2AMLogic/gf180-sram/README.md

# gf180-sram

An SRAM macro on the [gf180mcu](https://github.com/google/gf180mcu-pdk) open
PDK, built and verified by AI agents driving
[klayout-tools](https://github.com/2AMLogic/klayout-tools).

**Bronze (T1, simulation-validated) granted 2026-10-02** (operator ruling,
issue #126; record: [`spec/t1-grant-2026-10-02.md`](spec/t1-grant-2026-10-02.md)).
Basis: the 2026-08-22 10/10 hand read with every hole it disclosed since
closed (#103, #108, #109, #110), plus the passing item-11 power-delivery ERC
(#124). **Disclosed exception:** item 7's read/hold-SNM post-layout (PEX)
gap (`sim/pex/README.md`). The machine grader now reads 11/11, tier T1 (`signoff/`; issue #159
closed the item-11 tooling gap with `ties[]` and a compound ERC + LVS
citation under the released klt 0.6.0; items 1, 9 and 10 cite artifact-anchored
generic wrappers since the 0.8.0 re-grade, issue #277). Item 2 remains a
placeholder citation.

**Status: spec ratified; bitcell and 256 x 32 array are DRC-clean and
LVS-clean (`status: match` for both — see `layout/README.md`'s "Status
(2026-08-16)" section), and 27-corner PVT signoff has passed (read SNM +
hold SNM + write margin, all 27 corner points — see
`sim/signoff-summary.md`'s Overall signoff line). A generated LEF abstract
of the array core now exists (`views/sram_256x32_array.lef`, `klt
socket-check` clean on outline + all 322 pins) — see `views/README.md` for
its coverage and the two tool/design gaps it surfaced. Liberty timing views
have not been generated yet. The block's T1 checklist state is graded
mechanically — the `klt signoff` block manifest at
[`signoff/block-manifest.json`](signoff/block-manifest.json) is the verdict
of record, re-graded on every PR (see
[`signoff/README.md`](signoff/README.md)); the 2026-08-22 hand-read in
`spec/` is retained as a dated audit snapshot only.**

**Built agent-native.** Every specification, decision record, testbench, and
line of documentation here is produced by AI agents working from a ratified
spec and an append-only evidence trail — not human-authored work that agents
merely assisted with. Verification is the product: every claim traces to a
recorded result. Where the agents hit friction with the open-source tooling —
most often [klayout-tools](https://github.com/2AMLogic/klayout-tools) — that
friction is filed as a public issue against the tool itself, so the fix
benefits everyone using gf180mcu, not just this repo.

## Why this block, stated honestly

This is the first **memory macro** in the program. Every sibling canary is a
flat analog or digital block, so array generation, macro-level LVS, abstract
and Liberty view generation, and the bitcell-to-array hierarchy are all tool
surface that has never been exercised here.

That is the reason it exists, and it is worth being plain that this block is
**not** selected for demand. [OpenRAM](https://openram.org) already generates
free SRAM macros for sky130, and gf180mcu itself ships a free, foundry-
hardened SRAM macro (`gf180mcu_fd_ip_sram`) outside of OpenRAM — see
[`spec/bitcell-decision.md`](spec/bitcell-decision.md) for the evidence.
OpenRAM does not currently generate gf180mcu SRAM macros (its gf180mcu
support is experimental ROM generation only). This repo is not trying to
out-compete either of those; it is trying to find out what breaks when the
tools are pointed at a memory array, and to fix it.

Where OpenRAM's output is a useful reference or a useful comparison, use it
and say so. Do not reimplement it.

## Target specification

The target spec is ratified: [`spec/sram.md`](spec/sram.md). It fixes
organization (1 kB, 256 × 32, single instance — a parameterized generator is
a stretch goal), ports (1RW target, 1RW1R stretch), deliverables (GDS, LEF
abstract, Liberty timing — all generated by this repo's own flow), and what
"functional across PVT" means for this macro (read/write/hold margins,
recorded per corner, over a 27-corner process × temperature × voltage set).
The bitcell question behind it is resolved separately in
[`spec/bitcell-decision.md`](spec/bitcell-decision.md): gf180mcu's 6T
bitcell (`018SRAM_cell1`) exists only embedded inside four fixed-depth
foundry-hardened `gf180mcu_fd_ip_sram` macros, not as a standalone, tileable
primitive, so this repo draws a custom bitcell and array rather than
integrating that hardened macro.

Maturity ladder: bitcell question answered → spec ratified → bitcell
characterized → array assembled → DRC/LVS-clean → abstract and Liberty views
generated and checked → shuttle seat → measured silicon. **Current position:
spec ratified; bitcell characterized (27-corner PVT testbenches recorded
read SNM / hold SNM / write margin / access-time results across all 27
corners, with the per-corner pass/fail synthesis against `spec/sram.md`'s
positive-margin signoff requirement complete — overall verdict PASS, see
`sim/signoff-summary.md`); array assembled and DRC/LVS-clean (256 x 32
array, `status: match` LVS, see `layout/README.md`'s "Status (2026-08-16)"
section); LEF abstract generated for the array core (`views/README.md`'s
"Status (2026-09-09)" section — `klt socket-check` clean, a real `.lef`
committed, and two tool/design gaps filed from pointing `klt lef-abstract`
at a real block for the first time). Liberty timing views have not been
generated yet; shuttle seat and measured silicon remain future steps.**

## Macro ceiling, and where this block sits relative to it

gf180mcu's open PDK ships exactly **four** hardened SRAM macros
(`gf180mcu_fd_ip_sram`, see `spec/bitcell-decision.md`), all fixed-depth,
×8-bit only: `64×8`, `128×8`, `256×8`, and `512×8`. The largest single
instance is **`512×8` = 4,096 bits = 512 bytes = 0.5 KB** — that is the PDK's
own macro ceiling, measured directly from its shipped `LEF` (`SIZE` field),
not estimated.

**This repo is not a wrapper or tiler over those four macros, and it is not
a KB-scale replacement for them.** Per `spec/bitcell-decision.md` this repo
draws a **new, custom 6T bitcell and array** from scratch, and its ratified
target (`spec/sram.md`) is a single fixed 256 × 32 (1 kB) instance — built to
exercise array generation, macro-level LVS, and abstract/Liberty
*generation* tooling, not to serve as a general-purpose KB-scale IP product.
A parameterized generator that could grow past 1 kB is only a stretch goal,
not built yet.

An integrator who needs more than ~1 kB (an 8–32 KB MCU-class want, say) has
no path from this repo today. [`spec/kb-scale-integration.md`](spec/kb-scale-integration.md)
records the options that do exist in the wider gf180mcu ecosystem — tiling
the foundry `512×8` macros, DFFRAM (standard-cell RAM, gf180mcu target
configured but not yet signoff-clean), and OpenRAM (no gf180mcu SRAM support
at all) — with measured/derived area and timing figures, evidence tiers
labelled, and the bank-select/mux cost flagged as not yet modeled. It also
notes, in one sentence, that the open kit has no dense NVM macro (an
`efuse_cell` primitive only) — code storage for an MCU-class chip on this
kit is an architecture decision, not a part the PDK provides.

## Spec at a glance

The ratified source is [`spec/sram.md`](spec/sram.md); this table only
summarizes it.

| Item | Target |
|---|---|
| Organization | 1 kB, 256 words × 32 bits, single fixed instance (a parameterized generator is a stretch goal) |
| Ports | 1RW synchronous single port (1RW1R is a stretch goal); pin interface in `spec/macro-interface-decision.md` |
| Deliverables | GDS, LEF abstract, Liberty timing |
| Corner set | 27 corners: process `ff`/`tt`/`ss` × temperature -40/25/125 °C × supply 2.97/3.30/3.63 V |
| Measured per corner | read SNM, hold SNM, write margin, read/write access time |
| Signoff | DRC and LVS clean on the full array, and a recorded, strictly positive read SNM, hold SNM and write margin at all 27 corners |

## Reproducing every result

Each result class has one documented entry point. Prerequisites (ngspice, the
pinned PDK revision, a released `klt`) are stated in the linked section.

| Result | How to reproduce | Documented in |
|---|---|---|
| Schematics and netlists | `design/generate_array.py`, then `xschem` batch netlisting | [`design/README.md`](design/README.md) § "Regenerating the netlists" |
| PVT corner simulations | `sim/lib/run_corner_sweep.sh` per testbench | [`sim/README.md`](sim/README.md) § "Cold-start invocation" |
| Monte Carlo / yield | `sim/lib/run_mc_campaign.py` | [`sim/README.md`](sim/README.md) § "Running a campaign" |
| Layout, DRC, LVS, extraction | `./layout/verify.sh` (`--quick` for a subset) | [`layout/README.md`](layout/README.md) § "Reproducing and re-checking" |
| LEF abstract | `./views/verify.sh` | [`views/README.md`](views/README.md) § "Reproducing and re-checking" |
| Characterization report | `python3 measurements/generate_report.py > measurements/characterization-report.md` | [`measurements/README.md`](measurements/README.md) |
| Signoff tier verdict | `./signoff/regenerate.sh` | [`signoff/README.md`](signoff/README.md) |

## Repo layout

```
spec/          ratified spec + decision records
design/        bitcell and periphery schematics
sim/           testbenches + PVT corner results (ngspice)
layout/        GDS + DRC/LVS reports (klayout-tools driven)
views/         generated LEF / Liberty abstracts
measurements/  aggregated characterization report (schematic-level today;
               silicon measurements supersede it after tape-out)
signoff/       block manifest + committed `klt signoff` tier report — the
               graded gap-to-T1 verdict of record, with the vendored
               checklist definition and its pinning/regeneration docs
```

## License

Apache License 2.0 — see [LICENSE](LICENSE).
