2AMLogic/gf180-sram/sim/signoff-summary.md

# PVT signoff summary (derived, per-corner pass/fail)

Auto-generated by `sim/lib/render_signoff_table.py` -- do not hand-edit. Regenerate with:

```bash
python3 sim/lib/render_signoff_table.py > sim/signoff-summary.md
```

This document derives an explicit **per-corner, per-metric PASS/FAIL verdict** from the five append-only evidence records already committed under `sim/*/records/` (see `sim/README.md` for the record format and the append-only convention). It does not run any simulation and does not modify those records -- it is a read-only rollup, closing the one gap the 2026-08-17 curation pass on issue #25 identified: the source records report raw measured values plus a single aggregate `Overall: recorded` line, not a per-corner verdict against `spec/sram.md`'s Signoff definition.

## Source records

- Read SNM: `sim/read-snm/records/20260817-011523-4448966.md`
- Hold SNM: `sim/hold-snm/records/20260817-011558-4448966.md`
- Write margin: `sim/write-margin/records/20260817-105029-ce56f59.md` (margin is `write_trip_voltage_v` (WTV) directly -- the minimum write-driver drive that still flips the cell)
- Read access time: `sim/access-time/records/20260817-011948-4448966.md`
- Write access time: `sim/access-time/records/20260817-012005-4448966.md`

## Verdict rule (`spec/sram.md`, "### Signoff definition")

- Read SNM, hold SNM, write margin: **PASS** iff the recorded value is strictly `> 0` V; **FAIL** otherwise; **OPEN** if the source record has no valid measurement for that corner (see `sim/README.md` "Append-only rule").
- Read/write access time: `spec/sram.md` only requires these be **recorded**, not compared against a numeric threshold, so a corner with a valid measured value is marked **RECORDED**, not PASS/FAIL.

**Note on corner count**: the table below has 27 rows, one per distinct `process x temperature x voltage` combination actually swept by `sim/lib/run_corner_sweep.sh` (`3 x 3 x 3 = 27`), matching every one of the five source records above (each has exactly this many `- **<corner-id>**:` rows) and `spec/sram.md`'s "Corner set" section. That section computed the same product as "9 corners" until #53 corrected the arithmetic (3 x 3 x 3 = 27, not 9) -- see `spec/corner-count-correction.md`; the corner set, the Signoff definition, and every verdict below are unchanged by that correction. Records written before it still say "9 corner points" in their own generated prose while listing all 27 rows, because records are never edited after the fact (`sim/README.md`, "Append-only rule").

## Per-corner results

| Corner | Read SNM (V) | Verdict | Hold SNM (V) | Verdict | Write margin (V) | Verdict | Read access time (s) | Verdict | Write access time (s) | Verdict | Row overall (SNM + margin) |
|---|---|---|---|---|---|---|---|---|---|---|---|
| ff_-40c_2.97v | 0.346745 | PASS | 0.999014 | PASS | 1.695460 | PASS | 1.4094e-10 | RECORDED | 4.7116e-11 | RECORDED | PASS |
| ff_-40c_3.30v | 0.348079 | PASS | 1.075028 | PASS | 1.891500 | PASS | 1.1791e-10 | RECORDED | 4.4605e-11 | RECORDED | PASS |
| ff_-40c_3.63v | 0.378868 | PASS | 1.150509 | PASS | 2.087960 | PASS | 1.0357e-10 | RECORDED | 4.2459e-11 | RECORDED | PASS |
| ff_25c_2.97v | 0.279259 | PASS | 0.972353 | PASS | 1.672980 | PASS | 1.4785e-10 | RECORDED | 5.0519e-11 | RECORDED | PASS |
| ff_25c_3.30v | 0.291040 | PASS | 1.048587 | PASS | 1.870750 | PASS | 1.2610e-10 | RECORDED | 4.7849e-11 | RECORDED | PASS |
| ff_25c_3.63v | 0.322552 | PASS | 1.124406 | PASS | 2.068910 | PASS | 1.1195e-10 | RECORDED | 4.5613e-11 | RECORDED | PASS |
| ff_125c_2.97v | 0.214599 | PASS | 0.930461 | PASS | 1.640530 | PASS | 1.5703e-10 | RECORDED | 5.7246e-11 | RECORDED | PASS |
| ff_125c_3.30v | 0.237829 | PASS | 1.008552 | PASS | 1.838120 | PASS | 1.3761e-10 | RECORDED | 5.3928e-11 | RECORDED | PASS |
| ff_125c_3.63v | 0.265005 | PASS | 1.087062 | PASS | 2.036110 | PASS | 1.2389e-10 | RECORDED | 5.1521e-11 | RECORDED | PASS |
| tt_-40c_2.97v | 0.443117 | PASS | 1.055088 | PASS | 1.738240 | PASS | 2.0899e-10 | RECORDED | 5.5771e-11 | RECORDED | PASS |
| tt_-40c_3.30v | 0.450044 | PASS | 1.134683 | PASS | 1.935810 | PASS | 1.6117e-10 | RECORDED | 5.2198e-11 | RECORDED | PASS |
| tt_-40c_3.63v | 0.458020 | PASS | 1.213568 | PASS | 2.132710 | PASS | 1.3429e-10 | RECORDED | 4.9423e-11 | RECORDED | PASS |
| tt_25c_2.97v | 0.377941 | PASS | 1.031028 | PASS | 1.711050 | PASS | 2.1229e-10 | RECORDED | 6.0738e-11 | RECORDED | PASS |
| tt_25c_3.30v | 0.381267 | PASS | 1.110807 | PASS | 1.910030 | PASS | 1.7014e-10 | RECORDED | 5.6764e-11 | RECORDED | PASS |
| tt_25c_3.63v | 0.385058 | PASS | 1.189934 | PASS | 2.109230 | PASS | 1.4485e-10 | RECORDED | 5.3568e-11 | RECORDED | PASS |
| tt_125c_2.97v | 0.295443 | PASS | 0.993408 | PASS | 1.677510 | PASS | 2.1819e-10 | RECORDED | 6.9354e-11 | RECORDED | PASS |
| tt_125c_3.30v | 0.296711 | PASS | 1.074566 | PASS | 1.877400 | PASS | 1.8293e-10 | RECORDED | 6.4782e-11 | RECORDED | PASS |
| tt_125c_3.63v | 0.318427 | PASS | 1.155746 | PASS | 2.077770 | PASS | 1.5948e-10 | RECORDED | 6.1280e-11 | RECORDED | PASS |
| ss_-40c_2.97v | 0.540536 | PASS | 1.105024 | PASS | 1.769780 | PASS | 3.5718e-10 | RECORDED | 6.7146e-11 | RECORDED | PASS |
| ss_-40c_3.30v | 0.550840 | PASS | 1.187215 | PASS | 1.972470 | PASS | 2.4039e-10 | RECORDED | 6.2505e-11 | RECORDED | PASS |
| ss_-40c_3.63v | 0.563750 | PASS | 1.268808 | PASS | 2.172590 | PASS | 1.8532e-10 | RECORDED | 5.8880e-11 | RECORDED | PASS |
| ss_25c_2.97v | 0.475538 | PASS | 1.082379 | PASS | 1.742410 | PASS | 3.3581e-10 | RECORDED | 7.3637e-11 | RECORDED | PASS |
| ss_25c_3.30v | 0.483481 | PASS | 1.165266 | PASS | 1.943660 | PASS | 2.4585e-10 | RECORDED | 6.8305e-11 | RECORDED | PASS |
| ss_25c_3.63v | 0.493503 | PASS | 1.247287 | PASS | 2.144230 | PASS | 1.9717e-10 | RECORDED | 6.4215e-11 | RECORDED | PASS |
| ss_125c_2.97v | 0.394239 | PASS | 1.048438 | PASS | 1.706340 | PASS | 3.2326e-10 | RECORDED | 8.4931e-11 | RECORDED | PASS |
| ss_125c_3.30v | 0.400760 | PASS | 1.132542 | PASS | 1.908220 | PASS | 2.5525e-10 | RECORDED | 7.8579e-11 | RECORDED | PASS |
| ss_125c_3.63v | 0.408620 | PASS | 1.216449 | PASS | 2.109670 | PASS | 2.1346e-10 | RECORDED | 7.3752e-11 | RECORDED | PASS |

## Aggregate

- Read SNM: 27/27 PASS (min 0.214599 V)
- Hold SNM: 27/27 PASS (min 0.930461 V)
- Write margin: 27/27 PASS (min 1.640530 V)
- Read access time: 27/27 RECORDED
- Write access time: 27/27 RECORDED

**Overall signoff (read SNM + hold SNM + write margin, all 27 corner points, per `spec/sram.md`'s Signoff definition): PASS.**

Footnote on write-margin resolution: issue #47 (WTV recorded at the first *failing* sweep step rather than the last *succeeding* one) was fixed in #54 and closed; the write-margin record cited above is a post-fix re-run, so that off-by-one does not apply to any number in this table. What remains is the search's inherent resolution: `tb_write_margin.spice` sweeps the trip voltage on a `VDD/40` grid (~0.074 V at 2.97 V, ~0.091 V at 3.63 V), so the true trip point lies within one step above each recorded WTV and every write margin above is optimistic by at most one step. That bound is ~17x smaller than the smallest margin in the table, so no corner's PASS verdict turns on it.
