2AMLogic/gf180-sram/sim/bitcell-leakage/records/20261106-181600-e891f1c.md

# Record 20261106-181600-e891f1c

- **Record ID**: 20261106-181600-e891f1c
- **Claim**: standby (hold-state, WL=0, BL=BLB=VDD, Q=1) VDD-rail leakage of one `bitcell_6t` is finite and positive at every corner of the ratified 27-point set (issue #310). This fills the recorded-but-unmeasured "Power (leakage)" row of `spec/sram.md` with a first measurement. **No threshold or target is proposed**; no spec row, Signoff definition or decision record is changed.
- **Netlist provenance**: schematic (`sim/bitcell-leakage/testbench/tb_bitcell_leakage.klt.spice` via `sim/bitcell-leakage/requests/bitcell_leakage.json`; DUT `design/netlist/bitcell_6t.spice` at `e891f1c`, `.include`d flat)
- **Corner matrix run**:
  - Process: ff tt ss
  - Temperature: -40 25 125 C
  - Supply: 2.97 3.30 3.63 V
  - (27 corner points total; `klt sim` status `pass`, 27 passed / 0 failed / 0 errored; DC `.op`, `analysis.kind: "op"` with `measurements[].expr`)
- **Statistical convention**: N/A (nominal devices, no Monte Carlo; mismatch is out of scope, see `spec/statistical-treatment-decision.md`)
- **Result**: measurement `i_leak_vdd = -I(VVDD)`, per cell, with the arithmetic array-core lower bound x8192 bits. **The x8192 figure is array-core only: no periphery, no wordline drivers, no sense/write circuitry, and it is NOT the macro's leakage.**
  - **ff_-40c_2.97v**: 8.94 pA per cell; x8192 core-only = 73.276 nA (Q=2.970 V)
  - **ff_25c_2.97v**: 15.67 pA per cell; x8192 core-only = 128.401 nA (Q=2.970 V)
  - **ff_125c_2.97v**: 984.66 pA per cell; x8192 core-only = 8066.318 nA (Q=2.970 V)
  - **ff_-40c_3.30v**: 9.97 pA per cell; x8192 core-only = 81.645 nA (Q=3.300 V)
  - **ff_25c_3.30v**: 19.18 pA per cell; x8192 core-only = 157.118 nA (Q=3.300 V)
  - **ff_125c_3.30v**: 1251.27 pA per cell; x8192 core-only = 10250.379 nA (Q=3.300 V)
  - **ff_-40c_3.63v**: 11.02 pA per cell; x8192 core-only = 90.311 nA (Q=3.630 V)
  - **ff_25c_3.63v**: 23.82 pA per cell; x8192 core-only = 195.120 nA (Q=3.630 V)
  - **ff_125c_3.63v**: 1620.64 pA per cell; x8192 core-only = 13276.316 nA (Q=3.630 V)
  - **tt_-40c_2.97v**: 8.91 pA per cell; x8192 core-only = 73.030 nA (Q=2.970 V)
  - **tt_25c_2.97v**: 9.25 pA per cell; x8192 core-only = 75.767 nA (Q=2.970 V)
  - **tt_125c_2.97v**: 105.47 pA per cell; x8192 core-only = 864.007 nA (Q=2.970 V)
  - **tt_-40c_3.30v**: 9.91 pA per cell; x8192 core-only = 81.222 nA (Q=3.300 V)
  - **tt_25c_3.30v**: 10.36 pA per cell; x8192 core-only = 84.860 nA (Q=3.300 V)
  - **tt_125c_3.30v**: 130.62 pA per cell; x8192 core-only = 1070.038 nA (Q=3.300 V)
  - **tt_-40c_3.63v**: 10.93 pA per cell; x8192 core-only = 89.559 nA (Q=3.630 V)
  - **tt_25c_3.63v**: 11.53 pA per cell; x8192 core-only = 94.453 nA (Q=3.630 V)
  - **tt_125c_3.63v**: 162.82 pA per cell; x8192 core-only = 1333.853 nA (Q=3.630 V)
  - **ss_-40c_2.97v**: 8.91 pA per cell; x8192 core-only = 73.006 nA (Q=2.970 V)
  - **ss_25c_2.97v**: 8.93 pA per cell; x8192 core-only = 73.162 nA (Q=2.970 V)
  - **ss_125c_2.97v**: 19.34 pA per cell; x8192 core-only = 158.464 nA (Q=2.970 V)
  - **ss_-40c_3.30v**: 9.91 pA per cell; x8192 core-only = 81.161 nA (Q=3.300 V)
  - **ss_25c_3.30v**: 9.93 pA per cell; x8192 core-only = 81.362 nA (Q=3.300 V)
  - **ss_125c_3.30v**: 22.67 pA per cell; x8192 core-only = 185.741 nA (Q=3.300 V)
  - **ss_-40c_3.63v**: 10.91 pA per cell; x8192 core-only = 89.405 nA (Q=3.630 V)
  - **ss_25c_3.63v**: 10.95 pA per cell; x8192 core-only = 89.665 nA (Q=3.630 V)
  - **ss_125c_3.63v**: 26.62 pA per cell; x8192 core-only = 218.054 nA (Q=3.630 V)
  - **Spread**: smallest ss_-40c_2.97v (8.91 pA), largest ff_125c_3.63v (1.62 nA). The expected ordering holds (ff/125 C/3.63 V largest, ss/-40 C/2.97 V smallest); no value is zero or negative.
  - **Why one stored state suffices**: `bitcell_6t.spice` sizes MPL=MPR, MNL=MNR, MAL=MAR identically, so the cell is symmetric by design and Q=0 is the mirror of Q=1. Not run; mismatch is a separate treatment.
- **Limits (what this does NOT show)**:
  - **Cold-corner values are at or near the simulator's numerical floor.** At every -40 C corner, and at ss/tt 25 C, the value is ~8.9-11.5 pA and scales ~linearly with VDD (8.9 pA at 2.97 V, 9.9 pA at 3.30 V, 10.9 pA at 3.63 V). That is the signature of ngspice's `gmin` (default 1e-12 S) shunts, not of device leakage. Treat these as **upper-bounded by the floor, not as measured leakage**. The hot corners (ff 125 C, tt 125 C, ss 125 C) and ff 25 C are clearly above the floor. The `gmin`-independent confirmation (a `.options gmin=1e-15` rerun) is not done here and is the natural follow-up.
  - Only the cell's VDD rail current is measured. The bit lines and WL are driven by separate ideal sources, so access-transistor (bit-line) leakage into the cell and bit-line sources is **not** in this figure.
  - Single cell, nominal devices, no layout parasitics, no periphery; schematic-level, DC `.op`; state selected by `.nodeset` (checked via `v_q`: Q settled at VDD at every corner).
  - **PDK pin not verified on the worker.** The request names the pinned lib (`sim/lib/pdk_pin.txt` = `f6eeac7`, `gf180mcuD`), but the batch report says `pdk root or variant unknown on worker` (`pdk_stamp_comparison: not_comparable`, worker `/opt/pdk`). Whether the worker ran the pinned model revision is therefore not established by this record.
  - The batch run did not return per-corner `.log` files for this job, so only the structured `klt-sim-report.json` is committed.
- **Links**:
  - Request: `sim/bitcell-leakage/requests/bitcell_leakage.json`
  - Testbench body: `sim/bitcell-leakage/testbench/tb_bitcell_leakage.klt.spice`
  - Netlist snapshot: `sim/bitcell-leakage/netlist-snapshots/20261106-181600-e891f1c.spice`
  - Full `klt sim` report: `sim/bitcell-leakage/corners/20261106-181600-e891f1c/klt-sim-report.json`
  - Batch job (`environment.remote`): klt-sim-b00b415064eb (one job, 27 corners, ~9 s on a spot c7i.8xlarge)
  - Re-run: `PDK_ROOT=<pdk root> klt sim sim/bitcell-leakage/requests/bitcell_leakage.json -o <dir> --format json`
  - An earlier submit (klt-sim-74519d991f43) failed on all 27 corners with `unknown subckt` (the flat netlist has no `.subckt`); fixed in the testbench and rerun. Its output is not committed.
- **Timestamp / author**: 2026-11-06T18:17:37Z, agent-builder
- **Supersedes**: (none)
