2AMLogic/gf180-sram/sim/access-time/records/20260817-011948-4448966.md

# Record 20260817-011948-4448966

- **Record ID**: 20260817-011948-4448966
- **Claim**: spec/sram.md Characterization -- read access time (bit-line differential proxy)
- **Netlist provenance**: schematic (`sim/access-time/testbench/tb_read_access_time.spice`, DUT per `design/netlist/bitcell_6t.spice` at `4448966`)
- **Corner matrix run**:
  - Process: ff tt ss
  - Temperature: -40 25 125 C
  - Supply: 2.97 3.30 3.63 V
  - (9 corner points total -- full process x temp x supply matrix, per spec/sram.md's ratified corner set)
- **Statistical convention**: N/A (corner-matrix claim, not a distribution claim)
- **Result**:
  - **ff_-40c_2.97v**: RESULT: read_access_time_s = 1.40945E-10;
  - **ff_-40c_3.30v**: RESULT: read_access_time_s = 1.17907E-10;
  - **ff_-40c_3.63v**: RESULT: read_access_time_s = 1.03569E-10;
  - **ff_25c_2.97v**: RESULT: read_access_time_s = 1.47853E-10;
  - **ff_25c_3.30v**: RESULT: read_access_time_s = 1.26101E-10;
  - **ff_25c_3.63v**: RESULT: read_access_time_s = 1.11953E-10;
  - **ff_125c_2.97v**: RESULT: read_access_time_s = 1.5703E-10;
  - **ff_125c_3.30v**: RESULT: read_access_time_s = 1.37607E-10;
  - **ff_125c_3.63v**: RESULT: read_access_time_s = 1.23889E-10;
  - **tt_-40c_2.97v**: RESULT: read_access_time_s = 2.08985E-10;
  - **tt_-40c_3.30v**: RESULT: read_access_time_s = 1.61165E-10;
  - **tt_-40c_3.63v**: RESULT: read_access_time_s = 1.34291E-10;
  - **tt_25c_2.97v**: RESULT: read_access_time_s = 2.12295E-10;
  - **tt_25c_3.30v**: RESULT: read_access_time_s = 1.70142E-10;
  - **tt_25c_3.63v**: RESULT: read_access_time_s = 1.44853E-10;
  - **tt_125c_2.97v**: RESULT: read_access_time_s = 2.18195E-10;
  - **tt_125c_3.30v**: RESULT: read_access_time_s = 1.82935E-10;
  - **tt_125c_3.63v**: RESULT: read_access_time_s = 1.59475E-10;
  - **ss_-40c_2.97v**: RESULT: read_access_time_s = 3.57176E-10;
  - **ss_-40c_3.30v**: RESULT: read_access_time_s = 2.40389E-10;
  - **ss_-40c_3.63v**: RESULT: read_access_time_s = 1.85324E-10;
  - **ss_25c_2.97v**: RESULT: read_access_time_s = 3.35812E-10;
  - **ss_25c_3.30v**: RESULT: read_access_time_s = 2.45853E-10;
  - **ss_25c_3.63v**: RESULT: read_access_time_s = 1.97169E-10;
  - **ss_125c_2.97v**: RESULT: read_access_time_s = 3.2326E-10;
  - **ss_125c_3.30v**: RESULT: read_access_time_s = 2.55254E-10;
  - **ss_125c_3.63v**: RESULT: read_access_time_s = 2.13463E-10;
  - **Overall: recorded** -- all 9 corners produced a measured result; see sim/README.md for how to interpret sign-off against spec/sram.md's positive-margin requirement.
- **Links**:
  - Testbench: `sim/access-time/testbench/tb_read_access_time.spice`
  - Netlist snapshot: `sim/access-time/netlist-snapshots/20260817-011948-4448966.spice`
  - Raw logs: `sim/access-time/corners/20260817-011948-4448966/`
- **Timestamp / author**: 2026-08-17T01:20:00Z, agent-builder
- **Supersedes**: (none -- first record for this claim)
