2AMLogic/gf180-sram/sim/access-time/records/20260817-012005-4448966.md

# Record 20260817-012005-4448966

- **Record ID**: 20260817-012005-4448966
- **Claim**: spec/sram.md Characterization -- write access time
- **Netlist provenance**: schematic (`sim/access-time/testbench/tb_write_access_time.spice`, DUT per `design/netlist/bitcell_6t.spice` at `4448966`)
- **Corner matrix run**:
  - Process: ff tt ss
  - Temperature: -40 25 125 C
  - Supply: 2.97 3.30 3.63 V
  - (9 corner points total -- full process x temp x supply matrix, per spec/sram.md's ratified corner set)
- **Statistical convention**: N/A (corner-matrix claim, not a distribution claim)
- **Result**:
  - **ff_-40c_2.97v**: RESULT: write_access_time_s = 4.7116E-11;
  - **ff_-40c_3.30v**: RESULT: write_access_time_s = 4.46049E-11;
  - **ff_-40c_3.63v**: RESULT: write_access_time_s = 4.24594E-11;
  - **ff_25c_2.97v**: RESULT: write_access_time_s = 5.05193E-11;
  - **ff_25c_3.30v**: RESULT: write_access_time_s = 4.78495E-11;
  - **ff_25c_3.63v**: RESULT: write_access_time_s = 4.56126E-11;
  - **ff_125c_2.97v**: RESULT: write_access_time_s = 5.72457E-11;
  - **ff_125c_3.30v**: RESULT: write_access_time_s = 5.39284E-11;
  - **ff_125c_3.63v**: RESULT: write_access_time_s = 5.15212E-11;
  - **tt_-40c_2.97v**: RESULT: write_access_time_s = 5.57706E-11;
  - **tt_-40c_3.30v**: RESULT: write_access_time_s = 5.21982E-11;
  - **tt_-40c_3.63v**: RESULT: write_access_time_s = 4.94228E-11;
  - **tt_25c_2.97v**: RESULT: write_access_time_s = 6.07379E-11;
  - **tt_25c_3.30v**: RESULT: write_access_time_s = 5.67636E-11;
  - **tt_25c_3.63v**: RESULT: write_access_time_s = 5.35678E-11;
  - **tt_125c_2.97v**: RESULT: write_access_time_s = 6.93536E-11;
  - **tt_125c_3.30v**: RESULT: write_access_time_s = 6.47822E-11;
  - **tt_125c_3.63v**: RESULT: write_access_time_s = 6.12799E-11;
  - **ss_-40c_2.97v**: RESULT: write_access_time_s = 6.71457E-11;
  - **ss_-40c_3.30v**: RESULT: write_access_time_s = 6.25045E-11;
  - **ss_-40c_3.63v**: RESULT: write_access_time_s = 5.88804E-11;
  - **ss_25c_2.97v**: RESULT: write_access_time_s = 7.36367E-11;
  - **ss_25c_3.30v**: RESULT: write_access_time_s = 6.83046E-11;
  - **ss_25c_3.63v**: RESULT: write_access_time_s = 6.42155E-11;
  - **ss_125c_2.97v**: RESULT: write_access_time_s = 8.49307E-11;
  - **ss_125c_3.30v**: RESULT: write_access_time_s = 7.8579E-11;
  - **ss_125c_3.63v**: RESULT: write_access_time_s = 7.37515E-11;
  - **Overall: recorded** -- all 9 corners produced a measured result; see sim/README.md for how to interpret sign-off against spec/sram.md's positive-margin requirement.
- **Links**:
  - Testbench: `sim/access-time/testbench/tb_write_access_time.spice`
  - Netlist snapshot: `sim/access-time/netlist-snapshots/20260817-012005-4448966.spice`
  - Raw logs: `sim/access-time/corners/20260817-012005-4448966/`
- **Timestamp / author**: 2026-08-17T01:20:17Z, agent-builder
- **Supersedes**: (none -- first record for this claim)
