2AMLogic/gf180-sram/sim/hold-snm/records/20260817-011558-4448966.md

# Record 20260817-011558-4448966

- **Record ID**: 20260817-011558-4448966
- **Claim**: spec/sram.md Characterization -- hold SNM
- **Netlist provenance**: schematic (`sim/hold-snm/testbench/tb_hold_snm.spice`, DUT per `design/netlist/bitcell_6t.spice` at `4448966`)
- **Corner matrix run**:
  - Process: ff tt ss
  - Temperature: -40 25 125 C
  - Supply: 2.97 3.30 3.63 V
  - (9 corner points total -- full process x temp x supply matrix, per spec/sram.md's ratified corner set)
- **Statistical convention**: N/A (corner-matrix claim, not a distribution claim)
- **Result**:
  - **ff_-40c_2.97v**: RESULT: hold_snm_lobe_low_v = 1.835613;RESULT: hold_snm_lobe_high_v = 0.999014;RESULT: hold_snm_v = 0.999014;
  - **ff_-40c_3.30v**: RESULT: hold_snm_lobe_low_v = 2.047586;RESULT: hold_snm_lobe_high_v = 1.075028;RESULT: hold_snm_v = 1.075028;
  - **ff_-40c_3.63v**: RESULT: hold_snm_lobe_low_v = 2.253773;RESULT: hold_snm_lobe_high_v = 1.150509;RESULT: hold_snm_v = 1.150509;
  - **ff_25c_2.97v**: RESULT: hold_snm_lobe_low_v = 1.828985;RESULT: hold_snm_lobe_high_v = 0.972353;RESULT: hold_snm_v = 0.972353;
  - **ff_25c_3.30v**: RESULT: hold_snm_lobe_low_v = 2.031634;RESULT: hold_snm_lobe_high_v = 1.048587;RESULT: hold_snm_v = 1.048587;
  - **ff_25c_3.63v**: RESULT: hold_snm_lobe_low_v = 2.227106;RESULT: hold_snm_lobe_high_v = 1.124406;RESULT: hold_snm_v = 1.124406;
  - **ff_125c_2.97v**: RESULT: hold_snm_lobe_low_v = 1.792025;RESULT: hold_snm_lobe_high_v = 0.930461;RESULT: hold_snm_v = 0.930461;
  - **ff_125c_3.30v**: RESULT: hold_snm_lobe_low_v = 1.977898;RESULT: hold_snm_lobe_high_v = 1.008552;RESULT: hold_snm_v = 1.008552;
  - **ff_125c_3.63v**: RESULT: hold_snm_lobe_low_v = 2.157022;RESULT: hold_snm_lobe_high_v = 1.087062;RESULT: hold_snm_v = 1.087062;
  - **tt_-40c_2.97v**: RESULT: hold_snm_lobe_low_v = 1.818979;RESULT: hold_snm_lobe_high_v = 1.055088;RESULT: hold_snm_v = 1.055088;
  - **tt_-40c_3.30v**: RESULT: hold_snm_lobe_low_v = 2.037615;RESULT: hold_snm_lobe_high_v = 1.134683;RESULT: hold_snm_v = 1.134683;
  - **tt_-40c_3.63v**: RESULT: hold_snm_lobe_low_v = 2.252356;RESULT: hold_snm_lobe_high_v = 1.213568;RESULT: hold_snm_v = 1.213568;
  - **tt_25c_2.97v**: RESULT: hold_snm_lobe_low_v = 1.822534;RESULT: hold_snm_lobe_high_v = 1.031028;RESULT: hold_snm_v = 1.031028;
  - **tt_25c_3.30v**: RESULT: hold_snm_lobe_low_v = 2.035532;RESULT: hold_snm_lobe_high_v = 1.110807;RESULT: hold_snm_v = 1.110807;
  - **tt_25c_3.63v**: RESULT: hold_snm_lobe_low_v = 2.243110;RESULT: hold_snm_lobe_high_v = 1.189934;RESULT: hold_snm_v = 1.189934;
  - **tt_125c_2.97v**: RESULT: hold_snm_lobe_low_v = 1.811042;RESULT: hold_snm_lobe_high_v = 0.993408;RESULT: hold_snm_v = 0.993408;
  - **tt_125c_3.30v**: RESULT: hold_snm_lobe_low_v = 2.009862;RESULT: hold_snm_lobe_high_v = 1.074566;RESULT: hold_snm_v = 1.074566;
  - **tt_125c_3.63v**: RESULT: hold_snm_lobe_low_v = 2.201823;RESULT: hold_snm_lobe_high_v = 1.155746;RESULT: hold_snm_v = 1.155746;
  - **ss_-40c_2.97v**: RESULT: hold_snm_lobe_low_v = 1.796057;RESULT: hold_snm_lobe_high_v = 1.105024;RESULT: hold_snm_v = 1.105024;
  - **ss_-40c_3.30v**: RESULT: hold_snm_lobe_low_v = 2.018994;RESULT: hold_snm_lobe_high_v = 1.187215;RESULT: hold_snm_v = 1.187215;
  - **ss_-40c_3.63v**: RESULT: hold_snm_lobe_low_v = 2.238914;RESULT: hold_snm_lobe_high_v = 1.268808;RESULT: hold_snm_v = 1.268808;
  - **ss_25c_2.97v**: RESULT: hold_snm_lobe_low_v = 1.804454;RESULT: hold_snm_lobe_high_v = 1.082379;RESULT: hold_snm_v = 1.082379;
  - **ss_25c_3.30v**: RESULT: hold_snm_lobe_low_v = 2.023401;RESULT: hold_snm_lobe_high_v = 1.165266;RESULT: hold_snm_v = 1.165266;
  - **ss_25c_3.63v**: RESULT: hold_snm_lobe_low_v = 2.238957;RESULT: hold_snm_lobe_high_v = 1.247287;RESULT: hold_snm_v = 1.247287;
  - **ss_125c_2.97v**: RESULT: hold_snm_lobe_low_v = 1.807864;RESULT: hold_snm_lobe_high_v = 1.048438;RESULT: hold_snm_v = 1.048438;
  - **ss_125c_3.30v**: RESULT: hold_snm_lobe_low_v = 2.017041;RESULT: hold_snm_lobe_high_v = 1.132542;RESULT: hold_snm_v = 1.132542;
  - **ss_125c_3.63v**: RESULT: hold_snm_lobe_low_v = 2.220851;RESULT: hold_snm_lobe_high_v = 1.216449;RESULT: hold_snm_v = 1.216449;
  - **Overall: recorded** -- all 9 corners produced a measured result; see sim/README.md for how to interpret sign-off against spec/sram.md's positive-margin requirement.
- **Links**:
  - Testbench: `sim/hold-snm/testbench/tb_hold_snm.spice`
  - Netlist snapshot: `sim/hold-snm/netlist-snapshots/20260817-011558-4448966.spice`
  - Raw logs: `sim/hold-snm/corners/20260817-011558-4448966/`
- **Timestamp / author**: 2026-08-17T01:16:20Z, agent-builder
- **Supersedes**: (none -- first record for this claim)
