2AMLogic/gf180-sram/sim/read-snm/records/20260817-011523-4448966.md

# Record 20260817-011523-4448966

- **Record ID**: 20260817-011523-4448966
- **Claim**: spec/sram.md Characterization -- read SNM
- **Netlist provenance**: schematic (`sim/read-snm/testbench/tb_read_snm.spice`, DUT per `design/netlist/bitcell_6t.spice` at `4448966`)
- **Corner matrix run**:
  - Process: ff tt ss
  - Temperature: -40 25 125 C
  - Supply: 2.97 3.30 3.63 V
  - (9 corner points total -- full process x temp x supply matrix, per spec/sram.md's ratified corner set)
- **Statistical convention**: N/A (corner-matrix claim, not a distribution claim)
- **Result**:
  - **ff_-40c_2.97v**: RESULT: read_snm_lobe_low_v = 0.781993;RESULT: read_snm_lobe_high_v = 0.346745;RESULT: read_snm_v = 0.346745;
  - **ff_-40c_3.30v**: RESULT: read_snm_lobe_low_v = 0.787550;RESULT: read_snm_lobe_high_v = 0.348079;RESULT: read_snm_v = 0.348079;
  - **ff_-40c_3.63v**: RESULT: read_snm_lobe_low_v = 0.784559;RESULT: read_snm_lobe_high_v = 0.378868;RESULT: read_snm_v = 0.378868;
  - **ff_25c_2.97v**: RESULT: read_snm_lobe_low_v = 0.660028;RESULT: read_snm_lobe_high_v = 0.279259;RESULT: read_snm_v = 0.279259;
  - **ff_25c_3.30v**: RESULT: read_snm_lobe_low_v = 0.652703;RESULT: read_snm_lobe_high_v = 0.291040;RESULT: read_snm_v = 0.291040;
  - **ff_25c_3.63v**: RESULT: read_snm_lobe_low_v = 0.640587;RESULT: read_snm_lobe_high_v = 0.322552;RESULT: read_snm_v = 0.322552;
  - **ff_125c_2.97v**: RESULT: read_snm_lobe_low_v = 0.472848;RESULT: read_snm_lobe_high_v = 0.214599;RESULT: read_snm_v = 0.214599;
  - **ff_125c_3.30v**: RESULT: read_snm_lobe_low_v = 0.455824;RESULT: read_snm_lobe_high_v = 0.237829;RESULT: read_snm_v = 0.237829;
  - **ff_125c_3.63v**: RESULT: read_snm_lobe_low_v = 0.440354;RESULT: read_snm_lobe_high_v = 0.265005;RESULT: read_snm_v = 0.265005;
  - **tt_-40c_2.97v**: RESULT: read_snm_lobe_low_v = 0.934968;RESULT: read_snm_lobe_high_v = 0.443117;RESULT: read_snm_v = 0.443117;
  - **tt_-40c_3.30v**: RESULT: read_snm_lobe_low_v = 0.965074;RESULT: read_snm_lobe_high_v = 0.450044;RESULT: read_snm_v = 0.450044;
  - **tt_-40c_3.63v**: RESULT: read_snm_lobe_low_v = 0.984568;RESULT: read_snm_lobe_high_v = 0.458020;RESULT: read_snm_v = 0.458020;
  - **tt_25c_2.97v**: RESULT: read_snm_lobe_low_v = 0.842689;RESULT: read_snm_lobe_high_v = 0.377941;RESULT: read_snm_v = 0.377941;
  - **tt_25c_3.30v**: RESULT: read_snm_lobe_low_v = 0.857685;RESULT: read_snm_lobe_high_v = 0.381267;RESULT: read_snm_v = 0.381267;
  - **tt_25c_3.63v**: RESULT: read_snm_lobe_low_v = 0.865131;RESULT: read_snm_lobe_high_v = 0.385058;RESULT: read_snm_v = 0.385058;
  - **tt_125c_2.97v**: RESULT: read_snm_lobe_low_v = 0.692016;RESULT: read_snm_lobe_high_v = 0.295443;RESULT: read_snm_v = 0.295443;
  - **tt_125c_3.30v**: RESULT: read_snm_lobe_low_v = 0.692196;RESULT: read_snm_lobe_high_v = 0.296711;RESULT: read_snm_v = 0.296711;
  - **tt_125c_3.63v**: RESULT: read_snm_lobe_low_v = 0.690133;RESULT: read_snm_lobe_high_v = 0.318427;RESULT: read_snm_v = 0.318427;
  - **ss_-40c_2.97v**: RESULT: read_snm_lobe_low_v = 1.052778;RESULT: read_snm_lobe_high_v = 0.540536;RESULT: read_snm_v = 0.540536;
  - **ss_-40c_3.30v**: RESULT: read_snm_lobe_low_v = 1.103049;RESULT: read_snm_lobe_high_v = 0.550840;RESULT: read_snm_v = 0.550840;
  - **ss_-40c_3.63v**: RESULT: read_snm_lobe_low_v = 1.144814;RESULT: read_snm_lobe_high_v = 0.563750;RESULT: read_snm_v = 0.563750;
  - **ss_25c_2.97v**: RESULT: read_snm_lobe_low_v = 0.984053;RESULT: read_snm_lobe_high_v = 0.475538;RESULT: read_snm_v = 0.475538;
  - **ss_25c_3.30v**: RESULT: read_snm_lobe_low_v = 1.021938;RESULT: read_snm_lobe_high_v = 0.483481;RESULT: read_snm_v = 0.483481;
  - **ss_25c_3.63v**: RESULT: read_snm_lobe_low_v = 1.051086;RESULT: read_snm_lobe_high_v = 0.493503;RESULT: read_snm_v = 0.493503;
  - **ss_125c_2.97v**: RESULT: read_snm_lobe_low_v = 0.870873;RESULT: read_snm_lobe_high_v = 0.394239;RESULT: read_snm_v = 0.394239;
  - **ss_125c_3.30v**: RESULT: read_snm_lobe_low_v = 0.891352;RESULT: read_snm_lobe_high_v = 0.400760;RESULT: read_snm_v = 0.400760;
  - **ss_125c_3.63v**: RESULT: read_snm_lobe_low_v = 0.906729;RESULT: read_snm_lobe_high_v = 0.408620;RESULT: read_snm_v = 0.408620;
  - **Overall: recorded** -- all 9 corners produced a measured result; see sim/README.md for how to interpret sign-off against spec/sram.md's positive-margin requirement.
- **Links**:
  - Testbench: `sim/read-snm/testbench/tb_read_snm.spice`
  - Netlist snapshot: `sim/read-snm/netlist-snapshots/20260817-011523-4448966.spice`
  - Raw logs: `sim/read-snm/corners/20260817-011523-4448966/`
- **Timestamp / author**: 2026-08-17T01:15:53Z, agent-builder
- **Supersedes**: (none -- first record for this claim)
