2AMLogic/gf180-sram/sim/write-margin/records/20260817-011733-4448966.md

# Record 20260817-011733-4448966

- **Record ID**: 20260817-011733-4448966
- **Claim**: spec/sram.md Characterization -- write margin (write trip voltage)
- **Netlist provenance**: schematic (`sim/write-margin/testbench/tb_write_margin.spice`, DUT per `design/netlist/bitcell_6t.spice` at `4448966`)
- **Corner matrix run**:
  - Process: ff tt ss
  - Temperature: -40 25 125 C
  - Supply: 2.97 3.30 3.63 V
  - (9 corner points total -- full process x temp x supply matrix, per spec/sram.md's ratified corner set)
- **Statistical convention**: N/A (corner-matrix claim, not a distribution claim)
- **Result**:
  - **ff_-40c_2.97v**: RESULT: write_trip_voltage_v = 1.70775;RESULT: write_vdd_v = 2.97;
  - **ff_-40c_3.30v**: RESULT: write_trip_voltage_v = 1.8975;RESULT: write_vdd_v = 3.3;
  - **ff_-40c_3.63v**: RESULT: write_trip_voltage_v = 2.178;RESULT: write_vdd_v = 3.63;
  - **ff_25c_2.97v**: RESULT: write_trip_voltage_v = 1.70775;RESULT: write_vdd_v = 2.97;
  - **ff_25c_3.30v**: RESULT: write_trip_voltage_v = 1.8975;RESULT: write_vdd_v = 3.3;
  - **ff_25c_3.63v**: RESULT: write_trip_voltage_v = 2.08725;RESULT: write_vdd_v = 3.63;
  - **ff_125c_2.97v**: RESULT: write_trip_voltage_v = 1.70775;RESULT: write_vdd_v = 2.97;
  - **ff_125c_3.30v**: RESULT: write_trip_voltage_v = 1.8975;RESULT: write_vdd_v = 3.3;
  - **ff_125c_3.63v**: RESULT: write_trip_voltage_v = 2.08725;RESULT: write_vdd_v = 3.63;
  - **tt_-40c_2.97v**: RESULT: write_trip_voltage_v = 1.782;RESULT: write_vdd_v = 2.97;
  - **tt_-40c_3.30v**: RESULT: write_trip_voltage_v = 1.98;RESULT: write_vdd_v = 3.3;
  - **tt_-40c_3.63v**: RESULT: write_trip_voltage_v = 2.178;RESULT: write_vdd_v = 3.63;
  - **tt_25c_2.97v**: RESULT: write_trip_voltage_v = 1.782;RESULT: write_vdd_v = 2.97;
  - **tt_25c_3.30v**: RESULT: write_trip_voltage_v = 1.98;RESULT: write_vdd_v = 3.3;
  - **tt_25c_3.63v**: RESULT: write_trip_voltage_v = 2.178;RESULT: write_vdd_v = 3.63;
  - **tt_125c_2.97v**: RESULT: write_trip_voltage_v = 1.70775;RESULT: write_vdd_v = 2.97;
  - **tt_125c_3.30v**: RESULT: write_trip_voltage_v = 1.8975;RESULT: write_vdd_v = 3.3;
  - **tt_125c_3.63v**: RESULT: write_trip_voltage_v = 2.08725;RESULT: write_vdd_v = 3.63;
  - **ss_-40c_2.97v**: RESULT: write_trip_voltage_v = 1.782;RESULT: write_vdd_v = 2.97;
  - **ss_-40c_3.30v**: RESULT: write_trip_voltage_v = 1.98;RESULT: write_vdd_v = 3.3;
  - **ss_-40c_3.63v**: RESULT: write_trip_voltage_v = 2.178;RESULT: write_vdd_v = 3.63;
  - **ss_25c_2.97v**: RESULT: write_trip_voltage_v = 1.782;RESULT: write_vdd_v = 2.97;
  - **ss_25c_3.30v**: RESULT: write_trip_voltage_v = 1.98;RESULT: write_vdd_v = 3.3;
  - **ss_25c_3.63v**: RESULT: write_trip_voltage_v = 2.178;RESULT: write_vdd_v = 3.63;
  - **ss_125c_2.97v**: RESULT: write_trip_voltage_v = 1.70775;RESULT: write_vdd_v = 2.97;
  - **ss_125c_3.30v**: RESULT: write_trip_voltage_v = 1.98;RESULT: write_vdd_v = 3.3;
  - **ss_125c_3.63v**: RESULT: write_trip_voltage_v = 2.178;RESULT: write_vdd_v = 3.63;
  - **Overall: recorded** -- all 9 corners produced a measured result; see sim/README.md for how to interpret sign-off against spec/sram.md's positive-margin requirement.
- **Links**:
  - Testbench: `sim/write-margin/testbench/tb_write_margin.spice`
  - Netlist snapshot: `sim/write-margin/netlist-snapshots/20260817-011733-4448966.spice`
  - Raw logs: `sim/write-margin/corners/20260817-011733-4448966/`
- **Timestamp / author**: 2026-08-17T01:18:19Z, agent-builder
- **Supersedes**: (none -- first record for this claim)
