2AMLogic/gf180-sram/sim/hold-snm/mc/records/20260921-124534-cf5e975.md

# MC/yield record `20260921-124534-cf5e975`

- **Record ID**: `20260921-124534-cf5e975`
- **Kind**: Monte Carlo mismatch campaign + `klt yield` report (statistical evidence, klayout-tools `docs/design-evidence-tiers.md` item 6)
- **Claim**: spec/sram.md Characterization -- hold SNM (Monte Carlo device mismatch, combined with the ratified 9-corner PVT matrix)
- **Testbench**: `sim/hold-snm/testbench/tb_hold_snm.spice`
- **Netlist provenance**: schematic (this repo has not yet produced an extracted netlist; a post-layout re-run would record `extracted` here and reference this record via **Supersedes**)
- **Corner matrix run**: 9 corner points from `spec/sram.md`'s ratified process x temperature x voltage set (`ff_-40c_2.97v`, `ff_25c_3.30v`, `ff_125c_2.97v`, `tt_-40c_3.63v`, `tt_25c_3.30v`, `tt_125c_2.97v`, `ss_-40c_3.63v`, `ss_25c_2.97v`, `ss_125c_3.63v`) -- a deliberate Monte Carlo subset, chosen per `sim/README.md` "Which corners, and why not all of them". MC results **combine with**, and never replace, the deterministic corner records under `sim/hold-snm/records/`, which sweep that set exhaustively.
- **Statistical convention**: Monte Carlo, per-instance device mismatch only (`sw_stat_mismatch=1`; `delvto='mis_vth*sw_stat_mismatch' / mulu0='1-mis_k*sw_stat_mismatch' per nfet_03v3/pfet_03v3 instance`). Global/process variation is carried by the corner axis, not resampled -- so each corner is its own population and no estimate is pooled across corners.
- **Seed**: `20260817` (base). Per-sample seed = sha256(base_seed:corner_id:kind:sample_index), truncated to a positive 31-bit integer; delivered to ngspice as `.options seed=<derived>, one independent ngspice invocation per sample`.
- **Sample count**: 200 mismatch samples per corner, 4 determinism-control samples per corner, 100 negative-control samples per corner.
- **Spec limits**: `min = 0.0` V -- spec/sram.md 'Characterization' -- read SNM / hold SNM / write margin must be strictly positive at every corner. No `target_yield` is declared: `spec/sram.md` ratifies no yield target for these rows (that is exactly the open operator decision tracked as issue #20), and this harness does not invent one. The estimates below are therefore *reported* against the spec's own `> 0` limit, with Cpk / sigma-to-spec as the quantitative margin statement.
- **PDK**: `gf180mcuD`, open_pdks `c6d73a35f524070e85faff4a6a9eef49553ebc2b` -- **`klt`**: `klt 0.5.0+gfe6fe526388f.dirty` -- **git**: `cf5e975`
- **`klt yield` overall status**: `reported` (exit code 0)
- **Timestamp / author**: 2026-09-21T12:47:16Z / agent-builder
- **Supersedes**: (none)

## Per-corner result (verbatim from the `klt yield` JSON report)

| Corner | N | errored | mean (V) | stddev (V) | empirical yield, 95% lower bound | Cpk | sigma-to-spec | sample-size verdict | negative control |
|---|---|---|---|---|---|---|---|---|---|
| `ff_-40c_2.97v` | 200 | 0 | 1.00011 | 0.0173984 | 0.981725 | 19.161 | 57.4829 | sufficient | detected |
| `ff_25c_3.30v` | 200 | 0 | 1.05079 | 0.0196891 | 0.981725 | 17.7897 | 53.3692 | sufficient | detected |
| `ff_125c_2.97v` | 200 | 0 | 0.92988 | 0.0189327 | 0.981725 | 16.3717 | 49.1151 | sufficient | detected |
| `tt_-40c_3.63v` | 200 | 0 | 1.2129 | 0.017096 | 0.981725 | 23.6489 | 70.9466 | sufficient | detected |
| `tt_25c_3.30v` | 200 | 0 | 1.11069 | 0.0190448 | 0.981725 | 19.4399 | 58.3196 | sufficient | detected |
| `tt_125c_2.97v` | 200 | 0 | 0.993329 | 0.0166241 | 0.981725 | 19.9175 | 59.7524 | sufficient | detected |
| `ss_-40c_3.63v` | 200 | 0 | 1.26824 | 0.0168795 | 0.981725 | 25.0449 | 75.1348 | sufficient | detected |
| `ss_25c_2.97v` | 200 | 0 | 1.08155 | 0.0173882 | 0.981725 | 20.7335 | 62.2005 | sufficient | detected |
| `ss_125c_3.63v` | 200 | 0 | 1.215 | 0.0179754 | 0.981725 | 22.5308 | 67.5924 | sufficient | detected |

`errored` counts draws that produced no usable measurement (for the SNM fixtures: a draw whose butterfly was not bistable, so no square exists to measure). `klt yield` excludes them from every statistic, so a record with a non-zero `errored` column states a yield estimate *conditioned on a measurable draw* -- read the errored count alongside it, never the yield alone.

## Determinism control (mismatch off)

With `sw_stat_mismatch=0` the campaign must reproduce, exactly and identically for every draw, the number the deterministic corner sweep already recorded for the same corner. This is what ties the MC evidence to the ratified 27-corner evidence rather than leaving it a parallel, unanchored claim.

| Corner | N | errored | distinct value(s) (V) | verdict |
|---|---|---|---|---|
| `ff_-40c_2.97v` | 4 | 0 | 0.999016 | PINNED |
| `ff_25c_3.30v` | 4 | 0 | 1.04859 | PINNED |
| `ff_125c_2.97v` | 4 | 0 | 0.930461 | PINNED |
| `tt_-40c_3.63v` | 4 | 0 | 1.21357 | PINNED |
| `tt_25c_3.30v` | 4 | 0 | 1.11081 | PINNED |
| `tt_125c_2.97v` | 4 | 0 | 0.99341 | PINNED |
| `ss_-40c_3.63v` | 4 | 0 | 1.26881 | PINNED |
| `ss_25c_2.97v` | 4 | 0 | 1.08238 | PINNED |
| `ss_125c_3.63v` | 4 | 0 | 1.21645 | PINNED |

## Negative control

Deliberate defect: **known-bad variant: sw_stat_mismatch=12 (12x the PDK's per-instance Vt/current-factor mismatch sigma), VDD=0.50 V (below spec/sram.md's ratified 2.97 V minimum)**, drawn with its own independent, reproducibly-derived seeds and analysed by `klt yield` against the *same* spec limits as the nominal measurement. A `detected` verdict means the control's empirical yield is lower **and** its exact (Clopper-Pearson) confidence interval does not overlap the nominal's -- i.e. these statistics demonstrably do detect a degraded design, rather than being assumed to.

## `klt yield` run-level warnings

- no measurement declared a target_yield, so no yield claim was checked -- the estimates below are reported, never failed

## Links

- Sample-set document: [`sim/hold-snm/mc/samples/20260921-124534-cf5e975.json`](../samples/20260921-124534-cf5e975.json)
- `klt yield` JSON report: [`sim/hold-snm/mc/yield-reports/20260921-124534-cf5e975.json`](../yield-reports/20260921-124534-cf5e975.json)
- `klt yield` text report: [`sim/hold-snm/mc/yield-reports/20260921-124534-cf5e975.txt`](../yield-reports/20260921-124534-cf5e975.txt)
- Per-sample raw logs: [`sim/hold-snm/mc/raw-logs/20260921-124534-cf5e975`](../raw-logs/20260921-124534-cf5e975)
- Deterministic 27-corner records for the same claim: `sim/hold-snm/records/`

## Reproduce

```bash
sim/lib/run_mc_campaign.py \
  --experiment hold-snm \
  --testbench sim/hold-snm/testbench/tb_hold_snm.spice \
  --mode 'snm-pair:hold_snm_sweep.txt:hold_snm' --key hold_snm_v \
  --corner ff:-40:2.97 \
  --corner ff:25:3.30 \
  --corner ff:125:2.97 \
  --corner tt:-40:3.63 \
  --corner tt:25:3.30 \
  --corner tt:125:2.97 \
  --corner ss:-40:3.63 \
  --corner ss:25:2.97 \
  --corner ss:125:3.63 \
  --n 200 --n-control 4 --n-nc 100 \
  --nc-mismatch-scale 12 --nc-vdd 0.50 \
  --seed 20260817 \
  --claim "spec/sram.md Characterization -- hold SNM (Monte Carlo device mismatch, combined with the ratified 9-corner PVT matrix)"
```

## `klt yield` text report (verbatim)

```
samples: sim/hold-snm/mc/samples/20260921-124534-cf5e975.json
source: sample-set  samples_analyzed: 1800
confidence: 0.95  target_ci_halfwidth: 0.01
status: reported  measurements: 9

hold_snm_v@ff_-40c_2.97v [V]  status: reported  N: 200
  limits: min(>=)=0 max(<=)=- target_yield=-
  fit (normal): mean=1.00011 stddev=0.0173984 normality=consistent
  yield (empirical, clopper-pearson): 1.000000 [0.981725, 1.000000] at 95%, N=200
  yield (normal, normal-delta): 1.000000 [1.000000, 1.000000] at 95%, N=200
  capability: cp=- cpk=19.1610 [17.2779, 21.0440] sigma_to_spec=57.4829 limiting=lower
  sample size: sufficient (N=200, required>=183, observed +/-0.009138 vs target +/-0.01)
  negative control (known-bad variant: sw_stat_mismatch=12 (12x the PDK's per-instance Vt/current-factor mismatch sigma), VDD=0.50 V (below spec/sram.md's ratified 2.97 V minimum)): detected -- yield 0.400000 [0.303295, 0.502791] vs nominal 1.000000, N=100
  warning: measurement 'hold_snm_v@ff_-40c_2.97v': no sample fell outside the limits, so the empirical yield is bounded only from below -- "at least 98.1725% at 95% confidence, N = 200" is the honest statement, not "100% yield"

hold_snm_v@ff_25c_3.30v [V]  status: reported  N: 200
  limits: min(>=)=0 max(<=)=- target_yield=-
  fit (normal): mean=1.05079 stddev=0.0196891 normality=consistent
  yield (empirical, clopper-pearson): 1.000000 [0.981725, 1.000000] at 95%, N=200
  yield (normal, normal-delta): 1.000000 [1.000000, 1.000000] at 95%, N=200
  capability: cp=- cpk=17.7897 [16.0414, 19.5381] sigma_to_spec=53.3692 limiting=lower
  sample size: sufficient (N=200, required>=183, observed +/-0.009138 vs target +/-0.01)
  negative control (known-bad variant: sw_stat_mismatch=12 (12x the PDK's per-instance Vt/current-factor mismatch sigma), VDD=0.50 V (below spec/sram.md's ratified 2.97 V minimum)): detected -- yield 0.565657 [0.462269, 0.665011] vs nominal 1.000000, N=99
  warning: measurement 'hold_snm_v@ff_25c_3.30v': no sample fell outside the limits, so the empirical yield is bounded only from below -- "at least 98.1725% at 95% confidence, N = 200" is the honest statement, not "100% yield"

hold_snm_v@ff_125c_2.97v [V]  status: reported  N: 200
  limits: min(>=)=0 max(<=)=- target_yield=-
  fit (normal): mean=0.92988 stddev=0.0189327 normality=consistent
  yield (empirical, clopper-pearson): 1.000000 [0.981725, 1.000000] at 95%, N=200
  yield (normal, normal-delta): 1.000000 [1.000000, 1.000000] at 95%, N=200
  capability: cp=- cpk=16.3717 [14.7626, 17.9808] sigma_to_spec=49.1151 limiting=lower
  sample size: sufficient (N=200, required>=183, observed +/-0.009138 vs target +/-0.01)
  negative control (known-bad variant: sw_stat_mismatch=12 (12x the PDK's per-instance Vt/current-factor mismatch sigma), VDD=0.50 V (below spec/sram.md's ratified 2.97 V minimum)): detected -- yield 0.650000 [0.548151, 0.742706] vs nominal 1.000000, N=100
  warning: measurement 'hold_snm_v@ff_125c_2.97v': no sample fell outside the limits, so the empirical yield is bounded only from below -- "at least 98.1725% at 95% confidence, N = 200" is the honest statement, not "100% yield"

hold_snm_v@tt_-40c_3.63v [V]  status: reported  N: 200
  limits: min(>=)=0 max(<=)=- target_yield=-
  fit (normal): mean=1.2129 stddev=0.017096 normality=rejected
  yield (empirical, clopper-pearson): 1.000000 [0.981725, 1.000000] at 95%, N=200
  yield (normal, normal-delta): 1.000000 [1.000000, 1.000000] at 95%, N=200
  capability: cp=- cpk=23.6489 [21.3250, 25.9727] sigma_to_spec=70.9466 limiting=lower
  sample size: sufficient (N=200, required>=183, observed +/-0.009138 vs target +/-0.01)
  negative control (known-bad variant: sw_stat_mismatch=12 (12x the PDK's per-instance Vt/current-factor mismatch sigma), VDD=0.50 V (below spec/sram.md's ratified 2.97 V minimum)): detected -- yield 0.323232 [0.232678, 0.424685] vs nominal 1.000000, N=99
  warning: measurement 'hold_snm_v@tt_-40c_3.63v': the sample set is not consistent with a normal distribution (Anderson-Darling A2* = 0.8451 > 0.787); treat the parametric yield estimate and Cpk as indicative only and prefer the empirical estimate
  warning: measurement 'hold_snm_v@tt_-40c_3.63v': no sample fell outside the limits, so the empirical yield is bounded only from below -- "at least 98.1725% at 95% confidence, N = 200" is the honest statement, not "100% yield"

hold_snm_v@tt_25c_3.30v [V]  status: reported  N: 200
  limits: min(>=)=0 max(<=)=- target_yield=-
  fit (normal): mean=1.11069 stddev=0.0190448 normality=consistent
  yield (empirical, clopper-pearson): 1.000000 [0.981725, 1.000000] at 95%, N=200
  yield (normal, normal-delta): 1.000000 [1.000000, 1.000000] at 95%, N=200
  capability: cp=- cpk=19.4399 [17.5295, 21.3503] sigma_to_spec=58.3196 limiting=lower
  sample size: sufficient (N=200, required>=183, observed +/-0.009138 vs target +/-0.01)
  negative control (known-bad variant: sw_stat_mismatch=12 (12x the PDK's per-instance Vt/current-factor mismatch sigma), VDD=0.50 V (below spec/sram.md's ratified 2.97 V minimum)): detected -- yield 0.450000 [0.350320, 0.552720] vs nominal 1.000000, N=100
  warning: measurement 'hold_snm_v@tt_25c_3.30v': no sample fell outside the limits, so the empirical yield is bounded only from below -- "at least 98.1725% at 95% confidence, N = 200" is the honest statement, not "100% yield"

hold_snm_v@tt_125c_2.97v [V]  status: reported  N: 200
  limits: min(>=)=0 max(<=)=- target_yield=-
  fit (normal): mean=0.993329 stddev=0.0166241 normality=consistent
  yield (empirical, clopper-pearson): 1.000000 [0.981725, 1.000000] at 95%, N=200
  yield (normal, normal-delta): 1.000000 [1.000000, 1.000000] at 95%, N=200
  capability: cp=- cpk=19.9175 [17.9601, 21.8748] sigma_to_spec=59.7524 limiting=lower
  sample size: sufficient (N=200, required>=183, observed +/-0.009138 vs target +/-0.01)
  negative control (known-bad variant: sw_stat_mismatch=12 (12x the PDK's per-instance Vt/current-factor mismatch sigma), VDD=0.50 V (below spec/sram.md's ratified 2.97 V minimum)): detected -- yield 0.610000 [0.507314, 0.705990] vs nominal 1.000000, N=100
  warning: measurement 'hold_snm_v@tt_125c_2.97v': no sample fell outside the limits, so the empirical yield is bounded only from below -- "at least 98.1725% at 95% confidence, N = 200" is the honest statement, not "100% yield"

hold_snm_v@ss_-40c_3.63v [V]  status: reported  N: 200
  limits: min(>=)=0 max(<=)=- target_yield=-
  fit (normal): mean=1.26824 stddev=0.0168795 normality=consistent
  yield (empirical, clopper-pearson): 1.000000 [0.981725, 1.000000] at 95%, N=200
  yield (normal, normal-delta): 1.000000 [1.000000, 1.000000] at 95%, N=200
  capability: cp=- cpk=25.0449 [22.5840, 27.5059] sigma_to_spec=75.1348 limiting=lower
  sample size: sufficient (N=200, required>=183, observed +/-0.009138 vs target +/-0.01)
  negative control (known-bad variant: sw_stat_mismatch=12 (12x the PDK's per-instance Vt/current-factor mismatch sigma), VDD=0.50 V (below spec/sram.md's ratified 2.97 V minimum)): detected -- yield 0.230000 [0.151732, 0.324859] vs nominal 1.000000, N=100
  warning: measurement 'hold_snm_v@ss_-40c_3.63v': no sample fell outside the limits, so the empirical yield is bounded only from below -- "at least 98.1725% at 95% confidence, N = 200" is the honest statement, not "100% yield"

hold_snm_v@ss_25c_2.97v [V]  status: reported  N: 200
  limits: min(>=)=0 max(<=)=- target_yield=-
  fit (normal): mean=1.08155 stddev=0.0173882 normality=consistent
  yield (empirical, clopper-pearson): 1.000000 [0.981725, 1.000000] at 95%, N=200
  yield (normal, normal-delta): 1.000000 [1.000000, 1.000000] at 95%, N=200
  capability: cp=- cpk=20.7335 [18.6960, 22.7710] sigma_to_spec=62.2005 limiting=lower
  sample size: sufficient (N=200, required>=183, observed +/-0.009138 vs target +/-0.01)
  negative control (known-bad variant: sw_stat_mismatch=12 (12x the PDK's per-instance Vt/current-factor mismatch sigma), VDD=0.50 V (below spec/sram.md's ratified 2.97 V minimum)): detected -- yield 0.360000 [0.266408, 0.462122] vs nominal 1.000000, N=100
  warning: measurement 'hold_snm_v@ss_25c_2.97v': no sample fell outside the limits, so the empirical yield is bounded only from below -- "at least 98.1725% at 95% confidence, N = 200" is the honest statement, not "100% yield"

hold_snm_v@ss_125c_3.63v [V]  status: reported  N: 200
  limits: min(>=)=0 max(<=)=- target_yield=-
  fit (normal): mean=1.215 stddev=0.0179754 normality=consistent
  yield (empirical, clopper-pearson): 1.000000 [0.981725, 1.000000] at 95%, N=200
  yield (normal, normal-delta): 1.000000 [1.000000, 1.000000] at 95%, N=200
  capability: cp=- cpk=22.5308 [20.3168, 24.7448] sigma_to_spec=67.5924 limiting=lower
  sample size: sufficient (N=200, required>=183, observed +/-0.009138 vs target +/-0.01)
  negative control (known-bad variant: sw_stat_mismatch=12 (12x the PDK's per-instance Vt/current-factor mismatch sigma), VDD=0.50 V (below spec/sram.md's ratified 2.97 V minimum)): detected -- yield 0.560000 [0.457187, 0.659164] vs nominal 1.000000, N=100
  warning: measurement 'hold_snm_v@ss_125c_3.63v': no sample fell outside the limits, so the empirical yield is bounded only from below -- "at least 98.1725% at 95% confidence, N = 200" is the honest statement, not "100% yield"

warnings:
  no measurement declared a target_yield, so no yield claim was checked -- the estimates below are reported, never failed
```
