2AMLogic/gf180-sram/sim/read-snm/mc/records/20260921-124232-cf5e975.md

# MC/yield record `20260921-124232-cf5e975`

- **Record ID**: `20260921-124232-cf5e975`
- **Kind**: Monte Carlo mismatch campaign + `klt yield` report (statistical evidence, klayout-tools `docs/design-evidence-tiers.md` item 6)
- **Claim**: spec/sram.md Characterization -- read SNM (Monte Carlo device mismatch, combined with the ratified 9-corner PVT matrix)
- **Testbench**: `sim/read-snm/testbench/tb_read_snm.spice`
- **Netlist provenance**: schematic (this repo has not yet produced an extracted netlist; a post-layout re-run would record `extracted` here and reference this record via **Supersedes**)
- **Corner matrix run**: 9 corner points from `spec/sram.md`'s ratified process x temperature x voltage set (`ff_-40c_2.97v`, `ff_25c_3.30v`, `ff_125c_2.97v`, `tt_-40c_3.63v`, `tt_25c_3.30v`, `tt_125c_2.97v`, `ss_-40c_3.63v`, `ss_25c_2.97v`, `ss_125c_3.63v`) -- a deliberate Monte Carlo subset, chosen per `sim/README.md` "Which corners, and why not all of them". MC results **combine with**, and never replace, the deterministic corner records under `sim/read-snm/records/`, which sweep that set exhaustively.
- **Statistical convention**: Monte Carlo, per-instance device mismatch only (`sw_stat_mismatch=1`; `delvto='mis_vth*sw_stat_mismatch' / mulu0='1-mis_k*sw_stat_mismatch' per nfet_03v3/pfet_03v3 instance`). Global/process variation is carried by the corner axis, not resampled -- so each corner is its own population and no estimate is pooled across corners.
- **Seed**: `20260817` (base). Per-sample seed = sha256(base_seed:corner_id:kind:sample_index), truncated to a positive 31-bit integer; delivered to ngspice as `.options seed=<derived>, one independent ngspice invocation per sample`.
- **Sample count**: 200 mismatch samples per corner, 4 determinism-control samples per corner, 100 negative-control samples per corner.
- **Spec limits**: `min = 0.0` V -- spec/sram.md 'Characterization' -- read SNM / hold SNM / write margin must be strictly positive at every corner. No `target_yield` is declared: `spec/sram.md` ratifies no yield target for these rows (that is exactly the open operator decision tracked as issue #20), and this harness does not invent one. The estimates below are therefore *reported* against the spec's own `> 0` limit, with Cpk / sigma-to-spec as the quantitative margin statement.
- **PDK**: `gf180mcuD`, open_pdks `c6d73a35f524070e85faff4a6a9eef49553ebc2b` -- **`klt`**: `klt 0.5.0+gfe6fe526388f.dirty` -- **git**: `cf5e975`
- **`klt yield` overall status**: `reported` (exit code 0)
- **Timestamp / author**: 2026-09-21T12:44:29Z / agent-builder
- **Supersedes**: (none)

## Per-corner result (verbatim from the `klt yield` JSON report)

| Corner | N | errored | mean (V) | stddev (V) | empirical yield, 95% lower bound | Cpk | sigma-to-spec | sample-size verdict | negative control |
|---|---|---|---|---|---|---|---|---|---|
| `ff_-40c_2.97v` | 200 | 0 | 0.347325 | 0.0226316 | 0.981725 | 5.11564 | 15.3469 | sufficient | detected |
| `ff_25c_3.30v` | 200 | 0 | 0.293314 | 0.030682 | 0.981725 | 3.18661 | 9.55983 | sufficient | detected |
| `ff_125c_2.97v` | 200 | 0 | 0.214422 | 0.0279419 | 0.981725 | 2.55795 | 7.67386 | sufficient | detected |
| `tt_-40c_3.63v` | 200 | 0 | 0.457688 | 0.0212328 | 0.981725 | 7.18525 | 21.5557 | sufficient | detected |
| `tt_25c_3.30v` | 200 | 0 | 0.382673 | 0.0235576 | 0.981725 | 5.41472 | 16.2442 | sufficient | detected |
| `tt_125c_2.97v` | 200 | 0 | 0.293317 | 0.0230081 | 0.981725 | 4.24947 | 12.7484 | sufficient | detected |
| `ss_-40c_3.63v` | 200 | 0 | 0.562762 | 0.0212834 | 0.981725 | 8.81381 | 26.4414 | sufficient | detected |
| `ss_25c_2.97v` | 200 | 0 | 0.47458 | 0.0224131 | 0.981725 | 7.05806 | 21.1742 | sufficient | detected |
| `ss_125c_3.63v` | 200 | 0 | 0.406407 | 0.0240491 | 0.981725 | 5.63303 | 16.8991 | sufficient | detected |

`errored` counts draws that produced no usable measurement (for the SNM fixtures: a draw whose butterfly was not bistable, so no square exists to measure). `klt yield` excludes them from every statistic, so a record with a non-zero `errored` column states a yield estimate *conditioned on a measurable draw* -- read the errored count alongside it, never the yield alone.

## Determinism control (mismatch off)

With `sw_stat_mismatch=0` the campaign must reproduce, exactly and identically for every draw, the number the deterministic corner sweep already recorded for the same corner. This is what ties the MC evidence to the ratified 27-corner evidence rather than leaving it a parallel, unanchored claim.

| Corner | N | errored | distinct value(s) (V) | verdict |
|---|---|---|---|---|
| `ff_-40c_2.97v` | 4 | 0 | 0.346745 | PINNED |
| `ff_25c_3.30v` | 4 | 0 | 0.29104 | PINNED |
| `ff_125c_2.97v` | 4 | 0 | 0.214599 | PINNED |
| `tt_-40c_3.63v` | 4 | 0 | 0.45802 | PINNED |
| `tt_25c_3.30v` | 4 | 0 | 0.381267 | PINNED |
| `tt_125c_2.97v` | 4 | 0 | 0.295443 | PINNED |
| `ss_-40c_3.63v` | 4 | 0 | 0.56375 | PINNED |
| `ss_25c_2.97v` | 4 | 0 | 0.475538 | PINNED |
| `ss_125c_3.63v` | 4 | 0 | 0.40862 | PINNED |

## Negative control

Deliberate defect: **known-bad variant: sw_stat_mismatch=20 (20x the PDK's per-instance Vt/current-factor mismatch sigma)**, drawn with its own independent, reproducibly-derived seeds and analysed by `klt yield` against the *same* spec limits as the nominal measurement. A `detected` verdict means the control's empirical yield is lower **and** its exact (Clopper-Pearson) confidence interval does not overlap the nominal's -- i.e. these statistics demonstrably do detect a degraded design, rather than being assumed to.

## `klt yield` run-level warnings

- no measurement declared a target_yield, so no yield claim was checked -- the estimates below are reported, never failed

## Links

- Sample-set document: [`sim/read-snm/mc/samples/20260921-124232-cf5e975.json`](../samples/20260921-124232-cf5e975.json)
- `klt yield` JSON report: [`sim/read-snm/mc/yield-reports/20260921-124232-cf5e975.json`](../yield-reports/20260921-124232-cf5e975.json)
- `klt yield` text report: [`sim/read-snm/mc/yield-reports/20260921-124232-cf5e975.txt`](../yield-reports/20260921-124232-cf5e975.txt)
- Per-sample raw logs: [`sim/read-snm/mc/raw-logs/20260921-124232-cf5e975`](../raw-logs/20260921-124232-cf5e975)
- Deterministic 27-corner records for the same claim: `sim/read-snm/records/`

## Reproduce

```bash
sim/lib/run_mc_campaign.py \
  --experiment read-snm \
  --testbench sim/read-snm/testbench/tb_read_snm.spice \
  --mode 'snm-pair:read_snm_sweep.txt:read_snm' --key read_snm_v \
  --corner ff:-40:2.97 \
  --corner ff:25:3.30 \
  --corner ff:125:2.97 \
  --corner tt:-40:3.63 \
  --corner tt:25:3.30 \
  --corner tt:125:2.97 \
  --corner ss:-40:3.63 \
  --corner ss:25:2.97 \
  --corner ss:125:3.63 \
  --n 200 --n-control 4 --n-nc 100 \
  --nc-mismatch-scale 20 \
  --seed 20260817 \
  --claim "spec/sram.md Characterization -- read SNM (Monte Carlo device mismatch, combined with the ratified 9-corner PVT matrix)"
```

## `klt yield` text report (verbatim)

```
samples: sim/read-snm/mc/samples/20260921-124232-cf5e975.json
source: sample-set  samples_analyzed: 1800
confidence: 0.95  target_ci_halfwidth: 0.01
status: reported  measurements: 9

read_snm_v@ff_-40c_2.97v [V]  status: reported  N: 200
  limits: min(>=)=0 max(<=)=- target_yield=-
  fit (normal): mean=0.347325 stddev=0.0226316 normality=consistent
  yield (empirical, clopper-pearson): 1.000000 [0.981725, 1.000000] at 95%, N=200
  yield (normal, normal-delta): 1.000000 [1.000000, 1.000000] at 95%, N=200
  capability: cp=- cpk=5.1156 [4.6109, 5.6203] sigma_to_spec=15.3469 limiting=lower
  sample size: sufficient (N=200, required>=183, observed +/-0.009138 vs target +/-0.01)
  negative control (known-bad variant: sw_stat_mismatch=20 (20x the PDK's per-instance Vt/current-factor mismatch sigma)): detected -- yield 0.574468 [0.468209, 0.675904] vs nominal 1.000000, N=94
  warning: measurement 'read_snm_v@ff_-40c_2.97v': no sample fell outside the limits, so the empirical yield is bounded only from below -- "at least 98.1725% at 95% confidence, N = 200" is the honest statement, not "100% yield"

read_snm_v@ff_25c_3.30v [V]  status: reported  N: 200
  limits: min(>=)=0 max(<=)=- target_yield=-
  fit (normal): mean=0.293314 stddev=0.030682 normality=consistent
  yield (empirical, clopper-pearson): 1.000000 [0.981725, 1.000000] at 95%, N=200
  yield (normal, normal-delta): 1.000000 [1.000000, 1.000000] at 95%, N=200
  capability: cp=- cpk=3.1866 [2.8702, 3.5031] sigma_to_spec=9.5598 limiting=lower
  sample size: sufficient (N=200, required>=183, observed +/-0.009138 vs target +/-0.01)
  negative control (known-bad variant: sw_stat_mismatch=20 (20x the PDK's per-instance Vt/current-factor mismatch sigma)): detected -- yield 0.560440 [0.452452, 0.664383] vs nominal 1.000000, N=91
  warning: measurement 'read_snm_v@ff_25c_3.30v': no sample fell outside the limits, so the empirical yield is bounded only from below -- "at least 98.1725% at 95% confidence, N = 200" is the honest statement, not "100% yield"

read_snm_v@ff_125c_2.97v [V]  status: reported  N: 200
  limits: min(>=)=0 max(<=)=- target_yield=-
  fit (normal): mean=0.214422 stddev=0.0279419 normality=consistent
  yield (empirical, clopper-pearson): 1.000000 [0.981725, 1.000000] at 95%, N=200
  yield (normal, normal-delta): 1.000000 [1.000000, 1.000000] at 95%, N=200
  capability: cp=- cpk=2.5580 [2.3024, 2.8135] sigma_to_spec=7.6739 limiting=lower
  sample size: sufficient (N=200, required>=183, observed +/-0.009138 vs target +/-0.01)
  negative control (known-bad variant: sw_stat_mismatch=20 (20x the PDK's per-instance Vt/current-factor mismatch sigma)): detected -- yield 0.447917 [0.346275, 0.552859] vs nominal 1.000000, N=96
  warning: measurement 'read_snm_v@ff_125c_2.97v': no sample fell outside the limits, so the empirical yield is bounded only from below -- "at least 98.1725% at 95% confidence, N = 200" is the honest statement, not "100% yield"

read_snm_v@tt_-40c_3.63v [V]  status: reported  N: 200
  limits: min(>=)=0 max(<=)=- target_yield=-
  fit (normal): mean=0.457688 stddev=0.0212328 normality=consistent
  yield (empirical, clopper-pearson): 1.000000 [0.981725, 1.000000] at 95%, N=200
  yield (normal, normal-delta): 1.000000 [1.000000, 1.000000] at 95%, N=200
  capability: cp=- cpk=7.1852 [6.4778, 7.8927] sigma_to_spec=21.5557 limiting=lower
  sample size: sufficient (N=200, required>=183, observed +/-0.009138 vs target +/-0.01)
  negative control (known-bad variant: sw_stat_mismatch=20 (20x the PDK's per-instance Vt/current-factor mismatch sigma)): detected -- yield 0.673913 [0.568239, 0.768036] vs nominal 1.000000, N=92
  warning: measurement 'read_snm_v@tt_-40c_3.63v': no sample fell outside the limits, so the empirical yield is bounded only from below -- "at least 98.1725% at 95% confidence, N = 200" is the honest statement, not "100% yield"

read_snm_v@tt_25c_3.30v [V]  status: reported  N: 200
  limits: min(>=)=0 max(<=)=- target_yield=-
  fit (normal): mean=0.382673 stddev=0.0235576 normality=consistent
  yield (empirical, clopper-pearson): 1.000000 [0.981725, 1.000000] at 95%, N=200
  yield (normal, normal-delta): 1.000000 [1.000000, 1.000000] at 95%, N=200
  capability: cp=- cpk=5.4147 [4.8808, 5.9487] sigma_to_spec=16.2442 limiting=lower
  sample size: sufficient (N=200, required>=183, observed +/-0.009138 vs target +/-0.01)
  negative control (known-bad variant: sw_stat_mismatch=20 (20x the PDK's per-instance Vt/current-factor mismatch sigma)): detected -- yield 0.535354 [0.432306, 0.636230] vs nominal 1.000000, N=99
  warning: measurement 'read_snm_v@tt_25c_3.30v': no sample fell outside the limits, so the empirical yield is bounded only from below -- "at least 98.1725% at 95% confidence, N = 200" is the honest statement, not "100% yield"

read_snm_v@tt_125c_2.97v [V]  status: reported  N: 200
  limits: min(>=)=0 max(<=)=- target_yield=-
  fit (normal): mean=0.293317 stddev=0.0230081 normality=consistent
  yield (empirical, clopper-pearson): 1.000000 [0.981725, 1.000000] at 95%, N=200
  yield (normal, normal-delta): 1.000000 [1.000000, 1.000000] at 95%, N=200
  capability: cp=- cpk=4.2495 [3.8294, 4.6695] sigma_to_spec=12.7484 limiting=lower
  sample size: sufficient (N=200, required>=183, observed +/-0.009138 vs target +/-0.01)
  negative control (known-bad variant: sw_stat_mismatch=20 (20x the PDK's per-instance Vt/current-factor mismatch sigma)): detected -- yield 0.552083 [0.447141, 0.653725] vs nominal 1.000000, N=96
  warning: measurement 'read_snm_v@tt_125c_2.97v': no sample fell outside the limits, so the empirical yield is bounded only from below -- "at least 98.1725% at 95% confidence, N = 200" is the honest statement, not "100% yield"

read_snm_v@ss_-40c_3.63v [V]  status: reported  N: 200
  limits: min(>=)=0 max(<=)=- target_yield=-
  fit (normal): mean=0.562762 stddev=0.0212834 normality=consistent
  yield (empirical, clopper-pearson): 1.000000 [0.981725, 1.000000] at 95%, N=200
  yield (normal, normal-delta): 1.000000 [1.000000, 1.000000] at 95%, N=200
  capability: cp=- cpk=8.8138 [7.9467, 9.6809] sigma_to_spec=26.4414 limiting=lower
  sample size: sufficient (N=200, required>=183, observed +/-0.009138 vs target +/-0.01)
  negative control (known-bad variant: sw_stat_mismatch=20 (20x the PDK's per-instance Vt/current-factor mismatch sigma)): detected -- yield 0.793814 [0.699684, 0.869271] vs nominal 1.000000, N=97
  warning: measurement 'read_snm_v@ss_-40c_3.63v': no sample fell outside the limits, so the empirical yield is bounded only from below -- "at least 98.1725% at 95% confidence, N = 200" is the honest statement, not "100% yield"

read_snm_v@ss_25c_2.97v [V]  status: reported  N: 200
  limits: min(>=)=0 max(<=)=- target_yield=-
  fit (normal): mean=0.47458 stddev=0.0224131 normality=consistent
  yield (empirical, clopper-pearson): 1.000000 [0.981725, 1.000000] at 95%, N=200
  yield (normal, normal-delta): 1.000000 [1.000000, 1.000000] at 95%, N=200
  capability: cp=- cpk=7.0581 [6.3631, 7.7530] sigma_to_spec=21.1742 limiting=lower
  sample size: sufficient (N=200, required>=183, observed +/-0.009138 vs target +/-0.01)
  negative control (known-bad variant: sw_stat_mismatch=20 (20x the PDK's per-instance Vt/current-factor mismatch sigma)): detected -- yield 0.677419 [0.572505, 0.770677] vs nominal 1.000000, N=93
  warning: measurement 'read_snm_v@ss_25c_2.97v': no sample fell outside the limits, so the empirical yield is bounded only from below -- "at least 98.1725% at 95% confidence, N = 200" is the honest statement, not "100% yield"

read_snm_v@ss_125c_3.63v [V]  status: reported  N: 200
  limits: min(>=)=0 max(<=)=- target_yield=-
  fit (normal): mean=0.406407 stddev=0.0240491 normality=consistent
  yield (empirical, clopper-pearson): 1.000000 [0.981725, 1.000000] at 95%, N=200
  yield (normal, normal-delta): 1.000000 [1.000000, 1.000000] at 95%, N=200
  capability: cp=- cpk=5.6330 [5.0777, 6.1884] sigma_to_spec=16.8991 limiting=lower
  sample size: sufficient (N=200, required>=183, observed +/-0.009138 vs target +/-0.01)
  negative control (known-bad variant: sw_stat_mismatch=20 (20x the PDK's per-instance Vt/current-factor mismatch sigma)): detected -- yield 0.621053 [0.515704, 0.718636] vs nominal 1.000000, N=95
  warning: measurement 'read_snm_v@ss_125c_3.63v': no sample fell outside the limits, so the empirical yield is bounded only from below -- "at least 98.1725% at 95% confidence, N = 200" is the honest statement, not "100% yield"

warnings:
  no measurement declared a target_yield, so no yield claim was checked -- the estimates below are reported, never failed
```
