2AMLogic/gf180-sram/sim/write-margin/mc/records/20260921-124804-cf5e975.md

# MC/yield record `20260921-124804-cf5e975`

- **Record ID**: `20260921-124804-cf5e975`
- **Kind**: Monte Carlo mismatch campaign + `klt yield` report (statistical evidence, klayout-tools `docs/design-evidence-tiers.md` item 6)
- **Claim**: spec/sram.md Characterization -- write margin, as write trip voltage (Monte Carlo device mismatch, combined with the ratified 9-corner PVT matrix)
- **Testbench**: `sim/write-margin/testbench/tb_write_margin.spice`
- **Netlist provenance**: schematic (this repo has not yet produced an extracted netlist; a post-layout re-run would record `extracted` here and reference this record via **Supersedes**)
- **Corner matrix run**: 9 corner points from `spec/sram.md`'s ratified process x temperature x voltage set (`ff_-40c_2.97v`, `ff_25c_3.30v`, `ff_125c_2.97v`, `tt_-40c_3.63v`, `tt_25c_3.30v`, `tt_125c_2.97v`, `ss_-40c_3.63v`, `ss_25c_2.97v`, `ss_125c_3.63v`) -- a deliberate Monte Carlo subset, chosen per `sim/README.md` "Which corners, and why not all of them". MC results **combine with**, and never replace, the deterministic corner records under `sim/write-margin/records/`, which sweep that set exhaustively.
- **Statistical convention**: Monte Carlo, per-instance device mismatch only (`sw_stat_mismatch=1`; `delvto='mis_vth*sw_stat_mismatch' / mulu0='1-mis_k*sw_stat_mismatch' per nfet_03v3/pfet_03v3 instance`). Global/process variation is carried by the corner axis, not resampled -- so each corner is its own population and no estimate is pooled across corners.
- **Seed**: `20260817` (base). Per-sample seed = sha256(base_seed:corner_id:kind:sample_index), truncated to a positive 31-bit integer; delivered to ngspice as `.options seed=<derived>, one independent ngspice invocation per sample`.
- **Sample count**: 200 mismatch samples per corner, 4 determinism-control samples per corner, 100 negative-control samples per corner.
- **Spec limits**: `min = 0.0` V -- spec/sram.md 'Characterization' -- read SNM / hold SNM / write margin must be strictly positive at every corner. No `target_yield` is declared: `spec/sram.md` ratifies no yield target for these rows (that is exactly the open operator decision tracked as issue #20), and this harness does not invent one. The estimates below are therefore *reported* against the spec's own `> 0` limit, with Cpk / sigma-to-spec as the quantitative margin statement.
- **PDK**: `gf180mcuD`, open_pdks `c6d73a35f524070e85faff4a6a9eef49553ebc2b` -- **`klt`**: `klt 0.5.0+gfe6fe526388f.dirty` -- **git**: `cf5e975`
- **`klt yield` overall status**: `reported` (exit code 0)
- **Timestamp / author**: 2026-09-21T12:51:14Z / agent-builder
- **Supersedes**: (none)

## Per-corner result (verbatim from the `klt yield` JSON report)

| Corner | N | errored | mean (V) | stddev (V) | empirical yield, 95% lower bound | Cpk | sigma-to-spec | sample-size verdict | negative control |
|---|---|---|---|---|---|---|---|---|---|
| `ff_-40c_2.97v` | 200 | 0 | 1.69603 | 0.00725803 | 0.981725 | 77.892 | 233.676 | sufficient | detected |
| `ff_25c_3.30v` | 200 | 0 | 1.87109 | 0.00640147 | 0.981725 | 97.4301 | 292.29 | sufficient | detected |
| `ff_125c_2.97v` | 200 | 0 | 1.63959 | 0.0063209 | 0.981725 | 86.4642 | 259.393 | sufficient | detected |
| `tt_-40c_3.63v` | 200 | 0 | 2.13283 | 0.0076442 | 0.981725 | 93.0041 | 279.012 | sufficient | detected |
| `tt_25c_3.30v` | 200 | 0 | 1.91095 | 0.00636431 | 0.981725 | 100.087 | 300.26 | sufficient | detected |
| `tt_125c_2.97v` | 200 | 0 | 1.67766 | 0.00489921 | 0.981725 | 114.145 | 342.435 | sufficient | detected |
| `ss_-40c_3.63v` | 200 | 0 | 2.17257 | 0.00697421 | 0.981725 | 103.838 | 311.515 | sufficient | detected |
| `ss_25c_2.97v` | 200 | 0 | 1.74226 | 0.00546601 | 0.981725 | 106.248 | 318.744 | sufficient | detected |
| `ss_125c_3.63v` | 200 | 0 | 2.10919 | 0.00524258 | 0.981725 | 134.106 | 402.319 | sufficient | detected |

`errored` counts draws that produced no usable measurement (for the SNM fixtures: a draw whose butterfly was not bistable, so no square exists to measure). `klt yield` excludes them from every statistic, so a record with a non-zero `errored` column states a yield estimate *conditioned on a measurable draw* -- read the errored count alongside it, never the yield alone.

## Determinism control (mismatch off)

With `sw_stat_mismatch=0` the campaign must reproduce, exactly and identically for every draw, the number the deterministic corner sweep already recorded for the same corner. This is what ties the MC evidence to the ratified 27-corner evidence rather than leaving it a parallel, unanchored claim.

| Corner | N | errored | distinct value(s) (V) | verdict |
|---|---|---|---|---|
| `ff_-40c_2.97v` | 4 | 0 | 1.69546 | PINNED |
| `ff_25c_3.30v` | 4 | 0 | 1.87075 | PINNED |
| `ff_125c_2.97v` | 4 | 0 | 1.64053 | PINNED |
| `tt_-40c_3.63v` | 4 | 0 | 2.13271 | PINNED |
| `tt_25c_3.30v` | 4 | 0 | 1.91003 | PINNED |
| `tt_125c_2.97v` | 4 | 0 | 1.67751 | PINNED |
| `ss_-40c_3.63v` | 4 | 0 | 2.17259 | PINNED |
| `ss_25c_2.97v` | 4 | 0 | 1.74241 | PINNED |
| `ss_125c_3.63v` | 4 | 0 | 2.10967 | PINNED |

## Negative control

Deliberate defect: **known-bad variant: sw_stat_mismatch=6 (6x the PDK's per-instance Vt/current-factor mismatch sigma), VDD=0.60 V (below spec/sram.md's ratified 2.97 V minimum)**, drawn with its own independent, reproducibly-derived seeds and analysed by `klt yield` against the *same* spec limits as the nominal measurement. A `detected` verdict means the control's empirical yield is lower **and** its exact (Clopper-Pearson) confidence interval does not overlap the nominal's -- i.e. these statistics demonstrably do detect a degraded design, rather than being assumed to.

## `klt yield` run-level warnings

- no measurement declared a target_yield, so no yield claim was checked -- the estimates below are reported, never failed

## Links

- Sample-set document: [`sim/write-margin/mc/samples/20260921-124804-cf5e975.json`](../samples/20260921-124804-cf5e975.json)
- `klt yield` JSON report: [`sim/write-margin/mc/yield-reports/20260921-124804-cf5e975.json`](../yield-reports/20260921-124804-cf5e975.json)
- `klt yield` text report: [`sim/write-margin/mc/yield-reports/20260921-124804-cf5e975.txt`](../yield-reports/20260921-124804-cf5e975.txt)
- Per-sample raw logs: [`sim/write-margin/mc/raw-logs/20260921-124804-cf5e975`](../raw-logs/20260921-124804-cf5e975)
- Deterministic 27-corner records for the same claim: `sim/write-margin/records/`

## Reproduce

```bash
sim/lib/run_mc_campaign.py \
  --experiment write-margin \
  --testbench sim/write-margin/testbench/tb_write_margin.spice \
  --mode 'direct' --key write_trip_voltage_v \
  --corner ff:-40:2.97 \
  --corner ff:25:3.30 \
  --corner ff:125:2.97 \
  --corner tt:-40:3.63 \
  --corner tt:25:3.30 \
  --corner tt:125:2.97 \
  --corner ss:-40:3.63 \
  --corner ss:25:2.97 \
  --corner ss:125:3.63 \
  --n 200 --n-control 4 --n-nc 100 \
  --nc-mismatch-scale 6 --nc-vdd 0.60 \
  --seed 20260817 \
  --claim "spec/sram.md Characterization -- write margin, as write trip voltage (Monte Carlo device mismatch, combined with the ratified 9-corner PVT matrix)"
```

## `klt yield` text report (verbatim)

```
samples: sim/write-margin/mc/samples/20260921-124804-cf5e975.json
source: sample-set  samples_analyzed: 1800
confidence: 0.95  target_ci_halfwidth: 0.01
status: reported  measurements: 9

write_trip_voltage_v@ff_-40c_2.97v [V]  status: reported  N: 200
  limits: min(>=)=0 max(<=)=- target_yield=-
  fit (normal): mean=1.69603 stddev=0.00725803 normality=consistent
  yield (empirical, clopper-pearson): 1.000000 [0.981725, 1.000000] at 95%, N=200
  yield (normal, normal-delta): 1.000000 [1.000000, 1.000000] at 95%, N=200
  capability: cp=- cpk=77.8920 [70.2394, 85.5445] sigma_to_spec=233.6759 limiting=lower
  sample size: sufficient (N=200, required>=183, observed +/-0.009138 vs target +/-0.01)
  negative control (known-bad variant: sw_stat_mismatch=6 (6x the PDK's per-instance Vt/current-factor mismatch sigma), VDD=0.60 V (below spec/sram.md's ratified 2.97 V minimum)): detected -- yield 0.790000 [0.697085, 0.865056] vs nominal 1.000000, N=100
  warning: measurement 'write_trip_voltage_v@ff_-40c_2.97v': no sample fell outside the limits, so the empirical yield is bounded only from below -- "at least 98.1725% at 95% confidence, N = 200" is the honest statement, not "100% yield"

write_trip_voltage_v@ff_25c_3.30v [V]  status: reported  N: 200
  limits: min(>=)=0 max(<=)=- target_yield=-
  fit (normal): mean=1.87109 stddev=0.00640147 normality=consistent
  yield (empirical, clopper-pearson): 1.000000 [0.981725, 1.000000] at 95%, N=200
  yield (normal, normal-delta): 1.000000 [1.000000, 1.000000] at 95%, N=200
  capability: cp=- cpk=97.4301 [87.8581, 107.0022] sigma_to_spec=292.2904 limiting=lower
  sample size: sufficient (N=200, required>=183, observed +/-0.009138 vs target +/-0.01)
  negative control (known-bad variant: sw_stat_mismatch=6 (6x the PDK's per-instance Vt/current-factor mismatch sigma), VDD=0.60 V (below spec/sram.md's ratified 2.97 V minimum)): detected -- yield 0.828283 [0.739361, 0.896667] vs nominal 1.000000, N=99
  warning: measurement 'write_trip_voltage_v@ff_25c_3.30v': no sample fell outside the limits, so the empirical yield is bounded only from below -- "at least 98.1725% at 95% confidence, N = 200" is the honest statement, not "100% yield"

write_trip_voltage_v@ff_125c_2.97v [V]  status: reported  N: 200
  limits: min(>=)=0 max(<=)=- target_yield=-
  fit (normal): mean=1.63959 stddev=0.0063209 normality=rejected
  yield (empirical, clopper-pearson): 1.000000 [0.981725, 1.000000] at 95%, N=200
  yield (normal, normal-delta): 1.000000 [1.000000, 1.000000] at 95%, N=200
  capability: cp=- cpk=86.4642 [77.9694, 94.9589] sigma_to_spec=259.3925 limiting=lower
  sample size: sufficient (N=200, required>=183, observed +/-0.009138 vs target +/-0.01)
  negative control (known-bad variant: sw_stat_mismatch=6 (6x the PDK's per-instance Vt/current-factor mismatch sigma), VDD=0.60 V (below spec/sram.md's ratified 2.97 V minimum)): detected -- yield 0.867347 [0.783846, 0.927436] vs nominal 1.000000, N=98
  warning: measurement 'write_trip_voltage_v@ff_125c_2.97v': the sample set is not consistent with a normal distribution (Anderson-Darling A2* = 0.8543 > 0.787); treat the parametric yield estimate and Cpk as indicative only and prefer the empirical estimate
  warning: measurement 'write_trip_voltage_v@ff_125c_2.97v': no sample fell outside the limits, so the empirical yield is bounded only from below -- "at least 98.1725% at 95% confidence, N = 200" is the honest statement, not "100% yield"

write_trip_voltage_v@tt_-40c_3.63v [V]  status: reported  N: 200
  limits: min(>=)=0 max(<=)=- target_yield=-
  fit (normal): mean=2.13283 stddev=0.0076442 normality=consistent
  yield (empirical, clopper-pearson): 1.000000 [0.981725, 1.000000] at 95%, N=200
  yield (normal, normal-delta): 1.000000 [1.000000, 1.000000] at 95%, N=200
  capability: cp=- cpk=93.0041 [83.8669, 102.1413] sigma_to_spec=279.0122 limiting=lower
  sample size: sufficient (N=200, required>=183, observed +/-0.009138 vs target +/-0.01)
  negative control (known-bad variant: sw_stat_mismatch=6 (6x the PDK's per-instance Vt/current-factor mismatch sigma), VDD=0.60 V (below spec/sram.md's ratified 2.97 V minimum)): detected -- yield 0.700000 [0.600185, 0.787594] vs nominal 1.000000, N=100
  warning: measurement 'write_trip_voltage_v@tt_-40c_3.63v': no sample fell outside the limits, so the empirical yield is bounded only from below -- "at least 98.1725% at 95% confidence, N = 200" is the honest statement, not "100% yield"

write_trip_voltage_v@tt_25c_3.30v [V]  status: reported  N: 200
  limits: min(>=)=0 max(<=)=- target_yield=-
  fit (normal): mean=1.91095 stddev=0.00636431 normality=consistent
  yield (empirical, clopper-pearson): 1.000000 [0.981725, 1.000000] at 95%, N=200
  yield (normal, normal-delta): 1.000000 [1.000000, 1.000000] at 95%, N=200
  capability: cp=- cpk=100.0868 [90.2537, 109.9198] sigma_to_spec=300.2603 limiting=lower
  sample size: sufficient (N=200, required>=183, observed +/-0.009138 vs target +/-0.01)
  negative control (known-bad variant: sw_stat_mismatch=6 (6x the PDK's per-instance Vt/current-factor mismatch sigma), VDD=0.60 V (below spec/sram.md's ratified 2.97 V minimum)): detected -- yield 0.670213 [0.565615, 0.763752] vs nominal 1.000000, N=94
  warning: measurement 'write_trip_voltage_v@tt_25c_3.30v': no sample fell outside the limits, so the empirical yield is bounded only from below -- "at least 98.1725% at 95% confidence, N = 200" is the honest statement, not "100% yield"

write_trip_voltage_v@tt_125c_2.97v [V]  status: reported  N: 200
  limits: min(>=)=0 max(<=)=- target_yield=-
  fit (normal): mean=1.67766 stddev=0.00489921 normality=consistent
  yield (empirical, clopper-pearson): 1.000000 [0.981725, 1.000000] at 95%, N=200
  yield (normal, normal-delta): 1.000000 [1.000000, 1.000000] at 95%, N=200
  capability: cp=- cpk=114.1449 [102.9308, 125.3591] sigma_to_spec=342.4348 limiting=lower
  sample size: sufficient (N=200, required>=183, observed +/-0.009138 vs target +/-0.01)
  negative control (known-bad variant: sw_stat_mismatch=6 (6x the PDK's per-instance Vt/current-factor mismatch sigma), VDD=0.60 V (below spec/sram.md's ratified 2.97 V minimum)): detected -- yield 0.731959 [0.632416, 0.816849] vs nominal 1.000000, N=97
  warning: measurement 'write_trip_voltage_v@tt_125c_2.97v': no sample fell outside the limits, so the empirical yield is bounded only from below -- "at least 98.1725% at 95% confidence, N = 200" is the honest statement, not "100% yield"

write_trip_voltage_v@ss_-40c_3.63v [V]  status: reported  N: 200
  limits: min(>=)=0 max(<=)=- target_yield=-
  fit (normal): mean=2.17257 stddev=0.00697421 normality=consistent
  yield (empirical, clopper-pearson): 1.000000 [0.981725, 1.000000] at 95%, N=200
  yield (normal, normal-delta): 1.000000 [1.000000, 1.000000] at 95%, N=200
  capability: cp=- cpk=103.8384 [93.6368, 114.0400] sigma_to_spec=311.5152 limiting=lower
  sample size: sufficient (N=200, required>=183, observed +/-0.009138 vs target +/-0.01)
  negative control (known-bad variant: sw_stat_mismatch=6 (6x the PDK's per-instance Vt/current-factor mismatch sigma), VDD=0.60 V (below spec/sram.md's ratified 2.97 V minimum)): detected -- yield 0.480000 [0.379005, 0.582210] vs nominal 1.000000, N=100
  warning: measurement 'write_trip_voltage_v@ss_-40c_3.63v': no sample fell outside the limits, so the empirical yield is bounded only from below -- "at least 98.1725% at 95% confidence, N = 200" is the honest statement, not "100% yield"

write_trip_voltage_v@ss_25c_2.97v [V]  status: reported  N: 200
  limits: min(>=)=0 max(<=)=- target_yield=-
  fit (normal): mean=1.74226 stddev=0.00546601 normality=consistent
  yield (empirical, clopper-pearson): 1.000000 [0.981725, 1.000000] at 95%, N=200
  yield (normal, normal-delta): 1.000000 [1.000000, 1.000000] at 95%, N=200
  capability: cp=- cpk=106.2479 [95.8096, 116.6862] sigma_to_spec=318.7437 limiting=lower
  sample size: sufficient (N=200, required>=183, observed +/-0.009138 vs target +/-0.01)
  negative control (known-bad variant: sw_stat_mismatch=6 (6x the PDK's per-instance Vt/current-factor mismatch sigma), VDD=0.60 V (below spec/sram.md's ratified 2.97 V minimum)): detected -- yield 0.500000 [0.396178, 0.603822] vs nominal 1.000000, N=96
  warning: measurement 'write_trip_voltage_v@ss_25c_2.97v': no sample fell outside the limits, so the empirical yield is bounded only from below -- "at least 98.1725% at 95% confidence, N = 200" is the honest statement, not "100% yield"

write_trip_voltage_v@ss_125c_3.63v [V]  status: reported  N: 200
  limits: min(>=)=0 max(<=)=- target_yield=-
  fit (normal): mean=2.10919 stddev=0.00524258 normality=consistent
  yield (empirical, clopper-pearson): 1.000000 [0.981725, 1.000000] at 95%, N=200
  yield (normal, normal-delta): 1.000000 [1.000000, 1.000000] at 95%, N=200
  capability: cp=- cpk=134.1062 [120.9310, 147.2814] sigma_to_spec=402.3186 limiting=lower
  sample size: sufficient (N=200, required>=183, observed +/-0.009138 vs target +/-0.01)
  negative control (known-bad variant: sw_stat_mismatch=6 (6x the PDK's per-instance Vt/current-factor mismatch sigma), VDD=0.60 V (below spec/sram.md's ratified 2.97 V minimum)): detected -- yield 0.753086 [0.644740, 0.842191] vs nominal 1.000000, N=81
  warning: measurement 'write_trip_voltage_v@ss_125c_3.63v': no sample fell outside the limits, so the empirical yield is bounded only from below -- "at least 98.1725% at 95% confidence, N = 200" is the honest statement, not "100% yield"

warnings:
  no measurement declared a target_yield, so no yield claim was checked -- the estimates below are reported, never failed
```
