2AMLogic/gf180-sram/sim/pex/write-margin/delta/20260822-093425-fc6ce30_vs_20260822-093435-fc6ce30.md

# Write-margin by-hand PEX delta: 20260822-093425-fc6ce30 (schematic) vs 20260822-093435-fc6ce30 (extracted)

Issue #95 -- by-hand replication of `klt pex`'s schematic-vs-extracted
delta report shape (docs/cli/pex.md `delta[]`), since `klt pex` cannot run
write-margin's bisection-search testbench itself (see ../README.md).

| corner_id | schematic write_trip_voltage_v | extracted write_trip_voltage_v | delta_pct | status |
| --- | --- | --- | --- | --- |
| ff_-40c_2.97v | 1.69564 | 1.67733 | -1.080 | pass |
| ff_-40c_3.30v | 1.89150 | 1.86632 | -1.331 | pass |
| ff_-40c_3.63v | 2.08796 | 2.05517 | -1.570 | pass |
| ff_25c_2.97v | 1.67298 | 1.66102 | -0.715 | pass |
| ff_25c_3.30v | 1.87075 | 1.85081 | -1.066 | pass |
| ff_25c_3.63v | 2.06891 | 2.04032 | -1.382 | pass |
| ff_125c_2.97v | 1.64053 | 1.63655 | -0.243 | pass |
| ff_125c_3.30v | 1.83812 | 1.82584 | -0.668 | pass |
| ff_125c_3.63v | 2.03611 | 2.01484 | -1.045 | pass |
| tt_-40c_2.97v | 1.73824 | 1.70507 | -1.908 | pass |
| tt_-40c_3.30v | 1.93581 | 1.89573 | -2.070 | pass |
| tt_-40c_3.63v | 2.13271 | 2.08619 | -2.181 | pass |
| tt_25c_2.97v | 1.71105 | 1.68585 | -1.473 | pass |
| tt_25c_3.30v | 1.91003 | 1.87780 | -1.687 | pass |
| tt_25c_3.63v | 2.10923 | 2.06957 | -1.880 | pass |
| tt_125c_2.97v | 1.67751 | 1.66084 | -0.994 | pass |
| tt_125c_3.30v | 1.87740 | 1.85363 | -1.266 | pass |
| tt_125c_3.63v | 2.07777 | 2.04564 | -1.546 | pass |
| ss_-40c_2.97v | 1.76978 | 1.71903 | -2.868 | pass |
| ss_-40c_3.30v | 1.97267 | 1.91970 | -2.685 | pass |
| ss_-40c_3.63v | 2.17259 | 2.11255 | -2.764 | pass |
| ss_25c_2.97v | 1.74241 | 1.69909 | -2.486 | pass |
| ss_25c_3.30v | 1.94387 | 1.89875 | -2.321 | pass |
| ss_25c_3.63v | 2.14423 | 2.09261 | -2.407 | pass |
| ss_125c_2.97v | 1.70634 | 1.67171 | -2.029 | pass |
| ss_125c_3.30v | 1.90822 | 1.87156 | -1.921 | pass |
| ss_125c_3.63v | 2.10967 | 2.06713 | -2.016 | pass |

All 27 corners produced a paired schematic/extracted value -- non-vacuous, per-corner delta.

- Schematic record: `sim/pex/write-margin/records/20260822-093425-fc6ce30.md`
- Extracted record: `sim/pex/write-margin/records/20260822-093435-fc6ce30.md`
