2AMLogic/gf180-sram/sim/pex/write-margin/records/20260822-093425-fc6ce30.md

# Record 20260822-093425-fc6ce30

- **Record ID**: 20260822-093425-fc6ce30
- **Claim**: spec/sram.md Characterization -- write margin (write trip voltage), post-layout PEX by-hand workflow (issue #95), SCHEMATIC leg
- **Netlist provenance**: schematic (`sim/pex/write-margin/testbench/tb_write_margin_schematic.spice`, DUT per `design/netlist/bitcell_6t.spice` at `fc6ce30`)
- **Corner matrix run**:
  - Process: ff tt ss
  - Temperature: -40 25 125 C
  - Supply: 2.97 3.30 3.63 V
  - (27 corner points total -- full process x temp x supply matrix, per spec/sram.md's ratified corner set)
- **Statistical convention**: N/A (corner-matrix claim, not a distribution claim)
- **Result**:
  - **ff_-40c_2.97v**: RESULT: write_trip_voltage_v = 1.69564;RESULT: write_vdd_v = 2.97;
  - **ff_-40c_3.30v**: RESULT: write_trip_voltage_v = 1.8915;RESULT: write_vdd_v = 3.3;
  - **ff_-40c_3.63v**: RESULT: write_trip_voltage_v = 2.08796;RESULT: write_vdd_v = 3.63;
  - **ff_25c_2.97v**: RESULT: write_trip_voltage_v = 1.67298;RESULT: write_vdd_v = 2.97;
  - **ff_25c_3.30v**: RESULT: write_trip_voltage_v = 1.87075;RESULT: write_vdd_v = 3.3;
  - **ff_25c_3.63v**: RESULT: write_trip_voltage_v = 2.06891;RESULT: write_vdd_v = 3.63;
  - **ff_125c_2.97v**: RESULT: write_trip_voltage_v = 1.64053;RESULT: write_vdd_v = 2.97;
  - **ff_125c_3.30v**: RESULT: write_trip_voltage_v = 1.83812;RESULT: write_vdd_v = 3.3;
  - **ff_125c_3.63v**: RESULT: write_trip_voltage_v = 2.03611;RESULT: write_vdd_v = 3.63;
  - **tt_-40c_2.97v**: RESULT: write_trip_voltage_v = 1.73824;RESULT: write_vdd_v = 2.97;
  - **tt_-40c_3.30v**: RESULT: write_trip_voltage_v = 1.93581;RESULT: write_vdd_v = 3.3;
  - **tt_-40c_3.63v**: RESULT: write_trip_voltage_v = 2.13271;RESULT: write_vdd_v = 3.63;
  - **tt_25c_2.97v**: RESULT: write_trip_voltage_v = 1.71105;RESULT: write_vdd_v = 2.97;
  - **tt_25c_3.30v**: RESULT: write_trip_voltage_v = 1.91003;RESULT: write_vdd_v = 3.3;
  - **tt_25c_3.63v**: RESULT: write_trip_voltage_v = 2.10923;RESULT: write_vdd_v = 3.63;
  - **tt_125c_2.97v**: RESULT: write_trip_voltage_v = 1.67751;RESULT: write_vdd_v = 2.97;
  - **tt_125c_3.30v**: RESULT: write_trip_voltage_v = 1.8774;RESULT: write_vdd_v = 3.3;
  - **tt_125c_3.63v**: RESULT: write_trip_voltage_v = 2.07777;RESULT: write_vdd_v = 3.63;
  - **ss_-40c_2.97v**: RESULT: write_trip_voltage_v = 1.76978;RESULT: write_vdd_v = 2.97;
  - **ss_-40c_3.30v**: RESULT: write_trip_voltage_v = 1.97267;RESULT: write_vdd_v = 3.3;
  - **ss_-40c_3.63v**: RESULT: write_trip_voltage_v = 2.17259;RESULT: write_vdd_v = 3.63;
  - **ss_25c_2.97v**: RESULT: write_trip_voltage_v = 1.74241;RESULT: write_vdd_v = 2.97;
  - **ss_25c_3.30v**: RESULT: write_trip_voltage_v = 1.94387;RESULT: write_vdd_v = 3.3;
  - **ss_25c_3.63v**: RESULT: write_trip_voltage_v = 2.14423;RESULT: write_vdd_v = 3.63;
  - **ss_125c_2.97v**: RESULT: write_trip_voltage_v = 1.70634;RESULT: write_vdd_v = 2.97;
  - **ss_125c_3.30v**: RESULT: write_trip_voltage_v = 1.90822;RESULT: write_vdd_v = 3.3;
  - **ss_125c_3.63v**: RESULT: write_trip_voltage_v = 2.10967;RESULT: write_vdd_v = 3.63;
  - **Overall: recorded** -- all 27 corners produced a measured result; see sim/README.md for how to interpret sign-off against spec/sram.md's positive-margin requirement.
- **Links**:
  - Testbench: `sim/pex/write-margin/testbench/tb_write_margin_schematic.spice`
  - Netlist snapshot: `sim/pex/write-margin/netlist-snapshots/20260822-093425-fc6ce30.spice`
  - Raw logs: `sim/pex/write-margin/corners/20260822-093425-fc6ce30/`
- **Timestamp / author**: 2026-08-22T09:34:35Z, agent-builder
- **Supersedes**: (none -- first record for this claim)
