2AMLogic/gf180-sram/sim/pex/write-margin/records/20260822-093435-fc6ce30.md

# Record 20260822-093435-fc6ce30

- **Record ID**: 20260822-093435-fc6ce30
- **Claim**: spec/sram.md Characterization -- write margin (write trip voltage), post-layout PEX by-hand workflow (issue #95), EXTRACTED leg
- **Netlist provenance**: schematic (`sim/pex/write-margin/testbench/tb_write_margin_extracted.spice`, DUT per `design/netlist/bitcell_6t.spice` at `fc6ce30`)
- **Corner matrix run**:
  - Process: ff tt ss
  - Temperature: -40 25 125 C
  - Supply: 2.97 3.30 3.63 V
  - (27 corner points total -- full process x temp x supply matrix, per spec/sram.md's ratified corner set)
- **Statistical convention**: N/A (corner-matrix claim, not a distribution claim)
- **Result**:
  - **ff_-40c_2.97v**: RESULT: write_trip_voltage_v = 1.67733;RESULT: write_vdd_v = 2.97;
  - **ff_-40c_3.30v**: RESULT: write_trip_voltage_v = 1.86632;RESULT: write_vdd_v = 3.3;
  - **ff_-40c_3.63v**: RESULT: write_trip_voltage_v = 2.05517;RESULT: write_vdd_v = 3.63;
  - **ff_25c_2.97v**: RESULT: write_trip_voltage_v = 1.66102;RESULT: write_vdd_v = 2.97;
  - **ff_25c_3.30v**: RESULT: write_trip_voltage_v = 1.85081;RESULT: write_vdd_v = 3.3;
  - **ff_25c_3.63v**: RESULT: write_trip_voltage_v = 2.04032;RESULT: write_vdd_v = 3.63;
  - **ff_125c_2.97v**: RESULT: write_trip_voltage_v = 1.63655;RESULT: write_vdd_v = 2.97;
  - **ff_125c_3.30v**: RESULT: write_trip_voltage_v = 1.82584;RESULT: write_vdd_v = 3.3;
  - **ff_125c_3.63v**: RESULT: write_trip_voltage_v = 2.01484;RESULT: write_vdd_v = 3.63;
  - **tt_-40c_2.97v**: RESULT: write_trip_voltage_v = 1.70507;RESULT: write_vdd_v = 2.97;
  - **tt_-40c_3.30v**: RESULT: write_trip_voltage_v = 1.89573;RESULT: write_vdd_v = 3.3;
  - **tt_-40c_3.63v**: RESULT: write_trip_voltage_v = 2.08619;RESULT: write_vdd_v = 3.63;
  - **tt_25c_2.97v**: RESULT: write_trip_voltage_v = 1.68585;RESULT: write_vdd_v = 2.97;
  - **tt_25c_3.30v**: RESULT: write_trip_voltage_v = 1.8778;RESULT: write_vdd_v = 3.3;
  - **tt_25c_3.63v**: RESULT: write_trip_voltage_v = 2.06957;RESULT: write_vdd_v = 3.63;
  - **tt_125c_2.97v**: RESULT: write_trip_voltage_v = 1.66084;RESULT: write_vdd_v = 2.97;
  - **tt_125c_3.30v**: RESULT: write_trip_voltage_v = 1.85363;RESULT: write_vdd_v = 3.3;
  - **tt_125c_3.63v**: RESULT: write_trip_voltage_v = 2.04564;RESULT: write_vdd_v = 3.63;
  - **ss_-40c_2.97v**: RESULT: write_trip_voltage_v = 1.71903;RESULT: write_vdd_v = 2.97;
  - **ss_-40c_3.30v**: RESULT: write_trip_voltage_v = 1.9197;RESULT: write_vdd_v = 3.3;
  - **ss_-40c_3.63v**: RESULT: write_trip_voltage_v = 2.11255;RESULT: write_vdd_v = 3.63;
  - **ss_25c_2.97v**: RESULT: write_trip_voltage_v = 1.69909;RESULT: write_vdd_v = 2.97;
  - **ss_25c_3.30v**: RESULT: write_trip_voltage_v = 1.89875;RESULT: write_vdd_v = 3.3;
  - **ss_25c_3.63v**: RESULT: write_trip_voltage_v = 2.09261;RESULT: write_vdd_v = 3.63;
  - **ss_125c_2.97v**: RESULT: write_trip_voltage_v = 1.67171;RESULT: write_vdd_v = 2.97;
  - **ss_125c_3.30v**: RESULT: write_trip_voltage_v = 1.87156;RESULT: write_vdd_v = 3.3;
  - **ss_125c_3.63v**: RESULT: write_trip_voltage_v = 2.06713;RESULT: write_vdd_v = 3.63;
  - **Overall: recorded** -- all 27 corners produced a measured result; see sim/README.md for how to interpret sign-off against spec/sram.md's positive-margin requirement.
- **Links**:
  - Testbench: `sim/pex/write-margin/testbench/tb_write_margin_extracted.spice`
  - Netlist snapshot: `sim/pex/write-margin/netlist-snapshots/20260822-093435-fc6ce30.spice`
  - Raw logs: `sim/pex/write-margin/corners/20260822-093435-fc6ce30/`
- **Timestamp / author**: 2026-08-22T09:34:45Z, agent-builder
- **Supersedes**: (none -- first record for this claim)
