2AMLogic/gf180-sram/sim/pex/write-margin/delta/20260821-085734-b56cc29_vs_20260821-085745-b56cc29.md

# Write-margin by-hand PEX delta: 20260821-085734-b56cc29 (schematic) vs 20260821-085745-b56cc29 (extracted)

Issue #95 -- by-hand replication of `klt pex`'s schematic-vs-extracted
delta report shape (docs/cli/pex.md `delta[]`), since `klt pex` cannot run
write-margin's bisection-search testbench itself (see ../README.md).

| corner_id | schematic write_trip_voltage_v | extracted write_trip_voltage_v | delta_pct | status |
| --- | --- | --- | --- | --- |
| ff_-40c_2.97v | 1.69564 | 1.67788 | -1.047 | pass |
| ff_-40c_3.30v | 1.89150 | 1.86693 | -1.299 | pass |
| ff_-40c_3.63v | 2.08796 | 2.05605 | -1.528 | pass |
| ff_25c_2.97v | 1.67298 | 1.66138 | -0.693 | pass |
| ff_25c_3.30v | 1.87075 | 1.85121 | -1.045 | pass |
| ff_25c_3.63v | 2.06891 | 2.04099 | -1.350 | pass |
| ff_125c_2.97v | 1.64053 | 1.63655 | -0.243 | pass |
| ff_125c_3.30v | 1.83812 | 1.82604 | -0.657 | pass |
| ff_125c_3.63v | 2.03611 | 2.01507 | -1.033 | pass |
| tt_-40c_2.97v | 1.73824 | 1.70579 | -1.867 | pass |
| tt_-40c_3.30v | 1.93581 | 1.89673 | -2.019 | pass |
| tt_-40c_3.63v | 2.13271 | 2.08707 | -2.140 | pass |
| tt_25c_2.97v | 1.71105 | 1.68621 | -1.452 | pass |
| tt_25c_3.30v | 1.91003 | 1.87841 | -1.655 | pass |
| tt_25c_3.63v | 2.10923 | 2.07046 | -1.838 | pass |
| tt_125c_2.97v | 1.67751 | 1.66120 | -0.972 | pass |
| tt_125c_3.30v | 1.87740 | 1.85403 | -1.245 | pass |
| tt_125c_3.63v | 2.07777 | 2.04608 | -1.525 | pass |
| ss_-40c_2.97v | 1.76978 | 1.72011 | -2.807 | pass |
| ss_-40c_3.30v | 1.97267 | 1.92070 | -2.635 | pass |
| ss_-40c_3.63v | 2.17259 | 2.11366 | -2.712 | pass |
| ss_25c_2.97v | 1.74241 | 1.70017 | -2.424 | pass |
| ss_25c_3.30v | 1.94387 | 1.89955 | -2.280 | pass |
| ss_25c_3.63v | 2.14423 | 2.09350 | -2.366 | pass |
| ss_125c_2.97v | 1.70634 | 1.67244 | -1.987 | pass |
| ss_125c_3.30v | 1.90822 | 1.87236 | -1.879 | pass |
| ss_125c_3.63v | 2.10967 | 2.06780 | -1.985 | pass |

All 27 corners produced a paired schematic/extracted value -- non-vacuous, per-corner delta.

- Schematic record: `sim/pex/write-margin/records/20260821-085734-b56cc29.md`
- Extracted record: `sim/pex/write-margin/records/20260821-085745-b56cc29.md`
