2AMLogic/gf180-sram/sim/hold-snm/mc/records/20260817-103316-ce56f59.md

# MC/yield record `20260817-103316-ce56f59`

- **Record ID**: `20260817-103316-ce56f59`
- **Kind**: Monte Carlo mismatch campaign + `klt yield` report (statistical evidence, klayout-tools `docs/design-evidence-tiers.md` item 6)
- **Claim**: spec/sram.md Characterization -- hold SNM (Monte Carlo device mismatch, combined with the ratified 9-corner PVT matrix)
- **Testbench**: `sim/hold-snm/testbench/tb_hold_snm.spice`
- **Netlist provenance**: schematic (this repo has not yet produced an extracted netlist; a post-layout re-run would record `extracted` here and reference this record via **Supersedes**)
- **Corner matrix run**: 9 corner points from `spec/sram.md`'s ratified process x temperature x voltage set (`ff_-40c_2.97v`, `ff_25c_3.30v`, `ff_125c_2.97v`, `tt_-40c_3.63v`, `tt_25c_3.30v`, `tt_125c_2.97v`, `ss_-40c_3.63v`, `ss_25c_2.97v`, `ss_125c_3.63v`) -- a deliberate Monte Carlo subset, chosen per `sim/README.md` "Which corners, and why not all of them". MC results **combine with**, and never replace, the deterministic corner records under `sim/hold-snm/records/`, which sweep that set exhaustively.
- **Statistical convention**: Monte Carlo, per-instance device mismatch only (`sw_stat_mismatch=1`; `delvto='mis_vth*sw_stat_mismatch' / mulu0='1-mis_k*sw_stat_mismatch' per nfet_03v3/pfet_03v3 instance`). Global/process variation is carried by the corner axis, not resampled -- so each corner is its own population and no estimate is pooled across corners.
- **Seed**: `20260817` (base). Per-sample seed = sha256(base_seed:corner_id:kind:sample_index), truncated to a positive 31-bit integer; delivered to ngspice as `.options seed=<derived>, one independent ngspice invocation per sample`.
- **Sample count**: 200 mismatch samples per corner, 4 determinism-control samples per corner, 100 negative-control samples per corner.
- **Spec limits**: `min = 0.0` V -- spec/sram.md 'Characterization' -- read SNM / hold SNM / write margin must be strictly positive at every corner. No `target_yield` is declared: `spec/sram.md` ratifies no yield target for these rows (that is exactly the open operator decision tracked as issue #20), and this harness does not invent one. The estimates below are therefore *reported* against the spec's own `> 0` limit, with Cpk / sigma-to-spec as the quantitative margin statement.
- **PDK**: `/Users/rwalters/.volare/gf180mcuC` -- **`klt`**: `klt 0.2.0` -- **git**: `ce56f59`
- **`klt yield` overall status**: `reported` (exit code 0)
- **Timestamp / author**: 2026-08-17T10:41:15Z / agent-builder
- **Supersedes**: (none)

## Per-corner result (verbatim from the `klt yield` JSON report)

| Corner | N | errored | mean (V) | stddev (V) | empirical yield, 95% lower bound | Cpk | sigma-to-spec | sample-size verdict | negative control |
|---|---|---|---|---|---|---|---|---|---|
| `ff_-40c_2.97v` | 200 | 0 | 0.998997 | 0.0178261 | 0.981725 | 18.6804 | 56.0413 | sufficient | detected |
| `ff_25c_3.30v` | 200 | 0 | 1.04812 | 0.0177677 | 0.981725 | 19.6634 | 58.9902 | sufficient | detected |
| `ff_125c_2.97v` | 200 | 0 | 0.93145 | 0.0169802 | 0.981725 | 18.285 | 54.855 | sufficient | detected |
| `tt_-40c_3.63v` | 200 | 0 | 1.21205 | 0.0191129 | 0.981725 | 21.1385 | 63.4154 | sufficient | detected |
| `tt_25c_3.30v` | 200 | 0 | 1.10934 | 0.0190101 | 0.981725 | 19.4517 | 58.3551 | sufficient | detected |
| `tt_125c_2.97v` | 200 | 0 | 0.994414 | 0.0177065 | 0.981725 | 18.7203 | 56.1609 | sufficient | detected |
| `ss_-40c_3.63v` | 200 | 0 | 1.26779 | 0.0184793 | 0.981725 | 22.8687 | 68.6061 | sufficient | detected |
| `ss_25c_2.97v` | 200 | 0 | 1.08133 | 0.0159573 | 0.981725 | 22.588 | 67.7639 | sufficient | detected |
| `ss_125c_3.63v` | 200 | 0 | 1.21561 | 0.0182949 | 0.981725 | 22.1484 | 66.4452 | sufficient | detected |

`errored` counts draws that produced no usable measurement (for the SNM fixtures: a draw whose butterfly was not bistable, so no square exists to measure). `klt yield` excludes them from every statistic, so a record with a non-zero `errored` column states a yield estimate *conditioned on a measurable draw* -- read the errored count alongside it, never the yield alone.

## Determinism control (mismatch off)

With `sw_stat_mismatch=0` the campaign must reproduce, exactly and identically for every draw, the number the deterministic corner sweep already recorded for the same corner. This is what ties the MC evidence to the ratified 9-corner evidence rather than leaving it a parallel, unanchored claim.

| Corner | N | errored | distinct value(s) (V) | verdict |
|---|---|---|---|---|
| `ff_-40c_2.97v` | 4 | 0 | 0.999014 | PINNED |
| `ff_25c_3.30v` | 4 | 0 | 1.04859 | PINNED |
| `ff_125c_2.97v` | 4 | 0 | 0.930461 | PINNED |
| `tt_-40c_3.63v` | 4 | 0 | 1.21357 | PINNED |
| `tt_25c_3.30v` | 4 | 0 | 1.11081 | PINNED |
| `tt_125c_2.97v` | 4 | 0 | 0.993408 | PINNED |
| `ss_-40c_3.63v` | 4 | 0 | 1.26881 | PINNED |
| `ss_25c_2.97v` | 4 | 0 | 1.08238 | PINNED |
| `ss_125c_3.63v` | 4 | 0 | 1.21645 | PINNED |

## Negative control

Deliberate defect: **known-bad variant: supply collapsed to 0.50 V, far below spec/sram.md's ratified 2.97 V minimum and below this cell's data-retention voltage (the physical hold-stability failure mechanism), with per-instance mismatch drawn at 12x the PDK's own sigma**, drawn with its own independent, reproducibly-derived seeds and analysed by `klt yield` against the *same* spec limits as the nominal measurement. A `detected` verdict means the control's empirical yield is lower **and** its exact (Clopper-Pearson) confidence interval does not overlap the nominal's -- i.e. these statistics demonstrably do detect a degraded design, rather than being assumed to.

## `klt yield` run-level warnings

- no measurement declared a target_yield, so no yield claim was checked -- the estimates below are reported, never failed

## Links

- Sample-set document: [`sim/hold-snm/mc/samples/20260817-103316-ce56f59.json`](../samples/20260817-103316-ce56f59.json)
- `klt yield` JSON report: [`sim/hold-snm/mc/yield-reports/20260817-103316-ce56f59.json`](../yield-reports/20260817-103316-ce56f59.json)
- `klt yield` text report: [`sim/hold-snm/mc/yield-reports/20260817-103316-ce56f59.txt`](../yield-reports/20260817-103316-ce56f59.txt)
- Per-sample raw logs: [`sim/hold-snm/mc/raw-logs/20260817-103316-ce56f59`](../raw-logs/20260817-103316-ce56f59)
- Deterministic 9-corner records for the same claim: `sim/hold-snm/records/`

## Reproduce

```bash
sim/lib/run_mc_campaign.py \
  --experiment hold-snm \
  --testbench sim/hold-snm/testbench/tb_hold_snm.spice \
  --mode 'snm-pair:hold_snm_sweep.txt:hold_snm' --key hold_snm_v \
  --corner ff:-40:2.97 \
  --corner ff:25:3.30 \
  --corner ff:125:2.97 \
  --corner tt:-40:3.63 \
  --corner tt:25:3.30 \
  --corner tt:125:2.97 \
  --corner ss:-40:3.63 \
  --corner ss:25:2.97 \
  --corner ss:125:3.63 \
  --n 200 --n-control 4 --n-nc 100 \
  --nc-mismatch-scale 12 --nc-vdd 0.50 \
  --seed 20260817 \
  --claim "spec/sram.md Characterization -- hold SNM (Monte Carlo device mismatch, combined with the ratified 9-corner PVT matrix)"
```

## `klt yield` text report (verbatim)

```
samples: /Users/rwalters/GitHub/gf180-sram/.loom/worktrees/issue-26/sim/hold-snm/mc/samples/20260817-103316-ce56f59.json
source: sample-set  samples_analyzed: 1800
confidence: 0.95  target_ci_halfwidth: 0.01
status: reported  measurements: 9

hold_snm_v@ff_-40c_2.97v [V]  status: reported  N: 200
  limits: min=0 max=- target_yield=-
  fit (normal): mean=0.998997 stddev=0.0178261 normality=consistent
  yield (empirical, clopper-pearson): 1.000000 [0.981725, 1.000000] at 95%, N=200
  yield (normal, normal-delta): 1.000000 [1.000000, 1.000000] at 95%, N=200
  capability: cp=- cpk=18.6804 [16.8446, 20.5163] sigma_to_spec=56.0413 limiting=lower
  sample size: sufficient (N=200, required>=183, observed +/-0.009138 vs target +/-0.01)
  negative control (known-bad variant: supply collapsed to 0.50 V, far below spec/sram.md's ratified 2.97 V minimum and below this cell's data-retention voltage (the physical hold-stability failure mechanism), with per-instance mismatch drawn at 12x the PDK's own sigma): detected -- yield 0.540000 [0.437412, 0.640157] vs nominal 1.000000, N=100
  warning: measurement 'hold_snm_v@ff_-40c_2.97v': no sample fell outside the limits, so the empirical yield is bounded only from below -- "at least 98.1725% at 95% confidence, N = 200" is the honest statement, not "100% yield"

hold_snm_v@ff_25c_3.30v [V]  status: reported  N: 200
  limits: min=0 max=- target_yield=-
  fit (normal): mean=1.04812 stddev=0.0177677 normality=consistent
  yield (empirical, clopper-pearson): 1.000000 [0.981725, 1.000000] at 95%, N=200
  yield (normal, normal-delta): 1.000000 [1.000000, 1.000000] at 95%, N=200
  capability: cp=- cpk=19.6634 [17.7310, 21.5958] sigma_to_spec=58.9902 limiting=lower
  sample size: sufficient (N=200, required>=183, observed +/-0.009138 vs target +/-0.01)
  negative control (known-bad variant: supply collapsed to 0.50 V, far below spec/sram.md's ratified 2.97 V minimum and below this cell's data-retention voltage (the physical hold-stability failure mechanism), with per-instance mismatch drawn at 12x the PDK's own sigma): detected -- yield 0.520000 [0.417790, 0.620995] vs nominal 1.000000, N=100
  warning: measurement 'hold_snm_v@ff_25c_3.30v': no sample fell outside the limits, so the empirical yield is bounded only from below -- "at least 98.1725% at 95% confidence, N = 200" is the honest statement, not "100% yield"

hold_snm_v@ff_125c_2.97v [V]  status: reported  N: 200
  limits: min=0 max=- target_yield=-
  fit (normal): mean=0.93145 stddev=0.0169802 normality=consistent
  yield (empirical, clopper-pearson): 1.000000 [0.981725, 1.000000] at 95%, N=200
  yield (normal, normal-delta): 1.000000 [1.000000, 1.000000] at 95%, N=200
  capability: cp=- cpk=18.2850 [16.4880, 20.0820] sigma_to_spec=54.8550 limiting=lower
  sample size: sufficient (N=200, required>=183, observed +/-0.009138 vs target +/-0.01)
  negative control (known-bad variant: supply collapsed to 0.50 V, far below spec/sram.md's ratified 2.97 V minimum and below this cell's data-retention voltage (the physical hold-stability failure mechanism), with per-instance mismatch drawn at 12x the PDK's own sigma): detected -- yield 0.580000 [0.477119, 0.678014] vs nominal 1.000000, N=100
  warning: measurement 'hold_snm_v@ff_125c_2.97v': no sample fell outside the limits, so the empirical yield is bounded only from below -- "at least 98.1725% at 95% confidence, N = 200" is the honest statement, not "100% yield"

hold_snm_v@tt_-40c_3.63v [V]  status: reported  N: 200
  limits: min=0 max=- target_yield=-
  fit (normal): mean=1.21205 stddev=0.0191129 normality=consistent
  yield (empirical, clopper-pearson): 1.000000 [0.981725, 1.000000] at 95%, N=200
  yield (normal, normal-delta): 1.000000 [1.000000, 1.000000] at 95%, N=200
  capability: cp=- cpk=21.1385 [19.0612, 23.2157] sigma_to_spec=63.4154 limiting=lower
  sample size: sufficient (N=200, required>=183, observed +/-0.009138 vs target +/-0.01)
  negative control (known-bad variant: supply collapsed to 0.50 V, far below spec/sram.md's ratified 2.97 V minimum and below this cell's data-retention voltage (the physical hold-stability failure mechanism), with per-instance mismatch drawn at 12x the PDK's own sigma): detected -- yield 0.380000 [0.284767, 0.482539] vs nominal 1.000000, N=100
  warning: measurement 'hold_snm_v@tt_-40c_3.63v': no sample fell outside the limits, so the empirical yield is bounded only from below -- "at least 98.1725% at 95% confidence, N = 200" is the honest statement, not "100% yield"

hold_snm_v@tt_25c_3.30v [V]  status: reported  N: 200
  limits: min=0 max=- target_yield=-
  fit (normal): mean=1.10934 stddev=0.0190101 normality=consistent
  yield (empirical, clopper-pearson): 1.000000 [0.981725, 1.000000] at 95%, N=200
  yield (normal, normal-delta): 1.000000 [1.000000, 1.000000] at 95%, N=200
  capability: cp=- cpk=19.4517 [17.5401, 21.3633] sigma_to_spec=58.3551 limiting=lower
  sample size: sufficient (N=200, required>=183, observed +/-0.009138 vs target +/-0.01)
  negative control (known-bad variant: supply collapsed to 0.50 V, far below spec/sram.md's ratified 2.97 V minimum and below this cell's data-retention voltage (the physical hold-stability failure mechanism), with per-instance mismatch drawn at 12x the PDK's own sigma): detected -- yield 0.440000 [0.340836, 0.542813] vs nominal 1.000000, N=100
  warning: measurement 'hold_snm_v@tt_25c_3.30v': no sample fell outside the limits, so the empirical yield is bounded only from below -- "at least 98.1725% at 95% confidence, N = 200" is the honest statement, not "100% yield"

hold_snm_v@tt_125c_2.97v [V]  status: reported  N: 200
  limits: min=0 max=- target_yield=-
  fit (normal): mean=0.994414 stddev=0.0177065 normality=consistent
  yield (empirical, clopper-pearson): 1.000000 [0.981725, 1.000000] at 95%, N=200
  yield (normal, normal-delta): 1.000000 [1.000000, 1.000000] at 95%, N=200
  capability: cp=- cpk=18.7203 [16.8806, 20.5601] sigma_to_spec=56.1609 limiting=lower
  sample size: sufficient (N=200, required>=183, observed +/-0.009138 vs target +/-0.01)
  negative control (known-bad variant: supply collapsed to 0.50 V, far below spec/sram.md's ratified 2.97 V minimum and below this cell's data-retention voltage (the physical hold-stability failure mechanism), with per-instance mismatch drawn at 12x the PDK's own sigma): detected -- yield 0.470000 [0.369405, 0.572419] vs nominal 1.000000, N=100
  warning: measurement 'hold_snm_v@tt_125c_2.97v': no sample fell outside the limits, so the empirical yield is bounded only from below -- "at least 98.1725% at 95% confidence, N = 200" is the honest statement, not "100% yield"

hold_snm_v@ss_-40c_3.63v [V]  status: reported  N: 200
  limits: min=0 max=- target_yield=-
  fit (normal): mean=1.26779 stddev=0.0184793 normality=consistent
  yield (empirical, clopper-pearson): 1.000000 [0.981725, 1.000000] at 95%, N=200
  yield (normal, normal-delta): 1.000000 [1.000000, 1.000000] at 95%, N=200
  capability: cp=- cpk=22.8687 [20.6215, 25.1159] sigma_to_spec=68.6061 limiting=lower
  sample size: sufficient (N=200, required>=183, observed +/-0.009138 vs target +/-0.01)
  negative control (known-bad variant: supply collapsed to 0.50 V, far below spec/sram.md's ratified 2.97 V minimum and below this cell's data-retention voltage (the physical hold-stability failure mechanism), with per-instance mismatch drawn at 12x the PDK's own sigma): detected -- yield 0.200000 [0.126656, 0.291843] vs nominal 1.000000, N=100
  warning: measurement 'hold_snm_v@ss_-40c_3.63v': no sample fell outside the limits, so the empirical yield is bounded only from below -- "at least 98.1725% at 95% confidence, N = 200" is the honest statement, not "100% yield"

hold_snm_v@ss_25c_2.97v [V]  status: reported  N: 200
  limits: min=0 max=- target_yield=-
  fit (normal): mean=1.08133 stddev=0.0159573 normality=consistent
  yield (empirical, clopper-pearson): 1.000000 [0.981725, 1.000000] at 95%, N=200
  yield (normal, normal-delta): 1.000000 [1.000000, 1.000000] at 95%, N=200
  capability: cp=- cpk=22.5880 [20.3683, 24.8076] sigma_to_spec=67.7639 limiting=lower
  sample size: sufficient (N=200, required>=183, observed +/-0.009138 vs target +/-0.01)
  negative control (known-bad variant: supply collapsed to 0.50 V, far below spec/sram.md's ratified 2.97 V minimum and below this cell's data-retention voltage (the physical hold-stability failure mechanism), with per-instance mismatch drawn at 12x the PDK's own sigma): detected -- yield 0.440000 [0.340836, 0.542813] vs nominal 1.000000, N=100
  warning: measurement 'hold_snm_v@ss_25c_2.97v': no sample fell outside the limits, so the empirical yield is bounded only from below -- "at least 98.1725% at 95% confidence, N = 200" is the honest statement, not "100% yield"

hold_snm_v@ss_125c_3.63v [V]  status: reported  N: 200
  limits: min=0 max=- target_yield=-
  fit (normal): mean=1.21561 stddev=0.0182949 normality=consistent
  yield (empirical, clopper-pearson): 1.000000 [0.981725, 1.000000] at 95%, N=200
  yield (normal, normal-delta): 1.000000 [1.000000, 1.000000] at 95%, N=200
  capability: cp=- cpk=22.1484 [19.9720, 24.3248] sigma_to_spec=66.4452 limiting=lower
  sample size: sufficient (N=200, required>=183, observed +/-0.009138 vs target +/-0.01)
  negative control (known-bad variant: supply collapsed to 0.50 V, far below spec/sram.md's ratified 2.97 V minimum and below this cell's data-retention voltage (the physical hold-stability failure mechanism), with per-instance mismatch drawn at 12x the PDK's own sigma): detected -- yield 0.520000 [0.417790, 0.620995] vs nominal 1.000000, N=100
  warning: measurement 'hold_snm_v@ss_125c_3.63v': no sample fell outside the limits, so the empirical yield is bounded only from below -- "at least 98.1725% at 95% confidence, N = 200" is the honest statement, not "100% yield"

warnings:
  no measurement declared a target_yield, so no yield claim was checked -- the estimates below are reported, never failed
```
