2AMLogic/gf180-sram/sim/read-snm/mc/records/20260817-102455-ce56f59.md

# MC/yield record `20260817-102455-ce56f59`

- **Record ID**: `20260817-102455-ce56f59`
- **Kind**: Monte Carlo mismatch campaign + `klt yield` report (statistical evidence, klayout-tools `docs/design-evidence-tiers.md` item 6)
- **Claim**: spec/sram.md Characterization -- read SNM (Monte Carlo device mismatch, combined with the ratified 9-corner PVT matrix)
- **Testbench**: `sim/read-snm/testbench/tb_read_snm.spice`
- **Netlist provenance**: schematic (this repo has not yet produced an extracted netlist; a post-layout re-run would record `extracted` here and reference this record via **Supersedes**)
- **Corner matrix run**: 9 corner points from `spec/sram.md`'s ratified process x temperature x voltage set (`ff_-40c_2.97v`, `ff_25c_3.30v`, `ff_125c_2.97v`, `tt_-40c_3.63v`, `tt_25c_3.30v`, `tt_125c_2.97v`, `ss_-40c_3.63v`, `ss_25c_2.97v`, `ss_125c_3.63v`) -- a deliberate Monte Carlo subset, chosen per `sim/README.md` "Which corners, and why not all of them". MC results **combine with**, and never replace, the deterministic corner records under `sim/read-snm/records/`, which sweep that set exhaustively.
- **Statistical convention**: Monte Carlo, per-instance device mismatch only (`sw_stat_mismatch=1`; `delvto='mis_vth*sw_stat_mismatch' / mulu0='1-mis_k*sw_stat_mismatch' per nfet_03v3/pfet_03v3 instance`). Global/process variation is carried by the corner axis, not resampled -- so each corner is its own population and no estimate is pooled across corners.
- **Seed**: `20260817` (base). Per-sample seed = sha256(base_seed:corner_id:kind:sample_index), truncated to a positive 31-bit integer; delivered to ngspice as `.options seed=<derived>, one independent ngspice invocation per sample`.
- **Sample count**: 200 mismatch samples per corner, 4 determinism-control samples per corner, 100 negative-control samples per corner.
- **Spec limits**: `min = 0.0` V -- spec/sram.md 'Characterization' -- read SNM / hold SNM / write margin must be strictly positive at every corner. No `target_yield` is declared: `spec/sram.md` ratifies no yield target for these rows (that is exactly the open operator decision tracked as issue #20), and this harness does not invent one. The estimates below are therefore *reported* against the spec's own `> 0` limit, with Cpk / sigma-to-spec as the quantitative margin statement.
- **PDK**: `/Users/rwalters/.volare/gf180mcuC` -- **`klt`**: `klt 0.2.0` -- **git**: `ce56f59`
- **`klt yield` overall status**: `reported` (exit code 0)
- **Timestamp / author**: 2026-08-17T10:33:16Z / agent-builder
- **Supersedes**: (none)

## Per-corner result (verbatim from the `klt yield` JSON report)

| Corner | N | errored | mean (V) | stddev (V) | empirical yield, 95% lower bound | Cpk | sigma-to-spec | sample-size verdict | negative control |
|---|---|---|---|---|---|---|---|---|---|
| `ff_-40c_2.97v` | 200 | 0 | 0.345674 | 0.0209368 | 0.981725 | 5.50345 | 16.5103 | sufficient | detected |
| `ff_25c_3.30v` | 200 | 0 | 0.291693 | 0.0277681 | 0.981725 | 3.50153 | 10.5046 | sufficient | detected |
| `ff_125c_2.97v` | 200 | 0 | 0.215995 | 0.0282232 | 0.981725 | 2.55104 | 7.65311 | sufficient | detected |
| `tt_-40c_3.63v` | 200 | 0 | 0.454546 | 0.0236962 | 0.981725 | 6.39407 | 19.1822 | sufficient | detected |
| `tt_25c_3.30v` | 200 | 0 | 0.37892 | 0.0238625 | 0.981725 | 5.29311 | 15.8793 | sufficient | detected |
| `tt_125c_2.97v` | 200 | 0 | 0.297539 | 0.0233139 | 0.981725 | 4.25411 | 12.7623 | sufficient | detected |
| `ss_-40c_3.63v` | 200 | 0 | 0.561536 | 0.0228921 | 0.981725 | 8.17655 | 24.5296 | sufficient | detected |
| `ss_25c_2.97v` | 200 | 0 | 0.472551 | 0.0202394 | 0.981725 | 7.7827 | 23.3481 | sufficient | detected |
| `ss_125c_3.63v` | 200 | 0 | 0.408474 | 0.0268861 | 0.981725 | 5.06426 | 15.1928 | sufficient | detected |

`errored` counts draws that produced no usable measurement (for the SNM fixtures: a draw whose butterfly was not bistable, so no square exists to measure). `klt yield` excludes them from every statistic, so a record with a non-zero `errored` column states a yield estimate *conditioned on a measurable draw* -- read the errored count alongside it, never the yield alone.

## Determinism control (mismatch off)

With `sw_stat_mismatch=0` the campaign must reproduce, exactly and identically for every draw, the number the deterministic corner sweep already recorded for the same corner. This is what ties the MC evidence to the ratified 9-corner evidence rather than leaving it a parallel, unanchored claim.

| Corner | N | errored | distinct value(s) (V) | verdict |
|---|---|---|---|---|
| `ff_-40c_2.97v` | 4 | 0 | 0.346745 | PINNED |
| `ff_25c_3.30v` | 4 | 0 | 0.29104 | PINNED |
| `ff_125c_2.97v` | 4 | 0 | 0.214599 | PINNED |
| `tt_-40c_3.63v` | 4 | 0 | 0.45802 | PINNED |
| `tt_25c_3.30v` | 4 | 0 | 0.381267 | PINNED |
| `tt_125c_2.97v` | 4 | 0 | 0.295443 | PINNED |
| `ss_-40c_3.63v` | 4 | 0 | 0.56375 | PINNED |
| `ss_25c_2.97v` | 4 | 0 | 0.475538 | PINNED |
| `ss_125c_3.63v` | 4 | 0 | 0.40862 | PINNED |

## Negative control

Deliberate defect: **known-bad variant: sw_stat_mismatch=20, i.e. per-instance Vt/current-factor mismatch drawn at 20x the PDK's own sigma (docs/cli/yield.md's 'a mismatch seed pushed past spec')**, drawn with its own independent, reproducibly-derived seeds and analysed by `klt yield` against the *same* spec limits as the nominal measurement. A `detected` verdict means the control's empirical yield is lower **and** its exact (Clopper-Pearson) confidence interval does not overlap the nominal's -- i.e. these statistics demonstrably do detect a degraded design, rather than being assumed to.

## `klt yield` run-level warnings

- no measurement declared a target_yield, so no yield claim was checked -- the estimates below are reported, never failed

## Links

- Sample-set document: [`sim/read-snm/mc/samples/20260817-102455-ce56f59.json`](../samples/20260817-102455-ce56f59.json)
- `klt yield` JSON report: [`sim/read-snm/mc/yield-reports/20260817-102455-ce56f59.json`](../yield-reports/20260817-102455-ce56f59.json)
- `klt yield` text report: [`sim/read-snm/mc/yield-reports/20260817-102455-ce56f59.txt`](../yield-reports/20260817-102455-ce56f59.txt)
- Per-sample raw logs: [`sim/read-snm/mc/raw-logs/20260817-102455-ce56f59`](../raw-logs/20260817-102455-ce56f59)
- Deterministic 9-corner records for the same claim: `sim/read-snm/records/`

## Reproduce

```bash
sim/lib/run_mc_campaign.py \
  --experiment read-snm \
  --testbench sim/read-snm/testbench/tb_read_snm.spice \
  --mode 'snm-pair:read_snm_sweep.txt:read_snm' --key read_snm_v \
  --corner ff:-40:2.97 \
  --corner ff:25:3.30 \
  --corner ff:125:2.97 \
  --corner tt:-40:3.63 \
  --corner tt:25:3.30 \
  --corner tt:125:2.97 \
  --corner ss:-40:3.63 \
  --corner ss:25:2.97 \
  --corner ss:125:3.63 \
  --n 200 --n-control 4 --n-nc 100 \
  --nc-mismatch-scale 20 \
  --seed 20260817 \
  --claim "spec/sram.md Characterization -- read SNM (Monte Carlo device mismatch, combined with the ratified 9-corner PVT matrix)"
```

## `klt yield` text report (verbatim)

```
samples: /Users/rwalters/GitHub/gf180-sram/.loom/worktrees/issue-26/sim/read-snm/mc/samples/20260817-102455-ce56f59.json
source: sample-set  samples_analyzed: 1800
confidence: 0.95  target_ci_halfwidth: 0.01
status: reported  measurements: 9

read_snm_v@ff_-40c_2.97v [V]  status: reported  N: 200
  limits: min=0 max=- target_yield=-
  fit (normal): mean=0.345674 stddev=0.0209368 normality=consistent
  yield (empirical, clopper-pearson): 1.000000 [0.981725, 1.000000] at 95%, N=200
  yield (normal, normal-delta): 1.000000 [1.000000, 1.000000] at 95%, N=200
  capability: cp=- cpk=5.5034 [4.9608, 6.0461] sigma_to_spec=16.5103 limiting=lower
  sample size: sufficient (N=200, required>=183, observed +/-0.009138 vs target +/-0.01)
  negative control (known-bad variant: sw_stat_mismatch=20, i.e. per-instance Vt/current-factor mismatch drawn at 20x the PDK's own sigma (docs/cli/yield.md's 'a mismatch seed pushed past spec')): detected -- yield 0.494737 [0.390532, 0.599279] vs nominal 1.000000, N=95
  warning: measurement 'read_snm_v@ff_-40c_2.97v': no sample fell outside the limits, so the empirical yield is bounded only from below -- "at least 98.1725% at 95% confidence, N = 200" is the honest statement, not "100% yield"

read_snm_v@ff_25c_3.30v [V]  status: reported  N: 200
  limits: min=0 max=- target_yield=-
  fit (normal): mean=0.291693 stddev=0.0277681 normality=consistent
  yield (empirical, clopper-pearson): 1.000000 [0.981725, 1.000000] at 95%, N=200
  yield (normal, normal-delta): 1.000000 [1.000000, 1.000000] at 95%, N=200
  capability: cp=- cpk=3.5015 [3.1544, 3.8486] sigma_to_spec=10.5046 limiting=lower
  sample size: sufficient (N=200, required>=183, observed +/-0.009138 vs target +/-0.01)
  negative control (known-bad variant: sw_stat_mismatch=20, i.e. per-instance Vt/current-factor mismatch drawn at 20x the PDK's own sigma (docs/cli/yield.md's 'a mismatch seed pushed past spec')): detected -- yield 0.505263 [0.400721, 0.609468] vs nominal 1.000000, N=95
  warning: measurement 'read_snm_v@ff_25c_3.30v': no sample fell outside the limits, so the empirical yield is bounded only from below -- "at least 98.1725% at 95% confidence, N = 200" is the honest statement, not "100% yield"

read_snm_v@ff_125c_2.97v [V]  status: reported  N: 200
  limits: min=0 max=- target_yield=-
  fit (normal): mean=0.215995 stddev=0.0282232 normality=consistent
  yield (empirical, clopper-pearson): 1.000000 [0.981725, 1.000000] at 95%, N=200
  yield (normal, normal-delta): 1.000000 [1.000000, 1.000000] at 95%, N=200
  capability: cp=- cpk=2.5510 [2.2962, 2.8059] sigma_to_spec=7.6531 limiting=lower
  sample size: sufficient (N=200, required>=183, observed +/-0.009138 vs target +/-0.01)
  negative control (known-bad variant: sw_stat_mismatch=20, i.e. per-instance Vt/current-factor mismatch drawn at 20x the PDK's own sigma (docs/cli/yield.md's 'a mismatch seed pushed past spec')): detected -- yield 0.360825 [0.265755, 0.464640] vs nominal 1.000000, N=97
  warning: measurement 'read_snm_v@ff_125c_2.97v': no sample fell outside the limits, so the empirical yield is bounded only from below -- "at least 98.1725% at 95% confidence, N = 200" is the honest statement, not "100% yield"

read_snm_v@tt_-40c_3.63v [V]  status: reported  N: 200
  limits: min=0 max=- target_yield=-
  fit (normal): mean=0.454546 stddev=0.0236962 normality=consistent
  yield (empirical, clopper-pearson): 1.000000 [0.981725, 1.000000] at 95%, N=200
  yield (normal, normal-delta): 1.000000 [1.000000, 1.000000] at 95%, N=200
  capability: cp=- cpk=6.3941 [5.7642, 7.0239] sigma_to_spec=19.1822 limiting=lower
  sample size: sufficient (N=200, required>=183, observed +/-0.009138 vs target +/-0.01)
  negative control (known-bad variant: sw_stat_mismatch=20, i.e. per-instance Vt/current-factor mismatch drawn at 20x the PDK's own sigma (docs/cli/yield.md's 'a mismatch seed pushed past spec')): detected -- yield 0.712766 [0.610242, 0.801433] vs nominal 1.000000, N=94
  warning: measurement 'read_snm_v@tt_-40c_3.63v': no sample fell outside the limits, so the empirical yield is bounded only from below -- "at least 98.1725% at 95% confidence, N = 200" is the honest statement, not "100% yield"

read_snm_v@tt_25c_3.30v [V]  status: reported  N: 200
  limits: min=0 max=- target_yield=-
  fit (normal): mean=0.37892 stddev=0.0238625 normality=consistent
  yield (empirical, clopper-pearson): 1.000000 [0.981725, 1.000000] at 95%, N=200
  yield (normal, normal-delta): 1.000000 [1.000000, 1.000000] at 95%, N=200
  capability: cp=- cpk=5.2931 [4.7710, 5.8152] sigma_to_spec=15.8793 limiting=lower
  sample size: sufficient (N=200, required>=183, observed +/-0.009138 vs target +/-0.01)
  negative control (known-bad variant: sw_stat_mismatch=20, i.e. per-instance Vt/current-factor mismatch drawn at 20x the PDK's own sigma (docs/cli/yield.md's 'a mismatch seed pushed past spec')): detected -- yield 0.619565 [0.512384, 0.718823] vs nominal 1.000000, N=92
  warning: measurement 'read_snm_v@tt_25c_3.30v': no sample fell outside the limits, so the empirical yield is bounded only from below -- "at least 98.1725% at 95% confidence, N = 200" is the honest statement, not "100% yield"

read_snm_v@tt_125c_2.97v [V]  status: reported  N: 200
  limits: min=0 max=- target_yield=-
  fit (normal): mean=0.297539 stddev=0.0233139 normality=consistent
  yield (empirical, clopper-pearson): 1.000000 [0.981725, 1.000000] at 95%, N=200
  yield (normal, normal-delta): 1.000000 [1.000000, 1.000000] at 95%, N=200
  capability: cp=- cpk=4.2541 [3.8336, 4.6746] sigma_to_spec=12.7623 limiting=lower
  sample size: sufficient (N=200, required>=183, observed +/-0.009138 vs target +/-0.01)
  negative control (known-bad variant: sw_stat_mismatch=20, i.e. per-instance Vt/current-factor mismatch drawn at 20x the PDK's own sigma (docs/cli/yield.md's 'a mismatch seed pushed past spec')): detected -- yield 0.505495 [0.398619, 0.612003] vs nominal 1.000000, N=91
  warning: measurement 'read_snm_v@tt_125c_2.97v': no sample fell outside the limits, so the empirical yield is bounded only from below -- "at least 98.1725% at 95% confidence, N = 200" is the honest statement, not "100% yield"

read_snm_v@ss_-40c_3.63v [V]  status: reported  N: 200
  limits: min=0 max=- target_yield=-
  fit (normal): mean=0.561536 stddev=0.0228921 normality=consistent
  yield (empirical, clopper-pearson): 1.000000 [0.981725, 1.000000] at 95%, N=200
  yield (normal, normal-delta): 1.000000 [1.000000, 1.000000] at 95%, N=200
  capability: cp=- cpk=8.1765 [7.3719, 8.9812] sigma_to_spec=24.5296 limiting=lower
  sample size: sufficient (N=200, required>=183, observed +/-0.009138 vs target +/-0.01)
  negative control (known-bad variant: sw_stat_mismatch=20, i.e. per-instance Vt/current-factor mismatch drawn at 20x the PDK's own sigma (docs/cli/yield.md's 'a mismatch seed pushed past spec')): detected -- yield 0.768421 [0.670644, 0.848823] vs nominal 1.000000, N=95
  warning: measurement 'read_snm_v@ss_-40c_3.63v': no sample fell outside the limits, so the empirical yield is bounded only from below -- "at least 98.1725% at 95% confidence, N = 200" is the honest statement, not "100% yield"

read_snm_v@ss_25c_2.97v [V]  status: reported  N: 200
  limits: min=0 max=- target_yield=-
  fit (normal): mean=0.472551 stddev=0.0202394 normality=consistent
  yield (empirical, clopper-pearson): 1.000000 [0.981725, 1.000000] at 95%, N=200
  yield (normal, normal-delta): 1.000000 [1.000000, 1.000000] at 95%, N=200
  capability: cp=- cpk=7.7827 [7.0167, 8.5487] sigma_to_spec=23.3481 limiting=lower
  sample size: sufficient (N=200, required>=183, observed +/-0.009138 vs target +/-0.01)
  negative control (known-bad variant: sw_stat_mismatch=20, i.e. per-instance Vt/current-factor mismatch drawn at 20x the PDK's own sigma (docs/cli/yield.md's 'a mismatch seed pushed past spec')): detected -- yield 0.755319 [0.655816, 0.838137] vs nominal 1.000000, N=94
  warning: measurement 'read_snm_v@ss_25c_2.97v': no sample fell outside the limits, so the empirical yield is bounded only from below -- "at least 98.1725% at 95% confidence, N = 200" is the honest statement, not "100% yield"

read_snm_v@ss_125c_3.63v [V]  status: reported  N: 200
  limits: min=0 max=- target_yield=-
  fit (normal): mean=0.408474 stddev=0.0268861 normality=consistent
  yield (empirical, clopper-pearson): 1.000000 [0.981725, 1.000000] at 95%, N=200
  yield (normal, normal-delta): 1.000000 [1.000000, 1.000000] at 95%, N=200
  capability: cp=- cpk=5.0643 [4.5646, 5.5639] sigma_to_spec=15.1928 limiting=lower
  sample size: sufficient (N=200, required>=183, observed +/-0.009138 vs target +/-0.01)
  negative control (known-bad variant: sw_stat_mismatch=20, i.e. per-instance Vt/current-factor mismatch drawn at 20x the PDK's own sigma (docs/cli/yield.md's 'a mismatch seed pushed past spec')): detected -- yield 0.618557 [0.514325, 0.715343] vs nominal 1.000000, N=97
  warning: measurement 'read_snm_v@ss_125c_3.63v': no sample fell outside the limits, so the empirical yield is bounded only from below -- "at least 98.1725% at 95% confidence, N = 200" is the honest statement, not "100% yield"

warnings:
  no measurement declared a target_yield, so no yield claim was checked -- the estimates below are reported, never failed
```
