2AMLogic/gf180-sram/sim/write-margin/mc/records/20260817-104116-ce56f59.md

# MC/yield record `20260817-104116-ce56f59`

- **Record ID**: `20260817-104116-ce56f59`
- **Kind**: Monte Carlo mismatch campaign + `klt yield` report (statistical evidence, klayout-tools `docs/design-evidence-tiers.md` item 6)
- **Claim**: spec/sram.md Characterization -- write margin, as write trip voltage (Monte Carlo device mismatch, combined with the ratified 9-corner PVT matrix)
- **Testbench**: `sim/write-margin/testbench/tb_write_margin.spice`
- **Netlist provenance**: schematic (this repo has not yet produced an extracted netlist; a post-layout re-run would record `extracted` here and reference this record via **Supersedes**)
- **Corner matrix run**: 9 corner points from `spec/sram.md`'s ratified process x temperature x voltage set (`ff_-40c_2.97v`, `ff_25c_3.30v`, `ff_125c_2.97v`, `tt_-40c_3.63v`, `tt_25c_3.30v`, `tt_125c_2.97v`, `ss_-40c_3.63v`, `ss_25c_2.97v`, `ss_125c_3.63v`) -- a deliberate Monte Carlo subset, chosen per `sim/README.md` "Which corners, and why not all of them". MC results **combine with**, and never replace, the deterministic corner records under `sim/write-margin/records/`, which sweep that set exhaustively.
- **Statistical convention**: Monte Carlo, per-instance device mismatch only (`sw_stat_mismatch=1`; `delvto='mis_vth*sw_stat_mismatch' / mulu0='1-mis_k*sw_stat_mismatch' per nfet_03v3/pfet_03v3 instance`). Global/process variation is carried by the corner axis, not resampled -- so each corner is its own population and no estimate is pooled across corners.
- **Seed**: `20260817` (base). Per-sample seed = sha256(base_seed:corner_id:kind:sample_index), truncated to a positive 31-bit integer; delivered to ngspice as `.options seed=<derived>, one independent ngspice invocation per sample`.
- **Sample count**: 200 mismatch samples per corner, 4 determinism-control samples per corner, 100 negative-control samples per corner.
- **Spec limits**: `min = 0.0` V -- spec/sram.md 'Characterization' -- read SNM / hold SNM / write margin must be strictly positive at every corner. No `target_yield` is declared: `spec/sram.md` ratifies no yield target for these rows (that is exactly the open operator decision tracked as issue #20), and this harness does not invent one. The estimates below are therefore *reported* against the spec's own `> 0` limit, with Cpk / sigma-to-spec as the quantitative margin statement.
- **PDK**: `/Users/rwalters/.volare/gf180mcuC` -- **`klt`**: `klt 0.2.0` -- **git**: `ce56f59`
- **`klt yield` overall status**: `reported` (exit code 0)
- **Timestamp / author**: 2026-08-17T10:48:52Z / agent-builder
- **Supersedes**: (none)

## Per-corner result (verbatim from the `klt yield` JSON report)

| Corner | N | errored | mean (V) | stddev (V) | empirical yield, 95% lower bound | Cpk | sigma-to-spec | sample-size verdict | negative control |
|---|---|---|---|---|---|---|---|---|---|
| `ff_-40c_2.97v` | 200 | 0 | 1.69589 | 0.00761785 | 0.981725 | 74.2069 | 222.621 | sufficient | detected |
| `ff_25c_3.30v` | 200 | 0 | 1.87085 | 0.00669054 | 0.981725 | 93.2087 | 279.626 | sufficient | detected |
| `ff_125c_2.97v` | 200 | 0 | 1.64071 | 0.00641502 | 0.981725 | 85.2534 | 255.76 | sufficient | detected |
| `tt_-40c_3.63v` | 200 | 0 | 2.13313 | 0.0072495 | 0.981725 | 98.0816 | 294.245 | sufficient | detected |
| `tt_25c_3.30v` | 200 | 0 | 1.9105 | 0.00661808 | 0.981725 | 96.2263 | 288.679 | sufficient | detected |
| `tt_125c_2.97v` | 200 | 0 | 1.67745 | 0.00531525 | 0.981725 | 105.197 | 315.591 | sufficient | detected |
| `ss_-40c_3.63v` | 200 | 0 | 2.17203 | 0.00660311 | 0.981725 | 109.647 | 328.94 | sufficient | detected |
| `ss_25c_2.97v` | 200 | 0 | 1.74165 | 0.0049579 | 0.981725 | 117.096 | 351.287 | sufficient | detected |
| `ss_125c_3.63v` | 200 | 0 | 2.10961 | 0.0052796 | 0.981725 | 133.193 | 399.578 | sufficient | detected |

`errored` counts draws that produced no usable measurement (for the SNM fixtures: a draw whose butterfly was not bistable, so no square exists to measure). `klt yield` excludes them from every statistic, so a record with a non-zero `errored` column states a yield estimate *conditioned on a measurable draw* -- read the errored count alongside it, never the yield alone.

## Determinism control (mismatch off)

With `sw_stat_mismatch=0` the campaign must reproduce, exactly and identically for every draw, the number the deterministic corner sweep already recorded for the same corner. This is what ties the MC evidence to the ratified 9-corner evidence rather than leaving it a parallel, unanchored claim.

| Corner | N | errored | distinct value(s) (V) | verdict |
|---|---|---|---|---|
| `ff_-40c_2.97v` | 4 | 0 | 1.69546 | PINNED |
| `ff_25c_3.30v` | 4 | 0 | 1.87075 | PINNED |
| `ff_125c_2.97v` | 4 | 0 | 1.64053 | PINNED |
| `tt_-40c_3.63v` | 4 | 0 | 2.13271 | PINNED |
| `tt_25c_3.30v` | 4 | 0 | 1.91003 | PINNED |
| `tt_125c_2.97v` | 4 | 0 | 1.67751 | PINNED |
| `ss_-40c_3.63v` | 4 | 0 | 2.17259 | PINNED |
| `ss_25c_2.97v` | 4 | 0 | 1.74241 | PINNED |
| `ss_125c_3.63v` | 4 | 0 | 2.10967 | PINNED |

## Negative control

Deliberate defect: **known-bad variant: supply collapsed to 0.60 V, far below spec/sram.md's ratified 2.97 V minimum, with per-instance mismatch drawn at 6x the PDK's own sigma -- a write that no longer completes inside the fixed 1.8 ns write pulse**, drawn with its own independent, reproducibly-derived seeds and analysed by `klt yield` against the *same* spec limits as the nominal measurement. A `detected` verdict means the control's empirical yield is lower **and** its exact (Clopper-Pearson) confidence interval does not overlap the nominal's -- i.e. these statistics demonstrably do detect a degraded design, rather than being assumed to.

## `klt yield` run-level warnings

- no measurement declared a target_yield, so no yield claim was checked -- the estimates below are reported, never failed

## Links

- Sample-set document: [`sim/write-margin/mc/samples/20260817-104116-ce56f59.json`](../samples/20260817-104116-ce56f59.json)
- `klt yield` JSON report: [`sim/write-margin/mc/yield-reports/20260817-104116-ce56f59.json`](../yield-reports/20260817-104116-ce56f59.json)
- `klt yield` text report: [`sim/write-margin/mc/yield-reports/20260817-104116-ce56f59.txt`](../yield-reports/20260817-104116-ce56f59.txt)
- Per-sample raw logs: [`sim/write-margin/mc/raw-logs/20260817-104116-ce56f59`](../raw-logs/20260817-104116-ce56f59)
- Deterministic 9-corner records for the same claim: `sim/write-margin/records/`

## Reproduce

```bash
sim/lib/run_mc_campaign.py \
  --experiment write-margin \
  --testbench sim/write-margin/testbench/tb_write_margin.spice \
  --mode 'direct' --key write_trip_voltage_v \
  --corner ff:-40:2.97 \
  --corner ff:25:3.30 \
  --corner ff:125:2.97 \
  --corner tt:-40:3.63 \
  --corner tt:25:3.30 \
  --corner tt:125:2.97 \
  --corner ss:-40:3.63 \
  --corner ss:25:2.97 \
  --corner ss:125:3.63 \
  --n 200 --n-control 4 --n-nc 100 \
  --nc-mismatch-scale 6 --nc-vdd 0.60 \
  --seed 20260817 \
  --claim "spec/sram.md Characterization -- write margin, as write trip voltage (Monte Carlo device mismatch, combined with the ratified 9-corner PVT matrix)"
```

## `klt yield` text report (verbatim)

```
samples: /Users/rwalters/GitHub/gf180-sram/.loom/worktrees/issue-26/sim/write-margin/mc/samples/20260817-104116-ce56f59.json
source: sample-set  samples_analyzed: 1800
confidence: 0.95  target_ci_halfwidth: 0.01
status: reported  measurements: 9

write_trip_voltage_v@ff_-40c_2.97v [V]  status: reported  N: 200
  limits: min=0 max=- target_yield=-
  fit (normal): mean=1.69589 stddev=0.00761785 normality=consistent
  yield (empirical, clopper-pearson): 1.000000 [0.981725, 1.000000] at 95%, N=200
  yield (normal, normal-delta): 1.000000 [1.000000, 1.000000] at 95%, N=200
  capability: cp=- cpk=74.2069 [66.9164, 81.4975] sigma_to_spec=222.6208 limiting=lower
  sample size: sufficient (N=200, required>=183, observed +/-0.009138 vs target +/-0.01)
  negative control (known-bad variant: supply collapsed to 0.60 V, far below spec/sram.md's ratified 2.97 V minimum, with per-instance mismatch drawn at 6x the PDK's own sigma -- a write that no longer completes inside the fixed 1.8 ns write pulse): detected -- yield 0.710000 [0.610734, 0.796426] vs nominal 1.000000, N=100
  warning: measurement 'write_trip_voltage_v@ff_-40c_2.97v': no sample fell outside the limits, so the empirical yield is bounded only from below -- "at least 98.1725% at 95% confidence, N = 200" is the honest statement, not "100% yield"

write_trip_voltage_v@ff_25c_3.30v [V]  status: reported  N: 200
  limits: min=0 max=- target_yield=-
  fit (normal): mean=1.87085 stddev=0.00669054 normality=consistent
  yield (empirical, clopper-pearson): 1.000000 [0.981725, 1.000000] at 95%, N=200
  yield (normal, normal-delta): 1.000000 [1.000000, 1.000000] at 95%, N=200
  capability: cp=- cpk=93.2087 [84.0514, 102.3661] sigma_to_spec=279.6262 limiting=lower
  sample size: sufficient (N=200, required>=183, observed +/-0.009138 vs target +/-0.01)
  negative control (known-bad variant: supply collapsed to 0.60 V, far below spec/sram.md's ratified 2.97 V minimum, with per-instance mismatch drawn at 6x the PDK's own sigma -- a write that no longer completes inside the fixed 1.8 ns write pulse): detected -- yield 0.880000 [0.799764, 0.936431] vs nominal 1.000000, N=100
  warning: measurement 'write_trip_voltage_v@ff_25c_3.30v': no sample fell outside the limits, so the empirical yield is bounded only from below -- "at least 98.1725% at 95% confidence, N = 200" is the honest statement, not "100% yield"

write_trip_voltage_v@ff_125c_2.97v [V]  status: reported  N: 200
  limits: min=0 max=- target_yield=-
  fit (normal): mean=1.64071 stddev=0.00641502 normality=consistent
  yield (empirical, clopper-pearson): 1.000000 [0.981725, 1.000000] at 95%, N=200
  yield (normal, normal-delta): 1.000000 [1.000000, 1.000000] at 95%, N=200
  capability: cp=- cpk=85.2534 [76.8777, 93.6292] sigma_to_spec=255.7603 limiting=lower
  sample size: sufficient (N=200, required>=183, observed +/-0.009138 vs target +/-0.01)
  negative control (known-bad variant: supply collapsed to 0.60 V, far below spec/sram.md's ratified 2.97 V minimum, with per-instance mismatch drawn at 6x the PDK's own sigma -- a write that no longer completes inside the fixed 1.8 ns write pulse): detected -- yield 0.808081 [0.716632, 0.880316] vs nominal 1.000000, N=99
  warning: measurement 'write_trip_voltage_v@ff_125c_2.97v': no sample fell outside the limits, so the empirical yield is bounded only from below -- "at least 98.1725% at 95% confidence, N = 200" is the honest statement, not "100% yield"

write_trip_voltage_v@tt_-40c_3.63v [V]  status: reported  N: 200
  limits: min=0 max=- target_yield=-
  fit (normal): mean=2.13313 stddev=0.0072495 normality=consistent
  yield (empirical, clopper-pearson): 1.000000 [0.981725, 1.000000] at 95%, N=200
  yield (normal, normal-delta): 1.000000 [1.000000, 1.000000] at 95%, N=200
  capability: cp=- cpk=98.0816 [88.4456, 107.7177] sigma_to_spec=294.2448 limiting=lower
  sample size: sufficient (N=200, required>=183, observed +/-0.009138 vs target +/-0.01)
  negative control (known-bad variant: supply collapsed to 0.60 V, far below spec/sram.md's ratified 2.97 V minimum, with per-instance mismatch drawn at 6x the PDK's own sigma -- a write that no longer completes inside the fixed 1.8 ns write pulse): detected -- yield 0.700000 [0.600185, 0.787594] vs nominal 1.000000, N=100
  warning: measurement 'write_trip_voltage_v@tt_-40c_3.63v': no sample fell outside the limits, so the empirical yield is bounded only from below -- "at least 98.1725% at 95% confidence, N = 200" is the honest statement, not "100% yield"

write_trip_voltage_v@tt_25c_3.30v [V]  status: reported  N: 200
  limits: min=0 max=- target_yield=-
  fit (normal): mean=1.9105 stddev=0.00661808 normality=consistent
  yield (empirical, clopper-pearson): 1.000000 [0.981725, 1.000000] at 95%, N=200
  yield (normal, normal-delta): 1.000000 [1.000000, 1.000000] at 95%, N=200
  capability: cp=- cpk=96.2263 [86.7725, 105.6801] sigma_to_spec=288.6789 limiting=lower
  sample size: sufficient (N=200, required>=183, observed +/-0.009138 vs target +/-0.01)
  negative control (known-bad variant: supply collapsed to 0.60 V, far below spec/sram.md's ratified 2.97 V minimum, with per-instance mismatch drawn at 6x the PDK's own sigma -- a write that no longer completes inside the fixed 1.8 ns write pulse): detected -- yield 0.652174 [0.545737, 0.748514] vs nominal 1.000000, N=92
  warning: measurement 'write_trip_voltage_v@tt_25c_3.30v': no sample fell outside the limits, so the empirical yield is bounded only from below -- "at least 98.1725% at 95% confidence, N = 200" is the honest statement, not "100% yield"

write_trip_voltage_v@tt_125c_2.97v [V]  status: reported  N: 200
  limits: min=0 max=- target_yield=-
  fit (normal): mean=1.67745 stddev=0.00531525 normality=consistent
  yield (empirical, clopper-pearson): 1.000000 [0.981725, 1.000000] at 95%, N=200
  yield (normal, normal-delta): 1.000000 [1.000000, 1.000000] at 95%, N=200
  capability: cp=- cpk=105.1971 [94.8620, 115.5322] sigma_to_spec=315.5912 limiting=lower
  sample size: sufficient (N=200, required>=183, observed +/-0.009138 vs target +/-0.01)
  negative control (known-bad variant: supply collapsed to 0.60 V, far below spec/sram.md's ratified 2.97 V minimum, with per-instance mismatch drawn at 6x the PDK's own sigma -- a write that no longer completes inside the fixed 1.8 ns write pulse): detected -- yield 0.663158 [0.558896, 0.756937] vs nominal 1.000000, N=95
  warning: measurement 'write_trip_voltage_v@tt_125c_2.97v': no sample fell outside the limits, so the empirical yield is bounded only from below -- "at least 98.1725% at 95% confidence, N = 200" is the honest statement, not "100% yield"

write_trip_voltage_v@ss_-40c_3.63v [V]  status: reported  N: 200
  limits: min=0 max=- target_yield=-
  fit (normal): mean=2.17203 stddev=0.00660311 normality=consistent
  yield (empirical, clopper-pearson): 1.000000 [0.981725, 1.000000] at 95%, N=200
  yield (normal, normal-delta): 1.000000 [1.000000, 1.000000] at 95%, N=200
  capability: cp=- cpk=109.6468 [98.8745, 120.4190] sigma_to_spec=328.9403 limiting=lower
  sample size: sufficient (N=200, required>=183, observed +/-0.009138 vs target +/-0.01)
  negative control (known-bad variant: supply collapsed to 0.60 V, far below spec/sram.md's ratified 2.97 V minimum, with per-instance mismatch drawn at 6x the PDK's own sigma -- a write that no longer completes inside the fixed 1.8 ns write pulse): detected -- yield 0.450000 [0.350320, 0.552720] vs nominal 1.000000, N=100
  warning: measurement 'write_trip_voltage_v@ss_-40c_3.63v': no sample fell outside the limits, so the empirical yield is bounded only from below -- "at least 98.1725% at 95% confidence, N = 200" is the honest statement, not "100% yield"

write_trip_voltage_v@ss_25c_2.97v [V]  status: reported  N: 200
  limits: min=0 max=- target_yield=-
  fit (normal): mean=1.74165 stddev=0.0049579 normality=consistent
  yield (empirical, clopper-pearson): 1.000000 [0.981725, 1.000000] at 95%, N=200
  yield (normal, normal-delta): 1.000000 [1.000000, 1.000000] at 95%, N=200
  capability: cp=- cpk=117.0956 [105.5916, 128.5997] sigma_to_spec=351.2868 limiting=lower
  sample size: sufficient (N=200, required>=183, observed +/-0.009138 vs target +/-0.01)
  negative control (known-bad variant: supply collapsed to 0.60 V, far below spec/sram.md's ratified 2.97 V minimum, with per-instance mismatch drawn at 6x the PDK's own sigma -- a write that no longer completes inside the fixed 1.8 ns write pulse): detected -- yield 0.550000 [0.447280, 0.649680] vs nominal 1.000000, N=100
  warning: measurement 'write_trip_voltage_v@ss_25c_2.97v': no sample fell outside the limits, so the empirical yield is bounded only from below -- "at least 98.1725% at 95% confidence, N = 200" is the honest statement, not "100% yield"

write_trip_voltage_v@ss_125c_3.63v [V]  status: reported  N: 200
  limits: min=0 max=- target_yield=-
  fit (normal): mean=2.10961 stddev=0.0052796 normality=consistent
  yield (empirical, clopper-pearson): 1.000000 [0.981725, 1.000000] at 95%, N=200
  yield (normal, normal-delta): 1.000000 [1.000000, 1.000000] at 95%, N=200
  capability: cp=- cpk=133.1926 [120.1071, 146.2780] sigma_to_spec=399.5777 limiting=lower
  sample size: sufficient (N=200, required>=183, observed +/-0.009138 vs target +/-0.01)
  negative control (known-bad variant: supply collapsed to 0.60 V, far below spec/sram.md's ratified 2.97 V minimum, with per-instance mismatch drawn at 6x the PDK's own sigma -- a write that no longer completes inside the fixed 1.8 ns write pulse): detected -- yield 0.647727 [0.538592, 0.746610] vs nominal 1.000000, N=88
  warning: measurement 'write_trip_voltage_v@ss_125c_3.63v': no sample fell outside the limits, so the empirical yield is bounded only from below -- "at least 98.1725% at 95% confidence, N = 200" is the honest statement, not "100% yield"

warnings:
  no measurement declared a target_yield, so no yield claim was checked -- the estimates below are reported, never failed
```
