2AMLogic/gf180-sram/spec/README.md

# spec

Ratified spec and decision records for this block.

- [`bitcell-decision.md`](bitcell-decision.md) — resolves #1: gf180mcu ships
  a foundry 6T bitcell (`018SRAM_cell1`), but only embedded in four
  fixed-depth `gf180mcu_fd_ip_sram` hardened macros, not as a standalone
  primitive. Decides this repo draws a custom bitcell/array rather than
  integrating the hardened macro, with rationale.
- [`sram.md`](sram.md) — resolves #2: ratifies the target macro spec
  (organization, ports, deliverables, characterization) that was left as a
  DRAFT table in `README.md`, building on the bitcell decision above.
- [`corner-count-correction.md`](corner-count-correction.md) — resolves #53:
  corrects `sram.md`'s "Corner set" arithmetic (`3 × 3 × 3` is 27, not 9).
  A label-only correction — the ratified corner set, the Signoff definition,
  and every committed record are unchanged.
- [`kb-scale-integration.md`](kb-scale-integration.md) — resolves #73:
  informational (not a change to the ratified spec). States the PDK's
  fixed-macro ceiling (`512×8` = 0.5 KB, measured from the shipped LEF),
  what this repo's own custom macro does and does not offer above it, and a
  KB-scale integrator's path (tiled foundry macros vs. DFFRAM vs. OpenRAM,
  with area/timing evidence tiers labelled and the mux/bank-select cost
  flagged as unmeasured). Also notes the open kit's lack of dense NVM.
- [`block-kind-decision.md`](block-kind-decision.md) — resolves #19:
  ratifies this block's T1 evidence-tier kind (per
  `klayout-tools/docs/design-evidence-tiers.md`'s "Block kind" requirement)
  as `analog`, scoped to everything currently ratified (the custom
  bitcell/array and the xschem + ngspice PVT characterization approach); does
  not pre-commit any future periphery to a kind. `sram.md` gains a pointer
  to this record; no existing ratified value changes.
- [`statistical-treatment-decision.md`](statistical-treatment-decision.md) —
  resolves #20: ratifies read SNM, hold SNM, and write margin as statistical
  (mismatch-driven) spec rows requiring Monte Carlo evidence per
  klayout-tools' `docs/design-evidence-tiers.md` item 6, combined with —
  never replacing — the ratified 27-corner deterministic matrix. Additive
  only to `sram.md`'s Characterization section. Cites the three Monte Carlo
  / `klt yield` records PR #58 already committed (`sim/read-snm/mc/`,
  `sim/hold-snm/mc/`, `sim/write-margin/mc/`) as satisfying evidence, and
  explicitly defers ratifying a numeric `target_yield` bar as a named
  follow-up.
- [`pdk-variant-decision.md`](pdk-variant-decision.md) — resolves #86: pins
  `gf180mcuD` (not `gf180mcuC`) as the PDK variant this repo cites and
  builds against, per the fleet-wide `gf180-tmds-tx#9` DR-0006 ruling.
  Citation-only correction — with direct evidence (byte-identical SPICE
  models, no Metal4/Metal5 use in this repo's layout, a variant-agnostic
  `klt` curated DRC/LVS deck) that none of this repo's read/write margin,
  access-time, or Monte Carlo yield figures are sensitive to the C-vs-D
  metal-stack delta, so no `sim/` or `layout/` evidence is re-run.
- [`target-yield-decision.md`](target-yield-decision.md) — resolves #90:
  ratifies **no** numeric `target_yield` bar for read SNM, hold SNM, and
  write margin — the sub-question `statistical-treatment-decision.md`
  explicitly deferred. Cpk / sigma-to-spec / the exact Clopper-Pearson
  empirical-yield lower bound (each with its own confidence interval) remain
  the standing requirement instead of a pass/fail number, because the
  existing 200-sample-per-corner campaigns cannot resolve an 8192-bit
  array's per-bit yield to the confidence a numeric bar would imply, and no
  citable external precedent exists to ground one. Additive only to
  `sram.md`'s Characterization section; no `sim/` evidence is re-run.
- [`write-pulse-width-decision.md`](write-pulse-width-decision.md) —
  resolves #7: ratifies that write margin is measured against a fixed,
  stated **2 ns** write-pulse width, with **no** independent macro timing
  target — this repo ratifies no clock period/cycle-time/frequency target
  anywhere else for that phrase to reference. The existing testbench
  (`sim/write-margin/testbench/tb_write_margin.spice`) already trials over
  exactly that 2 ns window, ~23x the worst measured write access time
  (85 ps at `ss_125c_2.97v`), so no re-run of any committed write-margin
  evidence is required. Amends only the write-margin bullet in `sram.md`'s
  Characterization section.
- [`t1-checklist-reread-2026-08-22.md`](t1-checklist-reread-2026-08-22.md) —
  resolves #100: the second T1/bronze checklist re-read (after #13), all ten
  items PASS (three with a disclosed, tracked hole; one with a fully
  investigated structural limitation) — a large swing from #13's 0/10 now
  that design, layout, and sim evidence all exist. Live-re-verifies item 4
  (array-level LVS) against an upstream `klt lvs` fix that landed after this
  repo's evidence was last recorded, and decomposes the still-open holes
  into issues #108–#110 (item 3's hole was already tracked as #103).
  Superseded as the verdict of record by the mechanical `klt signoff`
  manifest in `signoff/` (this hand-read predates the checklist's eleventh
  item and is retained as the dated audit snapshot only) — see
  [`signoff/README.md`](../signoff/README.md).
  Informational only — no ratified spec value changes.
- [`periphery-architecture.md`](periphery-architecture.md) — resolves #202:
  fixes the periphery architecture (4:1 column mux, 64 x 128 physical array,
  predecode + pitch-matched wordline drivers, per-I/O sense amp and write
  driver, self-timed access pulse), the macro floorplan, and the pin
  placement for the #198-ratified 1RW pins, each row cited against the
  foundry `gf180mcu_fd_ip_sram` macro and OpenRAM (which has no gf180mcu SRAM
  periphery). 4:1 is held conditional on an unmeasured far-end wordline RC
  gate, with fallbacks named. No ratified item changes; no timing ratified.
