2AMLogic/gf180-sram/spec/t1-grant-2026-10-02.md

# Bronze (T1, simulation-validated) grant — 2026-10-02

**Status**: Decided (operator ruling, 2026-10-02, in-session queue review).
**Resolves**: #126. **Not a change to the ratified spec.**

## Grant

**Bronze (T1, simulation-validated) is GRANTED to gf180-sram on gf180mcu,
2026-10-02.** This is the repo-side tier record; the fleet's authoritative
grants table (`product/everyblock/grants.md` and `block-matrix.md`, in
`2AMLogic/product`) is outside this repo and is updated there, not here.

## Basis

- The 10/10 hand read of 2026-08-22,
  [`t1-checklist-reread-2026-08-22.md`](t1-checklist-reread-2026-08-22.md),
  with every hole it disclosed since closed: #103 (native DRC deck), #108
  (array LVS `match`), #109 (absolute paths in MC/yield scripts), #110
  (stale README status).
- The passing item-11 (power delivery, structural) ERC, issue #124 / PR #132:
  `layout/sram_256x32/erc-supply-spec.json` and
  `layout/reports/erc-array-supply.json` (`erc_finding_count: 0`; reading in
  `layout/reports/README.md` § "Item 11").
- Repo state since the read is Loom resyncs and evidence/tooling commits only;
  no design or ratified-spec change.

## Disclosed exceptions and caveats

1. **Item 7 — read/hold SNM post-layout (PEX) gap.** No PEX-compatible path
   exists for read SNM or hold SNM (Seevinck's method needs to break the
   cross-coupled loop; no drawn boundary isolates one storage inverter).
   Write access time, read access time and write margin are closed
   post-layout, 27/27 corners. Closing the gap needs a new isolated-inverter
   layout. Full investigation: [`../sim/pex/README.md`](../sim/pex/README.md).
   This is a missing measurement, not a measured miss; the operator accepted
   it as a bronze-compatible exception.
2. **Machine grader reads 10/11, not 11/11, and that is a tooling gap, not a
   substance gap.** The pinned `klayout-tools` 0.5.0 predates item-11 grading
   rules, so the item-11 envelope renders `unrecognized_envelope`; and the
   release's own item-11 requirement of a checked `ties[]` supply spec is
   pending (see `signoff/README.md`, item 11 row).
3. **Items 1, 2, 9, 10 are cited for the grader, not proven by it.** These
   items have no `klt` verb. `klt signoff` 0.5.0 accepts any passing native
   envelope and rejects `kind: generic` for them, so they are cited (issue
   #126) with adjacent native envelopes; the substance remains the human audit
   in the 2026-08-22 re-read. See `signoff/README.md` for each row.

## What bronze does not claim

As in the re-read: not commercial signoff (T2), not a routed/integrated macro
(core array only; no periphery, Liberty absent), not silicon (T3).
