2AMLogic/gf180-sram/.loom/docs/daemon-reference.md

# Loom Daemon Reference

> **Status: ACTIVE (v0.10.0).** This page describes the Rust `loom-daemon`
> binary and its MCP-facing surface — the dispatch + pub/sub + monitoring
> tools delivered by epic #3449 (Phases A through C). The legacy Python
> `loom-daemon` brain (`loom_tools/daemon_v2/`) and the `/shepherd`
> orchestrator were deleted in the v0.10.0 deprecation epic (#3372). The
> shell-level `./.loom/scripts/daemon.sh` tmux session launcher was removed
> in #3432; use `./.loom/scripts/cli/loom-daemon-start.sh` / `loom-daemon-stop.sh`.

<!-- toc:begin generated by scripts/check-doc-tocs.sh --fix; do not edit by hand -->
**Contents**

- [What the daemon is](#what-the-daemon-is)
- [The `LOOM_ROLE` env-var contract (#6507)](#the-loom_role-env-var-contract-6507)
- [Architecture (Phases A-C)](#architecture-phases-a-c)
- [IPC surface (Request/Response variants)](#ipc-surface-requestresponse-variants)
- [Event taxonomy (frozen for v0.10.0)](#event-taxonomy-frozen-for-v0100)
- [MCP tool reference](#mcp-tool-reference)
- [In-memory registry layout](#in-memory-registry-layout)
- [Per-workspace registry pool (`WorkspacePool`, #3928/#3929)](#per-workspace-registry-pool-workspacepool-39283929)
- [Delegated daemon administration (`daemon.delegatedTo`, #5345)](#delegated-daemon-administration-daemondelegatedto-5345)
- [Fleet — operator-triggered multi-host worker fanout (`fleet`, #4340)](#fleet--operator-triggered-multi-host-worker-fanout-fleet-4340)
- [Fleet store — `fleet-config` (`fleet.repo`)](#fleet-store--fleet-config-fleetrepo)
- [Fleet model A/B — `sweep-experiment plan` (#8055 phase 1)](#fleet-model-ab--sweep-experiment-plan-8055-phase-1)
- [Token pool provisioning for managed repos (#3938)](#token-pool-provisioning-for-managed-repos-3938)
- [Per-repo status breakdown + per-repo main-health gate (#3930 — phase d)](#per-repo-status-breakdown--per-repo-main-health-gate-3930--phase-d)
- [Gate verdicts: VERIFIED_RED vs UNEVALUATED (#3974)](#gate-verdicts-verified_red-vs-unevaluated-3974)
- [Per-workspace priority tiers (#3946)](#per-workspace-priority-tiers-3946)
- [Forge-side pipeline snapshot (`status --pipeline`, #3977)](#forge-side-pipeline-snapshot-status---pipeline-3977)
- [Section-scoped status (`status --json --section`, #10787)](#section-scoped-status-status---json---section-10787)
- [One-shot fleet vitals (`loom-daemon health`, #4761)](#one-shot-fleet-vitals-loom-daemon-health-4761)
- [`.loom/state/` tracking contract (#9592)](#loomstate-tracking-contract-9592)
- [Reaper task](#reaper-task)
- [Stale-claim reconciliation & the sweep journal (#3953, fixed #3975, extended to PR-side claims #4367)](#stale-claim-reconciliation--the-sweep-journal-3953-fixed-3975-extended-to-pr-side-claims-4367)
- [Stacked-PR dependency — #3729 (v1), #3747 (v2 item 1)](#stacked-pr-dependency--3729-v1-3747-v2-item-1)
- [Epic supervisor (#3842)](#epic-supervisor-3842)
- [Curator intake reconcile (#10041)](#curator-intake-reconcile-10041)
- [Autonomous work finder (#3810)](#autonomous-work-finder-3810)
- [Operability — config, start/stop, E2E (Phase D, #3813)](#operability--config-startstop-e2e-phase-d-3813)
- [Reader withdrawal kill switch (`LOOM_READ_ROUTING`)](#reader-withdrawal-kill-switch-loom_read_routing)
- [Read-pool routing (`forge.readPool.routing`)](#read-pool-routing-forgereadpoolrouting)
- [Observability exporter (`observability`, #4705, epic #4702 Phase 1)](#observability-exporter-observability-4705-epic-4702-phase-1)
- [Fleet dashboard (`loom-daemon serve`)](#fleet-dashboard-loom-daemon-serve)
- [Locks and lifecycle](#locks-and-lifecycle)
- [What this page does NOT describe](#what-this-page-does-not-describe)
- [Related resources](#related-resources)
<!-- toc:end -->

## What the daemon is

`loom-daemon` is a Rust process that exposes a Unix-socket IPC surface
(framed JSON, line-delimited) and a paired `mcp-loom` MCP server which
maps each IPC request 1:1 to an MCP tool. The daemon is **the
coordination point** for:

- **Dispatching** `/loom:sweep` children with multi-account OAuth token
  rotation (via `defaults/scripts/spawn-claude.sh`).
- **Tracking** running sweeps in an in-memory registry (no on-disk state
  file — the forge is the source of truth for queue state).
- **Publishing** sweep-lifecycle events on an in-memory pub/sub bus, and
  **subscribing** external monitors to topic-filtered streams.
- **Cancelling** in-flight sweeps with SIGTERM → grace → SIGKILL.
- **Reaping** dead PIDs (every 30s) to maintain registry liveness and
  emit `sweep.issue.*.exited` / `sweep.issue.*.crashed` events.

**By default it is not a work generator.** With no autonomous config it
does not poll the forge for ready issues, it does not maintain a
`shepherd-N` pool, and it does not run support roles on cron — those
responsibilities live in `mcp__loom__dispatch_sweep` (operator-driven
enqueue) and the GitHub Actions cron workflows
(`.github/workflows/loom-*.yml`). Two **opt-in, default-off** surfaces
(epics #3809 and #3842) let the daemon generate and dispatch its own work
when explicitly enabled: the [autonomous work
finder](#autonomous-work-finder-3810) polls open `loom:issue` items and
auto-dispatches sweeps, and the [epic supervisor](#epic-supervisor-3842)
drives `loom:epic` fork-joins. See [Operability](#operability--config-startstop-e2e-phase-d-3813)
for enabling and tuning them.

## The `LOOM_ROLE` env-var contract (#6507)

`LOOM_ROLE` is a **public, stable session-identity contract**: repo-level
hooks/scripts (SessionStart hooks, guard hooks, any tooling that needs to
tell an operator's interactive session apart from a session Loom itself
spawned) **may branch on `LOOM_ROLE` being set** to detect "this is a
Loom-spawned agent session." Two shipped repo-level consumers already do
exactly this — `.loom/hooks/guard-destructive-generic.sh` (the
`dist/`-write-confinement role allowlist, #6021) and
`.loom/hooks/methodology-inject.sh` (role-context injection keyed off
`LOOM_ROLE` matching a `roles/<role>.md` filename) — see
[`guard-hooks.md`](guard-hooks.md) for the former.

**Semantics:**

- **Present** ⇒ this session was spawned by Loom (a dispatched sweep child,
  a role-runner tick, or a tmux/MOM agent launch), and its value names the
  role (or, for a whole `/loom:sweep` launch, the sentinel role
  `sweep-lifecycle`).
- **Absent** ⇒ not spawned by Loom — e.g. an interactive operator session
  (see the one residual gap below).

**What sets it** — every production code path that spawns an agent session
sets `LOOM_ROLE`, unconditionally once past its own admission/validation
step (traced against `origin/main` @ `7d169a06`, 2026-08-18; re-verify
against current `main` before relying on a specific line number, since a
new spawn call site could be added later):

1. `loom-daemon/src/sweep_registry/dispatch.rs` (~line 2089, inside
   `spawn_child`) — sets `LOOM_ROLE` to the already-admitted
   `admission.role` (always `"sweep-lifecycle"` for a full `/loom:sweep`
   launch) alongside `LOOM_RUNTIME`. Gated by `if let Some(admission) =
   runtime_admission`, but `runtime_admission` is only ever `None` when
   `self.config.skip_label_flip` is true — a test-only fixture flag
   (hermetic unit tests skip installing runtime manifests); every real
   dispatch either admits successfully or returns `Err` before the spawn
   is ever reached (Issue #4768).
2. `loom-daemon/src/role_runner.rs` (~line 1212, inside
   `run_role_with_timeout`) — same shape, for a periodic support-role tick
   (Champion/Curator/Judge/Doctor/Auditor/Guide/Hermit/Architect). Gated by
   `if let Some(admission) = admission`, where `admission` is only ever
   `None` when `self.spawn_bin.is_some()` — again a test-only condition (a
   fake spawn script substituted in tests); the production path
   (`spawn_bin` unset) always resolves a real admission or bails out before
   spawning (Issue #4768).
3. `loom-daemon/src/agent_session/spawn.rs` (~line 647, inside the
   tmux/MOM `run()` path used by `agent-spawn.sh` / interactive terminal
   launch) — sets `LOOM_ROLE` to `opts.role` **unconditionally**, no `if
   let Some` gate at all. `opts.role.is_empty()` is already rejected
   earlier in the same function (returns exit `1` before any tmux session
   is created), so by the time this line runs `opts.role` is guaranteed
   non-empty.

**Known residual gap**: an operator manually typing `/loom:<role>` (e.g.
`/loom:doctor`) inside an *already-running* interactive session produces a
role agent with **no `LOOM_ROLE` in its environment** — the session itself
was never spawned by any of the three paths above, so there is nothing for
a spawner to set. This case is structurally outside what an env-var
contract can cover (there is no spawn event to hook), and is handled
instead on the consumer side via a prompt-conditional directive. Do not
treat an unset `LOOM_ROLE` as proof no Loom role is active in the current
prompt — only as proof the *session* was not Loom-spawned.

A regression test pins this invariant against silent regression on the
`dispatch.rs` and `role_runner.rs` admission-success paths (the two call
sites gated by an `if let Some`) — see
`dispatch_sets_loom_role_from_admitted_role` (Issue #4768, pre-existing) and
`invoke_sets_loom_role_env_on_admitted_spawn` (Issue #6507) in
`loom-daemon/src/sweep_registry/dispatch.rs` and
`loom-daemon/src/role_runner.rs` respectively, plus
`test_run_sets_loom_role_session_env` in
`loom-daemon/src/agent_session/spawn.rs` for the unconditional tmux path.

`LOOM_RUNTIME`'s own contract is documented separately in
[`runtime-adapters.md`](runtime-adapters.md) — not covered here.

## Architecture (Phases A-C)

```
┌────────────────────────────────────────────────────────────────┐
│                      MCP clients (Claude Code)                 │
│  - dispatch_sweep, list_sweeps                          (A)    │
│  - publish_event, subscribe_to_events                   (B)    │
│  - get_sweep_status, tail_sweep_log, cancel_sweep       (C)    │
│  - tail_event_bus                                       (C)    │
└────────────────────────────────────────────────────────────────┘
                              │ stdio JSON-RPC
                              ▼
┌────────────────────────────────────────────────────────────────┐
│                    mcp-loom (TypeScript)                       │
│  - Validates args, normalizes payloads, formats output         │
│  - One MCP tool per IPC Request variant                        │
└────────────────────────────────────────────────────────────────┘
                              │ Unix socket, line-delimited JSON
                              ▼
┌────────────────────────────────────────────────────────────────┐
│                    loom-daemon (Rust)                          │
│  ┌──────────────────┐  ┌──────────────────┐  ┌──────────────┐  │
│  │ SweepRegistry    │  │ EventBus         │  │ ReaperTask   │  │
│  │ (BTreeMap)       │  │ (broadcast chan) │  │ (30s tick)   │  │
│  └──────────────────┘  └──────────────────┘  └──────────────┘  │
│                              │                                  │
│                              ▼                                  │
│                    fork+exec /loom:sweep N                      │
│                    via spawn-claude.sh                          │
└────────────────────────────────────────────────────────────────┘
                              │ detached child
                              ▼
                       /loom:sweep <issue>
                       (Claude Code session)
```

## IPC surface (Request/Response variants)

The wire protocol is line-delimited JSON. Each `Request` is one line; the
daemon responds with one line per request — except `SubscribeEvents`,
which holds the connection open and streams one `EventStream` frame per
event. Connection framing matches the existing terminal-management IPC
surface; no new transport is introduced.

Source of truth: [`loom-daemon/src/types.rs`](https://github.com/rjwalters/loom/blob/main/loom-daemon/src/types.rs)
(upstream Loom repo — not shipped to consumer installs).

| Request | MCP tool | Response | Phase |
|---|---|---|---|
| `DispatchSweep` | `dispatch_sweep` | `SweepDispatched` | A (#3452) |
| `ListSweeps` | `list_sweeps` | `SweepList` | A (#3452) |
| `PublishEvent` | `publish_event` | `EventPublished` | B (#3453) |
| `SubscribeEvents` | `subscribe_to_events`, `tail_event_bus` | `EventStream` (stream) | B (#3453) |
| `GetSweepStatus` | `get_sweep_status` | `SweepStatus` | C (#3455) |
| `TailSweepLog` | `tail_sweep_log` | `SweepLogTail` | C (#3455) |
| `CancelSweep` | `cancel_sweep` | `SweepCancelled` | C (#3455) |

## Event taxonomy (frozen for v0.10.0)

The bus accepts arbitrary topic strings, but the documented taxonomy is
the contract subscribers should rely on. **New topics require a follow-up
issue** — the v0.10.0 set is intentionally frozen.

| Topic | Publisher | Payload |
|---|---|---|
| `sweep.issue.{N}.phase` | Sweep child via `publish_event` | `{phase, pr_number?, repo?}` |
| `sweep.issue.{N}.blocker` | Sweep child | `{reason, label_added, repo?}` |
| `sweep.issue.{N}.exited`  | Daemon reaper (or `cancel_sweep`) | `{exit_code, duration_sec, no_progress, repo?}` |
| `sweep.issue.{N}.crashed` | Daemon reaper | `{checkpoint_phase, repo?}` |
| `sweep.issue.{N}.resume_dispatched` | Daemon reaper (#4256) | `{pr, checkpoint_phase?, dispatched, repo?}` |
| `sweep.global.dispatch` | Daemon | `{sweep_id, kind}` |
| `sweep.global.completed`  | Daemon | `{sweep_id, outcome}` |
| `epic.issue.{N}.decompose` | Epic supervisor (#3842) | `{epic, action, state}` |
| `epic.issue.{N}.expand` | Epic supervisor (#3842) | `{epic, action, state}` |
| `epic.issue.{N}.join` | Epic supervisor (#3842) | `{epic, action, state}` |
| `epic.issue.{N}.close` | Epic supervisor (#3842) | `{epic, action, state}` |
| `daemon.capacity.advisory` | Work finder (#3902) | `{pressured, queued, healthy_accounts, exhausted_accounts, total_accounts, estimated_drain_minutes?, message}` |
| `daemon.drain.started` | Drain supervisor (#4090) | `{in_flight, timeout_secs, force_after_timeout, deadline}` |
| `daemon.drain.completed` | Drain supervisor (#4090) | `{in_flight}` (always `0`) |
| `daemon.drain.aborted` | Daemon IPC (#4090) | `{was_draining}` |
| `daemon.drain.timeout` | Drain supervisor (#4090) | `{in_flight, forced, cancelled?, then_exit?, origin?, paused?, stragglers?}` |
| `daemon.drain.superseded`  | Auto-update loop (#8514) | `{from, to}` (artifact identities) |
| `daemon.roll.pause_started` | Pause-and-roll (#10831) | `{target_source, from_version, to_version, pause_budget_secs, verify_probation_secs, resume_budget_secs, min_resumable_age_secs}` |
| `daemon.roll.item` | Pause-and-roll (#10831) | `{manifest_id, item_id, kind, runtime, disposition, status, reason, agent_age_secs, issue, role, from_version, to_version, target_source, pause_budget_secs, verify_probation_secs, resume_budget_secs, min_resumable_age_secs, safe_point_wait_ms, teardown_ms, forge}` (one per agent; `forge` is `none`, `done` or `deferred`) |
| `daemon.roll.paused` | Pause-and-roll (#10831) | `{manifest_id, items, then_exit, from_version, to_version, target_source, pause_budget_secs, settle_secs, stop_secs, total_secs}` |
| `daemon.roll.pause_failed` | Pause-and-roll (#10831) | `{manifest_id, error, items?}` (the manifest could not be written, the pause task failed, or the H4 deadline passed, each before anything was stopped; dispatch resumed) |
| `daemon.roll.forced` | Pause-and-roll (#10831) | `{manifest_id, reason, forced_items, h4_deadline_secs}` (a pause that had already stopped an agent could not finish; the rest were killed by process group and the daemon restarts) |
| `daemon.roll.refused` | Pause-and-roll (#10831) | `{state, reason, target_source, to_version}` (`state`: `unsupervised`, `pause-failed`, `resume-pending`, `roll-attempt-backoff`; a standing refusal is published once, then at most every 5 minutes) |
| `daemon.roll.stood_down` | Pause-and-roll (#10831) | `{manifest_id, promoted, items}` (aborted, superseded or promoted before anything was stopped) |
| `daemon.roll.config_rejected` | Pause-and-roll (#10831) | `{reason}` (invalid `pauseRoll` budgets; defaults used) |
| `daemon.roll.item` (`stage: "resume"`) | Pause-and-roll resume (#10832) | `{stage, manifest_id, item_id, new_item_id, kind, runtime, disposition, status, reason, agent_age_secs, issue, role, from_version, to_version, running_version, resumed_on, verify_probation_secs, resume_budget_secs, forge}` (one per agent H5 resumed, requeued, completed or handed to restart recovery) |
| `daemon.roll.item.residue_reaped` | Pause-and-roll resume (#10832) | `{manifest_id, item_id, pids, survivors, scope_stopped}` (processes of a paused agent still alive at H5) |
| `daemon.roll.manifest.unreadable` | Pause-and-roll resume (#10832) | `{path, outcome, detail, running_version}` (`outcome`: `corrupt`, `unknown-version`; nothing is resumed, restart recovery takes every item) |
| `daemon.roll.health_failed` | Pause-and-roll resume (#10832) | `{manifest_id, reason, running_version, to_version, failures}` (health did not hold during probation; nothing is resumed until it does) |
| `daemon.roll.paused.resumed` | Pause-and-roll resume (#10832) | `{manifest_id, phase, from_version, to_version, running_version, resumed_on, items, resumed, completed, requeued_by_reason, recovered, residue_reaped, health_failures, verify_probation_secs, resume_budget_secs, probation_secs, resume_secs, pause_to_resume_secs, max_age_secs}` (`resumed_on`: `target` or `rollback`) |
| `forge.event` | `forge_events.rs` feed consumer (#8765) | `{source: "forge-event-feed", host_id, count, first_seq, last_seq, types}` |
| `operator_priority.escalation` | Star-liveness pass (#9321) | `{slug, issue, key, kind, stage, text, url, host, inherited_from?, resolved}` |

The four `epic.issue.{N}.*` topics were authorized by **#3873** (epic #3842
Phase 4) and are documented in full under [Epic supervisor](#epic-supervisor-3842)
below. The `daemon.capacity.advisory` topic was authorized by **#3902** (epic
#3809): the autonomous work finder publishes it on a token-capacity **pressure
state change** (entered/left the token-bound state), never every tick, so the
operator gets one add-capacity advisory on the way in and one recovery on the way
out. See [Token-capacity backpressure](#token-capacity-backpressure-3902-token-axis-retired-from-the-cap-by-5270) below.
Four of the `daemon.drain.*` topics were authorized by **#4090** for the scheduled
drain-and-restart primitive — `started` when a drain is accepted, `completed`
when the last in-flight sweep finishes (right before the supervised relaunch),
`aborted` when an operator cancels a drain, and `timeout` when the deadline is
reached (`forced` distinguishes an operator drain held paused from a
force-cancel restart). **#8514** adds `superseded`: the auto-update loop discarded
an armed roll that had not stopped any agent yet because a newer release artifact
had overtaken the one it was armed for, and re-armed for that newer artifact
instead. **#10831** removed `daemon.drain.roll_pending` (no roll is retained
across a deadline any more) and added the `daemon.roll.*` topics: every automatic
roll now pauses its agents and restarts, and narrates that here. See
[Supervised restart primitive](#supervised-restart-primitive-4054) below.
They ride the same in-memory bus as the sweep topics and are tailable via
`subscribe_to_events` / `tail_event_bus`.

The `forge.event` topic was authorized by **#8767** (epic #8764) for the forge
event-plane feed consumer. Publisher: `loom-daemon/src/forge_events.rs`
(#8765) — one `Event::Generic` per non-empty verified feed page. Payload:
`{source: "forge-event-feed", host_id: string, count: u64, first_seq: u64,
last_seq: u64, types: string[]}`, `types` being the page's event-type names
sorted and deduplicated. The payload is a **routing hint only, never decision
input** — it carries counts, sequence bounds and event-type names but no forge
state, so a consumer that wants state re-reads the forge through its normal
rate-limited clients and must be idempotent under the per-page dedup contract
(a prompt may arrive with the events themselves absent from the bus — the
on-disk journal is the copy, the prompt is a "check now"). Invariant source:
`docs/adr/0021-forge-event-plane.md` (ADR-0021); implementation:
`loom-daemon/src/forge_events.rs`.

The `operator_priority.escalation` topic was authorized by **#9321** (the
delivery half of #9244/#9301). Publisher: the star-liveness pass
(`loom-daemon/src/star_liveness/`); consumer: the Safehouse narration sink,
which renders it as a `handoff` envelope into the signal room so a starred
issue's operator ask reaches the human rather than sitting in a forge comment
nobody reads in time (#9268: four agents commented for seven hours). It is
emitted on a **state change** like the `*.advisory` topics, but keyed rather
than boolean: exactly once per `(repo, issue, <kind>:<specifics>)`, and **only
on the pass that actually posts that key's forge escalation comment**. That
coupling is what makes it once-per-cause *fleet-wide* rather than per-host — the
forge marker is the shared lock, so a peer host that finds the comment already
posted publishes nothing, and neither does a restarted daemon. A second event
with `resolved: true` fires once when the ask clears, from the host that
announced it. Room routing, the `safehouse.operatorMention` ping and the
rendered line are documented in
[`safehouse.md` → Operator-priority escalations](safehouse.md#operator-priority-escalations-9321).

**`Generic`-topic rule.** A `Generic` topic is allowed only while it (a) is
listed in this inventory, (b) carries a `source` field naming its producing
subsystem on every payload, and (c) never triggers a write to external state
without a forge-verified re-read in the consumer. `forge.event` satisfies all
three; every future prompt topic must too.

The four `sweep.issue.{N}.*` payloads gained an additive **`repo`** field in
**#3929** (`(repo, issue)`-aware sweep visibility, phase c of #3926). The bus is
shared across every managed repo, and the topic string is issue-scoped only —
two managed repos can each dispatch a sweep for issue #42 onto the *identical*
`sweep.issue.42.phase` topic. `repo` carries the owning registry's
`workspace_root`, so a multi-repo-aware subscriber can disambiguate them after
matching the topic. **The topic strings are unchanged** — `repo` lives in the
payload only, so existing single-repo subscribers that filter on `sweep.issue`
or `sweep.issue.{N}` route byte-for-byte identically and simply ignore the new
field. The daemon stamps `repo` centrally when it emits each event; a sweep
child that already knows its repo (via `publish_event`) may supply it and will
not be overwritten. `sweep.global.*` events are unchanged — they already carry a
unique `sweep_id`.

`sweep.issue.{N}.exited` gained an additive **`no_progress`** boolean field in
**#4366**. It classifies a checkpoint-less clean exit (`exit_code == Some(0)`)
as a genuine no-lifecycle-progress death (`true`) vs. an ordinary/benign exit
(`false`) — `true` requires ALL of: clean exit, no open PR linked to the issue,
and the issue still open. The reaper counts a `true` verdict toward the
insta-crash quarantine tally (via the same `record_terminal_outcome` path the
#3939 insta-crash arm uses) instead of resetting it, closing the gap where a
headless sweep that ends its turn parked on a monitored background task (e.g.
"cache download is running in the background... I'll pick this back up") exits
0 with zero checkpoint/PR progress and previously reset the tally forever,
letting the dispatch queue churn on it indefinitely. `#[serde(default)]` keeps
pre-#4366 wire data compatible (deserializes to `false`, matching prior
behavior). Gated on `!skip_label_flip` like the reaper's other real-forge
probes — under `skip_label_flip` the field is always `false` and no `gh` call
is made.

In addition, the bus internally emits:

- `sweep.system.topic_lag` — synthetic event when a subscription falls
  behind the publisher past the bus capacity. Mirrors tokio's `Lagged`
  semantics; carries `{skipped: usize}`.

Topic matching is **segment-aligned prefix** (`sweep.issue` matches
`sweep.issue.123.phase` but not `sweep.issuetype.foo`). See
[`event_bus::topic_matches`](https://github.com/rjwalters/loom/blob/main/loom-daemon/src/event_bus.rs)
(upstream Loom repo — not shipped to consumer installs) for the
authoritative routing rule.

## MCP tool reference

All tools live in `mcp-loom/src/tools/sweeps.ts`. Each tool name maps
1:1 to an IPC `Request` variant.

### `dispatch_sweep`

Spawn a `/loom:sweep` child via the daemon's registry. The daemon shells
out to `defaults/scripts/spawn-claude.sh` for token rotation and detaches
the child. Returns the `sweep_id`, child PID, token-account name, and
per-sweep log path.

Inputs:
- `kind` (required) — `{"Issue": <N>}` (spawns `/loom:sweep <N> --claim-owned
  <N>`, the full Curator/Builder/Judge/Doctor/Merge lifecycle for one issue)
  or `{"PrSet": [<n1>, <n2>, ...]}` (Mode C, issue #5342 — spawns
  `/loom:sweep --prs <n1> <n2> ...`, driving Judge/Doctor -> Judge/Merge for
  an existing PR set without re-running Curator/Builder). `PrSet` claims no
  issue and no `loom:building` label; each PR is claimed with its own
  `.loom/locks/pr-<N>/` lock, distinct from `Issue` dispatch's
  `.loom/locks/issue-<N>/`.
- `idempotency_key` (optional) — dedup key. Running sweeps with the same
  key return the existing `sweep_id` without spawning a new child.
- `model` (optional, issue #3477 Phase 1) — Claude model for the spawned
  child, as an alias (`sonnet`, `opus`, `haiku`) or a pinned ID
  (`claude-sonnet-4-6`). Forwarded as `--model <value>` on the
  `spawn-claude.sh` argv. When omitted (or empty), NO `--model` flag is
  emitted and the child inherits the session/CLI default. The field is
  `#[serde(default)]` on the wire, so pre-#3477 clients remain compatible.
- `depends_on` (optional, issue #3729 stacked-PR v1) — a **single** parent
  issue number this sweep is stacked on. Forwarded to the child as
  `--depends-on <N>` (mirroring the `--model`/`--effort` append-only,
  empty-means-unset contract), instructing `/loom:sweep` to branch the child
  worktree/PR off `feature/issue-<N>` instead of the default branch. When
  omitted, NO `--depends-on` flag is emitted (byte-for-byte unchanged). A
  single optional parent (not a list) makes diamonds / multi-parent stacks
  structurally unrepresentable — see "Stacked-PR dependency (v1)" below. The
  field is `#[serde(default)]` on the wire, so pre-#3729 clients remain
  compatible.
- `workspace_root` (optional, issue #3929) — target managed-workspace root.
  When set to a registered repo root, the daemon resolves that repo's sweep
  registry via the `WorkspacePool` and dispatches into its working tree — the
  way to dispatch into a managed repo other than the default when two repos
  share issue numbers. `#[serde(default)]` on the wire.

  **When omitted (issue #4299):** the daemon no longer blindly targets its own
  seeded default (cwd at startup / `LOOM_WORKSPACE`) — it consults the
  on-disk `~/.loom/workspaces.json` registry (`WorkspaceRegistry::resolve_dispatch_root`,
  `workspace_registry.rs`) in this order:
  1. **Registry empty** -> the seeded default (byte-for-byte pre-#4299 / pre-registry
     behavior).
  2. **Seeded default is itself registered** -> the seeded default. This is the
     back-compat floor: every existing multi-workspace host runs the daemon
     from a registered repo, so a bare dispatch with no `workspace_root` keeps
     working with no new flags.
  3. **Seeded default is NOT registered, exactly one workspace is registered**
     -> that workspace. This is the case a single-repo worker host (daemon cwd
     = the machine checkout, one product repo registered) needs: the sole
     registration is the only sane target.
  4. **Seeded default is NOT registered, multiple workspaces are registered**
     -> a structured `CONFIG_WORKSPACE_AMBIGUOUS` error naming every
     registered root. Issue numbers are per-repo, so guessing which repo
     "owns" issue N by probing the forge is ill-defined — an explicit
     `workspace_root`/`--workspace` is required instead. Never a silent cwd
     fallback.

  This resolution applies to the **dispatch path only**. `list_sweeps`,
  `get_sweep_status`, and quarantine requests keep their unconditional
  default-registry fallback for an absent `workspace_root` — read-path default
  behavior is unchanged (a deliberate scope limit; see the #4299 issue for the
  follow-up if that also needs to change).
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
