2AMLogic/gf180-sram/.loom/docs/observability.md

# Fleet Observability: end-to-end reference

> Epic [#4702](https://github.com/rjwalters/loom/issues/4702), Phase 4
> (#4860). This is the single entry point tying the whole pipeline together —
> **daemon config → wire schema → exporter → Cloudflare backend → dashboard
> views** — matching the map-plus-links pattern `daemon-reference.md` and
> `token-pool.md` already use. It is an operating summary, not a duplicate:
> every claim below has a canonical detail doc linked next to it, and this
> page should stay a map even as those detail docs grow.

<!-- toc:begin generated by scripts/check-doc-tocs.sh --fix; do not edit by hand -->
**Contents**
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
