2AMLogic/gf180-sram/measurements/characterization-report.md

# SRAM macro characterization report

Auto-generated by `measurements/generate_report.py` -- do not hand-edit. Regenerate with:

```bash
python3 measurements/generate_report.py > measurements/characterization-report.md
```

This is the single, current, aggregated artifact `spec/sram.md`'s Characterization section and klayout-tools `docs/design-evidence-tiers.md` item 8 ask for: per-spec-row performance (read SNM, hold SNM, write margin, read/write access time) across every one of the ratified 27-corner process x temperature x voltage PVT points (`spec/sram.md`, "Corner set"), plus the Monte Carlo / mismatch yield evidence (issue #26) over a deliberate 9-corner subset of that matrix (`sim/README.md`, "Which corners, and why not all of them"). Every number below is a read-only derivation from the append-only records already committed under `sim/` -- this script runs no simulation and edits no record.

**Netlist provenance**: schematic-level for every record cited here -- this repo has not yet produced a DRC/LVS-clean, extracted netlist (`layout/` is in progress). A post-layout re-run of any measurement would supersede its record and this report would be regenerated to reflect it. **Bitcell sizing status**: `design/README.md` records the current `bitcell_6t` sizing as "an independent first cut," not yet deliberately optimized for SNM or write margin -- the margins below are real evidence for this sizing, not yet informed by any such optimization pass.

**PDK-variant correction (2026-08-19, `spec/pdk-variant-decision.md` -- resolves #86)**: every source record embedded below was run against, and its own `PDK:` field cites, `gf180mcuC` -- those per-record citations are historical and unchanged, per this repo's append-only evidence convention (`sim/README.md`, "Append-only rule"). This repo's ratified PDK-variant pin is now `gf180mcuD` (`spec/pdk-variant-decision.md`), not `gf180mcuC`. That record shows directly -- not asserted -- that this correction changes no number on this page: the SPICE device model files every corner sweep and Monte Carlo campaign below actually sources (`sm141064.ngspice`, `sm141064_mim.ngspice`, `design.ngspice`, `smbb000149.ngspice`) are byte-identical between `gf180mcuC` and `gf180mcuD`; the two variants differ only in Metal5-scoped DRC/parasitic rules this repo's device-level testbenches never exercise. A `gf180mcuD` re-run would reproduce every value below unchanged.

## Provenance (staleness check)

Every number in this report traces to exactly one of the source records below -- the report is a derivation, not a restatement. If a newer record now exists under `sim/*/records/` or `sim/*/mc/records/` for any of these claims (i.e. the IDs below no longer match what `sim/lib/render_signoff_table.py`'s own `latest_record_for_claim` selects), this report is stale -- regenerate it with the command above. `scripts/ci/check_evidence_format.py` enforces this automatically on every PR, the same way it already enforces `sim/signoff-summary.md`'s freshness.

| Row | Kind | Source record | Record ID | Git sha | Timestamp |
|---|---|---|---|---|---|
| Read SNM | 27-corner PVT | `sim/read-snm/records/20260817-011523-4448966.md` | `20260817-011523-4448966` | `4448966` | 2026-08-17T01:15:53Z |
| Hold SNM | 27-corner PVT | `sim/hold-snm/records/20260817-011558-4448966.md` | `20260817-011558-4448966` | `4448966` | 2026-08-17T01:16:20Z |
| Write margin (WTV) | 27-corner PVT | `sim/write-margin/records/20260817-105029-ce56f59.md` | `20260817-105029-ce56f59` | `ce56f59` | 2026-08-17T10:50:50Z |
| Read access time (slowest) | 27-corner PVT | `sim/access-time/records/20260817-011948-4448966.md` | `20260817-011948-4448966` | `4448966` | 2026-08-17T01:20:00Z |
| Write access time (slowest) | 27-corner PVT | `sim/access-time/records/20260817-012005-4448966.md` | `20260817-012005-4448966` | `4448966` | 2026-08-17T01:20:17Z |
| Read SNM | Monte Carlo / yield (9-corner subset) | `sim/read-snm/mc/records/20260921-124232-cf5e975.md` | `20260921-124232-cf5e975` | `cf5e975` | 2026-09-21T12:44:29Z |
| Hold SNM | Monte Carlo / yield (9-corner subset) | `sim/hold-snm/mc/records/20260921-124534-cf5e975.md` | `20260921-124534-cf5e975` | `cf5e975` | 2026-09-21T12:47:16Z |
| Write margin | Monte Carlo / yield (9-corner subset) | `sim/write-margin/mc/records/20260921-124804-cf5e975.md` | `20260921-124804-cf5e975` | `cf5e975` | 2026-09-21T12:51:14Z |

## Per-spec-row summary (worst case across all 27 corners)

The extreme value across the full 27-corner matrix for each spec-row measurement -- the number a signoff review checks first. Full per-corner detail is in "Full 27-corner PVT results" below.

| Measurement | Extreme value | Corner | Verdict | Source record |
|---|---|---|---|---|
| Read SNM | 0.214599 V | `ff_125c_2.97v` | PASS | `sim/read-snm/records/20260817-011523-4448966.md` |
| Hold SNM | 0.930461 V | `ff_125c_2.97v` | PASS | `sim/hold-snm/records/20260817-011558-4448966.md` |
| Write margin (WTV) | 1.640530 V | `ff_125c_2.97v` | PASS | `sim/write-margin/records/20260817-105029-ce56f59.md` |
| Read access time (slowest) | 3.5718e-10 s | `ss_-40c_2.97v` | RECORDED | `sim/access-time/records/20260817-011948-4448966.md` |
| Write access time (slowest) | 8.4931e-11 s | `ss_125c_2.97v` | RECORDED | `sim/access-time/records/20260817-012005-4448966.md` |

## Monte Carlo / yield summary (9-corner subset)

Device-mismatch statistical evidence (issue #26), combined with -- not instead of -- the deterministic corner evidence above, per klayout-tools `docs/design-evidence-tiers.md` item 6. Each campaign draws 200 mismatch samples, 4 determinism-control samples (must reproduce the deterministic corner record exactly), and 100 negative-control samples (a deliberately degraded variant, which must show a detectably lower yield) per corner. No `target_yield` is declared -- `spec/sram.md` ratifies no yield target for these rows (open decision, issue #20) -- so these numbers are *reported* against the `> 0` spec limit via Cpk / sigma-to-spec, never graded pass/fail.

| Measurement | Corners sampled | Min Cpk | Min sigma-to-spec | Negative control | Source record |
|---|---|---|---|---|---|
| Read SNM | 9 | 2.5579 | 7.6739 | 9/9 detected | `sim/read-snm/mc/records/20260921-124232-cf5e975.md` |
| Hold SNM | 9 | 16.3717 | 49.1151 | 9/9 detected | `sim/hold-snm/mc/records/20260921-124534-cf5e975.md` |
| Write margin | 9 | 77.8920 | 233.6760 | 9/9 detected | `sim/write-margin/mc/records/20260921-124804-cf5e975.md` |

### Read SNM -- Monte Carlo / yield detail

Source: `sim/read-snm/mc/records/20260921-124232-cf5e975.md` (full record; raw per-sample logs, sample-set JSON, and the verbatim `klt yield` text report are linked from that file, not reproduced here).

- **Record ID**: `20260921-124232-cf5e975`
- **Kind**: Monte Carlo mismatch campaign + `klt yield` report (statistical evidence, klayout-tools `docs/design-evidence-tiers.md` item 6)
- **Claim**: spec/sram.md Characterization -- read SNM (Monte Carlo device mismatch, combined with the ratified 9-corner PVT matrix)
- **Testbench**: `sim/read-snm/testbench/tb_read_snm.spice`
- **Netlist provenance**: schematic (this repo has not yet produced an extracted netlist; a post-layout re-run would record `extracted` here and reference this record via **Supersedes**)
- **Corner matrix run**: 9 corner points from `spec/sram.md`'s ratified process x temperature x voltage set (`ff_-40c_2.97v`, `ff_25c_3.30v`, `ff_125c_2.97v`, `tt_-40c_3.63v`, `tt_25c_3.30v`, `tt_125c_2.97v`, `ss_-40c_3.63v`, `ss_25c_2.97v`, `ss_125c_3.63v`) -- a deliberate Monte Carlo subset, chosen per `sim/README.md` "Which corners, and why not all of them". MC results **combine with**, and never replace, the deterministic corner records under `sim/read-snm/records/`, which sweep that set exhaustively.
- **Statistical convention**: Monte Carlo, per-instance device mismatch only (`sw_stat_mismatch=1`; `delvto='mis_vth*sw_stat_mismatch' / mulu0='1-mis_k*sw_stat_mismatch' per nfet_03v3/pfet_03v3 instance`). Global/process variation is carried by the corner axis, not resampled -- so each corner is its own population and no estimate is pooled across corners.
- **Seed**: `20260817` (base). Per-sample seed = sha256(base_seed:corner_id:kind:sample_index), truncated to a positive 31-bit integer; delivered to ngspice as `.options seed=<derived>, one independent ngspice invocation per sample`.
- **Sample count**: 200 mismatch samples per corner, 4 determinism-control samples per corner, 100 negative-control samples per corner.
- **Spec limits**: `min = 0.0` V -- spec/sram.md 'Characterization' -- read SNM / hold SNM / write margin must be strictly positive at every corner. No `target_yield` is declared: `spec/sram.md` ratifies no yield target for these rows (that is exactly the open operator decision tracked as issue #20), and this harness does not invent one. The estimates below are therefore *reported* against the spec's own `> 0` limit, with Cpk / sigma-to-spec as the quantitative margin statement.
- **PDK**: `gf180mcuD`, open_pdks `c6d73a35f524070e85faff4a6a9eef49553ebc2b` -- **`klt`**: `klt 0.5.0+gfe6fe526388f.dirty` -- **git**: `cf5e975`
- **`klt yield` overall status**: `reported` (exit code 0)
- **Timestamp / author**: 2026-09-21T12:44:29Z / agent-builder
- **Supersedes**: (none)

#### Per-corner result (verbatim from the `klt yield` JSON report)

| Corner | N | errored | mean (V) | stddev (V) | empirical yield, 95% lower bound | Cpk | sigma-to-spec | sample-size verdict | negative control |
|---|---|---|---|---|---|---|---|---|---|
| `ff_-40c_2.97v` | 200 | 0 | 0.347325 | 0.0226316 | 0.981725 | 5.11564 | 15.3469 | sufficient | detected |
| `ff_25c_3.30v` | 200 | 0 | 0.293314 | 0.030682 | 0.981725 | 3.18661 | 9.55983 | sufficient | detected |
| `ff_125c_2.97v` | 200 | 0 | 0.214422 | 0.0279419 | 0.981725 | 2.55795 | 7.67386 | sufficient | detected |
| `tt_-40c_3.63v` | 200 | 0 | 0.457688 | 0.0212328 | 0.981725 | 7.18525 | 21.5557 | sufficient | detected |
| `tt_25c_3.30v` | 200 | 0 | 0.382673 | 0.0235576 | 0.981725 | 5.41472 | 16.2442 | sufficient | detected |
| `tt_125c_2.97v` | 200 | 0 | 0.293317 | 0.0230081 | 0.981725 | 4.24947 | 12.7484 | sufficient | detected |
| `ss_-40c_3.63v` | 200 | 0 | 0.562762 | 0.0212834 | 0.981725 | 8.81381 | 26.4414 | sufficient | detected |
| `ss_25c_2.97v` | 200 | 0 | 0.47458 | 0.0224131 | 0.981725 | 7.05806 | 21.1742 | sufficient | detected |
| `ss_125c_3.63v` | 200 | 0 | 0.406407 | 0.0240491 | 0.981725 | 5.63303 | 16.8991 | sufficient | detected |

`errored` counts draws that produced no usable measurement (for the SNM fixtures: a draw whose butterfly was not bistable, so no square exists to measure). `klt yield` excludes them from every statistic, so a record with a non-zero `errored` column states a yield estimate *conditioned on a measurable draw* -- read the errored count alongside it, never the yield alone.

#### Determinism control (mismatch off)

With `sw_stat_mismatch=0` the campaign must reproduce, exactly and identically for every draw, the number the deterministic corner sweep already recorded for the same corner. This is what ties the MC evidence to the ratified 27-corner evidence rather than leaving it a parallel, unanchored claim.

| Corner | N | errored | distinct value(s) (V) | verdict |
|---|---|---|---|---|
| `ff_-40c_2.97v` | 4 | 0 | 0.346745 | PINNED |
| `ff_25c_3.30v` | 4 | 0 | 0.29104 | PINNED |
| `ff_125c_2.97v` | 4 | 0 | 0.214599 | PINNED |
| `tt_-40c_3.63v` | 4 | 0 | 0.45802 | PINNED |
| `tt_25c_3.30v` | 4 | 0 | 0.381267 | PINNED |
| `tt_125c_2.97v` | 4 | 0 | 0.295443 | PINNED |
| `ss_-40c_3.63v` | 4 | 0 | 0.56375 | PINNED |
| `ss_25c_2.97v` | 4 | 0 | 0.475538 | PINNED |
| `ss_125c_3.63v` | 4 | 0 | 0.40862 | PINNED |

#### Negative control

Deliberate defect: **known-bad variant: sw_stat_mismatch=20 (20x the PDK's per-instance Vt/current-factor mismatch sigma)**, drawn with its own independent, reproducibly-derived seeds and analysed by `klt yield` against the *same* spec limits as the nominal measurement. A `detected` verdict means the control's empirical yield is lower **and** its exact (Clopper-Pearson) confidence interval does not overlap the nominal's -- i.e. these statistics demonstrably do detect a degraded design, rather than being assumed to.

#### `klt yield` run-level warnings

- no measurement declared a target_yield, so no yield claim was checked -- the estimates below are reported, never failed

### Hold SNM -- Monte Carlo / yield detail

Source: `sim/hold-snm/mc/records/20260921-124534-cf5e975.md` (full record; raw per-sample logs, sample-set JSON, and the verbatim `klt yield` text report are linked from that file, not reproduced here).

- **Record ID**: `20260921-124534-cf5e975`
- **Kind**: Monte Carlo mismatch campaign + `klt yield` report (statistical evidence, klayout-tools `docs/design-evidence-tiers.md` item 6)
- **Claim**: spec/sram.md Characterization -- hold SNM (Monte Carlo device mismatch, combined with the ratified 9-corner PVT matrix)
- **Testbench**: `sim/hold-snm/testbench/tb_hold_snm.spice`
- **Netlist provenance**: schematic (this repo has not yet produced an extracted netlist; a post-layout re-run would record `extracted` here and reference this record via **Supersedes**)
- **Corner matrix run**: 9 corner points from `spec/sram.md`'s ratified process x temperature x voltage set (`ff_-40c_2.97v`, `ff_25c_3.30v`, `ff_125c_2.97v`, `tt_-40c_3.63v`, `tt_25c_3.30v`, `tt_125c_2.97v`, `ss_-40c_3.63v`, `ss_25c_2.97v`, `ss_125c_3.63v`) -- a deliberate Monte Carlo subset, chosen per `sim/README.md` "Which corners, and why not all of them". MC results **combine with**, and never replace, the deterministic corner records under `sim/hold-snm/records/`, which sweep that set exhaustively.
- **Statistical convention**: Monte Carlo, per-instance device mismatch only (`sw_stat_mismatch=1`; `delvto='mis_vth*sw_stat_mismatch' / mulu0='1-mis_k*sw_stat_mismatch' per nfet_03v3/pfet_03v3 instance`). Global/process variation is carried by the corner axis, not resampled -- so each corner is its own population and no estimate is pooled across corners.
- **Seed**: `20260817` (base). Per-sample seed = sha256(base_seed:corner_id:kind:sample_index), truncated to a positive 31-bit integer; delivered to ngspice as `.options seed=<derived>, one independent ngspice invocation per sample`.
- **Sample count**: 200 mismatch samples per corner, 4 determinism-control samples per corner, 100 negative-control samples per corner.
- **Spec limits**: `min = 0.0` V -- spec/sram.md 'Characterization' -- read SNM / hold SNM / write margin must be strictly positive at every corner. No `target_yield` is declared: `spec/sram.md` ratifies no yield target for these rows (that is exactly the open operator decision tracked as issue #20), and this harness does not invent one. The estimates below are therefore *reported* against the spec's own `> 0` limit, with Cpk / sigma-to-spec as the quantitative margin statement.
- **PDK**: `gf180mcuD`, open_pdks `c6d73a35f524070e85faff4a6a9eef49553ebc2b` -- **`klt`**: `klt 0.5.0+gfe6fe526388f.dirty` -- **git**: `cf5e975`
- **`klt yield` overall status**: `reported` (exit code 0)
- **Timestamp / author**: 2026-09-21T12:47:16Z / agent-builder
- **Supersedes**: (none)

#### Per-corner result (verbatim from the `klt yield` JSON report)

| Corner | N | errored | mean (V) | stddev (V) | empirical yield, 95% lower bound | Cpk | sigma-to-spec | sample-size verdict | negative control |
|---|---|---|---|---|---|---|---|---|---|
| `ff_-40c_2.97v` | 200 | 0 | 1.00011 | 0.0173984 | 0.981725 | 19.161 | 57.4829 | sufficient | detected |
| `ff_25c_3.30v` | 200 | 0 | 1.05079 | 0.0196891 | 0.981725 | 17.7897 | 53.3692 | sufficient | detected |
| `ff_125c_2.97v` | 200 | 0 | 0.92988 | 0.0189327 | 0.981725 | 16.3717 | 49.1151 | sufficient | detected |
| `tt_-40c_3.63v` | 200 | 0 | 1.2129 | 0.017096 | 0.981725 | 23.6489 | 70.9466 | sufficient | detected |
| `tt_25c_3.30v` | 200 | 0 | 1.11069 | 0.0190448 | 0.981725 | 19.4399 | 58.3196 | sufficient | detected |
| `tt_125c_2.97v` | 200 | 0 | 0.993329 | 0.0166241 | 0.981725 | 19.9175 | 59.7524 | sufficient | detected |
| `ss_-40c_3.63v` | 200 | 0 | 1.26824 | 0.0168795 | 0.981725 | 25.0449 | 75.1348 | sufficient | detected |
| `ss_25c_2.97v` | 200 | 0 | 1.08155 | 0.0173882 | 0.981725 | 20.7335 | 62.2005 | sufficient | detected |
| `ss_125c_3.63v` | 200 | 0 | 1.215 | 0.0179754 | 0.981725 | 22.5308 | 67.5924 | sufficient | detected |

`errored` counts draws that produced no usable measurement (for the SNM fixtures: a draw whose butterfly was not bistable, so no square exists to measure). `klt yield` excludes them from every statistic, so a record with a non-zero `errored` column states a yield estimate *conditioned on a measurable draw* -- read the errored count alongside it, never the yield alone.

#### Determinism control (mismatch off)

With `sw_stat_mismatch=0` the campaign must reproduce, exactly and identically for every draw, the number the deterministic corner sweep already recorded for the same corner. This is what ties the MC evidence to the ratified 27-corner evidence rather than leaving it a parallel, unanchored claim.

| Corner | N | errored | distinct value(s) (V) | verdict |
|---|---|---|---|---|
| `ff_-40c_2.97v` | 4 | 0 | 0.999016 | PINNED |
| `ff_25c_3.30v` | 4 | 0 | 1.04859 | PINNED |
| `ff_125c_2.97v` | 4 | 0 | 0.930461 | PINNED |
| `tt_-40c_3.63v` | 4 | 0 | 1.21357 | PINNED |
| `tt_25c_3.30v` | 4 | 0 | 1.11081 | PINNED |
| `tt_125c_2.97v` | 4 | 0 | 0.99341 | PINNED |
| `ss_-40c_3.63v` | 4 | 0 | 1.26881 | PINNED |
| `ss_25c_2.97v` | 4 | 0 | 1.08238 | PINNED |
| `ss_125c_3.63v` | 4 | 0 | 1.21645 | PINNED |

#### Negative control

Deliberate defect: **known-bad variant: sw_stat_mismatch=12 (12x the PDK's per-instance Vt/current-factor mismatch sigma), VDD=0.50 V (below spec/sram.md's ratified 2.97 V minimum)**, drawn with its own independent, reproducibly-derived seeds and analysed by `klt yield` against the *same* spec limits as the nominal measurement. A `detected` verdict means the control's empirical yield is lower **and** its exact (Clopper-Pearson) confidence interval does not overlap the nominal's -- i.e. these statistics demonstrably do detect a degraded design, rather than being assumed to.

#### `klt yield` run-level warnings

- no measurement declared a target_yield, so no yield claim was checked -- the estimates below are reported, never failed

### Write margin -- Monte Carlo / yield detail

Source: `sim/write-margin/mc/records/20260921-124804-cf5e975.md` (full record; raw per-sample logs, sample-set JSON, and the verbatim `klt yield` text report are linked from that file, not reproduced here).

- **Record ID**: `20260921-124804-cf5e975`
- **Kind**: Monte Carlo mismatch campaign + `klt yield` report (statistical evidence, klayout-tools `docs/design-evidence-tiers.md` item 6)
- **Claim**: spec/sram.md Characterization -- write margin, as write trip voltage (Monte Carlo device mismatch, combined with the ratified 9-corner PVT matrix)
- **Testbench**: `sim/write-margin/testbench/tb_write_margin.spice`
- **Netlist provenance**: schematic (this repo has not yet produced an extracted netlist; a post-layout re-run would record `extracted` here and reference this record via **Supersedes**)
- **Corner matrix run**: 9 corner points from `spec/sram.md`'s ratified process x temperature x voltage set (`ff_-40c_2.97v`, `ff_25c_3.30v`, `ff_125c_2.97v`, `tt_-40c_3.63v`, `tt_25c_3.30v`, `tt_125c_2.97v`, `ss_-40c_3.63v`, `ss_25c_2.97v`, `ss_125c_3.63v`) -- a deliberate Monte Carlo subset, chosen per `sim/README.md` "Which corners, and why not all of them". MC results **combine with**, and never replace, the deterministic corner records under `sim/write-margin/records/`, which sweep that set exhaustively.
- **Statistical convention**: Monte Carlo, per-instance device mismatch only (`sw_stat_mismatch=1`; `delvto='mis_vth*sw_stat_mismatch' / mulu0='1-mis_k*sw_stat_mismatch' per nfet_03v3/pfet_03v3 instance`). Global/process variation is carried by the corner axis, not resampled -- so each corner is its own population and no estimate is pooled across corners.
- **Seed**: `20260817` (base). Per-sample seed = sha256(base_seed:corner_id:kind:sample_index), truncated to a positive 31-bit integer; delivered to ngspice as `.options seed=<derived>, one independent ngspice invocation per sample`.
- **Sample count**: 200 mismatch samples per corner, 4 determinism-control samples per corner, 100 negative-control samples per corner.
- **Spec limits**: `min = 0.0` V -- spec/sram.md 'Characterization' -- read SNM / hold SNM / write margin must be strictly positive at every corner. No `target_yield` is declared: `spec/sram.md` ratifies no yield target for these rows (that is exactly the open operator decision tracked as issue #20), and this harness does not invent one. The estimates below are therefore *reported* against the spec's own `> 0` limit, with Cpk / sigma-to-spec as the quantitative margin statement.
- **PDK**: `gf180mcuD`, open_pdks `c6d73a35f524070e85faff4a6a9eef49553ebc2b` -- **`klt`**: `klt 0.5.0+gfe6fe526388f.dirty` -- **git**: `cf5e975`
- **`klt yield` overall status**: `reported` (exit code 0)
- **Timestamp / author**: 2026-09-21T12:51:14Z / agent-builder
- **Supersedes**: (none)

#### Per-corner result (verbatim from the `klt yield` JSON report)

| Corner | N | errored | mean (V) | stddev (V) | empirical yield, 95% lower bound | Cpk | sigma-to-spec | sample-size verdict | negative control |
|---|---|---|---|---|---|---|---|---|---|
| `ff_-40c_2.97v` | 200 | 0 | 1.69603 | 0.00725803 | 0.981725 | 77.892 | 233.676 | sufficient | detected |
| `ff_25c_3.30v` | 200 | 0 | 1.87109 | 0.00640147 | 0.981725 | 97.4301 | 292.29 | sufficient | detected |
| `ff_125c_2.97v` | 200 | 0 | 1.63959 | 0.0063209 | 0.981725 | 86.4642 | 259.393 | sufficient | detected |
| `tt_-40c_3.63v` | 200 | 0 | 2.13283 | 0.0076442 | 0.981725 | 93.0041 | 279.012 | sufficient | detected |
| `tt_25c_3.30v` | 200 | 0 | 1.91095 | 0.00636431 | 0.981725 | 100.087 | 300.26 | sufficient | detected |
| `tt_125c_2.97v` | 200 | 0 | 1.67766 | 0.00489921 | 0.981725 | 114.145 | 342.435 | sufficient | detected |
| `ss_-40c_3.63v` | 200 | 0 | 2.17257 | 0.00697421 | 0.981725 | 103.838 | 311.515 | sufficient | detected |
| `ss_25c_2.97v` | 200 | 0 | 1.74226 | 0.00546601 | 0.981725 | 106.248 | 318.744 | sufficient | detected |
| `ss_125c_3.63v` | 200 | 0 | 2.10919 | 0.00524258 | 0.981725 | 134.106 | 402.319 | sufficient | detected |

`errored` counts draws that produced no usable measurement (for the SNM fixtures: a draw whose butterfly was not bistable, so no square exists to measure). `klt yield` excludes them from every statistic, so a record with a non-zero `errored` column states a yield estimate *conditioned on a measurable draw* -- read the errored count alongside it, never the yield alone.

#### Determinism control (mismatch off)

With `sw_stat_mismatch=0` the campaign must reproduce, exactly and identically for every draw, the number the deterministic corner sweep already recorded for the same corner. This is what ties the MC evidence to the ratified 27-corner evidence rather than leaving it a parallel, unanchored claim.

| Corner | N | errored | distinct value(s) (V) | verdict |
|---|---|---|---|---|
| `ff_-40c_2.97v` | 4 | 0 | 1.69546 | PINNED |
| `ff_25c_3.30v` | 4 | 0 | 1.87075 | PINNED |
| `ff_125c_2.97v` | 4 | 0 | 1.64053 | PINNED |
| `tt_-40c_3.63v` | 4 | 0 | 2.13271 | PINNED |
| `tt_25c_3.30v` | 4 | 0 | 1.91003 | PINNED |
| `tt_125c_2.97v` | 4 | 0 | 1.67751 | PINNED |
| `ss_-40c_3.63v` | 4 | 0 | 2.17259 | PINNED |
| `ss_25c_2.97v` | 4 | 0 | 1.74241 | PINNED |
| `ss_125c_3.63v` | 4 | 0 | 2.10967 | PINNED |

#### Negative control

Deliberate defect: **known-bad variant: sw_stat_mismatch=6 (6x the PDK's per-instance Vt/current-factor mismatch sigma), VDD=0.60 V (below spec/sram.md's ratified 2.97 V minimum)**, drawn with its own independent, reproducibly-derived seeds and analysed by `klt yield` against the *same* spec limits as the nominal measurement. A `detected` verdict means the control's empirical yield is lower **and** its exact (Clopper-Pearson) confidence interval does not overlap the nominal's -- i.e. these statistics demonstrably do detect a degraded design, rather than being assumed to.

#### `klt yield` run-level warnings

- no measurement declared a target_yield, so no yield claim was checked -- the estimates below are reported, never failed

## Full 27-corner PVT results

Embedded verbatim from `sim/lib/render_signoff_table.py`'s own output -- the identical generator `sim/signoff-summary.md` is built from, re-run fresh for this report so the two documents can never silently disagree.

### PVT signoff summary (derived, per-corner pass/fail)

Auto-generated by `sim/lib/render_signoff_table.py` -- do not hand-edit. Regenerate with:

```bash
python3 sim/lib/render_signoff_table.py > sim/signoff-summary.md
```

This document derives an explicit **per-corner, per-metric PASS/FAIL verdict** from the five append-only evidence records already committed under `sim/*/records/` (see `sim/README.md` for the record format and the append-only convention). It does not run any simulation and does not modify those records -- it is a read-only rollup, closing the one gap the 2026-08-17 curation pass on issue #25 identified: the source records report raw measured values plus a single aggregate `Overall: recorded` line, not a per-corner verdict against `spec/sram.md`'s Signoff definition.

#### Source records

- Read SNM: `sim/read-snm/records/20260817-011523-4448966.md`
- Hold SNM: `sim/hold-snm/records/20260817-011558-4448966.md`
- Write margin: `sim/write-margin/records/20260817-105029-ce56f59.md` (margin is `write_trip_voltage_v` (WTV) directly -- the minimum write-driver drive that still flips the cell)
- Read access time: `sim/access-time/records/20260817-011948-4448966.md`
- Write access time: `sim/access-time/records/20260817-012005-4448966.md`

#### Verdict rule (`spec/sram.md`, "### Signoff definition")

- Read SNM, hold SNM, write margin: **PASS** iff the recorded value is strictly `> 0` V; **FAIL** otherwise; **OPEN** if the source record has no valid measurement for that corner (see `sim/README.md` "Append-only rule").
- Read/write access time: `spec/sram.md` only requires these be **recorded**, not compared against a numeric threshold, so a corner with a valid measured value is marked **RECORDED**, not PASS/FAIL.

**Note on corner count**: the table below has 27 rows, one per distinct `process x temperature x voltage` combination actually swept by `sim/lib/run_corner_sweep.sh` (`3 x 3 x 3 = 27`), matching every one of the five source records above (each has exactly this many `- **<corner-id>**:` rows) and `spec/sram.md`'s "Corner set" section. That section computed the same product as "9 corners" until #53 corrected the arithmetic (3 x 3 x 3 = 27, not 9) -- see `spec/corner-count-correction.md`; the corner set, the Signoff definition, and every verdict below are unchanged by that correction. Records written before it still say "9 corner points" in their own generated prose while listing all 27 rows, because records are never edited after the fact (`sim/README.md`, "Append-only rule").

#### Per-corner results

| Corner | Read SNM (V) | Verdict | Hold SNM (V) | Verdict | Write margin (V) | Verdict | Read access time (s) | Verdict | Write access time (s) | Verdict | Row overall (SNM + margin) |
|---|---|---|---|---|---|---|---|---|---|---|---|
| ff_-40c_2.97v | 0.346745 | PASS | 0.999014 | PASS | 1.695460 | PASS | 1.4094e-10 | RECORDED | 4.7116e-11 | RECORDED | PASS |
| ff_-40c_3.30v | 0.348079 | PASS | 1.075028 | PASS | 1.891500 | PASS | 1.1791e-10 | RECORDED | 4.4605e-11 | RECORDED | PASS |
| ff_-40c_3.63v | 0.378868 | PASS | 1.150509 | PASS | 2.087960 | PASS | 1.0357e-10 | RECORDED | 4.2459e-11 | RECORDED | PASS |
| ff_25c_2.97v | 0.279259 | PASS | 0.972353 | PASS | 1.672980 | PASS | 1.4785e-10 | RECORDED | 5.0519e-11 | RECORDED | PASS |
| ff_25c_3.30v | 0.291040 | PASS | 1.048587 | PASS | 1.870750 | PASS | 1.2610e-10 | RECORDED | 4.7849e-11 | RECORDED | PASS |
| ff_25c_3.63v | 0.322552 | PASS | 1.124406 | PASS | 2.068910 | PASS | 1.1195e-10 | RECORDED | 4.5613e-11 | RECORDED | PASS |
| ff_125c_2.97v | 0.214599 | PASS | 0.930461 | PASS | 1.640530 | PASS | 1.5703e-10 | RECORDED | 5.7246e-11 | RECORDED | PASS |
| ff_125c_3.30v | 0.237829 | PASS | 1.008552 | PASS | 1.838120 | PASS | 1.3761e-10 | RECORDED | 5.3928e-11 | RECORDED | PASS |
| ff_125c_3.63v | 0.265005 | PASS | 1.087062 | PASS | 2.036110 | PASS | 1.2389e-10 | RECORDED | 5.1521e-11 | RECORDED | PASS |
| tt_-40c_2.97v | 0.443117 | PASS | 1.055088 | PASS | 1.738240 | PASS | 2.0899e-10 | RECORDED | 5.5771e-11 | RECORDED | PASS |
| tt_-40c_3.30v | 0.450044 | PASS | 1.134683 | PASS | 1.935810 | PASS | 1.6117e-10 | RECORDED | 5.2198e-11 | RECORDED | PASS |
| tt_-40c_3.63v | 0.458020 | PASS | 1.213568 | PASS | 2.132710 | PASS | 1.3429e-10 | RECORDED | 4.9423e-11 | RECORDED | PASS |
| tt_25c_2.97v | 0.377941 | PASS | 1.031028 | PASS | 1.711050 | PASS | 2.1229e-10 | RECORDED | 6.0738e-11 | RECORDED | PASS |
| tt_25c_3.30v | 0.381267 | PASS | 1.110807 | PASS | 1.910030 | PASS | 1.7014e-10 | RECORDED | 5.6764e-11 | RECORDED | PASS |
| tt_25c_3.63v | 0.385058 | PASS | 1.189934 | PASS | 2.109230 | PASS | 1.4485e-10 | RECORDED | 5.3568e-11 | RECORDED | PASS |
| tt_125c_2.97v | 0.295443 | PASS | 0.993408 | PASS | 1.677510 | PASS | 2.1819e-10 | RECORDED | 6.9354e-11 | RECORDED | PASS |
| tt_125c_3.30v | 0.296711 | PASS | 1.074566 | PASS | 1.877400 | PASS | 1.8293e-10 | RECORDED | 6.4782e-11 | RECORDED | PASS |
| tt_125c_3.63v | 0.318427 | PASS | 1.155746 | PASS | 2.077770 | PASS | 1.5948e-10 | RECORDED | 6.1280e-11 | RECORDED | PASS |
| ss_-40c_2.97v | 0.540536 | PASS | 1.105024 | PASS | 1.769780 | PASS | 3.5718e-10 | RECORDED | 6.7146e-11 | RECORDED | PASS |
| ss_-40c_3.30v | 0.550840 | PASS | 1.187215 | PASS | 1.972470 | PASS | 2.4039e-10 | RECORDED | 6.2505e-11 | RECORDED | PASS |
| ss_-40c_3.63v | 0.563750 | PASS | 1.268808 | PASS | 2.172590 | PASS | 1.8532e-10 | RECORDED | 5.8880e-11 | RECORDED | PASS |
| ss_25c_2.97v | 0.475538 | PASS | 1.082379 | PASS | 1.742410 | PASS | 3.3581e-10 | RECORDED | 7.3637e-11 | RECORDED | PASS |
| ss_25c_3.30v | 0.483481 | PASS | 1.165266 | PASS | 1.943660 | PASS | 2.4585e-10 | RECORDED | 6.8305e-11 | RECORDED | PASS |
| ss_25c_3.63v | 0.493503 | PASS | 1.247287 | PASS | 2.144230 | PASS | 1.9717e-10 | RECORDED | 6.4215e-11 | RECORDED | PASS |
| ss_125c_2.97v | 0.394239 | PASS | 1.048438 | PASS | 1.706340 | PASS | 3.2326e-10 | RECORDED | 8.4931e-11 | RECORDED | PASS |
| ss_125c_3.30v | 0.400760 | PASS | 1.132542 | PASS | 1.908220 | PASS | 2.5525e-10 | RECORDED | 7.8579e-11 | RECORDED | PASS |
| ss_125c_3.63v | 0.408620 | PASS | 1.216449 | PASS | 2.109670 | PASS | 2.1346e-10 | RECORDED | 7.3752e-11 | RECORDED | PASS |

#### Aggregate

- Read SNM: 27/27 PASS (min 0.214599 V)
- Hold SNM: 27/27 PASS (min 0.930461 V)
- Write margin: 27/27 PASS (min 1.640530 V)
- Read access time: 27/27 RECORDED
- Write access time: 27/27 RECORDED

**Overall signoff (read SNM + hold SNM + write margin, all 27 corner points, per `spec/sram.md`'s Signoff definition): PASS.**

Footnote on write-margin resolution: issue #47 (WTV recorded at the first *failing* sweep step rather than the last *succeeding* one) was fixed in #54 and closed; the write-margin record cited above is a post-fix re-run, so that off-by-one does not apply to any number in this table. What remains is the search's inherent resolution: `tb_write_margin.spice` sweeps the trip voltage on a `VDD/40` grid (~0.074 V at 2.97 V, ~0.091 V at 3.63 V), so the true trip point lies within one step above each recorded WTV and every write margin above is optimistic by at most one step. That bound is ~17x smaller than the smallest margin in the table, so no corner's PASS verdict turns on it.
