2AMLogic/gf180-sram/design/netlist/dff.spice

** sch_path: /home/ubuntu/GitHub/gf180-sram/.loom/worktrees/issue-173/design/dff.sch
.subckt dff d clk q qb VDD VSS
*.PININFO d:I clk:I q:O qb:O VDD:B VSS:B
XXckb clk ckb VDD VSS inv
XXckp ckb ckp VDD VSS inv
XXtm d ckb ckp m VDD VSS tg_s
XXnm m nm VDD VSS inv
XXmf nm mf VDD VSS inv
XXtmf mf ckp ckb m VDD VSS tg_s
XXts nm ckp ckb s VDD VSS tg_s
XXns s q VDD VSS inv
XXsf q qb VDD VSS inv
XXtsf qb ckb ckp s VDD VSS tg_s
.ends

* expanding   symbol:  inv.sym # of pins=4
** sym_path: /home/ubuntu/GitHub/gf180-sram/.loom/worktrees/issue-173/design/inv.sym
** sch_path: /home/ubuntu/GitHub/gf180-sram/.loom/worktrees/issue-173/design/inv.sch
.subckt inv a y VDD VSS

*.PININFO a:I y:O VDD:B VSS:B
XMP y a VDD VDD pfet_03v3 L=0.28u W=1u nf=1 ad='int((nf+1)/2) * W/nf * 0.18u' as='int((nf+2)/2) * W/nf * 0.18u'
+ pd='2*int((nf+1)/2) * (W/nf + 0.18u)' ps='2*int((nf+2)/2) * (W/nf + 0.18u)' nrd='0.18u / W' nrs='0.18u / W'
+ sa=0 sb=0 sd=0 m=1
XMN y a VSS VSS nfet_03v3 L=0.28u W=0.5u nf=1 ad='int((nf+1)/2) * W/nf * 0.18u' as='int((nf+2)/2) * W/nf * 0.18u'
+ pd='2*int((nf+1)/2) * (W/nf + 0.18u)' ps='2*int((nf+2)/2) * (W/nf + 0.18u)' nrd='0.18u / W' nrs='0.18u / W'
+ sa=0 sb=0 sd=0 m=1
.ends


* expanding   symbol:  tg_s.sym # of pins=6
** sym_path: /home/ubuntu/GitHub/gf180-sram/.loom/worktrees/issue-173/design/tg_s.sym
** sch_path: /home/ubuntu/GitHub/gf180-sram/.loom/worktrees/issue-173/design/tg_s.sch
.subckt tg_s a en enb b VDD VSS

*.PININFO a:I en:I enb:I b:B VDD:B VSS:B
XMN a en b VSS nfet_03v3 L=0.28u W=0.5u nf=1 ad='int((nf+1)/2) * W/nf * 0.18u' as='int((nf+2)/2) * W/nf * 0.18u'
+ pd='2*int((nf+1)/2) * (W/nf + 0.18u)' ps='2*int((nf+2)/2) * (W/nf + 0.18u)' nrd='0.18u / W' nrs='0.18u / W'
+ sa=0 sb=0 sd=0 m=1
XMP a enb b VDD pfet_03v3 L=0.28u W=1u nf=1 ad='int((nf+1)/2) * W/nf * 0.18u' as='int((nf+2)/2) * W/nf * 0.18u'
+ pd='2*int((nf+1)/2) * (W/nf + 0.18u)' ps='2*int((nf+2)/2) * (W/nf + 0.18u)' nrd='0.18u / W' nrs='0.18u / W'
+ sa=0 sb=0 sd=0 m=1
.ends

.end
