2AMLogic/gf180-sram/design/netlist/io_slice.spice

** sch_path: /home/ubuntu/GitHub/gf180-sram/.loom/worktrees/issue-203/design/io_slice.sch
.subckt io_slice csel0 csel1 csel2 csel3 cseln0 cseln1 cseln2 cseln3 d_in wen_in clk q_clk s_en
+ wl_en_n wpn q_out bl0 bl1 bl2 bl3 blb0 blb1 blb2 blb3 VDD VSS
*.PININFO csel0:I csel1:I csel2:I csel3:I cseln0:I cseln1:I cseln2:I cseln3:I d_in:I wen_in:I clk:I
*+ q_clk:I s_en:I wl_en_n:I wpn:I q_out:O bl0:B bl1:B bl2:B bl3:B blb0:B blb1:B blb2:B blb3:B VDD:B VSS:B
XXmb0 bl0 csel0 cseln0 mbl VDD VSS tg_mux
XXmn0 blb0 csel0 cseln0 mblb VDD VSS tg_mux
XXmb1 bl1 csel1 cseln1 mbl VDD VSS tg_mux
XXmn1 blb1 csel1 cseln1 mblb VDD VSS tg_mux
XXmb2 bl2 csel2 cseln2 mbl VDD VSS tg_mux
XXmn2 blb2 csel2 cseln2 mblb VDD VSS tg_mux
XXmb3 bl3 csel3 cseln3 mbl VDD VSS tg_mux
XXmn3 blb3 csel3 cseln3 mblb VDD VSS tg_mux
XXfd d_in clk dq dqb VDD VSS dff
XXfw wen_in clk wq wqb VDD VSS dff
XXwd dq wq wpn mbl mblb VDD VSS wdrv
XXsa s_en wl_en_n mbl mblb VDD VSS sa_latch
XXfq mbl q_clk q_out qnc VDD VSS dff
.ends

* expanding   symbol:  tg_mux.sym # of pins=6
** sym_path: /home/ubuntu/GitHub/gf180-sram/.loom/worktrees/issue-203/design/tg_mux.sym
** sch_path: /home/ubuntu/GitHub/gf180-sram/.loom/worktrees/issue-203/design/tg_mux.sch
.subckt tg_mux a en enb b VDD VSS

*.PININFO a:I en:I enb:I b:B VDD:B VSS:B
XMN a en b VSS nfet_03v3 L=0.28u W=2u nf=1 ad='int((nf+1)/2) * W/nf * 0.18u' as='int((nf+2)/2) * W/nf * 0.18u'
+ pd='2*int((nf+1)/2) * (W/nf + 0.18u)' ps='2*int((nf+2)/2) * (W/nf + 0.18u)' nrd='0.18u / W' nrs='0.18u / W'
+ sa=0 sb=0 sd=0 m=1
XMP a enb b VDD pfet_03v3 L=0.28u W=3u nf=1 ad='int((nf+1)/2) * W/nf * 0.18u' as='int((nf+2)/2) * W/nf * 0.18u'
+ pd='2*int((nf+1)/2) * (W/nf + 0.18u)' ps='2*int((nf+2)/2) * (W/nf + 0.18u)' nrd='0.18u / W' nrs='0.18u / W'
+ sa=0 sb=0 sd=0 m=1
.ends


* expanding   symbol:  dff.sym # of pins=6
** sym_path: /home/ubuntu/GitHub/gf180-sram/.loom/worktrees/issue-203/design/dff.sym
** sch_path: /home/ubuntu/GitHub/gf180-sram/.loom/worktrees/issue-203/design/dff.sch
.subckt dff d clk q qb VDD VSS

*.PININFO d:I clk:I q:O qb:O VDD:B VSS:B
XXckb clk ckb VDD VSS inv
XXckp ckb ckp VDD VSS inv
XXtm d ckb ckp m VDD VSS tg_s
XXnm m nm VDD VSS inv
XXmf nm mf VDD VSS inv
XXtmf mf ckp ckb m VDD VSS tg_s
XXts nm ckp ckb s VDD VSS tg_s
XXns s q VDD VSS inv
XXsf q qb VDD VSS inv
XXtsf qb ckb ckp s VDD VSS tg_s
.ends


* expanding   symbol:  wdrv.sym # of pins=7
** sym_path: /home/ubuntu/GitHub/gf180-sram/.loom/worktrees/issue-203/design/wdrv.sym
** sch_path: /home/ubuntu/GitHub/gf180-sram/.loom/worktrees/issue-203/design/wdrv.sch
.subckt wdrv d wen wpn bl blb VDD VSS

*.PININFO d:I wen:I wpn:I bl:B blb:B VDD:B VSS:B
XMNWL bl pl VSS VSS nfet_03v3 L=0.28u W=1.5u nf=1 ad='int((nf+1)/2) * W/nf * 0.18u' as='int((nf+2)/2) * W/nf * 0.18u'
+ pd='2*int((nf+1)/2) * (W/nf + 0.18u)' ps='2*int((nf+2)/2) * (W/nf + 0.18u)' nrd='0.18u / W' nrs='0.18u / W'
+ sa=0 sb=0 sd=0 m=1
XMNWR blb pr VSS VSS nfet_03v3 L=0.28u W=1.5u nf=1 ad='int((nf+1)/2) * W/nf * 0.18u' as='int((nf+2)/2) * W/nf * 0.18u'
+ pd='2*int((nf+1)/2) * (W/nf + 0.18u)' ps='2*int((nf+2)/2) * (W/nf + 0.18u)' nrd='0.18u / W' nrs='0.18u / W'
+ sa=0 sb=0 sd=0 m=1
XXdn d dn VDD VSS inv
XXpl wen wpn d pl VDD VSS nor3
XXpr wen wpn dn pr VDD VSS nor3
.ends


* expanding   symbol:  sa_latch.sym # of pins=6
** sym_path: /home/ubuntu/GitHub/gf180-sram/.loom/worktrees/issue-203/design/sa_latch.sym
** sch_path: /home/ubuntu/GitHub/gf180-sram/.loom/worktrees/issue-203/design/sa_latch.sch
.subckt sa_latch s_en eqn bl blb VDD VSS

*.PININFO s_en:I eqn:I bl:B blb:B VDD:B VSS:B
XMPA bl blb VDD VDD pfet_03v3 L=0.28u W=1u nf=1 ad='int((nf+1)/2) * W/nf * 0.18u' as='int((nf+2)/2) * W/nf * 0.18u'
+ pd='2*int((nf+1)/2) * (W/nf + 0.18u)' ps='2*int((nf+2)/2) * (W/nf + 0.18u)' nrd='0.18u / W' nrs='0.18u / W'
+ sa=0 sb=0 sd=0 m=1
XMPB blb bl VDD VDD pfet_03v3 L=0.28u W=1u nf=1 ad='int((nf+1)/2) * W/nf * 0.18u' as='int((nf+2)/2) * W/nf * 0.18u'
+ pd='2*int((nf+1)/2) * (W/nf + 0.18u)' ps='2*int((nf+2)/2) * (W/nf + 0.18u)' nrd='0.18u / W' nrs='0.18u / W'
+ sa=0 sb=0 sd=0 m=1
XMNA bl blb tail VSS nfet_03v3 L=0.28u W=1u nf=1 ad='int((nf+1)/2) * W/nf * 0.18u' as='int((nf+2)/2) * W/nf * 0.18u'
+ pd='2*int((nf+1)/2) * (W/nf + 0.18u)' ps='2*int((nf+2)/2) * (W/nf + 0.18u)' nrd='0.18u / W' nrs='0.18u / W'
+ sa=0 sb=0 sd=0 m=1
XMNB blb bl tail VSS nfet_03v3 L=0.28u W=1u nf=1 ad='int((nf+1)/2) * W/nf * 0.18u' as='int((nf+2)/2) * W/nf * 0.18u'
+ pd='2*int((nf+1)/2) * (W/nf + 0.18u)' ps='2*int((nf+2)/2) * (W/nf + 0.18u)' nrd='0.18u / W' nrs='0.18u / W'
+ sa=0 sb=0 sd=0 m=1
XMNT tail s_en VSS VSS nfet_03v3 L=0.28u W=2u nf=1 ad='int((nf+1)/2) * W/nf * 0.18u' as='int((nf+2)/2) * W/nf * 0.18u'
+ pd='2*int((nf+1)/2) * (W/nf + 0.18u)' ps='2*int((nf+2)/2) * (W/nf + 0.18u)' nrd='0.18u / W' nrs='0.18u / W'
+ sa=0 sb=0 sd=0 m=1
XMPE1 bl eqn VDD VDD pfet_03v3 L=0.28u W=1u nf=1 ad='int((nf+1)/2) * W/nf * 0.18u' as='int((nf+2)/2) * W/nf * 0.18u'
+ pd='2*int((nf+1)/2) * (W/nf + 0.18u)' ps='2*int((nf+2)/2) * (W/nf + 0.18u)' nrd='0.18u / W' nrs='0.18u / W'
+ sa=0 sb=0 sd=0 m=1
XMPE2 blb eqn VDD VDD pfet_03v3 L=0.28u W=1u nf=1 ad='int((nf+1)/2) * W/nf * 0.18u' as='int((nf+2)/2) * W/nf * 0.18u'
+ pd='2*int((nf+1)/2) * (W/nf + 0.18u)' ps='2*int((nf+2)/2) * (W/nf + 0.18u)' nrd='0.18u / W' nrs='0.18u / W'
+ sa=0 sb=0 sd=0 m=1
.ends


* expanding   symbol:  inv.sym # of pins=4
** sym_path: /home/ubuntu/GitHub/gf180-sram/.loom/worktrees/issue-203/design/inv.sym
** sch_path: /home/ubuntu/GitHub/gf180-sram/.loom/worktrees/issue-203/design/inv.sch
.subckt inv a y VDD VSS

*.PININFO a:I y:O VDD:B VSS:B
XMP y a VDD VDD pfet_03v3 L=0.28u W=1u nf=1 ad='int((nf+1)/2) * W/nf * 0.18u' as='int((nf+2)/2) * W/nf * 0.18u'
+ pd='2*int((nf+1)/2) * (W/nf + 0.18u)' ps='2*int((nf+2)/2) * (W/nf + 0.18u)' nrd='0.18u / W' nrs='0.18u / W'
+ sa=0 sb=0 sd=0 m=1
XMN y a VSS VSS nfet_03v3 L=0.28u W=0.5u nf=1 ad='int((nf+1)/2) * W/nf * 0.18u' as='int((nf+2)/2) * W/nf * 0.18u'
+ pd='2*int((nf+1)/2) * (W/nf + 0.18u)' ps='2*int((nf+2)/2) * (W/nf + 0.18u)' nrd='0.18u / W' nrs='0.18u / W'
+ sa=0 sb=0 sd=0 m=1
.ends


* expanding   symbol:  tg_s.sym # of pins=6
** sym_path: /home/ubuntu/GitHub/gf180-sram/.loom/worktrees/issue-203/design/tg_s.sym
** sch_path: /home/ubuntu/GitHub/gf180-sram/.loom/worktrees/issue-203/design/tg_s.sch
.subckt tg_s a en enb b VDD VSS

*.PININFO a:I en:I enb:I b:B VDD:B VSS:B
XMN a en b VSS nfet_03v3 L=0.28u W=0.5u nf=1 ad='int((nf+1)/2) * W/nf * 0.18u' as='int((nf+2)/2) * W/nf * 0.18u'
+ pd='2*int((nf+1)/2) * (W/nf + 0.18u)' ps='2*int((nf+2)/2) * (W/nf + 0.18u)' nrd='0.18u / W' nrs='0.18u / W'
+ sa=0 sb=0 sd=0 m=1
XMP a enb b VDD pfet_03v3 L=0.28u W=1u nf=1 ad='int((nf+1)/2) * W/nf * 0.18u' as='int((nf+2)/2) * W/nf * 0.18u'
+ pd='2*int((nf+1)/2) * (W/nf + 0.18u)' ps='2*int((nf+2)/2) * (W/nf + 0.18u)' nrd='0.18u / W' nrs='0.18u / W'
+ sa=0 sb=0 sd=0 m=1
.ends


* expanding   symbol:  nor3.sym # of pins=6
** sym_path: /home/ubuntu/GitHub/gf180-sram/.loom/worktrees/issue-203/design/nor3.sym
** sch_path: /home/ubuntu/GitHub/gf180-sram/.loom/worktrees/issue-203/design/nor3.sch
.subckt nor3 a0 a1 a2 y VDD VSS

*.PININFO a0:I a1:I a2:I y:O VDD:B VSS:B
XMP0 t1 a0 VDD VDD pfet_03v3 L=0.28u W=2u nf=1 ad='int((nf+1)/2) * W/nf * 0.18u' as='int((nf+2)/2) * W/nf * 0.18u'
+ pd='2*int((nf+1)/2) * (W/nf + 0.18u)' ps='2*int((nf+2)/2) * (W/nf + 0.18u)' nrd='0.18u / W' nrs='0.18u / W'
+ sa=0 sb=0 sd=0 m=1
XMP1 t2 a1 t1 VDD pfet_03v3 L=0.28u W=2u nf=1 ad='int((nf+1)/2) * W/nf * 0.18u' as='int((nf+2)/2) * W/nf * 0.18u'
+ pd='2*int((nf+1)/2) * (W/nf + 0.18u)' ps='2*int((nf+2)/2) * (W/nf + 0.18u)' nrd='0.18u / W' nrs='0.18u / W'
+ sa=0 sb=0 sd=0 m=1
XMP2 y a2 t2 VDD pfet_03v3 L=0.28u W=2u nf=1 ad='int((nf+1)/2) * W/nf * 0.18u' as='int((nf+2)/2) * W/nf * 0.18u'
+ pd='2*int((nf+1)/2) * (W/nf + 0.18u)' ps='2*int((nf+2)/2) * (W/nf + 0.18u)' nrd='0.18u / W' nrs='0.18u / W'
+ sa=0 sb=0 sd=0 m=1
XMN0 y a0 VSS VSS nfet_03v3 L=0.28u W=0.5u nf=1 ad='int((nf+1)/2) * W/nf * 0.18u' as='int((nf+2)/2) * W/nf * 0.18u'
+ pd='2*int((nf+1)/2) * (W/nf + 0.18u)' ps='2*int((nf+2)/2) * (W/nf + 0.18u)' nrd='0.18u / W' nrs='0.18u / W'
+ sa=0 sb=0 sd=0 m=1
XMN1 y a1 VSS VSS nfet_03v3 L=0.28u W=0.5u nf=1 ad='int((nf+1)/2) * W/nf * 0.18u' as='int((nf+2)/2) * W/nf * 0.18u'
+ pd='2*int((nf+1)/2) * (W/nf + 0.18u)' ps='2*int((nf+2)/2) * (W/nf + 0.18u)' nrd='0.18u / W' nrs='0.18u / W'
+ sa=0 sb=0 sd=0 m=1
XMN2 y a2 VSS VSS nfet_03v3 L=0.28u W=0.5u nf=1 ad='int((nf+1)/2) * W/nf * 0.18u' as='int((nf+2)/2) * W/nf * 0.18u'
+ pd='2*int((nf+1)/2) * (W/nf + 0.18u)' ps='2*int((nf+2)/2) * (W/nf + 0.18u)' nrd='0.18u / W' nrs='0.18u / W'
+ sa=0 sb=0 sd=0 m=1
.ends

.end
