2AMLogic/gf180-sram/design/netlist/sram_256x32_array.spice

** sch_path: /Users/rwalters/GitHub/gf180-sram/.loom/worktrees/issue-21/design/sram_256x32_array.sch
**.subckt sram_256x32_array WL0 WL1 WL2 WL3 WL4 WL5 WL6 WL7 WL8 WL9 WL10 WL11 WL12 WL13 WL14 WL15 WL16 WL17 WL18 WL19 WL20 WL21
*+ WL22 WL23 WL24 WL25 WL26 WL27 WL28 WL29 WL30 WL31 WL32 WL33 WL34 WL35 WL36 WL37 WL38 WL39 WL40 WL41 WL42 WL43 WL44 WL45 WL46 WL47 WL48
*+ WL49 WL50 WL51 WL52 WL53 WL54 WL55 WL56 WL57 WL58 WL59 WL60 WL61 WL62 WL63 WL64 WL65 WL66 WL67 WL68 WL69 WL70 WL71 WL72 WL73 WL74 WL75
*+ WL76 WL77 WL78 WL79 WL80 WL81 WL82 WL83 WL84 WL85 WL86 WL87 WL88 WL89 WL90 WL91 WL92 WL93 WL94 WL95 WL96 WL97 WL98 WL99 WL100 WL101
*+ WL102 WL103 WL104 WL105 WL106 WL107 WL108 WL109 WL110 WL111 WL112 WL113 WL114 WL115 WL116 WL117 WL118 WL119 WL120 WL121 WL122 WL123
*+ WL124 WL125 WL126 WL127 WL128 WL129 WL130 WL131 WL132 WL133 WL134 WL135 WL136 WL137 WL138 WL139 WL140 WL141 WL142 WL143 WL144 WL145
*+ WL146 WL147 WL148 WL149 WL150 WL151 WL152 WL153 WL154 WL155 WL156 WL157 WL158 WL159 WL160 WL161 WL162 WL163 WL164 WL165 WL166 WL167
*+ WL168 WL169 WL170 WL171 WL172 WL173 WL174 WL175 WL176 WL177 WL178 WL179 WL180 WL181 WL182 WL183 WL184 WL185 WL186 WL187 WL188 WL189
*+ WL190 WL191 WL192 WL193 WL194 WL195 WL196 WL197 WL198 WL199 WL200 WL201 WL202 WL203 WL204 WL205 WL206 WL207 WL208 WL209 WL210 WL211
*+ WL212 WL213 WL214 WL215 WL216 WL217 WL218 WL219 WL220 WL221 WL222 WL223 WL224 WL225 WL226 WL227 WL228 WL229 WL230 WL231 WL232 WL233
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
XXr17c18 BL18 BLB18 WL17 VDD VSS bitcell_6t
XXr17c19 BL19 BLB19 WL17 VDD VSS bitcell_6t
XXr17c20 BL20 BLB20 WL17 VDD VSS bitcell_6t
XXr17c21 BL21 BLB21 WL17 VDD VSS bitcell_6t
XXr17c22 BL22 BLB22 WL17 VDD VSS bitcell_6t
XXr17c23 BL23 BLB23 WL17 VDD VSS bitcell_6t
XXr17c24 BL24 BLB24 WL17 VDD VSS bitcell_6t
XXr17c25 BL25 BLB25 WL17 VDD VSS bitcell_6t
XXr17c26 BL26 BLB26 WL17 VDD VSS bitcell_6t
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
