2AMLogic/gf180-sram/sim/macro-smoke/netlist-snapshots/20261018-082302-37ba562.spice

* Macro write/read smoke -- klt sim circuit BODY (issue #217).
* GENERATED by sim/macro-smoke/smoke.py gen-klt -- do not hand-edit.
*
* Same circuit, reduced array and stimulus as tb_macro_write_read.spice, as a
* body for requests/macro_write_read.json: process/temperature come from the
* request's corners, the supply from `corners.supply_v.vvdd` (alters VVDD),
* and the stimuli track V(VDD) through B-sources. The DUT include is
* sram_256x32.noarray.spice, a checked-in copy of design/netlist/sram_256x32.spice
* with the `.subckt sram_64x128_array` block removed (ngspice keeps the first of
* two same-named subckts, and a body has no run.sh to strip it). Functional
* only; same Limits as the local testbench.
.include './sram_256x32.noarray.spice'
* PDK default params normally supplied by design.ngspice (via corner.inc)
.param sw_stat_global=0
.param sw_stat_mismatch=0
.param mc_skew=3
.param res_mc_skew=3
.param cap_mc_skew=3
.param fnoicor=0
VVDD VDD 0 DC 3.3
VVSS VSS 0 DC 0
.subckt sram_64x128_array WL0 WL1 WL2 WL3 WL4 WL5 WL6 WL7 WL8 WL9 WL10 WL11 WL12 WL13 WL14 WL15 WL16 WL17 WL18 WL19 WL20 WL21 WL22 WL23 WL24 WL25 WL26 WL27 WL28 WL29 WL30 WL31 WL32 WL33 WL34 WL35 WL36 WL37 WL38 WL39 WL40 WL41 WL42 WL43 WL44 WL45 WL46 WL47 WL48 WL49 WL50 WL51 WL52 WL53 WL54 WL55 WL56 WL57 WL58 WL59 WL60 WL61 WL62 WL63 BL0 BLB0 BL1 BLB1 BL2 BLB2 BL3 BLB3 BL4 BLB4 BL5 BLB5 BL6 BLB6 BL7 BLB7 BL8 BLB8 BL9 BLB9 BL10 BLB10 BL11 BLB11 BL12 BLB12 BL13 BLB13 BL14 BLB14 BL15 BLB15 BL16 BLB16 BL17 BLB17 BL18 BLB18 BL19 BLB19 BL20 BLB20 BL21 BLB21 BL22 BLB22 BL23 BLB23 BL24 BLB24 BL25 BLB25 BL26 BLB26 BL27 BLB27 BL28 BLB28 BL29 BLB29 BL30 BLB30 BL31 BLB31 BL32 BLB32 BL33 BLB33 BL34 BLB34 BL35 BLB35 BL36 BLB36 BL37 BLB37 BL38 BLB38 BL39 BLB39 BL40 BLB40 BL41 BLB41 BL42 BLB42 BL43 BLB43 BL44 BLB44 BL45 BLB45 BL46 BLB46 BL47 BLB47 BL48 BLB48 BL49 BLB49 BL50 BLB50 BL51 BLB51 BL52 BLB52 BL53 BLB53 BL54 BLB54 BL55 BLB55 BL56 BLB56 BL57 BLB57 BL58 BLB58 BL59 BLB59 BL60 BLB60 BL61 BLB61 BL62 BLB62 BL63 BLB63 BL64 BLB64 BL65 BLB65 BL66 BLB66 BL67 BLB67 BL68 BLB68 BL69 BLB69 BL70 BLB70 BL71 BLB71 BL72 BLB72 BL73 BLB73 BL74 BLB74 BL75 BLB75 BL76 BLB76 BL77 BLB77 BL78 BLB78 BL79 BLB79 BL80 BLB80 BL81 BLB81 BL82 BLB82 BL83 BLB83 BL84 BLB84 BL85 BLB85 BL86 BLB86 BL87 BLB87 BL88 BLB88 BL89 BLB89 BL90 BLB90 BL91 BLB91 BL92 BLB92 BL93 BLB93 BL94 BLB94 BL95 BLB95 BL96 BLB96 BL97 BLB97 BL98 BLB98 BL99 BLB99 BL100 BLB100 BL101 BLB101 BL102 BLB102 BL103 BLB103 BL104 BLB104 BL105 BLB105 BL106 BLB106 BL107 BLB107 BL108 BLB108 BL109 BLB109 BL110 BLB110 BL111 BLB111 BL112 BLB112 BL113 BLB113 BL114 BLB114 BL115 BLB115 BL116 BLB116 BL117 BLB117 BL118 BLB118 BL119 BLB119 BL120 BLB120 BL121 BLB121 BL122 BLB122 BL123 BLB123 BL124 BLB124 BL125 BLB125 BL126 BLB126 BL127 BLB127 VDD VSS
Xr0c0 BL0 BLB0 WL0 VDD VSS bitcell_6t
Xr0c1 BL1 BLB1 WL0 VDD VSS bitcell_6t
Xr0c2 BL2 BLB2 WL0 VDD VSS bitcell_6t
Xr0c3 BL3 BLB3 WL0 VDD VSS bitcell_6t
Xr0c4 BL4 BLB4 WL0 VDD VSS bitcell_6t
Xr0c5 BL5 BLB5 WL0 VDD VSS bitcell_6t
Xr0c6 BL6 BLB6 WL0 VDD VSS bitcell_6t
Xr0c7 BL7 BLB7 WL0 VDD VSS bitcell_6t
Xr0c8 BL8 BLB8 WL0 VDD VSS bitcell_6t
Xr0c9 BL9 BLB9 WL0 VDD VSS bitcell_6t
Xr0c10 BL10 BLB10 WL0 VDD VSS bitcell_6t
Xr0c11 BL11 BLB11 WL0 VDD VSS bitcell_6t
Xr0c12 BL12 BLB12 WL0 VDD VSS bitcell_6t
Xr0c13 BL13 BLB13 WL0 VDD VSS bitcell_6t
Xr0c14 BL14 BLB14 WL0 VDD VSS bitcell_6t
Xr0c15 BL15 BLB15 WL0 VDD VSS bitcell_6t
Xr0c16 BL16 BLB16 WL0 VDD VSS bitcell_6t
Xr0c17 BL17 BLB17 WL0 VDD VSS bitcell_6t
Xr0c18 BL18 BLB18 WL0 VDD VSS bitcell_6t
Xr0c19 BL19 BLB19 WL0 VDD VSS bitcell_6t
Xr0c20 BL20 BLB20 WL0 VDD VSS bitcell_6t
Xr0c21 BL21 BLB21 WL0 VDD VSS bitcell_6t
Xr0c22 BL22 BLB22 WL0 VDD VSS bitcell_6t
Xr0c23 BL23 BLB23 WL0 VDD VSS bitcell_6t
Xr0c24 BL24 BLB24 WL0 VDD VSS bitcell_6t
Xr0c25 BL25 BLB25 WL0 VDD VSS bitcell_6t
Xr0c26 BL26 BLB26 WL0 VDD VSS bitcell_6t
Xr0c27 BL27 BLB27 WL0 VDD VSS bitcell_6t
Xr0c28 BL28 BLB28 WL0 VDD VSS bitcell_6t
Xr0c29 BL29 BLB29 WL0 VDD VSS bitcell_6t
Xr0c30 BL30 BLB30 WL0 VDD VSS bitcell_6t
Xr0c31 BL31 BLB31 WL0 VDD VSS bitcell_6t
Xr0c32 BL32 BLB32 WL0 VDD VSS bitcell_6t
Xr0c33 BL33 BLB33 WL0 VDD VSS bitcell_6t
Xr0c34 BL34 BLB34 WL0 VDD VSS bitcell_6t
Xr0c35 BL35 BLB35 WL0 VDD VSS bitcell_6t
Xr0c36 BL36 BLB36 WL0 VDD VSS bitcell_6t
Xr0c37 BL37 BLB37 WL0 VDD VSS bitcell_6t
Xr0c38 BL38 BLB38 WL0 VDD VSS bitcell_6t
Xr0c39 BL39 BLB39 WL0 VDD VSS bitcell_6t
Xr0c40 BL40 BLB40 WL0 VDD VSS bitcell_6t
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
Cbl108 BL108 VSS 20f
Cblb108 BLB108 VSS 20f
Cbl109 BL109 VSS 20f
Cblb109 BLB109 VSS 20f
Cbl110 BL110 VSS 20f
Cblb110 BLB110 VSS 20f
Cbl111 BL111 VSS 20f
Cblb111 BLB111 VSS 20f
Cbl112 BL112 VSS 20f
Cblb112 BLB112 VSS 20f
Cbl113 BL113 VSS 20f
Cblb113 BLB113 VSS 20f
Cbl114 BL114 VSS 20f
Cblb114 BLB114 VSS 20f
Cbl115 BL115 VSS 20f
Cblb115 BLB115 VSS 20f
Cbl116 BL116 VSS 20f
Cblb116 BLB116 VSS 20f
Cbl117 BL117 VSS 20f
Cblb117 BLB117 VSS 20f
Cbl118 BL118 VSS 20f
Cblb118 BLB118 VSS 20f
Cbl119 BL119 VSS 20f
Cblb119 BLB119 VSS 20f
Cbl120 BL120 VSS 20f
Cblb120 BLB120 VSS 20f
Cbl121 BL121 VSS 20f
Cblb121 BLB121 VSS 20f
Cbl122 BL122 VSS 20f
Cblb122 BLB122 VSS 20f
Cbl123 BL123 VSS 20f
Cblb123 BLB123 VSS 20f
Cbl124 BL124 VSS 20f
Cblb124 BLB124 VSS 20f
Cbl125 BL125 VSS 20f
Cblb125 BLB125 VSS 20f
Cbl126 BL126 VSS 20f
Cblb126 BLB126 VSS 20f
Cbl127 BL127 VSS 20f
Cblb127 BLB127 VSS 20f
.ends
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
