2AMLogic/gf180-sram/(commit log)

2026-08-05 docs: ratify target spec into spec/sram.md, replace README DRAFT table (#5)
    * docs: ratify target spec into spec/sram.md, replace README DRAFT table
    Resolves the four open decisions (organization, ports, deliverables,
    characterization) left from the DRAFT spec table in README.md: fixes
    a 256x32 (1 kB) single fixed instance as the target organization with
    a parameterized generator as stretch, carries forward the 1RW/1RW1R
    and GDS+LEF+Liberty conclusions already corroborated by
    spec/bitcell-decision.md, and defines what "functional across PVT"
    means for this macro (read/hold/write margins over a 9-corner
    process x temperature x voltage set) for the first time.
    README.md's spec table is repla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
2026-08-10 chore(repo-skills): install Repo Skills 0.10.0
    This repo had NO Repo Skills install at all — not a stale one. A third of the
    fleet was in that state, which reframes 2AMLogic/2am#56: that issue reads as
    "0.8.1 landed only in 2am", but nine repos had never had the tool, including
    canaries that carry the destructive-command guard the rest of the toolchain
    assumes is present.
    Committed straight to main rather than via a per-repo branch. The 0.8.1
    rollout used branch-per-repo and seven of those branches were abandoned
    mid-flight, leaving their repos parked off trunk and invisible —
    compute-drift.sh's axis 3 compares a checkout against its OWN branch, so a
    repo current with a stale branch rep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
2026-08-16 design: commit 6T bitcell + 256x32 array schematics and derived netlists (#21) (#37)
    Lands T1 checklist item 1: design/ previously held only a placeholder
    README. Adds a real, xschem-captured 6T bitcell (gf180mcu nfet_03v3/
    pfet_03v3, cross-coupled inverter pair + differential access transistors)
    and the spec/sram.md-ratified 256 x 32 bitcell-array core, tiled by a
    generator script since 8,192 hand-placed instances is not a GUI task.
    Both schematics netlist cleanly via xschem's batch netlister with zero
    errors/warnings; netlist regeneration was verified reproducible
    byte-for-byte across repeated runs (generator output and both .spice
    files), and the bitcell was sanity-checked in ngspice (ho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
    [bitcell_6t.sch, sram_256x32_array.sch]
2026-08-16 layout: add 256x32 array-tiling generator infra with placeholder bitcell (#36)
    klt has no bitcell/memory-array generator (klt gen's primitives are all
    generic matched-device families) and gen-compose has no grid/repeat
    placement strategy for a large regular tiling, so a bespoke klayout.db
    generator (the same pattern gf180-bandgap's layout/bandgap_top/generate.py
    establishes) is used instead. Filed the gen-compose gap generically at
    klayout-tools#1053.
    design/ (issue #21, T1 item 1) has not landed a schematic/netlist yet, so
    there is no device sizing to draw a real 6T bitcell from. This commits the
    array-tiling/hierarchy machinery only, proven end-to-end against an
    explicitly-labeled placeho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
2026-08-17 sim: add 9-corner PVT testbenches for read SNM, hold SNM, write margin, and access time (#46)
    Implements the ratified spec/sram.md Characterization measurements as
    runnable ngspice testbenches, each swept across the full 9-corner PVT
    matrix ({ff,tt,ss} x {-40,25,125}C x {2.97,3.30,3.63}V) against the
    committed bitcell_6t netlist, following gf180-bandgap's append-only
    evidence-record convention (record-id/corner-id, netlist snapshots,
    raw per-corner logs, summary records under records/).
    - sim/read-snm, sim/hold-snm: device-level half-cell replicas with a
    butterfly-curve SNM extraction (sim/lib/snm_extract.py), since the
    DUT's Q/QB nodes can't be decoupled without editing bitcell_6t.
    - s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
2026-08-17 docs: Guide document maintenance update (#48)
    * docs: update WORK_LOG, WORK_PLAN, and README
    Automated document maintenance by Guide triage agent.
    * docs: correct README maturity-ladder wording on write margin status
    Judge review on PR #48 found the README's new "Current position" line
    inaccurately singled out write margin as still in progress. All four
    sim/ record files from PR #46 (read SNM, hold SNM, write margin,
    access-time) show identical "Overall: recorded" status across all 9
    PVT corners -- what's actually outstanding is the formal per-corner
    pass/fail synthesis against spec/sram.md's signoff requirement, which
    applies equally to all four measurements.
    ---------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
2026-08-17 fix: record last-succeeding write trial in write-margin WTV sweep (#54)
    tb_write_margin.spice's dowhile loop recorded the first vw where the
    write FAILED as the write trip voltage, off by one sweep step
    (vddc_ctl/40, ~2.5% of VDD) from the last vw that still succeeded --
    which is what the testbench's own header comment and sim/README.md
    define WTV to be. Track the prior iteration's vw (vw_prev) and record
    that on first failure instead.
    Re-ran the 9-corner PVT sweep; write_trip_voltage_v shifted down by
    exactly one sweep step at every corner relative to the prior record,
    confirming the fix (new record: sim/write-margin/records/20260817-030501-7cdc2da.md).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
2026-08-17 layout: draw the device-level 6T bitcell and tile it into the 256x32 array (#55)
    Replaces the placeholder outline box (PR #36, drawn before design/ existed)
    with the real transistor-level layout of design/bitcell_6t.sch, and the
    placeholder array with a 256x32 tiling of it.
    The bitcell draws all six devices on gf180mcu layers, sized from the
    committed netlist (pull-up W=0.22, pull-down W=0.36, access W=0.24, all
    L=0.28 um) with each W drawn as the device's poly/COMP channel overlap, so
    extraction reads those numbers back. Four NMOS devices share one stepped COMP
    strip, the two pull-ups share a second inside Nwell, each inverter's n/p gate
    is a single poly stripe, and cross-coupling uses two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
2026-08-17 sim: add Monte Carlo mismatch campaigns and klt yield reports for the three stability margins (#58)
    * sim: add Monte Carlo mismatch campaigns and klt yield reports for the three stability margins
    Adds sim/lib/run_mc_campaign.py, a mismatch Monte Carlo driver that runs an
    existing testbench across a subset of spec/sram.md's ratified corner set and
    emits a klt yield sample-set document, JSON/text yield report, per-sample raw
    logs, and an append-only Markdown record. Committed records cover read SNM,
    hold SNM, and write margin at 9 corner points each, N=200 mismatch draws per
    corner, base seed 20260817.
    Each campaign carries two controls. The determinism control (mismatch off)
    must collapse o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
2026-08-17 fix: report write margin as WTV directly instead of VDD - WTV (#61)
    sim/lib/render_signoff_table.py derived the signoff table's write-margin
    column as write_vdd_v - write_trip_voltage_v, which gets larger as a
    cell gets harder to write and would score an unwritable cell (WTV <= 0)
    as the largest margin of any corner. spec/sram.md defines write margin
    as the minimum drive that flips the cell -- WTV itself, since a real
    write driver presents 0 V -- matching how tb_write_margin.spice and the
    Monte Carlo yield campaigns already treat it.
    Swap the three write-margin-formula call sites in
    render_signoff_table.py (docstring verdict rule, per-corner wm_v
    computation, Source records label) to use wr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
2026-08-17 feat: add aggregated per-corner + MC/yield characterization report (#62)
    Adds measurements/generate_report.py, which derives a single aggregated
    characterization document (measurements/characterization-report.md) from
    the append-only sim/ evidence records: worst-case read SNM, hold SNM,
    write margin, and read/write access time across the ratified 27-corner
    PVT matrix, plus Monte Carlo / yield evidence (issue #26) over its
    9-corner subset. Every number cites the sim/ record it rests on, and the
    report reuses sim/lib/render_signoff_table.py directly for the embedded
    27-corner detail so the two documents can never disagree.
    Extends scripts/ci/check_evidence_format.py with a freshness check
    (mi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
2026-08-17 fix: exclude >/>> redirection tokens and resolve cd's tracked var in write-confinement scan (#72)
    extract_write_targets() had no >/>> exclusion analogous to the existing
    stdin_redir (<) exclusion (#5369), so tee/sed -i/cp/mv misread a trailing
    redirection (cp a b/ 2>/dev/null, mv a b >log, tee f 2>/dev/null, sed -i ""
    "s/a/b/" f 2>/dev/null) as one of their own operands -- false-denying tee/sed
    and, worse, letting the redirection token displace cp/mv's real destination
    entirely (a genuine worktree-confinement bypass). Added a stdout_redir
    exclusion set mirroring stdin_redir and wired it into all three loops.
    The cd branch also never ran the same-command resolve_var() resolution
    already appl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
2026-08-17 docs: record the gf180mcu macro ceiling and a KB-scale integration path (#74)
    The open PDK's foundry SRAM IP tops out at one 512x8 (0.5 KB) macro; an
    integrator needing 8-32 KB has to tile it, reach for DFFRAM, or use
    OpenRAM, and none of that was documented. Add spec/kb-scale-integration.md
    with measured macro-area/timing data (PDK LEF/Liberty), a live-checked
    DFFRAM gf180mcu status, the still-current OpenRAM finding, evidence tiers
    on every figure, and a one-line note on the kit's lack of dense NVM. Link
    it from README.md and spec/README.md, and state plainly that this repo's
    own custom macro is neither a wrapper over the foundry macros nor a
    KB-scale replacement for them.
    Closes #73
    Co-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
2026-08-18 fix(layout): derive LVS reference bulk-net rewrite from actual extraction, not hardcoded names (#76)
    klt's gf180mcu extraction deck picked up an upstream fix
    (klayout-tools#1113) that derives well/substrate tap connectivity from the
    drawn Nplus/Pplus implants, so this cell's ties now fold straight into
    VDD/VSS instead of landing on synthesized vsubs/vnw nets. layout/verify.sh
    --quick's documented reproduction hardcoded those old net names in
    lvs_reference.py, so it kept rewriting the reference away from VDD/VSS and
    turned what should be a clean match into an 8-mismatch failure (#75).
    lvs_reference.py now takes --layout-netlist and derives each device type's
    actual bulk net from a real klt e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
2026-08-18 fix(guard): restore for-loop binding (#66) and symlinked-root physical resolution (#70) wiped by the Loom resync (#80)
    `npm run check:ci` has been red on main since 2f8fdd8 ("chore: resync
    installed Loom surfaces"), which replaced .loom/hooks/guard-destructive-generic.sh
    wholesale with the upstream Loom package copy (1282 insertions / 767
    deletions). That overwrite silently discarded local fixes that had landed in
    this repo but were never upstreamed. Two of them are gated by check:ci and are
    restored here.
    (a1-a5) `for NAME in <words>` loop-variable binding, originally #66/1f15f86.
    loopmap / loop_word_confined() / resolve_loop() / resolve_wtarget() were gone
    entirely, so an in-worktree `for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
2026-08-19 docs(spec): ratify this block's T1 evidence-tier kind as analog (#89)
    Adds spec/block-kind-decision.md, a decision record answering
    klayout-tools/docs/design-evidence-tiers.md's "Block kind" requirement
    against what is actually ratified today (spec/bitcell-decision.md's
    custom-bitcell/array decision and spec/sram.md's xschem+ngspice PVT
    characterization) — both full-custom, transistor-level work with no
    RTL/digital-synthesis flow in scope. spec/sram.md gains an additive
    "Block kind" pointer under Characterization; no existing ratified line
    changes. spec/README.md's index gains a matching bullet.
2026-08-19 fix(spec): pin gf180mcuD PDK variant, not gf180mcuC (#87)
    Adds spec/pdk-variant-decision.md ratifying gf180mcuD (fleet-wide
    gf180-tmds-tx#9 DR-0006 ruling: wafer.space's GF180MCU shuttle stack is D,
    not C) at the already-cited open_pdks commit, with direct evidence that no
    sim/ or layout/ result is sensitive to the C-vs-D Metal5 delta: this repo's
    SPICE model files, the foundry reference macro's GDS/SPICE/LEF, and klt's
    curated DRC/LVS deck are all byte-identical or variant-agnostic, and this
    repo's own layout never draws Metal4/Metal5.
    Re-cites design/README.md and layout/README.md's "Tool / PDK versions",
    corrects the default-variant fallback in design/xschemrc and
    sim/lib/pdk_env.sh (was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
2026-08-21 spec: ratify no numeric target_yield for read/hold SNM and write margin (#93)
    Resolves #90, the follow-up statistical-treatment-decision.md (#20)
    explicitly deferred. Adds spec/target-yield-decision.md ratifying
    Cpk/sigma-to-spec/empirical-yield-lower-bound as the standing
    requirement instead of a numeric pass/fail bar: the existing
    200-sample-per-corner campaigns can't resolve an 8192-bit array's
    per-bit yield to the confidence a numeric target would imply, and no
    citable external precedent exists to ground one. Additive-only amendment
    to spec/sram.md's Characterization section; no sim/ evidence changed.
2026-08-21 verify: run DRC, LVS, and post-layout parasitic extraction on the SRAM macro (#96)
    Commits fresh, provenance-carrying `klt drc`/`klt lvs`/`klt extract` JSON
    reports under layout/reports/ for the bitcell and 256x32 array: DRC clean
    (0 violations, both), bitcell LVS match (6/6 devices, 7/7 nets), and array
    LVS mismatch (expected -- klt extract is flat-only, a known tool gap,
    klayout-tools#1085).
    Post-layout PEX (T1 item 7) could not close for real: `klt pex` refuses or
    silently mishandles all five ratified T1-item-9 testbenches, for reasons
    reproduced directly against this repo's own layout (documented in
    sim/pex/README.md, with the exact klt/ngspice output for each case). The
    one honest arti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
2026-08-21 fix(guard): restore symlink-ancestor and for-loop-loopvar fixes after resync (#98)
    * fix(guard): restore symlink-ancestor and for-loop-loopvar write-confinement fixes, pin against future resyncs
    Ports forward PR #92's (a0b102d) symlink-ancestor-resolution and
    for-loop-loopvar-binding fixes to guard-destructive-generic.sh's write-
    confinement scan via a 3-way merge (base=f1fa04c, ours=HEAD, theirs=a0b102d)
    rather than a mechanical cherry-pick, since the file has diverged
    significantly since a0b102d (new upstream content: #6152 resolve_var
    extraction, #6326 numbered-fd exclusion, #6519/#6520/#6549 rm-scope mktemp
    resolution). Restores every local fix the resync pattern has repeatedly
    wiped: s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
2026-08-21 feat: add klt-pex-native and by-hand PEX evidence for SRAM access time and write margin (#99)
    Closes T1 item 7 (post-layout PEX) per-measurement, as new parallel
    artifacts alongside (never modifying) the ratified #24 testbenches:
    - sim/pex/access-time/: a .SUBCKT-wrapped DUT companion of
    bitcell_6t.spice plus two klt-sim-compatible testbench bodies, run
    through `klt pex` for real -- genuine 27-corner schematic-vs-extracted
    deltas for read and write access time (status: pass, non-empty delta,
    reference_netlist naming the real DUT).
    - sim/pex/write-margin/: `klt pex` can't run write-margin's bisection
    search, so this replicates its intent by hand via the existing
    sim/lib/run_corne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
2026-08-22 docs(layout): survey gf180mcu SramCore DRC allowances, DRC the foundry bitcell (#104)
    Adds layout/reports/sram-rule-survey.md: a DRM citation-backed table of
    every SramCore (108/5) marker-scoped rule relaxation gf180mcu's native
    KLayout DRC deck defines (contact/poly overlap, field-poly-to-COMP
    spacing, several Nwell/LVPWELL-to-COMP spacing rules under DNWELL, one
    Metal1-width rule), and states explicitly that implant, density, antenna
    and latch-up rules are not touched by the marker.
    Runs klt drc --deck gf180mcu against the foundry's own hardened
    gf180mcu_fd_ip_sram macro (committed as
    layout/reports/drc-foundry-bitcell.json): 2010 violations, all
    comp.enclosing.contact.1, all inside the i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
2026-08-22 docs: correct design/README.md's stale placeholder-bitcell prescription (#105)
    design/README.md's layout/README.md bullet still described the array-tiling
    generator (issue #22, PR #36) as built against a placeholder bitcell with a
    follow-up prescription to replace it. That follow-up landed in PR #55
    (ce56f59), which drew the real, device-level 6T bitcell layout and tiled it
    into the 256x32 array (see layout/README.md's "Status (2026-08-16)"
    section). Update the bullet to describe the current state and cite PR #55
    instead of prescribing already-completed work.
    Closes #101
2026-08-22 spec: T1/bronze checklist re-read against current evidence (2026-08-22) (#111)
    Re-reads klayout-tools' T1 "sim-validated" checklist row by row against
    evidence on main (the first re-read since #13, and the first performed
    since spec/block-kind-decision.md ratified this block's kind as analog).
    All ten items PASS -- seven cleanly, three with a disclosed hole, one with
    a fully investigated structural limitation.
    Live-re-verifies item 4 (array-level LVS): klayout-tools#1085's fix
    (options.flatten_reference on klt lvs) is already present in this host's
    installed klt 0.2.0, and re-running LVS against the committed array GDS
    and reference netlist with that option now reports status: match
    (49,152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
2026-08-22 fix: enable array-level LVS via klt lvs's flatten_reference option (#112)
    klayout-tools#1085 (closed 2026-08-17) added options.flatten_reference,
    which flattens the hierarchical reference netlist before comparing so
    it pairs against klt extract's always-flat layout-side netlist. Add
    that option to generate.sh's array LVS request and regenerate
    lvs-array.json: status: match, 49,152/49,152 devices, 16,706/16,706
    nets, 322/322 pins, with the one remaining mismatch entry being the
    expected topology.flattened disclosure (severity: warning). Update
    layout/README.md's Status table LVS row, "Array-level LVS" bullet, and
    Known tool gaps #2 to reflect that array-level LVS is achievable today
    via the c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
2026-08-22 docs: correct README.md's stale Status/maturity-ladder text against landed evidence (#113)
    Both the top-level Status line and the "Target specification" section's
    "Current position" sentence still described bitcell/array layout as
    "underway" and PVT signoff as "outstanding." Neither is true anymore:
    - layout/README.md's "Status (2026-08-16)" section: the 6T bitcell and
    256 x 32 array are DRC-clean (0 violations, both decks) and LVS-clean
    (`status: match` for both bitcell and array, the latter fixed via
    klayout-tools#1085 / issue #108 / PR #112).
    - sim/signoff-summary.md: 27-corner PVT signoff (read SNM + hold SNM +
    write margin) is complete with an explicit "Overall signoff ...: PAS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
2026-08-22 verify: re-run sim/pex parasitics and 27-corner PEX deltas against the issue #103 bitcell (#114)
    Re-runs every generate.sh under sim/pex/ against the post-issue-#103 bitcell
    GDS (content_hash now sha256:53d2b7aa..., matching the currently-committed
    layout/bitcell/sram_bitcell_6t.gds -- the pre-#103 extraction was still
    sha256:6b90b7d6...):
    - ./sim/pex/generate.sh -- re-extracted extract-report.json +
    extracted-netlist/sram_bitcell_6t.spice.
    - ./sim/pex/access-time/dut/generate.sh + ./sim/pex/access-time/generate.sh
    -- re-ran the klt-pex-native 27-corner read/write access-time deltas.
    27/27 pass both directions, same as pre-#103.
    - ./sim/pex/write-margin/generate.sh -- new schematic/ex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
2026-09-05 feat(champion): standing authorization for design-evidence auto-merge (#6850)
    Operator ruling 2026-09-05: Judge-approved, green-CI PRs whose entire
    changed-file set lives in design/, sim/, layout/, measurements/,
    verification/, or docs/ auto-merge without the four-axis human hold.
    Rationale: canary design evidence is fully revertible with no fleet-infra
    blast radius, and the held-PR pattern (sky130-sar-adc#123 sat mergeable for
    days as the sole blocker of a layout chain) costs more than it protects
    here. spec/ and every tool surface fall outside the patterns, so the
    exact-subset rule keeps them on the four-axis judgment automatically.
    C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
2026-09-09 views: generate the LEF abstract for the 256x32 array (klt lef-abstract) (#122)
    Adds the first views/ deliverable: a socket descriptor for the array's 322
    ports (generated from layout/sram_256x32/generate.py's own drawn label
    geometry, not hand-typed) and a real klt-generated LEF abstract.
    klt socket-check passes clean (outline + all 322 pins). klt lef-abstract
    itself crashes on this design's real OBS geometry -- an AttributeError bug
    in klayout_tools.lef_abstract._polygon_to_um_shape (SimplePolygon has no
    each_point_hull), filed upstream as 2AMLogic/klayout-tools#1613 with a
    minimal generic repro and a one-line fix. views/run_lef_abstract.py works
    around it with that exact one-line patch (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
2026-09-10 layout: add Metal1 landing pads for the 256 wordlines (issue #121) (#123)
    Each WL<row> wordline was labelled directly on Poly2, a non-routing layer
    in gf180mcu's tech LEF, so klt lef-abstract reported all 256 wordline pins
    as geometry_source: "none" in unroutable_pins[] (issue #120).
    layout/sram_256x32/generate.py now reserves a 0.43um strip of periphery at
    the array's left edge (where a row decoder would sit) and draws, per row,
    a Poly2 landing pad abutting that row's wordline stripe, a Poly2-to-Metal1
    contact, and a Metal1 pad flush with the macro's left boundary -- then
    labels WL<row> on the Metal1 pad instead of the Poly2 stripe. Every
    dimension derives from layout/bitcell/generate.py's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
2026-09-21 feat: grade this block's T1 checklist state via a klt signoff manifest (#129)
    Commit signoff/block-manifest.json (block gf180-sram, kind analog per
    spec/block-kind-decision.md) plus the klt signoff --manifest tier report
    it renders as the verdict of record, with a CI job that re-grades the
    manifest on every PR so a citation whose artifact drifted fails instead
    of rotting. Grading runs on the pinned released registry wheel with a
    vendored eleven-item copy of the checklist doc (no release grades item
    11 yet); the report honestly renders 3/11 met with a reason per unmet
    row. The 2026-08-22 hand-read re-review is superseded as the verdict of
    record and gains a pointer.
    Closes #125
    Co-authored-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
2026-09-21 fix(guard): exempt the klt layout cold-start idiom from unresolved-var denies (#127) (#131)
    Extend the #64/#65/#82 pdk_env.sh mktemp-scratch exemption's provenance
    with a layout-flow arm (#127): the SAME command invokes this repo's own
    committed layout tools -- layout/sram_256x32/generate.py named, or a
    klt drc|extract|lvs subcommand word -- instead of sourcing
    sim/lib/pdk_env.sh. The shape contract is unchanged: literal
    NAME=$(mktemp -d) allowlist, same-command whole-dir rm -rf self-clean,
    TMPDIR gates, and the PR #65 confinement re-validation all still apply,
    so every other unresolved-var shape keeps its fail-closed deny.
    Two pinning suites (rm-scope site + write-confinement site, in the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
2026-09-21 layout: add the klt erc supply spec and array supply report (T1 item 11) (#132)
    Commit the structural-power-delivery evidence klayout-tools' T1 item 11
    ("Power delivery (structural)", added 2026-09-17) grades for this block,
    per its analog column:
    - layout/sram_256x32/erc-supply-spec.json -- the supply spec, with an
    inline comment block justifying every stackup entry, via, label layer,
    and deliberate omission from three agreeing sources: this GDS's own
    measured layer/text inventory, the PDK's own gf180mcu.lyp at the
    pinned open_pdks revision, and klt's curated gf180mcu deck table.
    Supplies route Poly2-gate/Comp-active/Metal1/Metal2/Metal3 only;
    supply text lives on 42/10 (measur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
2026-09-21 docs(layout): update array-level LVS reporting to current match status (#134)
    layout/reports/README.md still described lvs-array.json as
    `status: mismatch` with an expected topology-matching failure, although
    PR #112 regenerated that report with klt lvs's flatten_reference option
    (klayout-tools#1085, closed upstream 2026-08-17) and the committed file
    now reads `status: match` with 49,152/49,152 devices, 16,706/16,706 nets,
    and 322/322 pins matched. Update the results-table row and the "Known
    gap: array-level LVS" section to the current result: the compare-side
    failure is resolved via the reference flatten (the sole mismatches[]
    entry is the expected topology.flattened warning disclosure), th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
2026-09-21 verify: re-mint LVS/corner/MC evidence so T1 items 4-6 grade met (#137)
    Re-mint the three T1 rows whose evidence existed but was mechanically
    unverifiable, each via its documented refresh mechanism (issue #128):
    - LVS (item 4): regenerate layout/reports/lvs-{array,bitcell}.json under
    a post-klayout-tools#1969 klt that records LVS provenance.input, keeping
    status: match (49,152/49,152 devices, 16,706/16,706 nets; bitcell 0
    mismatches); the extract pair refreshes in step with them, and the
    manifest's item-4 pin becomes the report's own input content hash.
    - Corner verification (item 5): mint sim/signoff-sim-envelope.json -- a
    klt-sim-shaped envelope transcribed verbatim from the fiv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
2026-09-21 docs(layout): reword the stale klt options-echo caveat as historical context (#138)
    The Known tool gaps #2 parenthetical asserted the committed
    lvs-array.json does not carry an options.flatten_reference: true
    field. That was true of the original klt 0.2.0 mint, but the
    currently committed report was re-minted with klt 0.5.0 (per its
    provenance block) and echoes the full options object, including
    flatten_reference: true. Reword the caveat as historical context
    about the earlier artifact so the claim's provenance is kept instead
    of silently deleting it.
    Closes #135
2026-09-29 Guard against issue-only claim labels landing on PRs (#141)
    PR #139 carried a stray loom:curating label for 2+ days because issue and
    PR numbers share one namespace, and `gh issue edit <N> --add-label` (and
    its REST equivalent) succeeds whether <N> is an issue or a PR -- and
    `gh issue view <N>` cannot distinguish the two to catch this before the
    fact. Adds a live-lookup guard to guard-loom-workflow.sh that denies a
    loom:curating claim-label add when <N> resolves to a PR (via
    `gh api repos/OWNER/REPO/issues/<N> --jq 'has("pull_request")'`), failing
    open on any lookup error per this file's existing contract. Also removes
    the stray label from PR #139 as the immediate unblock, and adds a matchin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
2026-09-29 refactor: drop unused repo_relative_path() from env_provenance
    Nothing in the repo ever called it (zero callers, zero tests); upstream
    klayout_tools.env_provenance (klt >= 0.6.0) now ships the identical
    helper, so the hand-rolled copy is retired. pdk_identity() stays -- it
    has no upstream equivalent -- with its docstring reworded to drop the
    dangling cross-reference, and the module docstring updated to record
    why the generic path-classification half is gone.
    Closes #145
    Loom-Story: 2AMLogic/gf180-sram#145
    Loom-Trace-Id: 85ec394bf532a94dad9aef9f73002a80
    Loom-Build: 0.19.500 53a29fd9e938f5bea55740940df709b32aac1008 clean
2026-09-29 refactor(measurements): remove duplicated latest_mc_record_for_claim
    latest_mc_record_for_claim() in measurements/generate_report.py was a
    byte-identical copy-paste duplicate of signoff.latest_record_for_claim()
    (sim/lib/render_signoff_table.py), which the module already imports.
    Retarget both call sites to the shared helper and delete the local copy.
    Verified measurements/characterization-report.md regenerates byte-
    identically and scripts/ci/check_evidence_format.py still passes.
    Closes #149
    Loom-Story: 2AMLogic/gf180-sram#149
    Loom-Trace-Id: 5216f72e046c56ba61e374acb7dbb551
    Loom-Build: 0.19.510 425ce84bcad84c5a0123cbc69fc8763a3d9c0e8b clean
2026-09-29 refactor: reuse render_signoff_table's CORNER_ORDER in compare_records.py
    Drops compare_records.py's second hand-copy of the ratified PVT
    corner-matrix constants (PROCESSES/TEMPS/VDDS) in favor of the
    path-injected import of sim/lib/render_signoff_table.py that
    measurements/generate_report.py already uses -- the two Python copies
    had already drifted (int vs string TEMPS) with nothing binding them.
    The delta tool now iterates the canonical CORNER_ORDER directly.
    The committed delta tables regenerate byte-identically (both records,
    27 corners each, 0 OPEN).
    Closes #153
    Loom-Story: 2AMLogic/gf180-sram#153
    Loom-Trace-Id: 784a9071de2678fd9ec0812986e3bd47
    Loom-Build: 0.19.511 8e24f6b8890ae1ea74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
2026-09-30 loom: pin the #141 claim-label guard and curator.md edits in resync-ignore
    This PR edits four Loom-managed files: the guard hook, its new test
    suite, and both installed copies of curator.md. With no
    .loom/resync-ignore entry and no upstream change, the next "chore:
    resync installed Loom surfaces" run would overwrite the three edited
    files with upstream content and orphan the test suite, which has no
    upstream counterpart. That would silently undo the fix (see the
    'Loom-managed files are transient' rule, loom#172/#190).
    Pins the four paths in the .loom/-relative report form, following
    sky130-modexp#159. Each block names this repo's tracking issue (#141),
    the upstream report rjwalters/loom#960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
2026-10-01 chore: resync installed Loom surfaces
    resynced_by: fleet-resync
    invocation: fleet-resync.sh --fleet-only --push
    <!-- loom:provenance v1 build=unknown 19f4e67fd0a0afbd3d8b6606ca91ceac911377a3 clean prompts=none sweep=none story=none trace=78a5dfbdfd8c530aecd1bb436fd096df host=loom-worker-2 base=fe224522d5e581527a3db25434e5fd46921c32c4 run=loom-run/v1:timer:loom-worker-2/fleet-resync:67c759f7ef3c43e38d3fa8d5f19a2dd1 installs=0.19.593 658650a4f0eff932ac66a8f690eaedf8123fc83b -->
    Loom-Story: none
    Loom-Trace-Id: 78a5dfbdfd8c530aecd1bb436fd096df
    Loom-Build: unknown 19f4e67fd0a0afbd3d8b6606ca91ceac911377a3 clean
2026-10-01 chore: resync installed Loom surfaces
    <!-- loom:provenance v1 build=unknown 56435bf476452911283e43940ecfd9a30f804af9 clean prompts=none sweep=none story=none trace=342405c5ebc99bdbf17afbd983c0c41c host=loom-worker-2 base=ae54a029a31f404f1f6af06432809871098e33f6 run=loom-run/v1:timer:loom-worker-2/fleet-resync:20c09f231d424cd5b57ca7991848dd8a installs=0.19.603 8c39bf7cde8a8c03d1aaee441f397c017b6a3a9e -->
    Loom-Trace-Id: 342405c5ebc99bdbf17afbd983c0c41c
    Loom-Build: unknown 56435bf476452911283e43940ecfd9a30f804af9 clean
    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
2026-10-01 chore: resync installed Loom surfaces
    <!-- loom:provenance v1 build=unknown f2868e6b4d60d11a8ab47d25cad9e248229d2f66 clean prompts=none sweep=none story=none trace=4e2766ed5160781df891476246a9be2e host=robb-studio base=296e2cc536a091d9d7b3ac8ed8477babb39a7a38 run=loom-run/v1:timer:robb-studio/fleet-resync:2d3851d5-1673-43ae-bcc6-e5c971b37f33 installs=0.19.603 74778a6aeea5d9e06b489400942b35f33c8bb766 -->
    Loom-Trace-Id: 4e2766ed5160781df891476246a9be2e
    Loom-Build: unknown f2868e6b4d60d11a8ab47d25cad9e248229d2f66 clean
    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
2026-10-01 chore: resync installed Loom surfaces
    <!-- loom:provenance v1 build=unknown d6714830391f7596338b8de40ee2d0f45dcd12f5 clean prompts=none sweep=none story=none trace=af273f717e759e690d07f372734e9278 host=robb-pro base=efcc571f1347ea73b300d1ba91ae30725969d76f run=loom-run/v1:timer:robb-pro/fleet-resync:92e2f9ba-d083-411b-833b-ae52d169ef04 installs=0.19.605 6eb2b65a4496b7becb84ef1f944493a541fd01cd -->
    Loom-Trace-Id: af273f717e759e690d07f372734e9278
    Loom-Build: unknown d6714830391f7596338b8de40ee2d0f45dcd12f5 clean
    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
2026-10-01 chore: resync installed Loom surfaces
    <!-- loom:provenance v1 build=unknown 617257919edc1b9b9ee27532c5ec1b8a64523388 clean prompts=none sweep=none story=none trace=cb047565635d880cd4ae328b5cfaaf68 host=loom-worker-1 base=e5b120232b8f83604f9a7b43bf762213a3dfa28d run=loom-run/v1:script:loom-worker-1/fleet-resync:9973280a-d0de-4196-8cdb-f221825edc41 installs=0.19.609 ff30576dacc8c2734b1c7434bedd29c47122caeb -->
    Loom-Trace-Id: cb047565635d880cd4ae328b5cfaaf68
    Loom-Build: unknown 617257919edc1b9b9ee27532c5ec1b8a64523388 clean
    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
2026-10-01 chore: resync installed Loom surfaces
    <!-- loom:provenance v1 build=unknown 617257919edc1b9b9ee27532c5ec1b8a64523388 clean prompts=none sweep=none story=none trace=dbafe4f8526617aa07c890721298a080 host=robb-studio base=d15cbd3da5f1f14460742e892623ee9826fb1417 run=loom-run/v1:timer:robb-studio/fleet-resync:1817df66-02cc-4b27-927d-a38485da550a installs=0.19.610 c94891dd526cf6db5ee02045424c6913be522048 -->
    Loom-Trace-Id: dbafe4f8526617aa07c890721298a080
    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
2026-10-01 chore: resync installed Loom surfaces
    <!-- loom:provenance v1 build=unknown a2a39ac2736eb2686e2c65412d939e67c0438a7d clean prompts=none sweep=none story=none trace=fc1a121767151aae5bd7427c683b7db6 host=robb-pro base=d9861ca7c897079404786807533a8718f82bb138 run=loom-run/v1:timer:robb-pro/fleet-resync:708eb7c8-469d-4783-80b7-bafe142df3c4 installs=0.19.612 d25614656adcf70162da95c5e1035e99a0639a1a -->
    Loom-Trace-Id: fc1a121767151aae5bd7427c683b7db6
    Loom-Build: unknown a2a39ac2736eb2686e2c65412d939e67c0438a7d clean
    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
2026-10-01 chore(tooling): update repo-skills to v0.19.5
    Fleet-wide Repo Skills rollout (2026-10-01). compute-drift's axis 6
    reported repo-skills at 11 different versions across the fleet's
    checkouts; this brings gf180-sram from v0.10.0 to v0.19.5 (rjwalters/repo
    @ ff282cd), staging only the installer's own surface.
    Loom-Trace-Id: 038dce5d677bceeeca3c111787ac5b68
    Loom-Build: unknown unknown unknown
    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
2026-10-01 chore: resync installed Loom surfaces
    <!-- loom:provenance v1 build=unknown 126c80914e42f913c4fc778d3ddce96daa2c7a77 clean prompts=none sweep=none story=none trace=15a20fbea7a00d0922b943088c80e19d host=loom-worker-1 base=9c01f2f2cd9f7d33e3362043226a1f42e520bdd2 run=loom-run/v1:script:loom-worker-1/fleet-resync:ecc423da-4625-49de-b25a-692fd669a029 installs=0.19.612 d47e0c57a6bea6f7b61ef9ce62632d70c39ef5d5 -->
    Loom-Trace-Id: 15a20fbea7a00d0922b943088c80e19d
    Loom-Build: unknown 126c80914e42f913c4fc778d3ddce96daa2c7a77 clean
    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
2026-10-01 chore: resync installed Loom surfaces
    <!-- loom:provenance v1 build=unknown 126c80914e42f913c4fc778d3ddce96daa2c7a77 clean prompts=none sweep=none story=none trace=a0a42bd10fcfa6d7cbcc9c021c406848 host=loom-worker-2 base=78844b8f2946ba63e94f1af15b58a851b22eeae8 run=loom-run/v1:timer:loom-worker-2/fleet-resync:9e174e6bb0fa41d786e4a86e45632b6f installs=0.19.612 6f0871dc66e62b36d8382ced980d2805bfd97e50 -->
    Loom-Trace-Id: a0a42bd10fcfa6d7cbcc9c021c406848
    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
2026-10-01 chore: resync installed Loom surfaces
    <!-- loom:provenance v1 build=unknown 6f3411c8a63e68097dde01bce8a8422230f54218 clean prompts=none sweep=none story=none trace=9aa0a46bb352b9665fdaa5f5b3b85dd7 host=robb-pro base=250d30ac2af8ebcb396a8392b6bef17ec1a5374b run=loom-run/v1:timer:robb-pro/fleet-resync:ca419e1d-6646-4678-ac7a-b263e4b5119e installs=0.19.612 7731400b3e3e1df39074564166edf656feb0999c -->
    Loom-Trace-Id: 9aa0a46bb352b9665fdaa5f5b3b85dd7
    Loom-Build: unknown 6f3411c8a63e68097dde01bce8a8422230f54218 clean
    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
2026-10-02 chore: resync installed Loom surfaces
    <!-- loom:provenance v1 build=unknown 13c0a3ef467a888520a6529ab34486ab8be826be clean prompts=none sweep=none story=none trace=41356080f367e491d5ff03f17bb98c27 host=loom-worker-2 base=2839b27fdc2d2db9939668545cdab38ef7025fdc run=loom-run/v1:timer:loom-worker-2/fleet-resync:44455fbcbab745abb92cea192fafbb1d installs=0.19.614 3c79f7b1d0cc14723e049cff4250ff7330804326 -->
    Loom-Trace-Id: 41356080f367e491d5ff03f17bb98c27
    Loom-Build: unknown 13c0a3ef467a888520a6529ab34486ab8be826be clean
    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
2026-10-02 chore: resync installed Loom surfaces
    <!-- loom:provenance v1 build=unknown ea2dd21f2ba310ec007d047ddfecc6cd27d220ac clean prompts=none sweep=none story=none trace=f04a67f3922788d2ccdd66578c8d18f9 host=loom-worker-1 base=9ae720b04d3459fda5b1e16a05c00171bcb4f519 run=loom-run/v1:timer:loom-worker-1/fleet-resync:1c3b601dd998488595adc09040c007d4 installs=0.19.614 79f4897c5d3c78dbfc1b022f77d244838dbf4ccb -->
    Loom-Trace-Id: f04a67f3922788d2ccdd66578c8d18f9
    Loom-Build: unknown ea2dd21f2ba310ec007d047ddfecc6cd27d220ac clean
    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
2026-10-02 chore: resync installed Loom surfaces
    <!-- loom:provenance v1 build=unknown 6f3411c8a63e68097dde01bce8a8422230f54218 clean prompts=none sweep=none story=none trace=acb28d0049e0cc75536f96d503f6e814 host=robb-studio base=7339389f3db6dc1aa2d60c61498f3fc42893d270 run=loom-run/v1:timer:robb-studio/fleet-resync:85d2b1b5-e81d-40c3-ab6a-9a00efbc4ee2 installs=0.19.616 d86523eeadb32b95777f3cd3a76dd2f72f0bf792 -->
    Loom-Trace-Id: acb28d0049e0cc75536f96d503f6e814
    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
2026-10-02 chore: resync installed Loom surfaces
    <!-- loom:provenance v1 build=unknown 2b50bd69eddd038dd738465aa58a9ebca11410ac clean prompts=none sweep=none story=none trace=324e4f607054d0396cfdf8fdc01e93ae host=robb-pro base=55315de638dfb1c7ecc6ac3e0265f13a50d4941a run=loom-run/v1:timer:robb-pro/fleet-resync:a63799f1-2ad7-4946-b81d-2ec231bc2d2f installs=0.19.617 81cb2ad7e091b19d6a2b95d1add6938c2100d46b -->
    Loom-Trace-Id: 324e4f607054d0396cfdf8fdc01e93ae
    Loom-Build: unknown 2b50bd69eddd038dd738465aa58a9ebca11410ac clean
    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
2026-10-02 chore: resync installed Loom surfaces
    <!-- loom:provenance v1 build=unknown 00d92b326aed50280cd90dc116b7caec27668251 clean prompts=none sweep=none story=none trace=9a5d23cc82b6d3a1c83bfee47bd04970 host=loom-worker-2 base=3530cb596fac81fb10cfcfd916763f3639b3d332 run=loom-run/v1:timer:loom-worker-2/fleet-resync:12136a7a025d49f3a60b5edb04a3ff81 installs=0.19.619 4c0f505e4f0b76f8ccec07bda6d8b839030c077b -->
    Loom-Trace-Id: 9a5d23cc82b6d3a1c83bfee47bd04970
    Loom-Build: unknown 00d92b326aed50280cd90dc116b7caec27668251 clean
    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
2026-10-02 chore: resync installed Loom surfaces
    <!-- loom:provenance v1 build=unknown 456dad6d90259846313dc3bb80bf4e5471ef2d76 clean prompts=none sweep=none story=none trace=bb9688c03fb5211d06f48c8838a5505c host=robb-studio base=20dfd2b535de80232742947b26f582e9537f5e1f run=loom-run/v1:timer:robb-studio/fleet-resync:e965c017-8ec7-485d-b46e-aeb399b81fb4 installs=0.19.620 0d28ba49f5a88fdb37271de9cb0144eb3442c6e3 -->
    Loom-Trace-Id: bb9688c03fb5211d06f48c8838a5505c
    Loom-Build: unknown 456dad6d90259846313dc3bb80bf4e5471ef2d76 clean
    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
2026-10-02 chore: resync installed Loom surfaces
    <!-- loom:provenance v1 build=unknown 6c6d2b6565dc13eff4c6811b9c670f452106516b clean prompts=none sweep=none story=none trace=539be979ae694d66ede516a7b5d17e41 host=robb-pro base=448eb5071799f71daaed0426f3e5f73cfd19366e run=loom-run/v1:timer:robb-pro/fleet-resync:9444d216-de08-442f-8352-ba59f6e81bb3 installs=0.19.621 a90dc1d794eb9ff70aaf939ebf495abe716f3bdd -->
    Loom-Trace-Id: 539be979ae694d66ede516a7b5d17e41
    Loom-Build: unknown 6c6d2b6565dc13eff4c6811b9c670f452106516b clean
    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
2026-10-02 chore: resync installed Loom surfaces
    <!-- loom:provenance v1 build=unknown f6d28134bfe476967e005d97424073085f55e8a3 clean prompts=none sweep=none story=none trace=27eb90670d441065f593e941066ee005 host=loom-worker-2 base=cbf757db661657174ec4dabd102f97915d058664 run=loom-run/v1:timer:loom-worker-2/fleet-resync:04001bba930241cf9e325bf304a9270a installs=0.19.623 ccc19c2bbe2aa65328427730fa53f70eb56128c6 -->
    Loom-Trace-Id: 27eb90670d441065f593e941066ee005
    Loom-Build: unknown f6d28134bfe476967e005d97424073085f55e8a3 clean
    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
2026-10-02 chore: resync installed Loom surfaces
    <!-- loom:provenance v1 build=unknown bc461736314499b6c2c4c0ad51fb2294f60336f5 clean prompts=none sweep=none story=none trace=c3ea68717dd3a908dbbd60a35bc8b5d6 host=robb-studio base=d132b2be5fc657c5033e479c138a83fa0b6ea98b run=loom-run/v1:timer:robb-studio/fleet-resync:8d4c49e2-3258-4080-b0c8-082499053654 installs=0.19.623 a50aaf70069f8897c41a64b7d90783c5ab8294e0 -->
    Loom-Trace-Id: c3ea68717dd3a908dbbd60a35bc8b5d6
    Loom-Build: unknown bc461736314499b6c2c4c0ad51fb2294f60336f5 clean
    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
2026-10-02 chore: resync installed Loom surfaces
    <!-- loom:provenance v1 build=unknown bc461736314499b6c2c4c0ad51fb2294f60336f5 clean prompts=none sweep=none story=none trace=8bee8a664bfc89e0bbfbb3c2de7342ba host=loom-worker-2 base=f44b5156f022b3a9c6c414437fb002e3ce06562d run=loom-run/v1:timer:loom-worker-2/fleet-resync:de2ceceb48ea4927a1334d08dc0082fe installs=0.19.624 5f49564fa78ae06f8c48d5224dae9ded04200bb7 -->
    Loom-Trace-Id: 8bee8a664bfc89e0bbfbb3c2de7342ba
    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
2026-10-03 chore: resync installed Loom surfaces
    <!-- loom:provenance v1 build=unknown 752d316233ed1a3da9e4f69ad760eb99bb477747 clean prompts=none sweep=none story=none trace=7851839b67c00a023e97cbdea1f580e1 host=robb-pro base=1c6d00e226907146ae54193d56cc40d08c4288e2 run=loom-run/v1:timer:robb-pro/fleet-resync:ae492b66-dca0-4da4-acab-8d26778f2d5c installs=0.19.624 121fac45f5006879bf58a18c951b9243d9099a18 -->
    Loom-Trace-Id: 7851839b67c00a023e97cbdea1f580e1
    Loom-Build: unknown 752d316233ed1a3da9e4f69ad760eb99bb477747 clean
    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
2026-10-03 chore: resync installed Loom surfaces
    <!-- loom:provenance v1 build=unknown b34a08286a42f47f917ec46647d4d167c1f5207c clean prompts=none sweep=none story=none trace=a8e453124b899b440f42c9d83837c7b6 host=loom-worker-2 base=a741370ef0a18ad179c9dfa48ea4d2e68b7fd081 run=loom-run/v1:timer:loom-worker-2/fleet-resync:f02dd5df715347fe90fe14b9353a1b66 installs=0.19.624 98c193cf0d12d68d3770edc1baad808c40bb5fd4 -->
    Loom-Trace-Id: a8e453124b899b440f42c9d83837c7b6
    Loom-Build: unknown b34a08286a42f47f917ec46647d4d167c1f5207c clean
    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
2026-10-03 chore: resync installed Loom surfaces
    <!-- loom:provenance v1 build=unknown 3437cece5ab759f772122f8d18a6d2f05d246cde clean prompts=none sweep=none story=none trace=1bd6b75d1c0daff2b433adf5999546a3 host=loom-worker-1 base=8658c8a57313435cb2e14ad104d2881dfccf0694 run=loom-run/v1:timer:loom-worker-1/fleet-resync:4c0abac1c29646eaa8502afa223bdd2b installs=0.19.624 0162badc662fb30c070e70611aa8ff74a8486d54 -->
    Loom-Trace-Id: 1bd6b75d1c0daff2b433adf5999546a3
    Loom-Build: unknown 3437cece5ab759f772122f8d18a6d2f05d246cde clean
    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
2026-10-03 docs: record bronze (T1) grant and re-cite items 1, 2, 9, 10 (#126)
    Loom-Story: 2AMLogic/gf180-sram#126
    Loom-Trace-Id: 110d64c9a6cf3287d2ffe32f3a0ee9bb
    Loom-Build: 0.19.627 f400b3eecc2f60cd5bdc8b359335929385afc793 clean
2026-10-03 docs(signoff): reconcile README with operator-directed re-citation of items 1/2/9/10
    Address Judge review on PR #155. The paragraph after the verdict table
    still said items 1, 2, 9 and 10 were uncited by deliberate choice, which
    the manifest no longer reflects. Rewrite it to say what changed and why:
    the items were left uncited until 2026-10-02, and the #126 operator ruling
    directed re-citing them so the mechanical verdict tracks the granted
    tier. The note also states that klt 0.5.0 accepts only a cited passing
    native envelope for these items (no kind: generic), that for these rows
    `met` is not evidence for the item, and that item 10's citation has no
    topical bearing. It links the upstream t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
2026-10-03 chore: resync installed Loom surfaces
    <!-- loom:provenance v1 build=unknown 3437cece5ab759f772122f8d18a6d2f05d246cde clean prompts=none sweep=none story=none trace=bba21427f750636f851279cfae92b4e5 host=loom-worker-1 base=65be0745029ee59354401b32c69c6f663f1b098f run=loom-run/v1:timer:loom-worker-1/fleet-resync:9440cda9476f404caa282e360a81ee03 installs=0.19.636 e41edfbb52c13982f7d8b0577f42957427a6514c -->
    Loom-Trace-Id: bba21427f750636f851279cfae92b4e5
    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
2026-10-03 chore: resync installed Loom surfaces
    <!-- loom:provenance v1 build=unknown 28040ed11a4369e20f3b7b0154a3fb2a2c35d38c clean prompts=none sweep=none story=none trace=0cd87d01c45d97a2ee57a99363fc0db2 host=robb-studio base=1966c01bc134a66a7a657769d30a28c895b4d357 run=loom-run/v1:timer:robb-studio/fleet-resync:74b93657-6b04-4ac5-bc77-e0a1682b0595 installs=0.19.636 e41edfbb52c13982f7d8b0577f42957427a6514c -->
    Loom-Trace-Id: 0cd87d01c45d97a2ee57a99363fc0db2
    Loom-Build: unknown 28040ed11a4369e20f3b7b0154a3fb2a2c35d38c clean
    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
2026-10-03 chore: resync installed Loom surfaces
    <!-- loom:provenance v1 build=unknown 388c7fe0cad997f7a887f70c9f2cfe8781a2d512 clean prompts=none sweep=none story=none trace=2046ffd42f138a06b914f34851de3440 host=loom-worker-2 base=6a2f298463d96fb1ce5acb1f413f3c7a869824e3 run=loom-run/v1:timer:loom-worker-2/fleet-resync:17c9456bb1934c70a545b12081496cce installs=0.19.647 d1fe5dead4202be12a964ab891fd5980e7836170 -->
    Loom-Trace-Id: 2046ffd42f138a06b914f34851de3440
    Loom-Build: unknown 388c7fe0cad997f7a887f70c9f2cfe8781a2d512 clean
    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
2026-10-03 chore: resync installed Loom surfaces
    <!-- loom:provenance v1 build=unknown 8078c29e691123d91cd761a786f99cfd25f1809d clean prompts=none sweep=none story=none trace=45869a6374635c036a11a6f379fe31a4 host=robb-pro base=4ea953f0f1cfd3c7f2e369948b6b400f66458323 run=loom-run/v1:timer:robb-pro/fleet-resync:b0a94991-052d-4e7d-ba2b-78b971096849 installs=0.19.647 709ca4396e074e5a4d1c5e19721f6ddac7154ca2 -->
    Loom-Trace-Id: 45869a6374635c036a11a6f379fe31a4
    Loom-Build: unknown 8078c29e691123d91cd761a786f99cfd25f1809d clean
    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
2026-10-03 chore: resync installed Loom surfaces
    <!-- loom:provenance v1 build=unknown f9cba29b0602624a23daa17ae04d31d82e10fa91 clean prompts=none sweep=none story=none trace=754b3688f97b6c34894d8cfbf272b81a host=loom-worker-1 base=fbd24871d80da9ee853d84b25be30aaced3a12f3 run=loom-run/v1:script:loom-worker-1/fleet-resync:11eb117a-9ff3-4411-88d4-fdd7d6748639 installs=0.19.649 6f2f13b1c31ce420e2250ae040d8e1050c0e761b -->
    Loom-Trace-Id: 754b3688f97b6c34894d8cfbf272b81a
    Loom-Build: unknown f9cba29b0602624a23daa17ae04d31d82e10fa91 clean
    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
2026-10-03 chore: resync installed Loom surfaces
    <!-- loom:provenance v1 build=unknown f9cba29b0602624a23daa17ae04d31d82e10fa91 clean prompts=none sweep=none story=none trace=544a028e3829d4020b8aaa144e5fa628 host=robb-studio base=26c3fdf52f516d1bca166590303c7ab8112286d0 run=loom-run/v1:script:robb-studio/fleet-resync:5b5b8b83-7139-447d-88bd-417dcf375aa6 installs=0.19.649 6f2f13b1c31ce420e2250ae040d8e1050c0e761b -->
    Loom-Trace-Id: 544a028e3829d4020b8aaa144e5fa628
    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
2026-10-03 chore: resync installed Loom surfaces
    <!-- loom:provenance v1 build=unknown f9cba29b0602624a23daa17ae04d31d82e10fa91 clean prompts=none sweep=none story=none trace=1057aaaf811f6dd2d64a3bb6d4b3ac49 host=robb-pro base=165e1bd0f62ab7bf56c4a009a9a20c5835d588a7 run=loom-run/v1:timer:robb-pro/fleet-resync:785c1ea0-d7f2-4810-99e9-cd9368aebe0c installs=0.19.649 2118aabb5a925f1ec4669b4d3d31176a46d8f2a6 -->
    Loom-Trace-Id: 1057aaaf811f6dd2d64a3bb6d4b3ac49
    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
2026-10-03 chore: resync installed Loom surfaces
    <!-- loom:provenance v1 build=unknown 72f61d9aa0fe08f1ef59f1a97a314e474455801e clean prompts=none sweep=none story=none trace=577d2185973ec59f059fa15bf5b5e514 host=loom-worker-1 base=384c17793efc67f864900db3e06c252c57459de6 run=loom-run/v1:script:loom-worker-1/fleet-resync:5728a930-137f-4d2f-a962-1cdd7a6a1d46 installs=0.19.652 235a64727b907d65529151af0a962b14f16462a0 -->
    Loom-Trace-Id: 577d2185973ec59f059fa15bf5b5e514
    Loom-Build: unknown 72f61d9aa0fe08f1ef59f1a97a314e474455801e clean
    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
2026-10-03 chore: resync installed Loom surfaces
    <!-- loom:provenance v1 build=unknown 72f61d9aa0fe08f1ef59f1a97a314e474455801e clean prompts=none sweep=none story=none trace=845aaa0eb340f80f12095e2e8b421ed1 host=robb-pro base=61419a72e735ed97d7f523f657fe80783e0748f0 run=loom-run/v1:script:robb-pro/fleet-resync:344add4b-df8a-49e8-8563-2765673acc76 installs=0.19.652 235a64727b907d65529151af0a962b14f16462a0 -->
    Loom-Trace-Id: 845aaa0eb340f80f12095e2e8b421ed1
    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
2026-10-03 chore: resync installed Loom surfaces
    <!-- loom:provenance v1 build=unknown 61870b40779d205c1555e801c6e1d95df083cdea clean prompts=none sweep=none story=none trace=cfd2c16d2cd3651ad0d068a28bbf62b8 host=loom-worker-1 base=27d45195d5ccf8e9c436ffbf1679f4f8305a3733 run=loom-run/v1:timer:loom-worker-1/fleet-resync:fd27683751ca428cb28a8d58a04fc51a installs=0.19.652 235a64727b907d65529151af0a962b14f16462a0 -->
    Loom-Trace-Id: cfd2c16d2cd3651ad0d068a28bbf62b8
    Loom-Build: unknown 61870b40779d205c1555e801c6e1d95df083cdea clean
    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
2026-10-03 chore: resync installed Loom surfaces
    <!-- loom:provenance v1 build=unknown 61870b40779d205c1555e801c6e1d95df083cdea clean prompts=none sweep=none story=none trace=f8c6a615535e3729d749bc44ac28436c host=robb-studio base=3f7b6fe878c702bf96737e5a01145c0b488fee4f run=loom-run/v1:script:robb-studio/fleet-resync:66678e69-bbef-41df-8a24-1d1ac846c831 installs=0.19.652 235a64727b907d65529151af0a962b14f16462a0 -->
    Loom-Trace-Id: f8c6a615535e3729d749bc44ac28436c
    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
2026-10-03 chore: resync installed Loom surfaces
    <!-- loom:provenance v1 build=unknown 21130104346fe9c464ce8a3fdf82c1d3e9667639 clean prompts=none sweep=none story=none trace=36308fff5a3c323c3d1bf6fffb6cd122 host=robb-studio base=9c3715780e53bf41e3237a643cd72c29bc204644 run=loom-run/v1:timer:robb-studio/fleet-resync:89972fbd-0774-4402-bbb7-26c33a851735 installs=0.19.652 fb69233bd8f1dfc2bdee37d8b934f99274dc0193 -->
    Loom-Trace-Id: 36308fff5a3c323c3d1bf6fffb6cd122
    Loom-Build: unknown 21130104346fe9c464ce8a3fdf82c1d3e9667639 clean
    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
2026-10-04 chore: resync installed Loom surfaces
    <!-- loom:provenance v1 build=unknown 61870b40779d205c1555e801c6e1d95df083cdea clean prompts=none sweep=none story=none trace=fb9213e215442932d2af05f3b14977de host=robb-pro base=fb7846e59485a0550120aa7009b4fb17ae89db62 run=loom-run/v1:timer:robb-pro/fleet-resync:4c70cd1d-08cd-4add-8e2a-9a75160d163f installs=0.19.655 36c39e3c6f56e1979647ec235b4bd19c77db22f3 -->
    Loom-Trace-Id: fb9213e215442932d2af05f3b14977de
    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
2026-10-04 chore: resync installed Loom surfaces
    <!-- loom:provenance v1 build=unknown 61870b40779d205c1555e801c6e1d95df083cdea clean prompts=none sweep=none story=none trace=baa6c2cfcae1a320917c00ff2eb8b630 host=loom-worker-2 base=33d1b1d9034e1d870e8a08736936524ce9ddba3e run=loom-run/v1:timer:loom-worker-2/fleet-resync:741a7f0f16df4fb1be4e657aeacd1244 installs=0.19.655 fc667a4faae1227f8a6837431f8a0c2d0aeaa7dd -->
    Loom-Trace-Id: baa6c2cfcae1a320917c00ff2eb8b630
    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
2026-10-04 chore: resync installed Loom surfaces
    <!-- loom:provenance v1 build=unknown b922acb2ac655cbccd71daa9e3f05a325a094ca5 clean prompts=none sweep=none story=none trace=833eeb34d4ca65c3f8c6f7824ddca3a3 host=robb-studio base=358aa562fce78c86bdd1ff5ebc01065de02c72ea run=loom-run/v1:timer:robb-studio/fleet-resync:0d44f6dc-6a62-4d43-b49d-7cfdd7dbd823 installs=0.19.663 0a51e373e7fe1be156c5774b2c827d4b745368a3 -->
    Loom-Trace-Id: 833eeb34d4ca65c3f8c6f7824ddca3a3
    Loom-Build: unknown b922acb2ac655cbccd71daa9e3f05a325a094ca5 clean
    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
2026-10-04 chore: resync installed Loom surfaces
    <!-- loom:provenance v1 build=unknown 746ecb5f9d7e64ba1d2526f1e997530ad4f3dd43 clean prompts=none sweep=none story=none trace=f09501431241df2ec5688e334ba43dfe host=loom-worker-2 base=37d5dedac4dc5ef6dab405828c3e066469294f77 run=loom-run/v1:timer:loom-worker-2/fleet-resync:70797dad61fb4e21806716d54f1ce910 installs=0.19.669 59a1f84e3742827a8033bb153ebbedc1759bee72 -->
    Loom-Trace-Id: f09501431241df2ec5688e334ba43dfe
    Loom-Build: unknown 746ecb5f9d7e64ba1d2526f1e997530ad4f3dd43 clean
    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
2026-10-04 chore: resync installed Loom surfaces
    <!-- loom:provenance v1 build=unknown 8080d0485cc1312129ee642b084944c56d1be074 clean prompts=none sweep=none story=none trace=ed180bcab6828041123ad54d8ddb4037 host=robb-pro base=c6d43d87e67735c1e3560db48c4173682b3a67ab run=loom-run/v1:timer:robb-pro/fleet-resync:e97b2f08-4ad9-4b66-a166-5b19820e2d1f installs=0.19.669 59a1f84e3742827a8033bb153ebbedc1759bee72 -->
    Loom-Trace-Id: ed180bcab6828041123ad54d8ddb4037
    Loom-Build: unknown 8080d0485cc1312129ee642b084944c56d1be074 clean
    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
2026-10-04 chore: resync installed Loom surfaces
    <!-- loom:provenance v1 build=unknown 83cb6647167ffc000d2c2f479b4e816b68f863f4 clean prompts=none sweep=none story=none trace=ccabffa1e1ba495895b262086030816c host=robb-studio base=38262f23a280fcef83ac3359d2a873d36b6bad25 run=loom-run/v1:timer:robb-studio/fleet-resync:88a78f1f-d978-47b5-99c3-2aabde811d17 installs=0.19.676 cd4f30bd892ea2595d8218b08150633504b0dd14 -->
    Loom-Trace-Id: ccabffa1e1ba495895b262086030816c
    Loom-Build: unknown 83cb6647167ffc000d2c2f479b4e816b68f863f4 clean
    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
2026-10-04 chore: resync installed Loom surfaces
    <!-- loom:provenance v1 build=unknown 32174d0f7e80508fa66c1a11a2c0fb28c515607e clean prompts=none sweep=none story=none trace=436d7c19b10cd5807625a7ce7190a82f host=loom-worker-2 base=18103beda9cf2cc731bc22a69232d11c6564ee02 run=loom-run/v1:timer:loom-worker-2/fleet-resync:19ae50771cc04d8db7b1403c1e66bbea installs=0.19.682 9eccfa110fa294fa32a62ffe8eff669cfcf1a3a6 -->
    Loom-Trace-Id: 436d7c19b10cd5807625a7ce7190a82f
    Loom-Build: unknown 32174d0f7e80508fa66c1a11a2c0fb28c515607e clean
    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
2026-10-04 chore: resync installed Loom surfaces
    <!-- loom:provenance v1 build=unknown 72290fa960e0773b2c50d74042e24914c7327637 clean prompts=none sweep=none story=none trace=f7b6952a649a174398a48b90b6ab4793 host=robb-pro base=3677732b70e0f4ce9ad9f5a3ad1ec85b1e17f580 run=loom-run/v1:timer:robb-pro/fleet-resync:72f32482-5cc4-4b38-ab9e-4d2ef0b64e94 installs=0.19.684 bdb8fb331eb51c7def4cdd2c38b611af06f25f6d -->
    Loom-Trace-Id: f7b6952a649a174398a48b90b6ab4793
    Loom-Build: unknown 72290fa960e0773b2c50d74042e24914c7327637 clean
    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
2026-10-04 chore: resync installed Loom surfaces
    <!-- loom:provenance v1 build=unknown 76cda58637be0e74c4cb5b4c8dbc2000e2a9c3d4 clean prompts=none sweep=none story=none trace=614cbada5ce873c2b34a511816309cfc host=robb-studio base=cdd1628543d126b4ff1b76294bfe30d0bb2d68fa run=loom-run/v1:timer:robb-studio/fleet-resync:7e559a3b-ffdd-409b-8dd2-ae906a273b0a installs=0.19.692 d4974b9f5ff7843a3cfc06378ea2a69bc120e0f4 -->
    Loom-Trace-Id: 614cbada5ce873c2b34a511816309cfc
    Loom-Build: unknown 76cda58637be0e74c4cb5b4c8dbc2000e2a9c3d4 clean
    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
2026-10-04 chore: resync installed Loom surfaces
    <!-- loom:provenance v1 build=unknown f84bac5c232c093f83c1adc2533d8c75b021cda2 clean prompts=none sweep=none story=none trace=e687830614e4bd1c551ab6cf6186f8f3 host=loom-worker-2 base=6faff228dceca8376b3fe0b8f21a60dd88fa8a10 run=loom-run/v1:timer:loom-worker-2/fleet-resync:2db2c4373ac24de1b7a364e69eaea1ca installs=0.19.695 b0d5b09f207fda439390ea1dd249ad10e7009dfc -->
    Loom-Trace-Id: e687830614e4bd1c551ab6cf6186f8f3
    Loom-Build: unknown f84bac5c232c093f83c1adc2533d8c75b021cda2 clean
    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
2026-10-04 chore: resync installed Loom surfaces
    <!-- loom:provenance v1 build=unknown ac5c275d1c616a9723e747f5a66de93dc80d3512 clean prompts=none sweep=none story=none trace=c777c3912bd31972e9aa3ccab712ae01 host=loom-worker-1 base=99353887fb19180391ad529cf69f68b546eb4d68 run=loom-run/v1:script:loom-worker-1/fleet-resync:b51a1b33-4958-4408-be36-166e12e8360b installs=0.19.697 ada83a5c7ff66b56b0060ef0be368c9fe56eb3c6 -->
    Loom-Trace-Id: c777c3912bd31972e9aa3ccab712ae01
    Loom-Build: unknown ac5c275d1c616a9723e747f5a66de93dc80d3512 clean
    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
2026-10-04 chore: resync installed Loom surfaces
    <!-- loom:provenance v1 build=unknown a19f642f5c09599c4c64827d81d228eb031be73e clean prompts=none sweep=none story=none trace=34a80e22764eb5055e37faec0eaf65fb host=robb-pro base=154f433b63dbf0e86e2134fc2d9e8b3844d44fae run=loom-run/v1:script:robb-pro/fleet-resync:689be620-3ff2-4ff5-a2ce-f6825f6379e2 installs=0.19.697 ada83a5c7ff66b56b0060ef0be368c9fe56eb3c6 -->
    Loom-Trace-Id: 34a80e22764eb5055e37faec0eaf65fb
    Loom-Build: unknown a19f642f5c09599c4c64827d81d228eb031be73e clean
    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
2026-10-04 chore: resync installed Loom surfaces
    <!-- loom:provenance v1 build=unknown 693bdd794cb34afdefd7f0c4596824cd53078a61 clean prompts=none sweep=none story=none trace=7e7be58c80b40f1ac882b00139fb0ca0 host=robb-pro base=72cb64fd7f65005e573705092ee12465a4e9dffe run=loom-run/v1:timer:robb-pro/fleet-resync:d64fbd6b-5d9b-491d-9e17-742b375bfba7 installs=0.19.698 aa619a1d07e36e8d90ac01fea63dc39285c93567 -->
    Loom-Trace-Id: 7e7be58c80b40f1ac882b00139fb0ca0
    Loom-Build: unknown 693bdd794cb34afdefd7f0c4596824cd53078a61 clean
    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
2026-10-04 chore: resync installed Loom surfaces
    <!-- loom:provenance v1 build=unknown 693bdd794cb34afdefd7f0c4596824cd53078a61 clean prompts=none sweep=none story=none trace=aa18f1ec102a98d77ffc51c9be6ffbb3 host=robb-studio base=310c75ccc55b8a39480a005c110e7f2e798b391c run=loom-run/v1:script:robb-studio/fleet-resync:3cb89ca8-62c2-4a69-8434-c4aaa3b64eaf installs=0.19.698 a58f00e0681c50d6bfc5089d0af4b3715198319f -->
    Loom-Trace-Id: aa18f1ec102a98d77ffc51c9be6ffbb3
    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
2026-10-04 chore: resync installed Loom surfaces
    <!-- loom:provenance v1 build=unknown 7a41c2e69ef89d60ed3bd190b94838021bf18d0f clean prompts=none sweep=none story=none trace=d0f04f38b507d85402723643fcf47197 host=loom-worker-1 base=28741d68b94195212ea5123f3d3d921bb6da0756 run=loom-run/v1:script:loom-worker-1/fleet-resync:8fdc8c1c-f844-4c33-bc80-b424e5b4cf3d installs=0.19.703 89d5a428c652f957d7fad8a546589042d39911bc -->
    Loom-Trace-Id: d0f04f38b507d85402723643fcf47197
    Loom-Build: unknown 7a41c2e69ef89d60ed3bd190b94838021bf18d0f clean
    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
2026-10-05 chore: resync installed Loom surfaces
    <!-- loom:provenance v1 build=unknown ebb37db560de172930e261675a35bd52e429f650 clean prompts=none sweep=none story=none trace=a40e86a64366c7a1e36aea026901334f host=loom-worker-2 base=0b8031dd6d73f93ef52a488626f77017a9a8ceac run=loom-run/v1:script:loom-worker-2/fleet-resync:90b6cd74-6cc0-4f58-98ee-6ede0ac6f50c installs=0.19.703 f63c3c82e6bf202f2ca7b205b532f681c5ebb2c8 -->
    Loom-Trace-Id: a40e86a64366c7a1e36aea026901334f
    Loom-Build: unknown ebb37db560de172930e261675a35bd52e429f650 clean
    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
2026-10-05 chore: resync installed Loom surfaces
    <!-- loom:provenance v1 build=unknown 7a41c2e69ef89d60ed3bd190b94838021bf18d0f clean prompts=none sweep=none story=none trace=fc04851db12f586b5d58155325131b6e host=robb-studio base=fe2229aa56f8ed5dccc68b7d2e3d65b3f16fc8de run=loom-run/v1:timer:robb-studio/fleet-resync:a7d5da6f-a896-4d6f-8d00-aebf47f9b266 installs=0.19.703 2ad9a08fb93de4d7dfac9d2b501d12c684c9c2cc -->
    Loom-Trace-Id: fc04851db12f586b5d58155325131b6e
    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
2026-10-05 chore: resync installed Loom surfaces
    <!-- loom:provenance v1 build=unknown afe7e99e397c242cc319fa80702fb3b23e23f5a7 clean prompts=none sweep=none story=none trace=e46782e1dd9c94461b4cf934ce05296b host=loom-worker-2 base=d27b02935cadd018d5bdcd1976dcbe4e03a381b9 run=loom-run/v1:timer:loom-worker-2/fleet-resync:caa89259b1fd414ebd2f07500621166d installs=0.19.703 972fe7321be6a9efe2653579379ea3bc40b899b2 -->
    Loom-Trace-Id: e46782e1dd9c94461b4cf934ce05296b
    Loom-Build: unknown afe7e99e397c242cc319fa80702fb3b23e23f5a7 clean
    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
2026-10-05 chore: resync installed Loom surfaces
    <!-- loom:provenance v1 build=unknown b44cb904ebb599db793066ccc631c846862abfbd clean prompts=none sweep=none story=none trace=9590fed7c1b1c9f549ccf3cba24292d7 host=robb-pro base=46eccdb78ad8c0dc15e9f0b4d741932c2488e556 run=loom-run/v1:timer:robb-pro/fleet-resync:dbc6174e-403d-422d-98b6-73a4b6dbf44f installs=0.19.708 dc8faf1eae3143feda6301887c303b1ee45db7f4 -->
    Loom-Trace-Id: 9590fed7c1b1c9f549ccf3cba24292d7
    Loom-Build: unknown b44cb904ebb599db793066ccc631c846862abfbd clean
    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
2026-10-05 chore: resync installed Loom surfaces
    <!-- loom:provenance v1 build=unknown 4548905848fcb7cb875c1c0518f2fd88eb65818e clean prompts=none sweep=none story=none trace=aff5e139797705f6fa0811f102ecd103 host=loom-worker-1 base=c8e82aa606be9885ec220d36253babbf709b4899 run=loom-run/v1:timer:loom-worker-1/fleet-resync:ba6a9e5686a64abaa842d71acaeae2ca installs=0.19.718 00d99344506bcf00e1aec7e910abe3d13df2d240 -->
    Loom-Trace-Id: aff5e139797705f6fa0811f102ecd103
    Loom-Build: unknown 4548905848fcb7cb875c1c0518f2fd88eb65818e clean
    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
2026-10-05 chore: resync installed Loom surfaces
    <!-- loom:provenance v1 build=unknown e7efbaa6e7b97a7d72da6032044c67525291f4d1 clean prompts=none sweep=none story=none trace=d74a33a6f35e329b3e795991e790ebfd host=robb-studio base=8c42a43ae6e86408cc26344a955ec9ba57878311 run=loom-run/v1:timer:robb-studio/fleet-resync:304f49c8-5b3e-46a9-a557-945b9ae177f0 installs=0.19.718 00d99344506bcf00e1aec7e910abe3d13df2d240 -->
    Loom-Trace-Id: d74a33a6f35e329b3e795991e790ebfd
    Loom-Build: unknown e7efbaa6e7b97a7d72da6032044c67525291f4d1 clean
    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
2026-10-05 chore: resync installed Loom surfaces
    <!-- loom:provenance v1 build=unknown 347b71e65e709d9fd49aba75d3fb67877fc08818 clean prompts=none sweep=none story=none trace=f9653dd318724c98136e7cef63e551ed host=robb-pro base=1c9df5e2e432bcd56454f7097ed24ad9d1956c31 run=loom-run/v1:timer:robb-pro/fleet-resync:cdc95970-9fb1-49fa-a0e6-037a3fab2099 installs=0.19.728 991dcebf6f6b2de6571f1d3400bec083498c6438 -->
    Loom-Trace-Id: f9653dd318724c98136e7cef63e551ed
    Loom-Build: unknown 347b71e65e709d9fd49aba75d3fb67877fc08818 clean
    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
2026-10-05 chore: resync installed Loom surfaces
    <!-- loom:provenance v1 build=unknown 5c0d18101f48fecb656f10fa37afa9b09bf41631 clean prompts=none sweep=none story=none trace=ddcf49552af364cbf6e884bd59584c1f host=loom-worker-1 base=69076509e63bed7cc9ff653d97f210af547971a1 run=loom-run/v1:timer:loom-worker-1/fleet-resync:5eb526a05f244f1985770579e7620ff1 installs=0.19.731 7484b71fce5179a025950e71a82855afaf6fd730 -->
    Loom-Trace-Id: ddcf49552af364cbf6e884bd59584c1f
    Loom-Build: unknown 5c0d18101f48fecb656f10fa37afa9b09bf41631 clean
    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
2026-10-05 chore: resync installed Loom surfaces
    <!-- loom:provenance v1 build=unknown 0b160514b6658e3ab26a71c6525791da25b46fcf clean prompts=none sweep=none story=none trace=311c3eb2c0ab9550d3de38df5523f3d7 host=robb-studio base=d014a0547513d8ddd2c7ac72328d2c574baac0f8 run=loom-run/v1:timer:robb-studio/fleet-resync:e6dec631-b42b-4cf2-b854-cc363cfde6e0 installs=0.19.731 d6146becf339a3d4e55e26e8807ac4571213a00b -->
    Loom-Trace-Id: 311c3eb2c0ab9550d3de38df5523f3d7
    Loom-Build: unknown 0b160514b6658e3ab26a71c6525791da25b46fcf clean
    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
2026-10-05 chore: resync installed Loom surfaces
    <!-- loom:provenance v1 build=unknown 5c0d18101f48fecb656f10fa37afa9b09bf41631 clean prompts=none sweep=none story=none trace=f1e8d4c6e73b8eec3e87a8da52e10f2d host=robb-pro base=30f0bf9e5c6c87684c9df905753b23e1b99f3ce0 run=loom-run/v1:timer:robb-pro/fleet-resync:5518fd33-81cb-479f-93f0-287ea4b08876 installs=0.19.733 4e67131ce3a1317d8cb8904ec342541cc2f45665 -->
    Loom-Trace-Id: f1e8d4c6e73b8eec3e87a8da52e10f2d
    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
2026-10-05 chore: resync installed Loom surfaces
    <!-- loom:provenance v1 build=unknown ca170d11544ef499cc9500a45bbad152edacfbd1 clean prompts=none sweep=none story=none trace=6dcfc713b6a851b40932158c2eeb70af host=loom-worker-3 base=a466452caed828b3349a1c9644af84fbc68067d7 run=loom-run/v1:timer:loom-worker-3/fleet-resync:20ce0908ea5a468a9e055470104047ed installs=0.19.734 7ba6ea50c36dfdd2b5e2922dd22c65560980a5a2 -->
    Loom-Trace-Id: 6dcfc713b6a851b40932158c2eeb70af
    Loom-Build: unknown ca170d11544ef499cc9500a45bbad152edacfbd1 clean
    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
2026-10-05 chore: resync installed Loom surfaces
    <!-- loom:provenance v1 build=unknown 03f1c42302d15f8a83425a84a4e36ca484f3f625 clean prompts=none sweep=none story=none trace=f1bc879f8aa652d550764ffcd36e27d1 host=loom-worker-1 base=0de2108b228f662a2b4e54362c12d731c0cbcfe3 run=loom-run/v1:timer:loom-worker-1/fleet-resync:f302a3cc8558413492093df510b02418 installs=0.19.734 967abe71d019ce6606018b4e57dee0223b84d96f -->
    Loom-Trace-Id: f1bc879f8aa652d550764ffcd36e27d1
    Loom-Build: unknown 03f1c42302d15f8a83425a84a4e36ca484f3f625 clean
    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
2026-10-05 chore: resync installed Loom surfaces
    <!-- loom:provenance v1 build=unknown ce7557ba58624d48fedbca2bc037dfa8ce3943e7 clean prompts=none sweep=none story=none trace=e1f2558834c47835cd9a53ec8c9a2ffa host=loom-worker-3 base=3daf236c26569ffa75c57ece9b1c1e1cd7556be6 run=loom-run/v1:timer:loom-worker-3/fleet-resync:50f5f0046e2c4890961b3221bd360247 installs=0.19.734 ba9edb650872e5265eaca0c47f75e3cb828ecad2 -->
    Loom-Trace-Id: e1f2558834c47835cd9a53ec8c9a2ffa
    Loom-Build: unknown ce7557ba58624d48fedbca2bc037dfa8ce3943e7 clean
    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
2026-10-05 chore: resync installed Loom surfaces
    <!-- loom:provenance v1 build=unknown f92eaec38470a7b0732e065f4864faec9a1905d6 clean prompts=none sweep=none story=none trace=07aa020a8179d52651250562e9808b98 host=robb-studio base=56506822baa02a75061a2fe42ae813580ac699c6 run=loom-run/v1:timer:robb-studio/fleet-resync:3b3ebdf2-b5f7-48ed-b7bb-5fb945094061 installs=0.19.734 78f3e99c44d0af6d4598adf7577bb6676baf3e8f -->
    Loom-Trace-Id: 07aa020a8179d52651250562e9808b98
    Loom-Build: unknown f92eaec38470a7b0732e065f4864faec9a1905d6 clean
    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
2026-10-06 chore: resync installed Loom surfaces
    <!-- loom:provenance v1 build=unknown ca170d11544ef499cc9500a45bbad152edacfbd1 clean prompts=none sweep=none story=none trace=fca9c14d74d6d634726f5823c51bc62a host=loom-worker-2 base=103d3a725266bd5e1e0151b4ae14d4aea7bba3e2 run=loom-run/v1:timer:loom-worker-2/fleet-resync:23a23f0878c1494cb720941baddfea81 installs=0.19.741 3cede3920c6b567d5400789187a904970d46b0fb -->
    Loom-Trace-Id: fca9c14d74d6d634726f5823c51bc62a
    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
2026-10-06 chore: resync installed Loom surfaces
    <!-- loom:provenance v1 build=unknown e38a22941348fd8e83d1f4b06130d2a214adfb50 clean prompts=none sweep=none story=none trace=a7fe3a9a1fedfce89846c20f2e98ac31 host=robb-pro base=2e99e59b2fa4c71bc6e4ab74a42414220da7888c run=loom-run/v1:timer:robb-pro/fleet-resync:2d770a42-f0e7-4695-abfa-b912e75382e6 installs=0.19.744 8bc5bcce93c4d9721817387afe8b4b6d79f26054 -->
    Loom-Trace-Id: a7fe3a9a1fedfce89846c20f2e98ac31
    Loom-Build: unknown e38a22941348fd8e83d1f4b06130d2a214adfb50 clean
    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
2026-10-06 chore: resync installed Loom surfaces
    <!-- loom:provenance v1 build=unknown f66ea90ff1bdec51aa4c8dc3f4b2e8d26e3dfd2d clean prompts=none sweep=none story=none trace=66d96c3bb00b04fae967865ee02fc4de host=loom-worker-3 base=8cc775e0db69b6fe68695e3bc13693d28a797acd run=loom-run/v1:timer:loom-worker-3/fleet-resync:eb2dceb410e848a19d58f96f678c995e installs=0.19.749 6135634b053dc30ef5aa8e6d733bfe79bb2ac734 -->
    Loom-Trace-Id: 66d96c3bb00b04fae967865ee02fc4de
    Loom-Build: unknown f66ea90ff1bdec51aa4c8dc3f4b2e8d26e3dfd2d clean
    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
2026-10-06 chore: resync installed Loom surfaces
    <!-- loom:provenance v1 build=unknown ade8a2c60cc8370d04d72f331141acb6fb32e121 clean prompts=none sweep=none story=none trace=6245fb88b5bdf9f7ccecb6b2168dc335 host=robb-studio base=eb31951b84f6a02e9ce7510951dfd0f8fed8a458 run=loom-run/v1:timer:robb-studio/fleet-resync:b305aed2-1a25-4576-aca7-9b017ac4377e installs=0.19.755 8d97d322e1cb3723988504337089beca73d0511c -->
    Loom-Trace-Id: 6245fb88b5bdf9f7ccecb6b2168dc335
    Loom-Build: unknown ade8a2c60cc8370d04d72f331141acb6fb32e121 clean
    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
2026-10-06 chore: resync installed Loom surfaces
    <!-- loom:provenance v1 build=unknown 2489bb7d5203844b3fbe8efbe007f44aa074685d clean prompts=none sweep=none story=none trace=0b5c9263a55c09e6fbd870b2d9ff5d9b host=loom-worker-2 base=9b37926a72682d9eea614c6feb7e13ad543267f3 run=loom-run/v1:timer:loom-worker-2/fleet-resync:d3f5a5beb1144f72ac8be575767b3e03 installs=0.19.760 3a509582b179d91c2d5b5a65a7ba4650c3c08985 -->
    Loom-Trace-Id: 0b5c9263a55c09e6fbd870b2d9ff5d9b
    Loom-Build: unknown 2489bb7d5203844b3fbe8efbe007f44aa074685d clean
    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
2026-10-06 chore: resync installed Loom surfaces
    <!-- loom:provenance v1 build=unknown 986d16b700174622774ff68af4ef323e8d0e23ba clean prompts=none sweep=none story=none trace=cb518f1f5785c258556383940a46c461 host=loom-worker-1 base=509602e4bf4365923446529f19ef722f90ba44cc run=loom-run/v1:timer:loom-worker-1/fleet-resync:97df92c5eca846de85e979810663a94b installs=0.19.765 c6cec65c4f320f11153c72e840e49a5d6a6f1afc -->
    Loom-Trace-Id: cb518f1f5785c258556383940a46c461
    Loom-Build: unknown 986d16b700174622774ff68af4ef323e8d0e23ba clean
    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
2026-10-06 chore: resync installed Loom surfaces
    <!-- loom:provenance v1 build=unknown 85e52221261264d7f7643251de706f00c8db289f clean prompts=none sweep=none story=none trace=a2434124d73d8cca0ca77230fc85adf5 host=robb-pro base=e22bd9a897d5626ad2c808f412749e61687d98c9 run=loom-run/v1:timer:robb-pro/fleet-resync:abffb067-59ed-4a6e-94b6-8cf3500c935c installs=0.19.768 c9f7ca975144d991bce40f492403b8292e8b7fae -->
    Loom-Trace-Id: a2434124d73d8cca0ca77230fc85adf5
    Loom-Build: unknown 85e52221261264d7f7643251de706f00c8db289f clean
    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
2026-10-06 chore: resync installed Loom surfaces
    <!-- loom:provenance v1 build=unknown 31b34ebfd7d4539094523eaa7b56a104bebe5fc0 clean prompts=none sweep=none story=none trace=16fac36f144dc183c71465eb36c89afc host=loom-worker-3 base=bd807bae6ee4839dc0454062bd4c862929e01bc0 run=loom-run/v1:timer:loom-worker-3/fleet-resync:c763e24590314b918c8ee8df5d2de1db installs=0.19.769 af995a5725fdadf708127f006aa8f248b482d7d7 -->
    Loom-Trace-Id: 16fac36f144dc183c71465eb36c89afc
    Loom-Build: unknown 31b34ebfd7d4539094523eaa7b56a104bebe5fc0 clean
    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
2026-10-06 chore: resync installed Loom surfaces
    <!-- loom:provenance v1 build=unknown 7bed309263b3785eae46a9cbc53b3b24a52b10d2 clean prompts=none sweep=none story=none trace=843adbd5eac450c43d3a2c43da1bf729 host=robb-studio base=edec0d319addc5d46f04c6569b02d188f66efebe run=loom-run/v1:timer:robb-studio/fleet-resync:f83d5ba4-81f7-479a-9768-6af33d4cc825 installs=0.19.783 a9b459e0c2b1916ceb116db33053e7eb0df57e7b -->
    Loom-Trace-Id: 843adbd5eac450c43d3a2c43da1bf729
    Loom-Build: unknown 7bed309263b3785eae46a9cbc53b3b24a52b10d2 clean
    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
2026-10-06 chore: resync installed Loom surfaces
    <!-- loom:provenance v1 build=unknown 07bc40ba9ab0f7dfe7cd0990377b7ac07a52d220 clean prompts=none sweep=none story=none trace=563f186108419cf03cef002a62c3b201 host=loom-worker-2 base=61a5d46ea90547f3585e153febbb9c0ea27025e4 run=loom-run/v1:timer:loom-worker-2/fleet-resync:944beccd157a4197b81feafdd19f443e installs=0.19.785 2f0a9dbb4f06053f747b8a5615a3519f8e30b527 -->
    Loom-Trace-Id: 563f186108419cf03cef002a62c3b201
    Loom-Build: unknown 07bc40ba9ab0f7dfe7cd0990377b7ac07a52d220 clean
    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
2026-10-06 chore: resync installed Loom surfaces
    <!-- loom:provenance v1 build=unknown 31b34ebfd7d4539094523eaa7b56a104bebe5fc0 clean prompts=none sweep=none story=none trace=ea6600df41a4b420b6d8e967f839ccfd host=loom-worker-3 base=5af0caad9469153b554dac2c29a377a82dd79b16 run=loom-run/v1:timer:loom-worker-3/fleet-resync:c80415b48fd5404bbd599c4f6cc8a448 installs=0.19.793 7ceff96944c39d33e3c2f1141ca650c2c4c05679 -->
    Loom-Trace-Id: ea6600df41a4b420b6d8e967f839ccfd
    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
2026-10-06 chore: resync installed Loom surfaces
    <!-- loom:provenance v1 build=unknown 596a53e525683919daae1b43e6babe9bf847a02f clean prompts=none sweep=none story=none trace=b9c0cb42a5a72ecc21726229c957ef1f host=loom-worker-2 base=c85f32c191d70a31a1192b923a5c48adb3c62df9 run=loom-run/v1:timer:loom-worker-2/fleet-resync:21d578f5cc0b4b7ba5f10759f5f30ae8 installs=0.19.801 524bdb33cb26c8355454d7550413c89e72c06fae -->
    Loom-Trace-Id: b9c0cb42a5a72ecc21726229c957ef1f
    Loom-Build: unknown 596a53e525683919daae1b43e6babe9bf847a02f clean
    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
2026-10-06 chore: resync installed Loom surfaces
    <!-- loom:provenance v1 build=unknown 40b591a33adb895d4f46977105f9b264d8a2599b clean prompts=none sweep=none story=none trace=e41c725fe0c176312eb412bc69fe5b01 host=robb-studio base=1bd34b2c1c0274e702d56d2e26ca9ef706ffb201 run=loom-run/v1:timer:robb-studio/fleet-resync:37d704dd-4dfd-4341-adb4-6551637ad147 installs=0.19.802 72ce1f7385747dd773d1644408ec22072b8a5d20 -->
    Loom-Trace-Id: e41c725fe0c176312eb412bc69fe5b01
    Loom-Build: unknown 40b591a33adb895d4f46977105f9b264d8a2599b clean
    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
2026-10-06 chore: resync installed Loom surfaces
    <!-- loom:provenance v1 build=unknown 31b34ebfd7d4539094523eaa7b56a104bebe5fc0 clean prompts=none sweep=none story=none trace=5ad0480c4b21b80f9c852c448319e7a1 host=loom-worker-3 base=a5cf3c929855cb5f1dfc04c38eaa804f9ea4020e run=loom-run/v1:timer:loom-worker-3/fleet-resync:48e836f11f9547ddb96de5aa0d072a05 installs=0.19.810 933f828e779602e492e4e157812988a4b8128111 -->
    Loom-Trace-Id: 5ad0480c4b21b80f9c852c448319e7a1
    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
2026-10-07 chore: resync installed Loom surfaces
    <!-- loom:provenance v1 build=unknown f71cf25de9e75bae6060da4a599df8fbabe75890 clean prompts=none sweep=none story=none trace=64943e35511da4833bbd385cf288be8a host=loom-worker-2 base=005b32eb1def4161c3d422a397863103ad4ec64a run=loom-run/v1:timer:loom-worker-2/fleet-resync:d69eb1b87d4849ae810a145b1b667d2f installs=0.19.822 1c6969ea8726c800a353c236d9f23456a5706f1a -->
    Loom-Trace-Id: 64943e35511da4833bbd385cf288be8a
    Loom-Build: unknown f71cf25de9e75bae6060da4a599df8fbabe75890 clean
    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
2026-10-07 docs: update work log and current backlog plan
2026-10-07 chore: resync installed Loom surfaces
    <!-- loom:provenance v1 build=unknown 31b34ebfd7d4539094523eaa7b56a104bebe5fc0 clean prompts=none sweep=none story=none trace=cb192cb8f72cf6f2711f73f7ee12bebc host=loom-worker-3 base=a702aa6a2c0b5d6dd11e21f14518925a989f72de run=loom-run/v1:timer:loom-worker-3/fleet-resync:c1e385c3607e43ad8bed9c7d29811c66 installs=0.19.830 a966f7b89b714704fa1225b96e2dbee50480a4c6 -->
    Loom-Trace-Id: cb192cb8f72cf6f2711f73f7ee12bebc
    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
2026-10-07 chore: resync installed Loom surfaces
    <!-- loom:provenance v1 build=unknown 8abdd34fddc879aff407380278baa713eca6b758 clean prompts=none sweep=none story=none trace=ea945665dad5ccb3880de51c4448e8b9 host=robb-pro base=d26b127a0526208c143577524dded65452fdd5a8 run=loom-run/v1:timer:robb-pro/fleet-resync:1466e397-b80c-46ea-a42c-26a7fbd4e00e installs=0.19.831 61814c9c1912925cdff7418842ff3ea17cd56fe4 -->
    Loom-Trace-Id: ea945665dad5ccb3880de51c4448e8b9
    Loom-Build: unknown 8abdd34fddc879aff407380278baa713eca6b758 clean
    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
2026-10-07 chore: resync installed Loom surfaces
    <!-- loom:provenance v1 build=unknown 628be5bb140bcff803d159201bd61e1b868901b0 clean prompts=none sweep=none story=none trace=093df1dc315c5e78dcccfca9d699d5f5 host=loom-worker-2 base=1ec29c8cff495ac155b1a59197521f5cadd2da30 run=loom-run/v1:timer:loom-worker-2/fleet-resync:0b0ea5e184c0429a9c431fcca6c791ad installs=0.19.832 1a0fc15974bf0575a9155fb8276f7529fc813542 -->
    Loom-Trace-Id: 093df1dc315c5e78dcccfca9d699d5f5
    Loom-Build: unknown 628be5bb140bcff803d159201bd61e1b868901b0 clean
    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
2026-10-07 chore: resync installed Loom surfaces
    <!-- loom:provenance v1 build=unknown 069e3b45d86c08f0d60c8fc2b0096de441e99bdc clean prompts=none sweep=none story=none trace=b1ba9d6b2b581e47827d9c099f717b04 host=loom-worker-1 base=70b3687231370ed3d73168da97eca7f998b9a48a run=loom-run/v1:timer:loom-worker-1/fleet-resync:aada8278bd4843bcaecce69fdf91251e installs=0.19.837 9504f1e9b05e05ce908dd5cffad2aae723621f63 -->
    Loom-Trace-Id: b1ba9d6b2b581e47827d9c099f717b04
    Loom-Build: unknown 069e3b45d86c08f0d60c8fc2b0096de441e99bdc clean
    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
2026-10-07 chore: resync installed Loom surfaces
    <!-- loom:provenance v1 build=unknown 31b34ebfd7d4539094523eaa7b56a104bebe5fc0 clean prompts=none sweep=none story=none trace=ef030e94bce76f728497f5927960865f host=loom-worker-3 base=c37fe80b5e64d16d774ac45ffb8a3a2a775c2177 run=loom-run/v1:timer:loom-worker-3/fleet-resync:28ba4284bfa446c888b501714eda0509 installs=0.19.840 59b533a2a1ed5e186fbf8446b5acbe42d7231854 -->
    Loom-Trace-Id: ef030e94bce76f728497f5927960865f
    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
2026-10-07 chore: resync installed Loom surfaces
    <!-- loom:provenance v1 build=unknown bc59c70c3412a87b31a0dbe65cd6abf968744328 clean prompts=none sweep=none story=none trace=766033e4e881801f24971d664c490ea3 host=robb-studio base=51b55d3d9eb7f3fb9a0521c18113cbdde6fb05cb run=loom-run/v1:timer:robb-studio/fleet-resync:6b3b079a-890e-4a79-9c3a-0b4bb33ff7c4 installs=0.19.840 59b533a2a1ed5e186fbf8446b5acbe42d7231854 -->
    Loom-Trace-Id: 766033e4e881801f24971d664c490ea3
    Loom-Build: unknown bc59c70c3412a87b31a0dbe65cd6abf968744328 clean
    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
2026-10-07 chore: resync installed Loom surfaces
    <!-- loom:provenance v1 build=unknown a068938e7a6c13759bcb3943e408273a3d352257 clean prompts=none sweep=none story=none trace=76bec863c8f6aff2d49b3aa2be128619 host=robb-pro base=2d472fab896f1aca32f632986c994c9564cdcb61 run=loom-run/v1:timer:robb-pro/fleet-resync:d9927fc6-ee80-4b6a-ba2b-f13576bd5f9b installs=0.19.846 837b14d7440b89ae8a2cec6d045483ac33659af5 -->
    Loom-Trace-Id: 76bec863c8f6aff2d49b3aa2be128619
    Loom-Build: unknown a068938e7a6c13759bcb3943e408273a3d352257 clean
    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
2026-10-07 chore: resync installed Loom surfaces
    <!-- loom:provenance v1 build=unknown 628be5bb140bcff803d159201bd61e1b868901b0 clean prompts=none sweep=none story=none trace=5a6f676b4652a1a750bbce1386c68d06 host=loom-worker-2 base=4221f40bccb7736c6c43f5b42be4b1883b390488 run=loom-run/v1:timer:loom-worker-2/fleet-resync:bd416e653be04ef4b13353430625e379 installs=0.19.850 3bb4bfc90603b6ad65cabca9b3eb42a59f1a9d3a -->
    Loom-Trace-Id: 5a6f676b4652a1a750bbce1386c68d06
    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
2026-10-07 chore: resync installed Loom surfaces
    <!-- loom:provenance v1 build=unknown 40215645df8a13508180b248b44244dc488bb078 clean prompts=none sweep=none story=none trace=29fde30615e6e47f39b41aa314c2c883 host=loom-worker-1 base=a494b4fc2bf578bfb8b4a3a898271aff50e4df38 run=loom-run/v1:timer:loom-worker-1/fleet-resync:d1fbedfcc7824ae59233c0ea94dc4650 installs=0.19.853 2889d5ed585b4da0935543cb916381cc03b19746 -->
    Loom-Trace-Id: 29fde30615e6e47f39b41aa314c2c883
    Loom-Build: unknown 40215645df8a13508180b248b44244dc488bb078 clean
    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
2026-10-07 chore: resync installed Loom surfaces
    <!-- loom:provenance v1 build=unknown 31b34ebfd7d4539094523eaa7b56a104bebe5fc0 clean prompts=none sweep=none story=none trace=cdf49c615da3f5ce46e9fcda1a24f787 host=loom-worker-3 base=c2087787b5c90dea22d09c88eb19b0a9b565cdf6 run=loom-run/v1:timer:loom-worker-3/fleet-resync:cab31e05b8a24df09bc88f53ee3fb501 installs=0.19.857 7a0b529e6f57a79713f6924bf58d8392ff404259 -->
    Loom-Trace-Id: cdf49c615da3f5ce46e9fcda1a24f787
    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
2026-10-07 chore: resync installed Loom surfaces
    <!-- loom:provenance v1 build=unknown 4b44e7c5db0de1d2b5927de7de229120d546aad3 clean prompts=none sweep=none story=none trace=dfa656ee3483a044378501f49d36f812 host=robb-studio base=7744cbd662df67aff60cb8feadfd802268f9c32f run=loom-run/v1:timer:robb-studio/fleet-resync:d80d6bc0-eb68-4a07-8226-2d947d328b3a installs=0.19.859 0aefebd79aba8ab33470f1af4b96847fc794bd0d -->
    Loom-Trace-Id: dfa656ee3483a044378501f49d36f812
    Loom-Build: unknown 4b44e7c5db0de1d2b5927de7de229120d546aad3 clean
    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
2026-10-07 chore: resync installed Loom surfaces
    <!-- loom:provenance v1 build=unknown b591c8cf436f0d4aa5870a9bc7cd5f7194e0e778 dirty prompts=none sweep=none story=none trace=6eca4b0c47205457aae7a3d721c17f17 host=robb-pro base=c7e49261db7f7871fa1a293107a032f4c4bcceca run=loom-run/v1:timer:robb-pro/fleet-resync:64af20b3-58cb-47f2-b770-117197cb41e9 installs=0.19.864 128a7eba2bb5f7bcf8891ba284b14cb7ebf8dd3d -->
    Loom-Trace-Id: 6eca4b0c47205457aae7a3d721c17f17
    Loom-Build: unknown b591c8cf436f0d4aa5870a9bc7cd5f7194e0e778 dirty
    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
2026-10-07 chore: resync installed Loom surfaces
    <!-- loom:provenance v1 build=unknown b551219fd5b8347113c0cbc79ea416e81c39fa9d clean prompts=none sweep=none story=none trace=5ac7c8c62dad54841e21dd94f0920de3 host=loom-worker-2 base=8b58120cf7ab1969b0ebcfc12076118d2d513c71 run=loom-run/v1:timer:loom-worker-2/fleet-resync:d10fb10789e94930ab1af368c15a8f8b installs=0.19.864 128a7eba2bb5f7bcf8891ba284b14cb7ebf8dd3d -->
    Loom-Trace-Id: 5ac7c8c62dad54841e21dd94f0920de3
    Loom-Build: unknown b551219fd5b8347113c0cbc79ea416e81c39fa9d clean
    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
2026-10-07 chore: resync installed Loom surfaces
    <!-- loom:provenance v1 build=unknown 90fbd167e4e376894396e651676cf58fc9aa223a clean prompts=none sweep=none story=none trace=196876656e912171b28029ceca9f772d host=loom-worker-1 base=1f453bafaf95ce0b531fe492eeeb9b301380c464 run=loom-run/v1:timer:loom-worker-1/fleet-resync:7b46720ff3a84a8184f2f2b3bc039260 installs=0.19.868 ee904e1c151bc9cf15b0eb55dfe9d57ad6136cff -->
    Loom-Trace-Id: 196876656e912171b28029ceca9f772d
    Loom-Build: unknown 90fbd167e4e376894396e651676cf58fc9aa223a clean
    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
2026-10-08 chore: resync installed Loom surfaces
    <!-- loom:provenance v1 build=unknown 5a3df331a0612dee585ef905015af01d08e3467f clean prompts=none sweep=none story=none trace=5690fa95febe608e500a46dde8a6ee92 host=loom-worker-2 base=6c0e54b0adea2d84de8dd34dfc248f54a3435429 run=loom-run/v1:timer:loom-worker-2/fleet-resync:5c9c35d59b704bff9d8bf096ee7ba7be installs=0.19.876 b16d54e63fbbec4d7f15f13c1f43a5e5b38145ce -->
    Loom-Trace-Id: 5690fa95febe608e500a46dde8a6ee92
    Loom-Build: unknown 5a3df331a0612dee585ef905015af01d08e3467f clean
    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
2026-10-08 chore: resync installed Loom surfaces
    <!-- loom:provenance v1 build=unknown 134eb3ff06c1a86f49a911c6c17464f55e719736 clean prompts=none sweep=none story=none trace=c7df110d490314040dcd1347b2481843 host=loom-worker-1 base=504f66083170328edbe7f1b925ffbc3b9d1f4ba3 run=loom-run/v1:timer:loom-worker-1/fleet-resync:53d0cec2cd61484eb9a0f8fb1f24ac5e installs=0.19.879 c15619905bdd8a24506c3853f45490d26e8f1cad -->
    Loom-Trace-Id: c7df110d490314040dcd1347b2481843
    Loom-Build: unknown 134eb3ff06c1a86f49a911c6c17464f55e719736 clean
    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
2026-10-08 chore: resync installed Loom surfaces
    <!-- loom:provenance v1 build=unknown 8f86de23319d8f6cf049557dcc9cf2e321211d9d clean prompts=none sweep=none story=none trace=17de45f778fbfd714af8afad02c96375 host=loom-worker-3 base=ef11cdbdca65f58a4517f63a8c4bb9dcfaf57393 run=loom-run/v1:timer:loom-worker-3/fleet-resync:9e3e5d4a08824de3b7bc02940be2a0da installs=0.19.882 c9f85af3d967986cdd7a3f27e088a16f88712b05 -->
    Loom-Trace-Id: 17de45f778fbfd714af8afad02c96375
    Loom-Build: unknown 8f86de23319d8f6cf049557dcc9cf2e321211d9d clean
    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
2026-10-08 chore: resync installed Loom surfaces
    <!-- loom:provenance v1 build=unknown 4a5fb2b6276e17ff26ee1382acfe2ea7360ebea5 clean prompts=none sweep=none story=none trace=67857e1b7189785825a2dfc70921cf85 host=loom-worker-2 base=88a3db2bb490e4a03ba7d298ed432e9c1577dc69 run=loom-run/v1:timer:loom-worker-2/fleet-resync:dd6a5f3dceff4d8d8602a07a1dc89c95 installs=0.19.892 ce93e8a919d79a6f027bab268846a52084f9d94e -->
    Loom-Trace-Id: 67857e1b7189785825a2dfc70921cf85
    Loom-Build: unknown 4a5fb2b6276e17ff26ee1382acfe2ea7360ebea5 clean
    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
2026-10-08 chore: resync installed Loom surfaces
    <!-- loom:provenance v1 build=unknown b591c8cf436f0d4aa5870a9bc7cd5f7194e0e778 dirty prompts=none sweep=none story=none trace=28e7ca5fdb768489aa38bf002407d5a5 host=robb-pro base=91bdeebbee2bfc4cd2c4ce252b05a679c373d24a run=loom-run/v1:timer:robb-pro/fleet-resync:eb5f838e-a774-4e20-8102-c37ee3ff31ca installs=0.19.895 9b30d293bcba1e79d49cabfc1c5bb5b6f4c0dc77 -->
    Loom-Trace-Id: 28e7ca5fdb768489aa38bf002407d5a5
    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
2026-10-08 chore: resync installed Loom surfaces
    <!-- loom:provenance v1 build=unknown 5684fc8c8ac418d95ad66a002d001eaea1283c9a clean prompts=none sweep=none story=none trace=c864acd3b9a5dbb419fddd8bd2a6283b host=loom-worker-3 base=5c60601dea7efcf3816bd776037f3a398105ce03 run=loom-run/v1:timer:loom-worker-3/fleet-resync:4771e7c630c34445b7f28539669d76e3 installs=0.19.898 3d55b9a1669c132d130d98f10a292c1325322c30 -->
    Loom-Trace-Id: c864acd3b9a5dbb419fddd8bd2a6283b
    Loom-Build: unknown 5684fc8c8ac418d95ad66a002d001eaea1283c9a clean
    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
2026-10-08 chore: resync installed Loom surfaces
    <!-- loom:provenance v1 build=unknown 04a1189116c7320def7d9ce357d2d9268405ae92 clean prompts=none sweep=none story=none trace=8e55b27fc60ffb045554bd413ad8f3c8 host=robb-pro base=47017634769096988f111a7451a5be6450e1a10c run=loom-run/v1:timer:robb-pro/fleet-resync:83b69005-7c5b-44b3-96f8-33f07bf82f4b installs=0.19.917 d3c1ea3a4c81e01ce5487dc3e4bbdd86534e677e -->
    Loom-Trace-Id: 8e55b27fc60ffb045554bd413ad8f3c8
    Loom-Build: unknown 04a1189116c7320def7d9ce357d2d9268405ae92 clean
    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
2026-10-08 chore(signoff): grade with released klt 0.6.0; retire vendored checklist
    Move the three grader pins (signoff/regenerate.sh, the CI signoff job's
    pip install, scripts/ci/check_signoff_freshness.py) and the shell install
    hint to klayout-tools==0.6.0. The 0.6.0 registry wheel reports
    package_version 0.6.0 / git_tag v0.6.0 / is_release true, and bundles the
    eleven-item checklist (t1_item_count 11, build_t1_item_count 11), so the
    vendored signoff/design-evidence-tiers.md, every --tiers-doc use, and the
    TIERS_DOC existence check are retired.
    Regenerated signoff/signoff-report.json with that wheel: items 1-10 stay
    met (item 6 input_verified true from repo-root grading). Item 11 is now
    graded_by_bu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
2026-10-08 chore: resync installed Loom surfaces
    <!-- loom:provenance v1 build=unknown d2a55ce217b3ad1793611a2c54946676bb55b512 clean prompts=none sweep=none story=none trace=459637e4e8503593bdf58360865a7524 host=robb-pro base=b4f1573bb12231868f2aee3702d5c187c69e65bd run=loom-run/v1:timer:robb-pro/fleet-resync:95b3cf92-9cd9-4c36-8bbd-bdcace7c3874 installs=0.19.935 d347079cd0bad2db2c11ee4f0b760f04b2601d21 -->
    Loom-Trace-Id: 459637e4e8503593bdf58360865a7524
    Loom-Build: unknown d2a55ce217b3ad1793611a2c54946676bb55b512 clean
    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
2026-10-09 chore: resync installed Loom surfaces
    <!-- loom:provenance v1 build=unknown 05dba463c5b293d38f0ca071725983862498b3f3 clean prompts=none sweep=none story=none trace=14298316053024bcf5120bff695771ab host=robb-pro base=3a70edf700a241bbcfcf0e73748fee0c2e79eb99 run=loom-run/v1:timer:robb-pro/fleet-resync:2f384483-6d77-4ba2-9888-aa1e4b5be36c installs=0.19.953 b93d7a955d63411cb4c94b986fd5138d27dedb0f -->
    Loom-Trace-Id: 14298316053024bcf5120bff695771ab
    Loom-Build: unknown 05dba463c5b293d38f0ca071725983862498b3f3 clean
    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
2026-10-09 T1 item 11: declare ties[] in the array supply spec, re-mint ERC under klt 0.6.0, cite ERC + LVS together
    Closes #159
    Loom-Story: 2AMLogic/gf180-sram#159
    Loom-Trace-Id: a1b8becf28d8501af61c72a46f66f170
    Loom-Build: 0.19.950 72047016af9d66c08f900bb94c642a66dfd75fc5 clean
2026-10-09 docs(layout): restate item-11 tie evidence in layout README
    The "proves" bullet still said erc.missing_tie was not computed and that
    item 4's LVS match stood in for it. After #159 both ties are declared and
    checked (substrate tie graded checked_by_well_assertion), a negative
    control shows the tie check can fail, and the LVS report is cited beside
    the ERC report. Also note that only the N-well tie has a recorded
    negative control.
    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
2026-10-09 chore: resync installed Loom surfaces
    <!-- loom:provenance v1 build=unknown 7f06b288b150f2fe0a4b24c331a9b3ec093d709d clean prompts=none sweep=none story=none trace=a90c217ff3a3bd9e3a30282b8cadc24d host=robb-pro base=f40148ad40e98bd662bff954c2427df69e13f773 run=loom-run/v1:timer:robb-pro/fleet-resync:6e5ec9f3-d6ef-4953-80f7-c93035e2d359 installs=0.19.966 9bed656320e53ba6c64305daa60613431a7ed02d -->
    Loom-Trace-Id: a90c217ff3a3bd9e3a30282b8cadc24d
    Loom-Build: unknown 7f06b288b150f2fe0a4b24c331a9b3ec093d709d clean
    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
2026-10-09 chore: resync installed Loom surfaces
    <!-- loom:provenance v1 build=unknown 30c7a7ee2f74a6a2b5bb0f19fd9f049ec8ae8b5c clean prompts=none sweep=none story=none trace=7bc5ba399ff199d049d83d711920a157 host=robb-pro base=a8c94cb514309c8c978cf7656d6fb7ecb177c527 run=loom-run/v1:timer:robb-pro/fleet-resync:8e237160-c4d0-4ce3-85ac-c96aff5cf221 installs=0.19.982 2bc4cba624b9053535663441e6f0daf08a7acf2e -->
    Loom-Trace-Id: 7bc5ba399ff199d049d83d711920a157
    Loom-Build: unknown 30c7a7ee2f74a6a2b5bb0f19fd9f049ec8ae8b5c clean
    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
2026-10-10 chore: resync installed Loom surfaces
    <!-- loom:provenance v1 build=unknown 03c1cb521a10d5101bd8aa2c52a47cebfb0e795b clean prompts=none sweep=none story=none trace=09ccab293fce5c1a7b4aa907c7197bec host=robb-studio base=2c09398871eb0bb8bf6ea84b4fadd3d742e070c5 run=loom-run/v1:timer:robb-studio/fleet-resync:ed2be6c5-20fe-4228-a206-940d35a4858f installs=0.19.996 0d2be7e9ae05753e2c9232a83b7399d45de5396e -->
    Loom-Trace-Id: 09ccab293fce5c1a7b4aa907c7197bec
    Loom-Build: unknown 03c1cb521a10d5101bd8aa2c52a47cebfb0e795b clean
    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
2026-10-10 chore: resync installed Loom surfaces
    <!-- loom:provenance v1 build=unknown a7d2b01d8eb7d09e597a4638e5cb3cdd8bab9156 clean prompts=none sweep=none story=none trace=35c1337ee84607e87ba2038523d63198 host=robb-pro base=5afeeeda527de63fe478813d27c6397f20bbe994 run=loom-run/v1:timer:robb-pro/fleet-resync:6bf32a81-6c4a-48c5-a51e-1ad65c6bedfd installs=0.19.999 20513e3064fa3a7c4b3f1c641d97a00446e9ba78 -->
    Loom-Trace-Id: 35c1337ee84607e87ba2038523d63198
    Loom-Build: unknown a7d2b01d8eb7d09e597a4638e5cb3cdd8bab9156 clean
    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
2026-10-10 chore: resync installed Loom surfaces
    <!-- loom:provenance v1 build=unknown c156f673e072832aaacb4cd1ec65b742e7f45867 clean prompts=none sweep=none story=none trace=9de99c124c651049199abe9a75070dc7 host=robb-pro base=8be0fc1714aa89fd3d0a2721cd642b46758ad40a run=loom-run/v1:timer:robb-pro/fleet-resync:f790885c-7154-4b3d-acd9-71fd537cd20b installs=0.19.1010 d1d5fcecb79550fe39658555a4419f98cec060fb -->
    Loom-Trace-Id: 9de99c124c651049199abe9a75070dc7
    Loom-Build: unknown c156f673e072832aaacb4cd1ec65b742e7f45867 clean
    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
2026-10-10 chore: resync installed Loom surfaces
    <!-- loom:provenance v1 build=unknown 52f79668bb5f93c1828b7f1ea4f7013b917b847b clean prompts=none sweep=none story=none trace=7057f3175071f1f6e34b354fab40a0ce host=robb-studio base=32d76c80d0a8949b1e4a4598083a3ebe7f463b28 run=loom-run/v1:timer:robb-studio/fleet-resync:d8918779-1625-4202-b151-71f64465e8cd installs=0.19.1010 d1d5fcecb79550fe39658555a4419f98cec060fb -->
    Loom-Trace-Id: 7057f3175071f1f6e34b354fab40a0ce
    Loom-Build: unknown 52f79668bb5f93c1828b7f1ea4f7013b917b847b clean
    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
2026-10-10 chore: resync installed Loom surfaces
    <!-- loom:provenance v1 build=unknown 525fe43b7b1b2a0271084bba444c934a1541a8d8 clean prompts=none sweep=none story=none trace=0d4424bd058cf912b74934ec0e7bf37e host=robb-pro base=ef27f990d3fb179ebde14917f0b8907f63923ae4 run=loom-run/v1:timer:robb-pro/fleet-resync:4812047c-8b9b-4da2-a5dc-13e6f6420a04 installs=0.19.1018 13e54f1cfc513507a7ef84ec6908085638d9c187 -->
    Loom-Trace-Id: 0d4424bd058cf912b74934ec0e7bf37e
    Loom-Build: unknown 525fe43b7b1b2a0271084bba444c934a1541a8d8 clean
    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
2026-10-10 chore: resync installed Loom surfaces
    <!-- loom:provenance v1 build=unknown 525fe43b7b1b2a0271084bba444c934a1541a8d8 clean prompts=none sweep=none story=none trace=d4059def94f46d8d158946acddd4d602 host=robb-studio base=dd7e90de6213970f57569a973f0a36199e3ddb90 run=loom-run/v1:timer:robb-studio/fleet-resync:4a4d1995-968e-44c5-b5fe-804b4d477795 installs=0.19.1019 febfc4335d0554865fadbecba718245cd88c6678 -->
    Loom-Trace-Id: d4059def94f46d8d158946acddd4d602
    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
2026-10-10 chore: resync installed Loom surfaces
    <!-- loom:provenance v1 build=unknown 5d5f41d89eef35adf478b92b96af06c6d86d27a6 clean prompts=none sweep=none story=none trace=05d2a40831b35ba1c48afada00c29519 host=robb-pro base=8a7f1aaa86413aac78402f3419dd643ad24a13c7 run=loom-run/v1:timer:robb-pro/fleet-resync:c58bb82e-a213-439d-b829-04234e141de9 installs=0.19.1027 59bb53f01eb99187ce25f22be1a64da5c877d115 -->
    Loom-Trace-Id: 05d2a40831b35ba1c48afada00c29519
    Loom-Build: unknown 5d5f41d89eef35adf478b92b96af06c6d86d27a6 clean
    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
2026-10-10 chore: resync installed Loom surfaces
    <!-- loom:provenance v1 build=unknown aa536103d6239818bb974a51d2f7f268eff38bad clean prompts=none sweep=none story=none trace=126a1328a3664e2119a0978086db9bea host=robb-studio base=9648bfc66ac58d528a6d9e205bd14258fb228664 run=loom-run/v1:timer:robb-studio/fleet-resync:fbc4e361-e290-4d81-ae3a-8b5fde796815 installs=0.19.1031 286d609f09342e7c84f2e23771edbac5b1914659 -->
    Loom-Trace-Id: 126a1328a3664e2119a0978086db9bea
    Loom-Build: unknown aa536103d6239818bb974a51d2f7f268eff38bad clean
    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
2026-10-11 chore: resync installed Loom surfaces
    <!-- loom:provenance v1 build=unknown cf08873555e2eb95da295dcbee98b0dc34473381 clean prompts=none sweep=none story=none trace=67fbc483c3ca3e442d7928804c11ff06 host=robb-pro base=b6557787e8020d467ef49509327f5309eb629719 run=loom-run/v1:timer:robb-pro/fleet-resync:e3f97888-2b26-404a-bd47-86fd28a4eced installs=0.19.1041 b65c266b47d796bf37d1c04c6f616be0bc699056 -->
    Loom-Trace-Id: 67fbc483c3ca3e442d7928804c11ff06
    Loom-Build: unknown cf08873555e2eb95da295dcbee98b0dc34473381 clean
    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
2026-10-11 chore: resync installed Loom surfaces
    <!-- loom:provenance v1 build=unknown e91831edf7b55b29d3a2d88e266916fab9ce2563 clean prompts=none sweep=none story=none trace=f72dd67520a2c3802aa0495b80ac65a5 host=robb-studio base=245861092d24611159db159c5cccffc2aaa30af0 run=loom-run/v1:timer:robb-studio/fleet-resync:91d2434e-eae5-45de-9305-d78c43fc7c7a installs=0.19.1042 5b6ebdcc40bfccc9357e15196984061f1d5e6178 -->
    Loom-Trace-Id: f72dd67520a2c3802aa0495b80ac65a5
    Loom-Build: unknown e91831edf7b55b29d3a2d88e266916fab9ce2563 clean
    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
2026-10-11 chore: resync installed Loom surfaces
    <!-- loom:provenance v1 build=unknown 5ec729b9f7dd55a2082752611e4c4964f49661fb clean prompts=none sweep=none story=none trace=efc2abc8b72538df6d1a6ea9d329603d host=robb-pro base=f94bb78cd8adf53b609169764a57f9bf5f17544c run=loom-run/v1:timer:robb-pro/fleet-resync:0d396c06-f26e-423e-97ac-6d3ac04a8e51 installs=0.19.1054 f6a73bc7fc942d7b297514b2e3f57a0ca2076010 -->
    Loom-Trace-Id: efc2abc8b72538df6d1a6ea9d329603d
    Loom-Build: unknown 5ec729b9f7dd55a2082752611e4c4964f49661fb clean
    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
2026-10-11 chore: resync installed Loom surfaces
    <!-- loom:provenance v1 build=unknown 745f69d0daad6c23e76cc006720fa4fbeaa3d887 clean prompts=none sweep=none story=none trace=3baabc4a039fd85029fff227a6ae690a host=robb-studio base=d33e62fd811819bf39daaa2db43cb699a7610a15 run=loom-run/v1:timer:robb-studio/fleet-resync:3b3207d7-055d-49b5-a387-db375213668d installs=0.19.1058 00ceead491dd1ae20db00db16a650ea43dd0c09b -->
    Loom-Trace-Id: 3baabc4a039fd85029fff227a6ae690a
    Loom-Build: unknown 745f69d0daad6c23e76cc006720fa4fbeaa3d887 clean
    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
2026-10-11 chore: resync installed Loom surfaces
    <!-- loom:provenance v1 build=unknown b37a005ac1889262fb9e5338f7cff4e9ed4987da clean prompts=none sweep=none story=none trace=25c158d7e9591610b251780caaff1c5f host=robb-pro base=4860e2a3367b906ff198b3f943cfb5769a13c36c run=loom-run/v1:timer:robb-pro/fleet-resync:7f020bca-6920-47f7-a5e4-bbd5c82d9bb8 installs=0.19.1072 29b48db1ead9c4501304e0114a5c33310e1d589f -->
    Loom-Trace-Id: 25c158d7e9591610b251780caaff1c5f
    Loom-Build: unknown b37a005ac1889262fb9e5338f7cff4e9ed4987da clean
    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
2026-10-11 chore: resync installed Loom surfaces
    <!-- loom:provenance v1 build=unknown 81a6b4499cb57b3620785bc1625c300da34f0735 clean prompts=none sweep=none story=none trace=d08bbd290651d7bcbda8b216c0dfbcdf host=robb-studio base=4d9002b8bda374be5bbb564639298f8a5ffbb778 run=loom-run/v1:timer:robb-studio/fleet-resync:71e05e3d-931c-46b4-b6d2-5f3f992c1e19 installs=0.19.1073 abb0872ba7d1d3f6f3a14f71f51a562e89308181 -->
    Loom-Trace-Id: d08bbd290651d7bcbda8b216c0dfbcdf
    Loom-Build: unknown 81a6b4499cb57b3620785bc1625c300da34f0735 clean
    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
2026-10-12 chore: resync installed Loom surfaces
    <!-- loom:provenance v1 build=unknown ddfb67ccf9a5115d62dd86924613a468b9328f44 clean prompts=none sweep=none story=none trace=772605234b9d8cafd6a4049200f7425c host=robb-pro base=7429eb8c9a47da3feffe5277cd5f11a3ed9064dd run=loom-run/v1:timer:robb-pro/fleet-resync:1ef28ffc-0277-424f-9224-7ee6eca46377 installs=0.19.1081 be16cedf6a394661d3b1400531335927f5eb4519 -->
    Loom-Trace-Id: 772605234b9d8cafd6a4049200f7425c
    Loom-Build: unknown ddfb67ccf9a5115d62dd86924613a468b9328f44 clean
    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
2026-10-12 chore: resync installed Loom surfaces
    <!-- loom:provenance v1 build=unknown be358990895362019614bd207bcbe36bc9eeff2c clean prompts=none sweep=none story=none trace=f1dc643b95859c8f26e892ddb5e2c5d7 host=robb-studio base=201a6997b643257843b76e14d3c94cfff0a8da9e run=loom-run/v1:timer:robb-studio/fleet-resync:da486ca2-3e94-4a85-abd3-88707942489a installs=0.19.1086 d8cb20101a985145fb167c1933758075a14ce1ab -->
    Loom-Trace-Id: f1dc643b95859c8f26e892ddb5e2c5d7
    Loom-Build: unknown be358990895362019614bd207bcbe36bc9eeff2c clean
    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
2026-10-12 chore: resync installed Loom surfaces
    <!-- loom:provenance v1 build=unknown a579728c137cc11d08a48b178e0ff9aa21683e72 clean prompts=none sweep=none story=none trace=10832f2750dbcd63f6c6f301a6f4da9b host=loom-worker-2 base=7d6d9e494ed5e378fe7c411933182ac4d3ac3d17 run=loom-run/v1:timer:loom-worker-2/fleet-resync:180f6d5054f0479ab3990b86ab4522a5 installs=0.19.1087 51ac271f990b317a52ebf27cc21f34561e1179fb -->
    Loom-Trace-Id: 10832f2750dbcd63f6c6f301a6f4da9b
    Loom-Build: unknown a579728c137cc11d08a48b178e0ff9aa21683e72 clean
    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
2026-10-12 chore: resync installed Loom surfaces
    <!-- loom:provenance v1 build=unknown 02ecafe7734bf5faa945ce88940589f00eca78e9 clean prompts=none sweep=none story=none trace=5f71c537126994dc4c45179122427514 host=robb-pro base=0dd2ea33dae8fa3612dd79662b73236c84c1fe0a run=loom-run/v1:timer:robb-pro/fleet-resync:6293e6da-8a67-45aa-b277-c9ef85ddb810 installs=0.19.1101 27422582cd2d34d8ed5f60ce987007bc4bd61081 -->
    Loom-Trace-Id: 5f71c537126994dc4c45179122427514
    Loom-Build: unknown 02ecafe7734bf5faa945ce88940589f00eca78e9 clean
    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
2026-10-12 chore: resync installed Loom surfaces
    <!-- loom:provenance v1 build=unknown 5918da96dcd60c9a677a195737c86ea38972d215 clean prompts=none sweep=none story=none trace=49bb7a8942d6a23bf41754ca27ff2368 host=loom-worker-2 base=aafa1bdeb5e0bca725d101f0b8caef2a8f5262e9 run=loom-run/v1:timer:loom-worker-2/fleet-resync:2e973f04abd1447d8ee4b696c2e7d2b4 installs=0.19.1105 e2b4f1275335364979ea8d4f1364e7a9c30cf3f3 -->
    Loom-Trace-Id: 49bb7a8942d6a23bf41754ca27ff2368
    Loom-Build: unknown 5918da96dcd60c9a677a195737c86ea38972d215 clean
    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
2026-10-12 chore: resync installed Loom surfaces
    <!-- loom:provenance v1 build=unknown 9885e6bbba36f53328e04be83140734c6eda9f58 clean prompts=none sweep=none story=none trace=72f34c4066d6ca844a10c33035a775bd host=loom-worker-1 base=5d0281dbc885c578e5ed210d3e028926e329d90c run=loom-run/v1:timer:loom-worker-1/fleet-resync:8f5732bc51fd43379e17e0de51e86bae installs=0.19.1108 72427939d156341080a7006ae6fbb5ec96b2368e -->
    Loom-Trace-Id: 72f34c4066d6ca844a10c33035a775bd
    Loom-Build: unknown 9885e6bbba36f53328e04be83140734c6eda9f58 clean
    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
2026-10-12 chore: resync installed Loom surfaces
    <!-- loom:provenance v1 build=unknown 01467247f32c59822968bf02d3214d9a3d613452 clean prompts=none sweep=none story=none trace=0e97e9733eef09a33959cf96e6271f40 host=robb-studio base=905dc3a9d18f44621f81f005c24a325e04c884a4 run=loom-run/v1:timer:robb-studio/fleet-resync:53a4d390-3842-4216-9018-5dced9d0ea17 installs=0.19.1109 d9498fcd419776b2517e30b99c88e76bbe92d2f4 -->
    Loom-Trace-Id: 0e97e9733eef09a33959cf96e6271f40
    Loom-Build: unknown 01467247f32c59822968bf02d3214d9a3d613452 clean
    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
2026-10-12 chore: resync installed Loom surfaces
    <!-- loom:provenance v1 build=unknown acadc2b4b0e852f2d889ac9dec616e1548705802 clean prompts=none sweep=none story=none trace=a69edb348af7f0e67b3bc77bc33b1bfc host=loom-worker-2 base=8f270d95ed93be33600129e9bead048f83b6f447 run=loom-run/v1:timer:loom-worker-2/fleet-resync:0923627ffda84cf69ec2486475772b10 installs=0.19.1126 7736d1276b6d01778fba3461114c858ef1bf5e2d -->
    Loom-Trace-Id: a69edb348af7f0e67b3bc77bc33b1bfc
    Loom-Build: unknown acadc2b4b0e852f2d889ac9dec616e1548705802 clean
    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
2026-10-12 chore: resync installed Loom surfaces
    <!-- loom:provenance v1 build=unknown 8d832cc8035d4ba07872510416468da0790332cd clean prompts=none sweep=none story=none trace=09a53bf60e96fc30a753caffd1de8c92 host=robb-studio base=bdcb5a707d0426a85e831c6d5ffa9793f4712f2e run=loom-run/v1:timer:robb-studio/fleet-resync:baf4c30c-65d9-4d4e-a740-f6a80cbb975c installs=0.19.1132 8695bdd2b7b963dca9b76f4643a9d7c744294426 -->
    Loom-Trace-Id: 09a53bf60e96fc30a753caffd1de8c92
    Loom-Build: unknown 8d832cc8035d4ba07872510416468da0790332cd clean
    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
2026-10-12 docs: update work plan to current Loom priority labels
2026-10-12 chore: resync installed Loom surfaces
    <!-- loom:provenance v1 build=unknown aa1ed0d7d5499d2705977d971673d919dbbbaf4e clean prompts=none sweep=none story=none trace=2522608826ef5d5e4a88a9667055aeb7 host=loom-worker-2 base=2fb975133682f01e2f19f386719d7afb093e6d02 run=loom-run/v1:timer:loom-worker-2/fleet-resync:8f26b719c712455381744111c50e90b4 installs=0.19.1142 b91ae5d1b5204f499a1abb875a6cf5bffc1d90b1 -->
    Loom-Trace-Id: 2522608826ef5d5e4a88a9667055aeb7
    Loom-Build: unknown aa1ed0d7d5499d2705977d971673d919dbbbaf4e clean
    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
2026-10-12 chore: resync installed Loom surfaces
    <!-- loom:provenance v1 build=unknown 8b64614d017d6ce7491c3a2ac9da51e5e2901c97 clean prompts=none sweep=none story=none trace=66044c049ba635bcd6a4797c3a77e84b host=robb-pro base=a1a87a62fe0ed7c7aa3a497ffc766b757a578724 run=loom-run/v1:timer:robb-pro/fleet-resync:68f56594-05d0-4cc0-9c07-36263359d698 installs=0.19.1144 9e4381cbbd2386393e44c7a979583252948a3998 -->
    Loom-Trace-Id: 66044c049ba635bcd6a4797c3a77e84b
    Loom-Build: unknown 8b64614d017d6ce7491c3a2ac9da51e5e2901c97 clean
    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
2026-10-13 chore: resync installed Loom surfaces
    <!-- loom:provenance v1 build=unknown 98d08ab78cc223361354ee9947d996b1cb914b30 clean prompts=none sweep=none story=none trace=8b73addcdeaa8fbd65998649f42a8c50 host=loom-worker-2 base=d53924415b500bd0d43be191418566fc0b202393 run=loom-run/v1:timer:loom-worker-2/fleet-resync:3bfb13d52fca425f9cfced4541954cb6 installs=0.19.1148 1448fdfa79ac2dcab7fad6b95b72697b450f2a4a -->
    Loom-Trace-Id: 8b73addcdeaa8fbd65998649f42a8c50
    Loom-Build: unknown 98d08ab78cc223361354ee9947d996b1cb914b30 clean
    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
2026-10-13 chore: resync installed Loom surfaces
    <!-- loom:provenance v1 build=unknown d0bfbbc7ac309581d7abe02c4a269c7704010ee0 clean prompts=none sweep=none story=none trace=0ad6d167235000f3b5648cbd63d761ce host=robb-pro base=ebc7662db08a8f775f07d74344c3990a363981ae run=loom-run/v1:timer:robb-pro/fleet-resync:4f7cbe22-40b6-49ff-8811-003ae8577c28 installs=0.19.1151 08ee0f8708464aa8e0768640d56955d7f4fcbc98 -->
    Loom-Trace-Id: 0ad6d167235000f3b5648cbd63d761ce
    Loom-Build: unknown d0bfbbc7ac309581d7abe02c4a269c7704010ee0 clean
    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
2026-10-13 chore: resync installed Loom surfaces
    <!-- loom:provenance v1 build=unknown 7916c4043a1b57e97a53bc5c111e74c5038a1091 clean prompts=none sweep=none story=none trace=20b27ffb08c4130dc9836ee8d9d97b97 host=loom-worker-2 base=4dc12d9169f732608af845a84b1a862acfaf96ff run=loom-run/v1:timer:loom-worker-2/fleet-resync:d34532ec625a4162ae8b58dde1a6738f installs=0.19.1151 f7d1deaab02a9c483fce1ced33fadb1af6d86f59 -->
    Loom-Trace-Id: 20b27ffb08c4130dc9836ee8d9d97b97
    Loom-Build: unknown 7916c4043a1b57e97a53bc5c111e74c5038a1091 clean
    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
2026-10-13 chore: resync installed Loom surfaces
    <!-- loom:provenance v1 build=unknown ac0bbcf6eda99918e88a0b8893d9762b106a2e45 clean prompts=none sweep=none story=none trace=8597ab8a51d68f9f8ee864fa71904bff host=robb-studio base=2aa84c67d0335a05d25a8a9e2588b03fbdc5f31b run=loom-run/v1:timer:robb-studio/fleet-resync:2ea9dd71-a6b2-4d0c-86aa-859a0728c9b3 installs=0.19.1151 f7d1deaab02a9c483fce1ced33fadb1af6d86f59 -->
    Loom-Trace-Id: 8597ab8a51d68f9f8ee864fa71904bff
    Loom-Build: unknown ac0bbcf6eda99918e88a0b8893d9762b106a2e45 clean
    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
2026-10-13 chore: resync installed Loom surfaces
    <!-- loom:provenance v1 build=unknown 7916c4043a1b57e97a53bc5c111e74c5038a1091 clean prompts=none sweep=none story=none trace=a48d70df8e7252b46c71b88e90ebed02 host=loom-worker-3 base=b708e521048a2cf2bece5a6f9b883336294600a5 run=loom-run/v1:timer:loom-worker-3/fleet-resync:08e4e415b6434bf1ba0456ba59477467 installs=0.19.1151 f7d1deaab02a9c483fce1ced33fadb1af6d86f59 -->
    Loom-Trace-Id: a48d70df8e7252b46c71b88e90ebed02
    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
2026-10-13 chore: resync installed Loom surfaces
    <!-- loom:provenance v1 build=unknown 7916c4043a1b57e97a53bc5c111e74c5038a1091 clean prompts=none sweep=none story=none trace=773e9e41a5730d2f79f2381ad2cde068 host=robb-pro base=c5feb082d437517540a495b37547bfd62c9b8317 run=loom-run/v1:timer:robb-pro/fleet-resync:b7ca0d34-434e-4536-85b9-57adfa603a8d installs=0.19.1151 a885af872d054695b81e8458dfc7bd717cbddba8 -->
    Loom-Trace-Id: 773e9e41a5730d2f79f2381ad2cde068
    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
2026-10-13 chore: resync installed Loom surfaces
    <!-- loom:provenance v1 build=unknown f57244868aa20ef22c18aa8025972184aaea43e4 clean prompts=none sweep=none story=none trace=8e03b78fe6cb43a017c4a4823362ffa7 host=loom-worker-2 base=1f36babe70db838f464edc5c3cc4a4ab8d9d7d9d run=loom-run/v1:timer:loom-worker-2/fleet-resync:eb553d2fc2a54589aa37879f12b18ed5 installs=0.19.1151 4b3b3e77e5ef42971b3c0c3e68c000736a0c7c21 -->
    Loom-Trace-Id: 8e03b78fe6cb43a017c4a4823362ffa7
    Loom-Build: unknown f57244868aa20ef22c18aa8025972184aaea43e4 clean
    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
2026-10-13 chore: resync installed Loom surfaces
    <!-- loom:provenance v1 build=unknown 9cd23bf22bf48ed3837f643ea76ec2e5f01ae46a clean prompts=none sweep=none story=none trace=ab3a71ce89f6ba9ad4c2753c3377bcf1 host=loom-worker-1 base=037dd3591c9f573a99b49e1ec3c8a3ef119031be run=loom-run/v1:timer:loom-worker-1/fleet-resync:79a3b089c6f54c91bd32db3274e8133c installs=0.19.1151 a9d9bfc13e966655d6d847cb6876af523bc4a4c4 -->
    Loom-Trace-Id: ab3a71ce89f6ba9ad4c2753c3377bcf1
    Loom-Build: unknown 9cd23bf22bf48ed3837f643ea76ec2e5f01ae46a clean
    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
2026-10-13 chore: resync installed Loom surfaces
    <!-- loom:provenance v1 build=unknown 6fe43c87955e02019c2bc8dfad4fbd160b89170c clean prompts=none sweep=none story=none trace=49a4590bf54e81899c26d965f682504c host=robb-studio base=ee4a3f71a8c3d47a6f55e8093f4ec2d168499c35 run=loom-run/v1:timer:robb-studio/fleet-resync:459197b3-0050-4335-893e-e47b638eb819 installs=0.19.1151 4ec7e046f71ff70b92c88ed647cff72d6a9d1e85 -->
    Loom-Trace-Id: 49a4590bf54e81899c26d965f682504c
    Loom-Build: unknown 6fe43c87955e02019c2bc8dfad4fbd160b89170c clean
    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
2026-10-13 chore: resync installed Loom surfaces
    <!-- loom:provenance v1 build=unknown 5dc3a07d084d0ec4034f0782d572925dcad86af7 clean prompts=none sweep=none story=none trace=cbc11657acadf58858409fe543c342e1 host=robb-pro base=0811b117a183ccc6b185a8cc02e8c37abfcb2a99 run=loom-run/v1:timer:robb-pro/fleet-resync:be586137-d91e-4e2c-82d6-3164d43aa9de installs=0.19.1152 2d5fe17958dca799058f16bdd74a12336990bec0 -->
    Loom-Trace-Id: cbc11657acadf58858409fe543c342e1
    Loom-Build: unknown 5dc3a07d084d0ec4034f0782d572925dcad86af7 clean
    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
2026-10-13 chore: resync installed Loom surfaces
    <!-- loom:provenance v1 build=unknown 27a266d5a27885323290840d2a837d73fcf4bcc6 clean prompts=none sweep=none story=none trace=e77cdd5477ef6bfc65fba6cc233788e0 host=loom-worker-2 base=7087c245241985e624d9e8664f4de2b1f55e727f run=loom-run/v1:timer:loom-worker-2/fleet-resync:7fac7d82f298441a91761382ac989183 installs=0.19.1152 43f03f1fe0988c7870431d6bba187c13018b4420 -->
    Loom-Trace-Id: e77cdd5477ef6bfc65fba6cc233788e0
    Loom-Build: unknown 27a266d5a27885323290840d2a837d73fcf4bcc6 clean
    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
2026-10-13 chore: resync installed Loom surfaces
    <!-- loom:provenance v1 build=unknown f2b62a2cf576d7d37092147b2281da809f8b5cf5 clean prompts=none sweep=none story=none trace=8adfa75521c72dded43e2932febb6329 host=loom-worker-3 base=5c583c9b53ae25428be48bb9772d9ece5d9d61a2 run=loom-run/v1:timer:loom-worker-3/fleet-resync:8a8198f8f80e4703bc7365a5e10595e0 installs=0.19.1152 8d16eec5f10d705602ac4d1ab871c57266f1aa45 -->
    Loom-Trace-Id: 8adfa75521c72dded43e2932febb6329
    Loom-Build: unknown f2b62a2cf576d7d37092147b2281da809f8b5cf5 clean
    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
2026-10-13 chore: resync installed Loom surfaces
    <!-- loom:provenance v1 build=unknown 84d11f248d368cae5e04a2255f6897a406c50089 clean prompts=none sweep=none story=none trace=8e50b4ccc3dc58f709a732f69d58fd44 host=robb-studio base=2a29d8a37f49c344ebcc4046c1e7ce404fd10179 run=loom-run/v1:timer:robb-studio/fleet-resync:05c9f3b1-eee2-412f-8996-5fbf02793d9e installs=0.19.1153 d8429a4fabdc955107af1cbc22c548e23eecf9b1 -->
    Loom-Trace-Id: 8e50b4ccc3dc58f709a732f69d58fd44
    Loom-Build: unknown 84d11f248d368cae5e04a2255f6897a406c50089 clean
    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
2026-10-15 loom: unpin curator.md and guard-loom-workflow.sh (2am#4345 Q7)
    These four pins were added 2026-09-29 for #141 (deny loom:curating on a
    PR number), to be removed "once the change lands upstream". The part
    that fixes the root cause has landed: upstream curator.md runs a PR/issue
    kind probe before every claim and refuses a PR number or a failed read
    (rjwalters/loom#9929). The hook half was closed NOT_PLANNED as
    rjwalters/loom#9609 on 2026-10-14, because the #139 incident was the only
    evidence, and no PR here has carried loom:curating since.
    The pins themselves had become the hazard. guard-loom-workflow.sh was
    frozen 13 upstream commits behind, missing guards such as #11568
    (ask before destruc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
2026-10-15 feat(sim): pin open_pdks f6eeac7 and reject mismatched PDK trees
    Loom-Story: 2AMLogic/gf180-sram#173
    Loom-Trace-Id: 0f0137970035b134ce4d66454fc0a40a
    Loom-Build: 0.19.1166 8a9aad12e32504cea9a7c7d2ed774749c487f875 clean
2026-10-17 chore(signoff): re-grade T1 verdict on klayout-tools 0.7.0
    Move the grader pin 0.6.0 -> 0.7.0 in regenerate.sh, the CI signoff job,
    check_signoff_freshness.py and the freshness-script hint, and regenerate
    signoff-report.json. All 11 T1 rows stay met; README records the grader
    identity and what the record's diff does and does not contain.
    Closes #194
2026-10-18 docs(spec): fix macro interface widths, polarity, WEN semantics, latency, and Liberty corner names
    Records the 256x32 1RW pin widths, active-low CEN/GWEN/WEN, per-bit WEN,
    1-cycle registered read, and the 27 Liberty corner names with the
    logic-library voltage offsets, each compared to gf180mcu_fd_ip_sram.
2026-10-18 docs(spec): add periphery architecture, floorplan, and pin placement decision record
2026-10-18 fix: measure SNM as the inscribed-square side, not the vertical curve gap
    The extractor took the constant-x gap between the butterfly curves as the
    square's side, which over-reads on steep VTCs. Measure the gap along y=x in
    the 45-degree rotated frame and divide by sqrt(2); add analytic tests against
    a brute-force largest-square search and note the earlier over-read in the
    sim README.
    Closes #213
2026-10-18 feat: add periphery schematics, 4:1 array, macro top netlist and write/read smoke sim
    Generator-driven xschem schematics and klt-netlisted SPICE for the row path,
    column decode, precharge, I/O slices (mux, sense amp, write driver, flops) and
    self-timed control, a 64 x 128 array under a new file name (the 256 x 32
    files stay as the committed layout's LVS reference), and a macro top whose
    ports are exactly the #198 pins. Smoke sim at tt_25c_3.30v on a reduced array
    writes then reads back words; records state what that does not show.
2026-10-18 feat: sweep control pulse and macro smoke over all 27 corners on the batch fleet
    Adds klt sim requests and circuit-body testbenches for the control-block
    pulse widths and the macro write/read smoke, two append-only records, and
    a check-klt grader. Min write pulse is 2.50 ns (ff_-40c_3.63v), so
    periphery row 12 closes; the macro smoke passes at all 27 corners.
2026-10-18 feat: add netlist-driven column-path layout (precharge and I/O slices)
    Draws the per-I/O column path from design/netlist/ with one deterministic
    generator: parse + flatten the SPICE, place shared-diffusion chains between
    mirrored supply rails, and route every signal net with a small maze router
    on a 0.65 um grid chosen so different-net shapes on different nodes meet the
    width/space/narrow-line/wide-metal rules by construction.
    - precharge_slice (12 PMOS, 17.84 x 7.50 um) and io_slice (99 devices: 4:1
    mux, sense amp, write driver, three flops; 17.84 x 58.50 um), each exactly
    four bitcell columns wide, plus 32-slice bands in one GDS
    - BL/BLB stubs sit at the array's own bit-line x; --abut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
2026-10-18 refactor: drop local-only macro smoke flavor in favor of klt sim
    Remove run.sh, the two local tb_*.spice testbenches and the gen/check
    subcommands of smoke.py; the .klt.spice bodies and requests/*.json cover
    both testbenches, and a single corner runs with klt sim --backend local
    (verified: tt/3.30V/25C PASS, matching record 072247). Records and
    netlist snapshots are untouched.
2026-10-18 sim: wordline RC gate fails for the left-fed 4:1 row; propose superseding decision
    Extract the 128-cell and 64-cell wordlines (klt extract --distributed-rc) and
    drive them from the pad end with the real rowdrv at ss_125c_2.97v. The left-fed
    128-cell row reaches 1.92 V of 2.97 V at the far end on a 2.0 ns pulse; a centre
    decoder or a 2:1 row passes. Adds the bench, raw reports, an evidence record and
    a proposed decision record that leaves the choice to the operator.
    Part of #204
    Loom-Issue: 2AMLogic/gf180-sram#204
2026-10-20 ci: pin setup-python to 3.12 so klayout installs from wheels
2026-10-21 spec: align the wordline RC record's wording with the operator checklist and cite the PDK's poly R figures
    Independent spec review of #228 against the operator's 2026-10-19
    checklist. Every item was already present; these are consistency and
    primary-source repairs, not changes of claim:
    - Header "Would supersede" now lists the same targets as the "What a
    superseding record would change" section (rows 1 and 4, the Floorplan
    and Consequences-of-4:1 sections, the fallback list). The two lists
    disagreed, and the checklist asks that the superseding record name
    exactly what changes.
    - Driver 50 % delay 0.22 -> 0.21 ns in the left-fed table, matching the
    evidence record (report value 0.2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
2026-10-21 spec: set the validation matrix's pass criterion per the operator's 2026-10-20 ruling
    The operator ruled on #228 in an attended /fleet:decide (2026-10-20):
    ratify, with the matrix's pass criterion set as part of the ratification:
    "The wordline pulse at the far cell must meet the write-margin
    requirement at all 27 corners, evaluated with the PDK's high-end Poly2
    sheet resistance (15 ohm/sq) rather than the 1.5x factor."
    This commit writes that criterion into the record and answers the review's
    open call 1 (the matrix said what to run but not what passes). The
    write-margin requirement is not a new number: spec/sram.md's "Write
    margin" row already ratifies it (write trip voltage that flips the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
2026-10-21 layout: draw the row decoder and wordline-driver strip, DRC clean and LVS-matched
    Adds layout/periphery/row/generate.py, which reuses the column path's
    netlist reader, strip placer and router to draw design/netlist/row_path.spice
    (16 predecoders + 64 rowdrv) as one flat cell, with the committed GDS,
    verify.sh and reports/generate.sh steps, DRC/extract/LVS reports, and README
    text. rowdrv is 13.65 um rail to rail against the 5.40 um row pitch, so the
    drivers are interleaved in three columns. Strip only: no physical-fit or
    wordline-RC claim.
    Closes #204
2026-10-23 ci: pin Node to 22.23.4 (Node 20 is end-of-life)
    Node 20 is past end-of-life and gets no security fixes; the 2026-10-22 security audit flagged the setup-node pin. Pin the exact patched 22.23.4 release rather than a floating major, so the version CI runs is the audited one.
    Closes #258
2026-10-27 chore(pdk): default remaining scripts to ~/.ciel and add dated re-pin entries
    design/regen_periphery.sh defaults PDK_ROOT to ~/.ciel. layout/reports/generate.sh
    searches ~/.ciel first and rejects a gf180mcuD tree whose open_pdks revision is
    not sim/lib/pdk_pin.txt. views/README.md points at ~/.ciel; spec files gain
    dated re-pin addenda with the old c6d73a3 text untouched.
    Part of #173
2026-10-27 chore: bump pinned klayout-tools to 0.8.0 and re-grade signoff
    Pin klayout-tools==0.8.0 in CI (plus a klt --version step), the signoff and
    views scripts, the freshness check and install docs. The committed signoff
    report is regenerated under 0.8.0: 8/11 T1 items met (items 1, 9, 10 now
    unmet/wrong_kind; previously 11/11 under 0.7.0).
2026-10-28 signoff: cite artifact-anchored generic wrappers for T1 items 1, 9, 10
    Under klayout-tools 0.8.0 the native placeholder citations for these items
    grade wrong_kind. Add kind: generic wrappers that declare t1_item and pin
    a named file set via provenance.input.paths, refresh the pins from
    signoff/regenerate.sh, add a spec table and reproduction index to the root
    README so item 10 is backed by what it states, and correct stale verdict
    text in signoff/README.md.
2026-10-28 ci: add drift check regenerating the tracked array schematics
    Keeps design/sram_256x32_array.sch and sram_64x128_array.sch tracked per the
    operator ruling on #274 (option b) and fails CI if either differs from
    generate_array.py output.
    Part of #274
2026-10-29 docs(spec): record area, min clock pulse and power as no-threshold rows
2026-11-01 docs(spec): correct area-source history, macro pin count, per-bit area provenance
2026-11-03 ci: run check_macro_pins.py from the array-schematics drift gate
    The README relies on check_macro_pins.py as the macro pin-list guard, but
    nothing invoked it. Call it from scripts/ci/check-array-schematics.sh and
    note the CI hook in design/README.md.
2026-11-06 signoff: regenerate verdict of record after sim/README.md bench row
    Refreshes the item-9 wrapper pins (sim/README.md hash changed) and the
    committed signoff report via ./signoff/regenerate.sh (klt 0.8.0 wheel).
    T1 stays 11/11 met.
2026-11-08 fix(sim): record report-relative samples path in klt yield reports
    run_klt_yield runs klt yield from the yield-reports directory with
    ../samples/<id>.json so the committed report resolves from any grader
    working directory. Adds .relpath re-renders of the three read-SNM,
    hold-SNM and write-margin reports (same samples bytes) and points T1
    item 6 at the read-SNM one.
2026-11-14 feat(layout): add the sram_256x32 macro GDS, generator and pin check
    Ports the three finished macro files from feature/issue-247 unchanged
    (layout/macro/generate.py, check_pins.py, sram_256x32.gds) and wires the
    DRC-only half of that branch's script hunks onto current main:
    - layout/verify.sh: macro generation + determinism, the step 2 precheck,
    step 5f (pin check) and step 11 (macro DRC). The branch's step 12
    (macro extraction + LVS) and its KLT_MACRO_EXTRACT pin are deliberately
    not taken -- hierarchical macro LVS stays on #247 / klayout-tools#5322.
    - layout/reports/generate.sh: a DRC-only --macro block re-authored onto
    main's current file, so the klt-0.8.0 pin bump and the ~/.cie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
2026-11-14 docs(layout): commit the macro DRC report and record the macro's bbox
    Mints layout/reports/drc-macro.json from the assembled macro with the engine
    pinned on both sides (klayout-tools==0.8.0 + klayout==0.30.12, so
    provenance.klayout_version_mismatch is false, matching the dominant
    convention of the sibling reports): status clean, 0 violations.
    layout/README.md gains a "The macro" section with the bounding box
    re-measured from the committed GDS -- 669.330 x 611.625 um (0.409379 mm^2),
    top cell sram_256x32 -- and states plainly that macro LVS has no verdict in
    either direction, linking #247 and klayout-tools#5322. The stale "no control
    logic or macro assembly" bullet is corrected: sram_ctrl/co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
